sfunderbots/Electrical/BasePlate/README.MD

# Baseplate Board Documentation

This board is a power distribution and CANBUS distribution board, including the breakbeam connection to easily connect all motor drivers while disconnecting the top half and bottom half of the robot with just a few connections. This includes Power, CAN, and breakbeam cables.

## License
This project is licensed under the MIT License - see the [LICENSE](LICENSE) file for details.
