sfunderbots/Electrical/FacePlate/README.md

# Faceplate Board V2 Documentation

## Overview
---

The Faceplate[^1], one of five of our robot's on board custom PCBs (not including the Raspberry Pi), is a connector and peripheral board between the Raspberry Pi and the rest of the robot system. As this documentation pertains to the Robocup Small Size League Autonomous Soccer, this documentation will be very specific in its use case. The new version of the faceplate incorporates connectors for mouse sensors (localization improvement) and an offboard IMU (placed closer to the center of the robot with less vibration). All five boards contained on our robot (six including the Raspberry Pi), for context, are listed as follows:
1. Raspberry Pi 4 - Main Robot Computer and link between the active running computer running our team's software
2. Faceplate[^1] - Connector between Raspberry Pi and Midplate for CANBUS communication, peripherals, and LCD screen eyes
3. Midplate - Battery input and power distribution (doubles as a mechanical chassis)
4. Chicker[^2] - High Voltage Flyback Capacitor Charger and Solenoid Driver
5. Simovr[^3] - A BLDC Motor Driver designed based on the Tinymovr platform in a smaller footprint
6. Baseplate - Power distribution and CANBUS distribution for the Simovr's, and breakbeam circuits to detect the ball

[^1]: Aptly named due to our robot's circular LCD displays
[^2]: Named after a combination of the flexibility of both kicking or chipping circuits
[^3]: Aptly named after its creator, Simon, and its reference design, the Tinymovr

The Faceplate can be seen on the front of our robot, with the eyes visible and the board covered by a 3D printed piece below:
<p align="center">
  
</p>

This guide will serve as a way of a tutorial to design this or a similar board in your own projects, for which we recommend to use JLCPCB as a PCB manufacturer - wew users can register through the link below and receive up to $123 in coupons: [New User](https://jlcpcb.com/?from=Newv).1

## Schematics
---
  
For any of the following schematics, it is useful to group components into a schematic library file inside the EDA tool you are using - in this case, KiCad. Saving custom schematics ensures that when you update a board design you carry over any modifications like manufacturer part numbers, JLC part numbers (LCSC), price, etc. The following serves as an example for what information is useful to keep in the schematic part.

<p align="center">

</p>

> [!TIP]
> If you select "edit symbol library", you will see that it opens up the library tab in KiCad, which has all of our parts listed. The same information for the LDO as above is here as well.
> <p align="center">
> 
> </p>

> [!IMPORTANT]
> You will need to add your library path to the .KICAD_SYM schematic library file, which stores all of your components. While separating the components into groups hasnt been done yet on our end due to time constraints, we recommend grouping these components by type in separate .KICAD_SYM files to increase productivity.
> <p align="center">
> 
> </p>

Additionally, for each symbol in your library, an associated footprint needs to be added to each symbol used in the schematics, which will be covered in the layout section.

### Power
From the midplate, the Faceplate receives a regulated 5V supply for the Raspberry Pi at 3A, including the CANBUS which is wired all throughout our robot for between-board communication. Specifically, this uses a JST XH connector, which is easily sourced among hobbyists. Then, the board also steps this down to 3.3V for the onboard logic circuits needed such as peripherals and LCD screens. Bypass and decoupling capacitors are needed on the Low Voltage Regulator (LDO) to help maintain power stability, and is chosen over a DC/DC converter due to low current requirements.

<div style="display: flex; gap: 10px;">
  5V_CAN
  ldo
</div>

> [!NOTE]
> The part chosen as shown (SOT-223 package) can handle up to 1A of current, which was significantly over specification for our needs.

> [!TIP]
> Always remember to double check the current requirements and heat generation of your system, especially for power conversion!

### Connection to Raspberry Pi
Since the Raspberry Pi 4 has a 40x2 standard dupont style 2.54mm pitch connector, it is easiest to attach a board to board connector of the same type for this PCB. To line it up with the Raspberry Pi, it was easily accomplished by measuring the placement of the 40 pin header in a CAD program (in our case, Onshape) and comparing it to the PCB.

<p align="center">
40pin
</p>

> [!IMPORTANT]
> Special consideration must be taken for ensuring no physical interferences between parts on the bottom layer and the Raspberry Pi, and the top layer to the LCD screens.

### LCD Displays (eyes)
Our LCD displays are a circular GC9A LCD display for which the board is then covered by custom-made 3D printed material for protection surrounding the eyes. Each display (and corresponding breakout board) attaches to a standard 7x1 Dupont style 2.54mm pitch connector, and includes decoupling power capacitors for the 3.3V logic rail to maintain chip operation during normal operating transients. The parts are organized into hierarchical sheets for better organization and viewing of schematics.

<p align="center">


displays
</p>

### CANBUS
In order to communicate on the CANBUS, one needs to convert the standard SPI interface on the Raspberry Pi to a CAN interface, using a CAN controller (MCP2515T), and a CAN transceiver (SN65HVD233). The CAN controller operates on an 8MHz clock and communicates with a CAN transceiver to send and receive commands over the CANBUS interface. As with the displays, the CAN interface is grouped into a hierarchical sheet to simplify organization.

<p align="center">
can-top
  
can
</p>

### Mouse Sensors
Two 8-pin JST GH series connectors link the Raspberry Pi with two identical custom PCBs using a Pixart Imaging PMW3360DM-T2QU navigation sensor, which will be placed at the base of the robot on either side. This will provide significant improvement to our localization and control of the robot, incorporating precice movement of sensors near the surface of the playing field. 
<p align="center">
  
</p>

The board files of the mouse sensor can be found on our github page under [PWM3360_PCB_JST](https://github.com/sfunderbots/Electrical/tree/main/pmw3360-pcb-main/pmw3360_pcb_jst), which was modified from the github user siderakb to add a JST connector.

### IMU
For this revision of the faceplate, we have removed the direct connection of the IMU on the faceplate in place of an external connector to be wired to an IMU, in our case chosen as a breakout board from Adafruit: [4438](https://www.adafruit.com/product/4438). This will provide accurate 6-DoF for the robot to improve robot control speed. This is connected using a 4 pin JST PH connector (Adafruit calls it the STEMMA QT QWIIC) which provides both power and data lines.
<p align="center">
  imu
</p>

## Layout
---

The layout of this board and boards in general can be described by the following seven steps:
1. Footprint Libraries (for schematic)
2. Board Setup (Layers and Shape)
3. Part Placment
4. DRC Rules (including differential pairs)
5. Power routing (including zones / polygons)
6. Signal routing (best practices)
7. Custom Rule Areas (e.g. clearance / keepouts) 

The following image shows the overall layout of the board, where red refers to the top layer, blue refers to the bottom layer, green refers to the inner 1 / power layer, and orange refers to the inner 2 / ground layer. These planes on the board make up the 4 layers for the most common PCB to be fabricated, with power layers included for better power distribution, and signals routed generally on the top and bottom layers, if possible.

<p align="center">

</p>

Below reference most of the important shortcuts on the top bar used in KiCad: On the far left shows the board setup, then on the right past the lock and unlock icons are the footprint library editor, footprint library browser, 3D viewer, import changes from schematic, and DRC rules. 

<p align="center">
  
</p>

### Footprint Libraries
Setting up the footprints for each component can be accomplished manually or by downloading a footprint from an EDA library online. One should always consult the datasheet to confirm the validity of the suggested layout. As an example, the 3.3V LDO mentioned in the symbol library section is shown below. One should always verify the validity of a footprint by downloading the 3D model of the part so that the pins will have sufficient solder area and are easy enough to rework with a soldering iron. 

<p align="center">
  
</p>

> [!NOTE]
> One can access pre-built footprint files for your EDA tool of choice from libraries such as [snapeda.com](https://www.snapeda.com/home/) or [ultralibrarian.com](https://www.ultralibrarian.com/) for example. Many more exist, but these are the most frequently used. Always remember to verify these footprints as they may not match the datasheet.

> [!IMPORTANT]
> It is especially important to pay attention to drill sizes on through hole parts, as even half a millimeter of difference from the part size may be enough to cause interference during fabrication. For this reason we always recommend to check the "confirm production files" and "confirm part placement", so that the JLCPCB engineers can review your board and catch any issues before they are manufactured.

Lastly, with the same process as the symbol libraries, you need to ensure the path to the footprint library exists in the global or project path directories, so that KiCad knows where to look for this board when you place parts.

### Board Setup
Clicking the gear icon in the top left of the screen on the PCB editor in KiCad, you can access the Board Setup menu. In this menu you can select the number of layers on your board you intend to use, using the "Physical Stackup" submenu, and can define the type of layer used to help KiCad understand how you intend to use this board by using the "Board Editor Layers" submenu. 

> [!NOTE]
> This menu can be confusing, but most of this information can be ignored as when you upload your design to JLCPCB the selection menu for PCB type and layer stackup types is all done on their website. Here, the most important thing to remember is simply to select the number of layers used - usually 2, 4 or 6 depending on complexity of the signal routing.
> <p align="center">
> 
></p>

The shape of the PCB can be defined by creating a bounding box (or whatever closed shape you prefer) with the Edge Cuts Layer. First clicking on the edge cuts layer on the side bar shown below you can define a PCB shape using lines or arcs to create the shape of the board. As long as it is a closed shape, this will work and you can check the 3D view to verify it cut properly. The following shows an example when your board shape is malformed versus closed. When the board shape is closed, the shape will be filled in with a subtle grey tone, and the 3D model will be formed.

<div style="display: flex; gap: 10px;">
  
  
</div>

> [!TIP]
> As one can see, it is not always obvious when a board shape is malformed as seen by the above example, where two lines were clearly removed but the overall shape looks the same. As a general rule, the board shape will always fit to the largest area KiCad sees as possible on the Edge Cuts layer, hence how below the shape does not follow any of the drawn lines below.
> 

### Part Placement
When placing parts on the PCB one should think ahead where the power routing will go. In this case, the I would anticipate that the 5V net for the Raspberry Pi would go near the edge of the board and wrap around to the rightmost pins on the 40 pin header, with the 3.3V being the main power plane on the board. Secondly, one should leave enough space around parts to make it easier to solder if rework must be completed, or if you are soldering the boards yourselves. For the faceplate below, you can see that it was ideal to put our power and CAN connector (JST XH 4 pin) on the same side as our power switch and power connector on the midplate. The rest of the components will be arranged in similar fashion leaving enough space for connecting vias for power connection.

<p align="center">

</p>

To help your process in laying out the PCB parts, you can see the "ratnest" of white lines across the board, which show you where the pads will be connected according to the schematic. 

> [!IMPORTANT]
> It is also super important at this time to pay attention to any missing ratnest wires or pads that do not have any connection, which may be a mistake on the schematic. For this reason I always label my net names on the schematic so that when laying out the PCB it will be obvious if something is missing.

> [!TIP]
> It is always useful to include mounting holes on the PCB so that you can attach the board to an enclosure, which may not be necessary for prototyping but it will be necessary in the end - therefore getting it out of the way early will avoid headaches in the future!
>
> Lastly, one should avoid placing components too close to the edge of the board, especially if the board is panelized, as any stresses to the PCB may cause early failure in certain components, such as PCB mount capacitors (not radial caps). A guide about part placement for proper power and signal delivery can be seen on the JLCPCB website here: [JLCPCB design guidelines for placement and routing](https://jlcpcb.com/blog/pcb-design-guidelines-placement-and-routing).

### DRC Rules

On any board project, DRC rules should be set up so that you are generally following manufacturer specifications. You can view the capabilities of JLCPCB on their website [here](https://jlcpcb.com/capabilities/pcb-capabilities), and if I can find it there should be a downloadable file for DRC rules. In the case that this doesn't exist any more, these settings can be set up as follows:

The default constraints should be filled out first, which shows important rules which will dictate how the PCB is fabricated later. Important values to consider here are the minimum widths for trace widths and clearance/spacing (for which I tend to at least double the minimum specified by JLCPCB, as this only specifies an absolute minimum, but not a practical number to avoid noise and EMI), copper to hole, and copper to edge clearances.

<p align="center">
  
</p>

Additionally, you can include DRC rules by setting up Net Classes in the schematic with colors, and in the PCB you can select these net classes to choose specific clearance and widths based on the expected current on those traces. The following shows the example of the "Power" Net Class which I have colored orange for example.

<p align="center">


</p>

For these specific nets, I have selected a slightly larger default via size (0.7/0.35mm) with larger overall trace width minimum. Generally speaking with larger trace widths the larger the clearance should be as well. 

> [!TIP]
> It is advisable to consult a PCB calculator for non-logic level trace and via sizing, such as [Saturn PCB Toolkit](https://saturnpcb.com/saturn-pcb-toolkit/).
>
> Secondly, always check your DRC rules BEFORE you start routing component tracks. This way, you will ensure there are no part placement conflicts or issues with footprints you will have to solve later and re-route components. To ensure components are not conflicting in 3D space, the pink courtyards must not overlap.

> [!WARNING]
> It is important not to look over any DRC warnings and especially errors, I would only recommend setting a DRC rule to "ignore" if it is absolutely necessary (set in "Violation Severity" under board setup design rules), as this can cause issues to be forgotten about especially when a lot of errors that seem meaningless show up can mask a significant board error if those are ignored.
 
### Power Routing

Moving on to power routing, we can set up zones (or polygons depending on what EDA tool you use) of copper that will fill in our board layers and make up our copper planes. For a 4 layer board such as this one, I generally recommend filling in ground on 3 of the four layers and power on one of the two internal power planes. This enables easy routing for power delivery to most components, assuming one (or more depending on current draw) correctly sized vias are used. 

<p align="center">

</p>

On this image above, you can see the zone created, where on the power layer we have a thick trace going from the 5V connector to the Raspberry Pi 40 pin header. 

> [!IMPORTANT]
> It should be noted that at 3A and below the return current here does not matter as much, but on a design that pulls more than 10A I would recommend matching the return ground plane such that the return current goes directly underneath the power trace.

Additionally, each component includes power vias to connect to the 3.3V and GND planes of the board, which are sized slightly bigger for extra margin.

### Signal Routing

With the power traces routed on the board, signals are the next thing I would consider. 

> [!TIP]
> Remember to keep the inner layers as power distribution as much as possible avoiding signals on those layers, as it could increase noise on the signals.

For recommended trace widths, I tend to use anywhere from 8-10mil traces for signals, depending on space. It is advisable to not decrease the size too much, as it may become hard for your PCB manufacturer (such as JLCPCB in our case) to manufacture. On the other end, having a trace width too large may impact impedance of the line, if you are designing a higher speed communication board. 

> [!TIP]
> For most signal traces, the trace width isn't super important at this range, as long as its big enough for the load expected. JLCPCB has a handy guide in determining the trace width of a PCB trace.

With most signal traces, it is recommended to try and maintain a standardized pattern of top and bottom layers for either horizontal or vertical traces, to permit densely populated routing without causing too much hassle. This can be seen with the PCB design in the full layout shown earlier.

### Custom Rule Areas

In some cases, you may have ICs on your board that have very fine pitch (such as the TSSOP-20 Can Controller), and your standard DRC rule clearances may not work here if your overall clearance is larger. In this case, you can temporarily shrink the clearance required around this chip by adding a custom rule area with all the toggles turned off (so that it does not exclude copper, pads, footprints, etc) for which we will add a custom rule later. The fine pitch chip is shown below, with a zone created around it and all options deselected.

<p align="center">

</p>

With this we can now go into the DRC rule editor (much easier than custom rules in the board setup tab in older KiCad versions) and add a custom fine pitch spacing rule. This can be found from Tools -> DRC rule editor.

<p align="center">

</p>

Here, object A refers to the currently-being-routed track, via, or other item, where the new clearance rule now only gets applied inside this area. There are multiple ways to accomplish the same feature with custom rulests, and there are a lot of other use cases that you can explore - this is only an example. 

> [!TIP]
> KiCad has a previous version guide (pre-V10) about custom rules and their use cases, so please feel free to use [this guide](https://forum.kicad.info/t/custom-design-rules-examples/43987/2) to your liking. There are also a lot of github links that people have made including JLCPCB specific rulesets you can use if you search these up.

## Implementation
---

To fabricate the boards, we used JLCPCB, which has been extremely reliable for countless hobby projects over the last five years. Here’s JLC's new user [6-layer PCB coupon](https://jlcpcb.com/6-layer-pcb?from=social) which saves you 30$ on your project so you can start a project with relatively low cost. 

Apart from being a reliable PCB manufacturer, JLCPCB has also been very cost effective - on their part library website, you can find alternate components from their partner LCSC to make board projects feasible at lower cost with similar or the same specifications. 

However, before you fabricate the boards, you need to run a DRC check, under Inspect -> Design Rules Checker. This ensures that any clearance violations (short-circuits), unconnected nets (any traces you forgot to route), or trace widths that are out of the Net Class spec.

> [!IMPORTANT]
> For this very reason, it is highly advisable, while not strictly necessary, to set up different Net Classes and assign them in the schematic by right clicking the wire. With a larger trace width for a high current trace set, this will ensure that when you go to manufacture your boards that trace will not burn up from too little copper area to conduct the required current, with the DRC check ensuring you fix the mistake before this stage.

For this board specifically, Net Class rules didn't need to be set up as it is a relatively simple board and my knowledge is sufficient to accomplish it without any major hiccups, knowing the rough sizing for traces we need. At a very minimum, it is recommended to use the toolkit recommended earlier ([Saturn PCB Toolkit](https://saturnpcb.com/saturn-pcb-toolkit/)) to verify that your trace width will sufficiently carry the current without heating up too much.

Clicking the 3D model view in KiCad (the icon that looks like a capacitor) you can view the 3D model of the board - the Faceplate looks as follows:

<p align="center">
  
  
</p>

And with that, the board is done, and you will need to export your design files to gerbers and drill files for the manufacturer. You can do this manually by using the export options, or, you can use the JLCPCB Fabrication tookit as an installed library in KiCad. With the toolkit, all it requires is a simple click where the files will be saved in a "production" folder in your repository.

<p align="center">
<img width="607" height="493" alt="Screenshot 2026-06-04 081611" src="https://github.com/user-attachments/assets/2535ca5f-1fe5-418a-b123-495e8af0abb8" width: 30%;"/>
</p>

This process is now complete and you should have your board in a couple weeks depending on shipping and manufacturing timelines!

## License
This project is licensed under the open-sourced MIT License - see the [LICENSE](LICENSE) file for details.
