sfunderbots/Electrical/thebots_libraries/README.MD

# KiCad Project Libraries

For most of our boards, a project library is used to store components in symbol and footprint editors. This improves the process at which a board is updated in the future, where all changes are saved on the library rather than locally. 

This repository contains [3D-models](3dmodels) of the components (some use the kicad repository links), [symbol libraries](symlib), and [footprint libraries](bots.pretty)

## License
This project is licensed under the MIT License - see the [LICENSE](LICENSE) file for details.
