sfunderbots/Electrical/Chicker/power board design rules.txt

(version 6.0)
#(rule bat_clearance_width
#	(condition "A.NetClass == 'BAT'")
#	(constraint clearance (min 25mil))
(rule HV_clearance_width
	(condition "A.NetClass == 'HV'")
	(constraint clearance (min 60mil))
	(constraint track_width (min 50mil)))
(rule power_clearance_width
	(condition "A.NetClass == 'Power'")
	(constraint clearance (min 16mil))
	(constraint track_width (min 10mil)))
(rule signal_clearance_width
	(condition "A.NetClass == 'SIGNALS'")
	(constraint track_width (min 6mil))
	(constraint clearance (min 9mil)))
(rule HV_CONN
	(condition "A.enclosedByArea('HV_CONN') && A.NetClass == 'HV'")
	(constraint clearance (min 50mil)))
(rule HV_RQ2D
	(condition "A.enclosedByArea('HV_RQ2D')")
	(constraint clearance (min 20mil)))
(rule HV_SNUB1
	(condition "A.enclosedByArea('HV_SNUB1')")
	(constraint clearance (min 31mil))
	(constraint track_width (min 20mil)))
(rule HV_SNUB2
	(condition "A.enclosedByArea('HV_SNUB2')")
	(constraint clearance (min 31mil))
	(constraint track_width (min 20mil)))
(rule SPI0_clearance_width
	(condition "A.enclosedByArea('SPI')")
	(constraint clearance (min "9.7mil"))
	(constraint track_width (min "6mil")))
(rule RPI2040_clearance_width
	(condition "A.enclosedByArea('RPI')")
	(constraint clearance (min 8mil))
	(constraint track_width (min 6mil)))
(rule HV_PMS
	(condition "A.enclosedByArea('HV_PMS')")
	(constraint clearance (min 7.8mil)))
(rule LT3750_clearance_width
	(condition "A.enclosedByArea('LT3750') && A.Type != 'Via'")
	(constraint clearance (min 7.7mil))
	(constraint track_width (min 7mil)))
(rule LM2598_clearance_width
	(condition "A.enclosedByArea('LM2598')")
	(constraint clearance (min 16mil))
	(constraint track_width (min 6mil)))
#(rule samenet
#	(condition "A.Type == 'Zone' && A.NetName == B.NetName && B.Type != 'Via'")
#	(constraint physical_clearance (min 10mil)))
(rule HV_res
	(condition "A.enclosedByArea('HV_RES')")
	(constraint clearance (min 6mil))
	(constraint track_width (min 6mil)))
(rule HV_res_AD
	(condition "A.enclosedByArea('HV_AD')")
	(constraint clearance (min 30mil))
	(constraint track_width (min 10mil)))
# Specify an optimal gap for a particular diff-pair
(rule "dp gap"
    (condition "A.NetClass == 'DIFF_USB'")
	(constraint diff_pair_uncoupled (max 360mil))
	(constraint diff_pair_gap (max 200mil) (opt 8mil) (min 7mil)))
(rule USB_clearance_width
	(condition "A.enclosedByArea('USB')")
	(constraint clearance (min "7.6mil"))
	(constraint track_width (min "6mil")))
(rule board_edge_clearance
    (constraint edge_clearance (min 30mil)))
(rule board_edge_clearance_caps_HV
    (constraint edge_clearance (min 0.2mm))
	(condition "A.Type == 'Zone' && A.Name =='CAPS_HV'"))
(rule board_edge_clearance_caps_GND
    (constraint edge_clearance (min 0.2mm))
	(condition "A.Type == 'Zone' && A.Name =='CAPS_GND'"))
(rule board_edge_clearance_GND
    (constraint edge_clearance (min 14mil))
	(condition "A.intersectsArea('GND_POUR')"))
(rule vcc_clearance_3750
	(constraint clearance (min 7.6mil))
	(condition "A.Type == 'Zone' && A.Name =='LT375012V_POUR'"))
(rule dp_gap_CAN
    (condition "A.NetClass == 'CAN_DIFF'")
	(constraint diff_pair_uncoupled (max 810mil))
	(constraint diff_pair_gap (max 800mil) (opt 11mil) (min 10mil))
	(constraint track_width (min 7mil) (opt 7mil)))
#make sure of NPTH clearance, all layers
(rule NPTH_Clearance
(constraint hole_clearance (min 0.3mm))
(condition "A.Pad_Type=='NPTH, mechanical'"))
