sfunderbots/Electrical/Chicker/firmware/docs/MODE-STATE-MACHINE-REVIEW.md

# Mode control state machine review: Henry's chart, element by element

Source chart: `flowcharts/chicker-mode-control-state-machine.drawio`. Same rules as the charge review: column 1 is
the chart as drawn, the change (if any) goes in "Agreed behaviour", and anything not on the chart needs Henry's OK.
Henry is updating his local copy of the chart as the review goes; the code is checked against both before it is written.
The chart sometimes writes a value as shorthand (e.g. "500ms" for `KICK_MIN_INTERVAL_MS`); the review and the code
always use the config constant names.
Signals shared with the charge machine: see `COUPLED-STATE-MACHINE-REVIEW.md`.

## Mode control state machine

| # | Chart element | Agreed behaviour | Notes |
|---|---|---|---|
| 1 | ANY STATE — `chg_ok == 0` → Wait for Bat | **As drawn.** Applies from every state except its own (Wait for Bat) and Locked (end state). Whatever is in progress is aborted immediately, **including a kick or damp pulse**; `chg_stop_mode_ctrl = 1`. | Aborting may not be possible: without the battery the board may already be unpowered. Then the RP2040 pins fall to their pull-downs, which is already the safe state (CHARGE off, `~DISCHARGE` low = dump, KICK low). No extra dump request from Wait for Bat: with no battery nothing can charge anyway (question withdrawn). |
| 2 | Wait for Bat — `chg_ok == 1` → Start BKBM interrupt | **As drawn.** The break-beam interrupt is attached the first time and left attached (not detached when going back to Wait for Bat). | Without a battery the break-beam is unpowered and won't trip. Even if its pin floats (e.g. USB-only on the bench), the interrupt only fires a kick when one is **armed**, and Wait for Bat has aborted everything. |
| 3 | Start BKBM interrupt — `heartbeat == OK` → Set Idle Mode (chg inhibited, discharging) | **As drawn.** Waits in Start BKBM interrupt until the heartbeat is OK, then Set Idle Mode. While waiting: `chg_stop_mode_ctrl = 1`. **`heartbeat == OK`** = a valid frame from the Pi within the last **5 s** (`HEARTBEAT_TIMEOUT_MS = 5000`, config, can change later). At startup, the first valid heartbeat frame is enough. Any valid frame from the Pi (heartbeat, MODE, KICK, DAMP) refreshes it. | Needs robot-side heartbeat (R-1). Details: note HB-1. |
| 4 | ANY STATE — `heartbeat == stops` → Disable Charging → Start BKBM interrupt | **Changed: heartbeat loss also de-arms the kick and stops the PWM** (the chart's "de-arm kick / stop PWM" block; on the chart only an incoming message did this). Otherwise as drawn. Applies from every state except Locked, Wait for Bat, and its own targets. The battery rule (element 1) has priority. Disable Charging sets `chg_stop_mode_ctrl = 1` (Inhibited: stop charging and dump). | **Battery priority:** with no battery and no heartbeat the board stays in Wait for Bat (charging is already off there) instead of bouncing between Wait for Bat and Start BKBM interrupt. See note HB-2. |
| 5 | ANY STATE — `chg_disable_chip_level == 1` → Locked. Message pi4 to substitute | **As drawn.** Applies from every state except Locked; Locked is the end state (left only by reboot) and wins over the battery and heartbeat rules. **Locked tells the Pi and stops everything on the kicker side**: one FAULT event with the reason (UVLO / thermal shutdown, Too slow to charge, Overvoltage), plus the fault flag in every STATUS frame; kick de-armed, any pulse or damping PWM stopped at once (Henry, after the state × event matrix found a damp still running in Locked). It sets no charge flags (no `chg_stop_mode_ctrl`). | Purely reactive: `chg_disable_chip_level` is the charge machine's output (authorship), and the charge machine has already stopped charging and dumped the caps in Disabled. |
| 6 | Set Idle Mode (chg inhibited, discharging) — `chg_disable_chip_level == 1` → Locked / `chg_disable_chip_level == 0` → Wait for Message | **Changed: the `chg_disable_chip_level == 1` → Locked arrow is removed** (redundant: the ANY STATE rule, element 5, already covers it). The `== 0` check on the Wait for Message arrow goes with it (always true once element 5 has priority). **Set Idle Mode = idle mode: set `chg_stop_mode_ctrl = 1` and stop the PWM**, then straight to Wait for Message. (Stop PWM added: the "incoming message" box no longer stops it, note DMP-3.) | `chg_stop_mode_ctrl = 1` sends the charge machine to Inhibited (stop charging and dump), which is the "chg inhibited, discharging". It stays 1 in Wait for Message until a command reaches an Enable Charging step. Reached from Start BKBM interrupt (heartbeat OK) and from Command Received `mode == MODE_IDLE`. |
| 7 | Wait for Message — incoming message → Parse Message; Parse Message — unknown message → Unknown command → Wait for Message / good message → Command Received; ANY STATE — incoming message → de-arm kick / stop PWM → Parse Message | **Changed** (diagram below the table): <br>• Parse Message + Unknown command: a side box for every CAN frame, not states <br>• Heartbeat frame: refresh timer + STATUS reply only <br>• Other boards' frames: ignored <br>• Bad command → Unknown command: count / log, **stay in the current state** <br>• Good command = known ID, right length, values in range <br>• ANY STATE (not Wait for Bat, Start BKBM, Locked) — good command → Command Received → de-arm kick, **except the two renews**: DAMP while the PWM runs (element 17) and AUTOKICK while a kick is armed (element 23) <br>• No stop PWM here: Set Idle Mode, MODE_CHG and the damp's own exits stop it <br>• Good commands: all processed, in order <br>• A repeat is a new command, except the two renews; kicks can be spammed <br>• Armed kick with no ball expires after 2 s (element 21; not during a damp) <br>• Kick pulses ≥ `KICK_MIN_INTERVAL_MS` apart; arming waits for the spacing <br>• Kick during a damp → armed inside the damp loop; PWM keeps going until the break-beam trips (elements 18–20; caution, note DMP-5) <br>• DAMP during a damp = renew (element 17) <br>• Pulse already firing: not cut | • Heartbeats at 5 Hz would otherwise de-arm every 200 ms. <br>• Spacing: two pulses close together combine into one excessively large kick. `KICK_MIN_INTERVAL_MS = 500` is a starting guess (likely larger), tuned on the field. Too short only makes the ball too fast (foul), not board damage. <br>• Kick during a damp is the expected use (hold the ball, then kick before the timeout). The PWM is stopped **at the break-beam trip**, not when the kick is requested. Key change from the chart. <br>• Good = known command CAN ID, correct data length, known mode, kick PW 100–5000 µs, damp parameters within limits. <br>• A new kick stops the armed kick (de-arm) and tries again: Henry's original "de-arm kick" step. <br>• DAMP renew: timeout restarts from the latest DAMP, no new initial kick, parameters kept; capped by `DAMP_MAX_TOTAL_MS` (6 s backstop). AUTOKICK renew: the 2 s arm timer restarts, newest PW, nothing de-armed. Neither renew touches charging. IDLE and CHG stop the damp (element 6, 8); DAMP renews; a kick keeps it (MSG-3). <br>• A kick pulse is ≤ 5 ms on the PIO. <br>• Locked still answers heartbeats with STATUS (fault flag). <br>• As drawn, Unknown command → Wait for Message would pull the board out of wait for kick or the damp loop on a corrupt frame; now it stays put. <br>Details: MSG-1, MSG-2. Team: T-1 to T-3. |
| 8 | Command Received — `mode == MODE_IDLE` → Set Idle Mode; `mode == MODE_CHG` → de-arm kick / stop PWM → Enable Charging → Wait for Message | **As drawn.** Command Received stores the commanded mode in `mode` (read by the break-beam interrupt), then branches. MODE_IDLE → Set Idle Mode (element 6). MODE_CHG → de-arm kick / stop PWM → Enable Charging (`chg_stop_mode_ctrl = 0`) → Wait for Message: the charge machine charges and tops off; nothing is armed. | The de-arm part overlaps with element 7 (every good message de-arms). The stop PWM part is **not** redundant: element 7 no longer stops the PWM on every message, so this is where CHG stops a running damp. AUTOKICK and DAMP are their own elements. |
| 9 | Command Received — `mode == MODE_AUTOKICK` → Enable Charging → Arm Kick | **Changed: the arrow Enable Charging → Arm Kick gets `time since last kick >= KICK_MIN_INTERVAL_MS`** (moved here from the kick GUARD, note KCK-2). Enable Charging sets `chg_stop_mode_ctrl = 0` and `chg_hold_mode_ctrl = 0` (every Enable Charging box clears both). | From Idle: the dump stops and the charge machine starts a cycle (New Charge holds CHARGE low 50 ms first, so the dump is off before CHARGE rises). Already charging / full: no change. |
| 10 | Arm Kick — `HV >= 180V && kick assigned` → Disable Charging | **Changed: `HV >= 100V && kick assigned`** (`KICK_MIN_HV = 100`, config). Arm Kick sets `armed = 1` and stores the kick PW; `kick assigned` comes from the break-beam mini machine. | See note KCK-1. |
| 11 | Disable Charging — `done == 0` → Kick with PW Assigned | **Changed name only: "Disable Charging" → "Hold Charge"** (`chg_hold_mode_ctrl = 1`: stop charging, keep the caps charged). The kick is **queued until `done == 0`** (the LT3750 has stopped), as drawn. No timeout on the wait. | A 20 ms cap on the wait was suggested and not adopted (Henry: DONE will go low once CHARGE is low). A DONE line stuck high would already have tripped "Too slow to charge" at the 4500 ms check during the charge cycle before the kick (→ Disabled → Locked, Pi told). |
| 12 | Kick with PW Assigned → GUARD (PW >= 100 us, PW <= 5000 us) → de-arm kick / stop PWM → Enable Charging → Wait for Message | **Changed (Henry's updated chart): the GUARD moves before the kick.** Hold Charge → GUARD → Kick with PW Assigned. GUARD rows: `done == 0`, PW >= 100 us, PW <= 5000 us. The board waits in Hold Charge until all pass. The kick spacing is **not** in this GUARD (the kick must fire while the ball is in the beam): see note KCK-2. After the kick, as drawn: de-arm kick / stop PWM → Enable Charging (clears both flags, recharges) → Wait for Message. | Before, the PW was checked after the kick had fired. "Last kick" includes the damp's Initial Kick. The PW rows repeat element 7's range check as a last check before the PIO fires. **One kick per AUTOKICK command** (Henry): after the kick the board leaves the mode and waits for the next command; it does not stay armed. |
| 13 | Breakbeam Mini State Machine: Interrupt Received — `Breakbeam == 1` → LED on — `armed == 1 && mode == MODE_AUTOKICK` → Assign Kick → Interrupt Idle; LED on — `armed == 0` → LED on; Interrupt Received — `Breakbeam == 0` → LED off | **As drawn, with:** <br>• Written as `Breakbeam == ON` (ball present) / `OFF` in the chart and code; the pin level for ON is a config constant, confirmed on the bench <br>• Beam must be steady for `BEAM_DEBOUNCE_MS` (5 ms, tune on the bench) before it counts <br>• LED on is a real state the main loop keeps checking (the `armed == 0` loop): a ball already in the beam when the kick is armed still gets kicked <br>• Condition widened for a kick during a damp: `armed == 1 && (mode == MODE_AUTOKICK \|\| mode == MODE_DAMP)` (element 18). The `MODE_DAMP` row is needed: a renew sets `mode` back to `MODE_DAMP` with the kick still armed | • Polarity: a break-beam receiver often reads **low** when blocked, so ON ≠ 1 necessarily. Bench check. <br>• Implementation (Henry: probably OK): the interrupt fires on both edges and only records the level and time; the main loop does the state changes (MicroPython interrupt handlers must stay tiny). debounce against flicker (`BEAM_DEBOUNCE_MS`, 5 ms). Break-beam level reported in STATUS. <br>• Ball leaving before the kick fires: note KCK-2. |
| 14 | Command Received — `mode == MODE_DAMP` → Enable Charging — `HV >= 180` → Disable Charging | **Changed:** <br>• "Disable Charging" → **"Hold Charge"** (`chg_hold_mode_ctrl = 1`) <br>• Arrow gets `time since last kick >= KICK_MIN_INTERVAL_MS` next to `HV >= 180` (`DAMP_START_V = 180`, kept) | • The Initial Kick is a kick: without the spacing, a damp right after a kick would combine the two pulses. Same fix as AUTOKICK (gate the start, not the fire, KCK-2). Easy to remove later. <br>• Stuck-low HV → never damps: accepted risk, stuck-readings open topic (charge review). |
| 15 | Disable Charging — `done == 0` → Initial Kick — wait for (y) time → Start Damping PWM | **As drawn** ("Disable Charging" is now "Hold Charge", element 14). Initial Kick waits for `done == 0` like element 11. **(y) = 4 ms** (Henry's updated chart; `DAMP_SETTLE_US = 4000`). Initial Kick PW = 800 µs (`DAMP_INITIAL_KICK_US`). Both are the RoboCup 2026 values. | • Values and their history: note DMP-2. Tuned by hand; no physical model yet. <br>• Initial Kick counts as the last kick for `KICK_MIN_INTERVAL_MS`. <br>• Initial Kick → PWM switch runs on the same PIO, the pin never changes function (the old PWM ↔ PIO glitch). |
| 16 | Start Damping PWM → Wait — time since last HV adjustment >= (x) → HV Adjustment → Set Duty → Wait; Wait — time since pwm start >= timeout → de-arm kick / stop PWM → Enable Charging → Wait for Message | **Changed:** <br>• Exit: `time since last DAMP >= timeout \|\| time since Initial Kick >= DAMP_MAX_TOTAL_MS` (renew + max hold) <br>• (x) = 25 ms (`DAMP_ADJUST_PERIOD_MS`) <br>• No HV floor exit <br>• Hold stays on through the loop <br>**Added:** elements 17, 18, 19, 20 | • HV Adjustment = RoboCup formula, rounding kept; validate on the bench (DMP-3). <br>• Details for 16–20: DMP-4. |
| 17 | **Added (Henry's updated chart):** Command Received — `mode == MODE_DAMP && PWM running` → Renew Damp start variable → Wait; `mode == MODE_DAMP && PWM not running` → Enable Charging (element 14) | **Agreed.** Renew: restart the timeout, no new Initial Kick, parameters kept, `mode = MODE_DAMP`. A queued kick stays armed (the one exception to "a good command de-arms", element 7). | New behaviour, not just a label. "PWM running" is a flag (on at Start Damping PWM, off at every Stop PWM). DMP-4. |
| 18 | **Added:** Command Received — `mode == MODE_AUTOKICK && PWM running` → Arm Kick → set mode back to MODE_DAMP → Wait; `mode == MODE_AUTOKICK && PWM not running` → Enable Charging (element 9) | **Agreed.** Kick during a damp: `armed = 1`, no Enable Charging, hold stays on, back to the damp loop. The kick waits for the break-beam (but see note DMP-5). | Same pattern as renew, no new state. Break-beam fires on `mode == MODE_DAMP` too (element 13). DMP-4, MSG-3. |
| 19 | **Added:** Wait — `HV >= 100V && kick assigned` → GUARD → Kick with PW Assigned → de-arm kick / stop PWM → Enable Charging | **Agreed.** The PWM stops in the same PIO step as the pulse, so it holds until the kick. | Ball already in the beam → kicked as soon as armed. No settle delay: the ball pushes the plunger back (Henry). DMP-4. |
| 20 | **Added:** Wait — `HV < 100V && kick assigned` → Stop PWM → wait 50ms → Enable Charging → `HV >= 100V && kick assigned` → Charge Hold → `done == 0` → GUARD → Kick | **Agreed.** Bank too low to kick: the damp ends, the bank recharges, then the kick fires. | PWM off before charging: no charging while damping, nothing left running. 50 ms lets the solenoid current die down. `kick assigned` stays latched (KCK-2). DMP-4. |
| 21 | **Added (not yet on the chart):** Arm Kick — `time since AUTOKICK >= 2s && no ball` → de-arm kick → Wait for Message | **Agreed (Henry): "definitely include the 2s timeout, it's dangerous otherwise."** An armed kick that sees no ball within `KICK_ARM_TIMEOUT_MS` (2 s) of its AUTOKICK command is de-armed; the Pi gets an ARM_EXPIRED event; charging stays on (mode CHG). Once the ball has been seen the kick goes ahead (no expiry while waiting for a recharge). A new AUTOKICK restarts the 2 s. | Same as RoboCup 2026 (`AUTOKICK_EXPIRE_THRESH_MS = 2000`). Without it, a kick the AI no longer wants would still fire on a ball arriving much later. The KICK frame's `arm_ms` field stays ignored (fixed 2 s). |
| 22 | ~~Arm timeout during a damp~~ | **Rejected (Henry):** no 2 s timeout for a kick armed during a damp. The kick is expected there, the damp only lasts its timeout (3 s, or longer if renewed), and the kick is de-armed when the damp exits. | |
| 23 | **Added (Henry's updated chart):** Command Received — `mode == MODE_AUTOKICK && PWM not running && kick armed` → (Renew kick timer + new PW) → wait for kick; `... && kick not armed` → Enable Charging → ... (the full path) | **Agreed.** An AUTOKICK while a kick is already armed on the AUTOKICK path (wait for kick, or Charge Hold) renews it: the 2 s arm timeout restarts and the newest PW is used. No de-arm, no Enable Charging, charging untouched. | A Pi that repeats AUTOKICK keeps the kick armed as long as it keeps asking (T-5). "kick armed" excludes the low-bank recharge of a damp (Stop PWM), which still has to re-enable charging. Chart: the renew arrow needs a "Renew kick timer (+ new PW)" box; the 2 s timeout arrow should leave "wait for kick", not Arm Kick. Code state renamed `ArmKick` → `WaitForKick`. |

## Message handling (element 7): full description, for the chart later

Henry's chart has one box for this, "message handling according to #7". This section is what that box means,
written so it can be drawn later. The behaviour is agreed (element 7, MSG-1, MSG-2, elements 17, 18, 21, 23).

### Where it applies

Every CAN frame goes through the message handler, **whatever state the mode machine is in**. What the handler
may do depends on the state:

* **Wait for Bat, Start BKBM interrupt, Locked:** heartbeat frames are handled (timer refreshed, STATUS sent).
  Commands are **not acted on** and not saved for later (Locked: STATUS carries the fault flag).
* **Every other state** (Wait for Message, wait for kick, Charge Hold, the damp loop, ...): commands are acted on, as
  below. A good command interrupts whatever the machine was doing, except the two renews (lines 12 and 14).

### Step by step (each line is one box or arrow to draw)

```
 1. CAN frame received
 2. ├─ heartbeat frame      → refresh the heartbeat timer, send STATUS → back to the current state
 3. ├─ not for the chicker  → ignore → back to the current state
 4. ├─ bad command          → Unknown command (count it, log it; reject message if the team wants, T-2)
 5. │                         → back to the current state (nothing changes, nothing de-armed)
 6. └─ good command         → (Wait for Bat / Start BKBM / Locked: ignore → back to the current state)
 7.                         → Command Received (checked top to bottom, first match wins)
 8.  Command Received
 9.  ├─ MODE_IDLE                                 → de-arm kick / stop PWM → Set Idle Mode (chg_stop = 1) → Wait for Message
10.  ├─ MODE_CHG                                  → de-arm kick / stop PWM → Enable Charging → Wait for Message
11.  ├─ MODE_AUTOKICK && PWM running              → Arm Kick (new PW) → set mode back to MODE_DAMP → damp loop Wait   (el. 18)
12.  ├─ MODE_AUTOKICK && PWM not running && armed → RENEW: restart the 2 s arm timer, new PW → wait for kick          (el. 23)
13.  ├─ MODE_AUTOKICK && PWM not running && not armed
     │                                            → de-arm kick → Enable Charging → [last kick >= KICK_MIN_INTERVAL_MS]
     │                                              → Arm Kick (2 s arm timer starts) → wait for kick → ...              (el. 9-12, 21)
14.  ├─ MODE_DAMP && PWM running                  → RENEW: restart the damp timeout (kick stays armed) → damp loop Wait (el. 17)
15.  └─ MODE_DAMP && PWM not running              → de-arm kick → Enable Charging → [last kick >= KICK_MIN_INTERVAL_MS
                                                    && HV >= 180] → Charge Hold → ...                                (el. 14-16)
```

The de-arm is part of each branch, not done before Command Received, so the two RENEW branches (12, 14) can skip it.

### Definitions used above

| Term | Meaning |
|---|---|
| Heartbeat frame | The Pi's 5 Hz heartbeat. Never de-arms, never goes to Command Received. Any valid frame from the Pi refreshes the heartbeat timer. |
| Good command | Known command CAN ID, correct data length, every value in range (known mode, kick PW 100–5000 µs, damp parameters within limits). |
| Bad command | Anything for the chicker that isn't a good command. |
| PWM running | Flag: on at Start Damping PWM, off at every Stop PWM. Not the same as `mode == MODE_DAMP`. |
| armed (line 12) | A kick armed on the AUTOKICK path: in wait for kick, or in Charge Hold about to fire. Not the low-bank recharge of a damp (Stop PWM), which still has to re-enable charging, so an AUTOKICK there takes line 13. |
| 2 s arm timer | `KICK_ARM_TIMEOUT_MS`: no ball within 2 s of the last AUTOKICK → de-arm kick → Wait for Message (element 21). Not during a damp. |
| Order | Good commands are handled one at a time, in the order they arrived; none are dropped. |

### Who stops the PWM

Every way out of a damp stops the PWM: the damp loop's own exits (timeout / max hold, elements 16, 19, 20),
MODE_IDLE, MODE_CHG, heartbeat loss, battery loss and Locked. MODE_DAMP renews, MODE_AUTOKICK keeps it running until
the kick. Below the state machine, the kicker driver never runs the PWM longer than `DAMP_MAX_TOTAL_MS` (backstop for
code bugs, not a state).

## Notes

| # | Note |
|---|---|
| HB-1 | **Heartbeat details.** The Pi sends at 5 Hz, so the 5 s timeout means ~25 frames in a row must be missed before communication counts as lost. Dropped packets never trip it; only a real outage does. Loss detection is a single timestamp ("last valid frame from the Pi"), not a miss counter. **Early warning (diagnostics only, behaviour unchanged):** after ~1 s without a frame, set a "heartbeat late" flag in STATUS and the board log. **Sequence counter:** the board logs gaps and duplicates to measure packet loss but never acts on them. **During the 5 s before loss is declared** the board carries on as normal: an armed kick expires after 2 s without a ball (element 21) and a damp ends at its timeout. **After loss** (element 4) the board goes back through Start BKBM interrupt, which waits for a fresh heartbeat before Idle. |
| HB-2 | **Heartbeat loss (element 4).** *Dump:* dumping on heartbeat loss is the intended behaviour (Henry). *Armed kick:* de-armed (`armed = 0`), so the break-beam interrupt (still attached) can't fire a kick. The bank is dumping anyway (a full dump takes ~7 s, Henry's measurement), so a kick after loss would get weaker quickly. *Damp:* the PWM is stopped on loss, so it can't be left running after the board leaves the damp loop (where its timeout is checked). *Recovery:* Start BKBM interrupt waits for a heartbeat, then Set Idle Mode. |
| MSG-1 | **Message handling (element 7): what counts and why.** <br>• *Heartbeats don't count:* at 5 Hz they would de-arm the kick every 200 ms, so AUTOKICK could never stay armed. <br>• *De-arm on a good message:* Henry added it so an armed kick or a running PWM can't stay active while the board does something else, and so a spammed kick stops the active kick and tries again. Heartbeat loss (element 4) and battery loss (element 1) also de-arm. A corrupt frame just can't cancel an armed kick any more. <br>• *No software checksum:* the CAN hardware already checks a CRC on every frame. <br>• **Team check:** the chicker's CAN IDs (commands, heartbeat, STATUS) must not conflict with other boards (T-1). <br>• **Team decision:** reject messages with a reason code on the bus, or only a reject counter in STATUS / the log (T-2). |
| MSG-2 | **Message handling (element 7): order, repeats, damp, spam.** <br>• *In order, nothing dropped:* the AI isn't expected to send two commands at once, so processing every good command in arrival order is simplest and can't lose a different command. The MCP2515 holds 2 received frames; an overflow is counted in STATUS. <br>• *Repeats are not ignored* (Henry: damping reuses the same commands; ignoring repeats is only worth it if controlled, e.g. with a timer). <br>• *Spammed kicks:* kick commands are allowed as fast as the Pi asks, even on a barely recharged bank (after a miss the robot must kick again quickly). No message rate limit. **But kick pulses must be ≥ `KICK_MIN_INTERVAL_MS` apart** (Henry): two pulses close together, even well over 5 ms apart, combine into one excessively large kick. 500 ms is a starting guess and is probably larger in practice; tune it on the field. Getting it wrong only sends the ball too fast (a foul), it doesn't damage the board. A kick asked for too soon is not dropped: **arming** waits until the interval has passed, then a ball in the beam is kicked straight away (KCK-2). <br>• *Kick during a damp:* see MSG-3. <br>• *A command during a damp:* IDLE / CHG stop the PWM and act on the new command; DAMP renews; AUTOKICK arms inside the damp loop (element 18). <br>• *Why renew:* a robot holding the ball (e.g. lining up a pass) keeps the damp going with no new initial kick and no extra charge → dump cycle. <br>• *Why restart, not add:* like the heartbeat, the hold lasts only while the Pi keeps asking and ends at most one timeout after the last request. Adding time would let spammed commands stack up. <br>• *Why a hard maximum:* whatever the AI does, the PWM can't stay on the solenoid longer than `DAMP_MAX_TOTAL_MS` (from the initial kick, never extended). Not a heating limit (Henry: the hold draws little current; it drains the caps and stops), so 6 s is fine as a backstop. After the damp ends (timeout or maximum), the next DAMP starts a fresh damp. There is no HV floor exit (element 16). <br>• *Pulse in flight:* "stop the active kick" means de-arm the **armed** kick. A pulse already firing (≤ 5 ms) is never cut: cutting it would give a weak partial kick, and the retry has to wait 500 ms anyway. <br>• *Before Idle:* the board runs from the battery, so with no battery it is off unless USB is connected; commands in Wait for Bat realistically only happen on the bench. A command in Start BKBM interrupt still counts for the heartbeat (element 3), but isn't acted on. "Not ready" / "locked" rejects only if the team wants rejects (T-2). <br>• *Spam and the dump resistors:* no longer a risk. Kicks and damps use the hold (no dump), so a spammed AUTOKICK never dumps; only Idle / heartbeat loss dump (coupled C-1). |
| MSG-3 | **Caution, note DMP-5:** the held-out plunger may block the break-beam during a damp. **Kick requested during a damp (element 7). Key change from the chart (Henry).** Example: a damp starts, 1 s passes, a kick is requested. <br>• *The kick request does **not** stop the PWM.* Stopping it then would leave a gap before the ball reaches the break-beam where nothing holds it, and the damp wouldn't work. The kick is queued (armed). <br>• *Case 1, break-beam not tripped yet:* PWM keeps going. When the break-beam trips: **stop the PWM at that moment**, kick, leave the damp. <br>• *Case 1, break-beam never trips:* the damp timeout / `DAMP_MAX_TOTAL_MS` ends the damp; the kick is de-armed with it (Henry). <br>• *Case 2, break-beam already tripped when the kick is requested:* kicked as soon as it is armed. <br>• *Spacing:* `KICK_MIN_INTERVAL_MS` counts from the damp's initial kick, so it is normally already met by the time the ball arrives. <br>• *Plunger position (Henry):* no settle delay needed. The ball pushes the plunger back, so the kick has its stroke when it fires. <br>• *Renew after the kick request (Henry):* keeps the kick armed (element 17), so a kick sent too early still fires. <br>• *How (agreed):* like renew, the AUTOKICK command just sets `armed = 1` and returns to the damp loop's Wait; Wait gets a `kick assigned` exit into the existing GUARD → Kick (elements 18, 19). No new state, and the kick doesn't go through the AUTOKICK states. Going through AUTOKICK would leave the machine in Arm Kick while the PWM runs in the background, with no HV adjustment or timeout: the state wouldn't match the hardware. Break-beam condition widened to include `MODE_DAMP` (element 13). |
| KCK-1 | **Kick HV threshold (element 10).** <br>• *Why the check exists:* Henry added it for the damp → kick case, so a kick isn't fired with no charge. <br>• *Why 100 V, not 180 V:* 180 V blocked a quick re-kick after a miss (the bank is below 180 V) and made HV the main gate on every kick. At 100 V: damp → kick → miss means recharging first (logical); a kick without a miss can still fire straight away. <br>• *Risk accepted:* HV stuck low (≈ 0 V) means the board never kicks. See the charge review open topic (stuck readings). Idea not adopted (Henry: leave as is, change it if it causes problems; the circuit isn't expected to fail): on the normal AUTOKICK path arm on `HV >= 100V \|\| chg_cycle_done`, a new charge-machine flag set on entering Assuming Charged and cleared at New Charge. Plain `done == 0` doesn't work: it is also 0 during a damp, after a dump and after a fault. <br>• *Kick during a damp:* first planned through these AUTOKICK states; settled as arming inside the damp loop (element 18, MSG-3), because the AUTOKICK path would leave the PWM running outside the damp loop. |
| KCK-2 | **Kick spacing vs. ball in the beam: a dilemma (elements 12, 13).** <br>• *Problem:* two kicks closer than `KICK_MIN_INTERVAL_MS` combine into one oversized kick (foul). But if the spacing gates the **fire** step, a ball that is assigned during the interval waits, and may roll away before the kick fires (kick at nothing). Henry removed the spacing row from the kick GUARD; neither behaviour is wanted. <br>• *Fix (agreed):* gate the **arm**, not the fire. Put `time since last kick >= KICK_MIN_INTERVAL_MS` on the arrow Enable Charging → Arm Kick. Until then `armed == 0`, so the break-beam can't assign. Once armed, a ball already in the beam is assigned straight away (element 13's loop) and the kick fires within ms (only `done == 0` left to wait for). `kick assigned` stays latched once set, as drawn, even if the beam goes OFF before the kick fires (Henry: the ball may have just passed the beam and still be kickable). Clearing it on beam OFF was suggested and not adopted. Possible later refinement: clear it only if the beam has been OFF longer than a short window (e.g. 100–200 ms, tune on the field). <br>• *Other idea (not adopted):* throttle the kick strength (shorter PW) for a kick inside the interval instead of waiting. Not when a break-beam kick is expected. |
| DMP-2 | **Initial Kick PW and (y): history (element 15).** All tuned by hand. <br>• *Jul 2025* (`2b5ffe2`): initial pulse 500 µs; PWM starts after 15 × PW = 7.5 ms. <br>• *Mar 2026* (`ad96e1b`, `be2dc6e`): 500 µs, wait 15 × PW ("wait for plunger to physically extend"); briefly 500 ms for visualising. <br>• *Jul 2–3 2026* (`c533eb6`–`8837846`): 500 µs, 15 × PW. <br>• *Jul 4 2026, RoboCup* (`844995d`, current): **800 µs, wait 5 × PW = 4 ms**. <br>**Pattern:** (y) has always been written as a multiple of the initial PW (15×, then 5×), and the total kick + wait went from 8 ms to 4.8 ms. That's a tuning convention, not physics: (y) is really "time for the plunger to reach its extended position", which depends on the kick energy (PW **and** HV), not on PW alone. <br>**Later (bench):** measure the plunger's extend time directly (reed switch from `to-test/`, or high-speed video) at a few HV / PW points, and set (y) from that. Until then: `DAMP_INITIAL_KICK_US = 800`, (y) = 4 ms (the RoboCup 2026 values, now on Henry's chart). <br>**Related, for the damp loop:** the Jul 2025 frequency sweep (`6f827e0`) found the hold needs an on-time of roughly **26–35 µs per PWM pulse** at any frequency from 1 to 30 kHz (duty × period ≈ constant); 1–10 kHz was noted as ideal, ~37 kHz the practical maximum. |
| DMP-3 | **Damp loop (element 16).** <br>• *Leaving the loop on a new command (Henry's concern):* the timeout is checked **in** the loop, and the ANY STATE "incoming message" box no longer stops the PWM. So a command that leaves the loop without stopping the PWM leaves nothing to end it. Per command: CHG stops it (its de-arm / stop PWM block); DAMP renews and stays in the loop; IDLE: Set Idle Mode stops it (agreed, element 6); AUTOKICK: arms and stays in the damp loop (element 18), and Kick with PW Assigned stops it. Heartbeat and battery loss stop it. Locked stops it too (changed after the state × event matrix test found a damp still running in Locked). <br>• *Fix (agreed):* every way out of the damp states stops the PWM explicitly (list above). An ANY STATE "PWM deadline → stop PWM" rule was agreed, then dropped (Henry): it would switch the PWM off without changing state, so the chart could say "damping" while the PWM is off. <br>• *Backstop (agreed, not on the chart):* the kicker driver never runs the PWM longer than `DAMP_MAX_TOTAL_MS`, like the X-5 power-stage interlock: below the state machine, only there for a code bug. <br>• *HV adjustment rounding (decided: keep as RoboCup, Henry):* RoboCup rounds the duty down to a whole percent (`int(...)`). With a 12 % base the ^0.1 factor only lifts it to 13 % below ~94 V, so above that the adjustment does nothing. **To validate later (bench):** measure the actual duty and hold power the adjustment produces across HV, and decide then whether the rounding or the formula should change. |
| DMP-4 | **Damp part of the chart (elements 16–20), in full.** <br>• *Renew is new behaviour, not just a label:* a DAMP while the PWM is running stays in the loop (no new Initial Kick, parameters kept) and restarts the timeout; the exit counts from the last DAMP. <br>• *PWM running:* a flag that is 1 only while the damp PWM is on (set at Start Damping PWM, cleared at every Stop PWM). Not `mode == MODE_DAMP`: after a timeout or the low-HV Stop PWM, `mode` can still be `MODE_DAMP` with no PWM, and a DAMP must then start a fresh damp. Henry's chart says "PWM running" / "PWM not running". <br>• *Kick during a damp (same pattern as renew, no new state):* AUTOKICK while the PWM is running → Arm Kick (`armed = 1`, no Enable Charging, hold stays on) → set `mode` back to `MODE_DAMP` → Wait. The break-beam fires on `mode == MODE_DAMP` too (element 13). <br>• *Renew keeps a queued kick armed* (Henry): if the kick command came too early, the AI can keep renewing and the kick still fires when the ball trips the beam. The only exception to "a good command de-arms" (element 7). <br>• *Kick exits from Wait:* `HV >= 100V && kick assigned` → GUARD → Kick with PW Assigned; the PWM stops in the same PIO step as the pulse, so it holds until the moment of the kick. A ball already in the beam is kicked as soon as it is armed. No settle delay: the ball pushes the plunger back (Henry). <br>• *Low bank:* `HV < 100V && kick assigned` → Stop PWM (the damp ends) → wait 50 ms (solenoid current dies down) → Enable Charging → `HV >= 100V && kick assigned` → Charge Hold → `done == 0` → GUARD → Kick. The PWM is off before charging, so no charging while damping and nothing left running. `kick assigned` stays latched (KCK-2). <br>• *End of the damp:* `time since last DAMP >= timeout` or `time since Initial Kick >= DAMP_MAX_TOTAL_MS` → de-arm, stop PWM → Enable Charging → Wait for Message. An unused kick ends with the damp. <br>• *Values:* (x) = 25 ms (`DAMP_ADJUST_PERIOD_MS`); frequency, duty, timeout from the DAMP command (RoboCup defaults 30 kHz, 12 %, 3000 ms). HV Adjustment = `duty = base × (210 / max(HV, 60))^0.1`, clamped base…95 %, rounding kept (DMP-3). <br>• *No HV floor* (Henry): at low HV the PWM just doesn't hold; harmless, the timeout ends it. RoboCup had none (60 V is only the formula's clamp). <br>• *Charging:* `chg_hold_mode_ctrl` stays 1 from Charge Hold through the whole loop. |
| DMP-5 | **The break-beam during a damp: probably unreliable. NOTE, logic unchanged (Henry).** <br>• *Problem:* while the plunger is held out it blocks the break-beam, so during a damp the beam may read "ball present" all the time and can't tell whether a ball has arrived. The state machine still works as drawn (kick during a damp waits for the beam, elements 18-20); this is how Henry wants it to work, but it may not work on the board. Be careful, test it. <br>• *Why it should still work (Henry):* the AI sends the kick only after the robot has caught the ball, and the break-beam is only listened to once the kick is armed (`armed == 1`), i.e. after that command. Before it, the beam is ignored. After it, the plunger blocking the beam and the ball in the beam both read "ball present", so the kick fires either way. <br>• *Flicker:* once armed, the first "ball present" latches the kick, so the beam must be steady before it counts: `BEAM_DEBOUNCE_MS` raised from 1 to 5 ms, to tune on the bench. <br>• *Faster, later (DMP-6):* kicking the moment the ball hits the plunger, with no AI command, would need the robot already aimed before the ball arrives; keep the AI-triggered kick for now. <br>• *Idea to test (Henry):* the AI sending a kick during a damp means "the ball just hit the plunger". Stop the PWM at that point; with the plunger released, the beam can **probably** be read again. Risk: if the ball is bouncing, the beam reading may still be wrong. Test on the bench. <br>• *Other ways to see the ball during a damp:* an extra sensor; the reed switch (plunger position, `to-test/reed-switch`); the HV / current signature when the ball slams the plunger back (`to-test/hv-current-sensing`, theory in note DMP-6). <br>• *Also check:* right after a damp ends the plunger is still retracting and may block the beam for a moment, so an AUTOKICK sent just after a damp could see a "ball" that isn't there. If so, ignore the beam for a short time after the PWM stops. |
| DMP-6 | **Theory: spotting a ball hitting the held plunger from the HV reading (to test once a board works).** <br>• *What happens:* during a hold the charger is off and the dump is off, so the bank only feeds the solenoid (plus the ~1 MΩ divider). Bank current = −C·dV/dt (C = 2 mF): reading HV fast enough gives the solenoid's current for free. When the ball hits, it pushes the plunger back against the magnetic pull: the air gap and the coil's inductance L(x) change quickly, which induces a voltage in the coil (motional EMF ≈ i·dL/dt). For a few ms the coil draws a different current from the bank than in the steady hold, then settles at the new position. The ball's energy goes into the coil circuit: that is the damping. <br>• *Size of the signal (rough):* a 46 g ball at 2 m/s carries ~0.09 J. Absorbed over ~2-5 ms that is ~20-45 W, i.e. a change of ~0.15-0.3 A at 150 V, or a change in dV/dt of ~0.1 V/ms. One ADC count is ~62 mV of bank voltage, so a single 1 kHz reading per loop is not enough; the ADC has to run fast (up to 500 k samples/s, e.g. on the second core or by DMA) and average. Averaging ~100 samples per 0.2 ms brings the noise to a few mV, enough in principle. The exact shape (dip or bump, how long) has to be measured: it depends on the coil, the plunger and the driver. <br>• *Detector:* a running estimate of the bank current (slope of HV over a short window), a slow baseline of that current during the hold, and a trigger when the difference stays beyond a threshold for a few samples. Feeds the mode machine as "ball hit" (in place of the break-beam during a damp: a chart change, to agree later). <br>• *Things that look like a ball and must be told apart:* the duty update every 25 ms (a known current step at a known time: blank the detector around it or subtract it); the Initial Kick and the PWM start; ADC noise; a bouncing ball (several hits). <br>• *Test plan:* (1) log HV at a high rate during holds with no ball: noise and the 25 ms steps; (2) roll / drop the ball at a few known speeds; (3) bouncing balls; (4) compare signal to noise, then pick the threshold and window; (5) check false triggers on long holds with no ball. Needs the RC filter on the HV sense to be fast enough (the simulator assumes 128 µs; check the real value on the schematic). <br>• *If HV is not enough:* a current-sense resistor on the coil sees the inductance directly: in each PWM on-time the current rises at V / L(x), so the plunger position can be read every period (30 kHz); or the reed switch for a simple "plunger pushed back" signal. <br>• *Research and test code:* `to-test/hv-current-sensing/README.md` (sense chain from the schematic, why to look for a voltage step rather than a current spike, a detector checked on synthetic data, a DMA capture + bench script, analysis on the PC, bench test plan). |
| DMP-1 | **Charging while damping (Henry's note, experiment idea).** As drawn, a kick command during a damp goes through MODE_AUTOKICK → Enable Charging, so the bank would charge while the solenoid PWM drains it. The PWM drains slower than the ~7 s autodischarge, so it may behave, and topping the caps up during a damp could be useful. Possible nasty effects to check first: <br>• *Charge machine faults:* a load on the bank can keep DONE high past the 4500 ms check → "Too slow to charge" → Disabled, one-way (charge element 10). A working board would lock itself out. <br>• *HV-based duty:* the HV adjustment loop reads HV while the flyback is switching, so readings may be noisy or rising, and the duty would chase them. <br>• *Dump:* `chg_stop_mode_ctrl = 1` dumps (Inhibited), so switching charging off and on during a damp also switches the dump (coupled C-1). <br>If tried: behind a config flag (off by default, like `SAFE_CHARGE`), bench only, with HV / DONE / solenoid current logged. |

## Changes needed outside the board

| # | Change | Why |
|---|---|---|
| R-1 | **Robot side (Pi): send heartbeat frames** to the chicker at **5 Hz** (every 200 ms), with a rolling sequence counter. | Mode element 3: the board waits for `heartbeat == OK` before going to Idle, so it won't take commands without it. |
| T-1 | **Team check:** the chicker's CAN IDs (commands, heartbeat, STATUS) don't conflict with any other board on the bus. | Mode element 7 / MSG-1. |
| T-2 | **Team decision:** reject messages with a reason code on the bus (unknown ID / bad length / out of range, "not ready" before Idle, "locked" in Locked), or only a reject counter in STATUS / the log. | Mode element 7 / MSG-1, MSG-2. |
| T-4 | **Tell the team (Pi side), from the code rebuild:** the KICK frame is AUTOKICK only, as at RoboCup (kick when the ball breaks the beam; trigger byte must be 0: an immediate-kick option from an early protocol draft, before the chart review, is not supported); an armed kick with no ball expires after a fixed 2 s, as at RoboCup (ARM_EXPIRED event), and the KICK `arm_ms` field is ignored; commands sent before the board is ready (no battery / no heartbeat yet) and in Locked are rejected, not queued; the board needs a heartbeat (any valid frame) before it acts on any command, and treats 5 s of silence as lost comms; every good command de-arms except the two renews (DAMP while damping, AUTOKICK while armed: repeating AUTOKICK keeps a kick armed); one kick per AUTOKICK command. | Mode elements 3, 4, 7, 12, 17. |
| T-5 | **Ask the team (AI side): does the 2 s arm timeout fit how the AI kicks?** The timeout counts from the **last** AUTOKICK frame, so an AI that resends AUTOKICK while it still wants to kick (e.g. every 200 ms) keeps the kick armed for as long as it keeps asking, and it expires ~2 s after the AI stops. An AI that sends AUTOKICK **once** and then waits more than 2 s for the ball would miss kicks. How did the RoboCup AI send it? Options if 2 s is too short: the AI resends (preferred: the kick dies if the AI crashes or changes its mind), a longer `KICK_ARM_TIMEOUT_MS`, or let the AI choose per command through the KICK frame's `arm_ms` field. | Mode element 21. |
| T-3 | **Team decision:** every command frame carries a sequence number; STATUS echoes the last good command's number so the Pi knows it landed, and the Pi resends if it doesn't. | Mode element 7. Needs Pi-side changes (add to R-1 if agreed). |

## Not on the chart (needs Henry's OK)

| Item | Status |
|---|---|
| DAMP renew (restart the timeout) + hard maximum hold `DAMP_MAX_TOTAL_MS` | **Agreed** (element 7, MSG-2). 6 s backstop; heating is not a concern (Henry). |
| New flag `chg_hold_mode_ctrl`: stop charging, keep the caps charged (charge state Not Charging) | **Agreed** (charge element 5a, coupled review). Mode boxes: the "Disable Charging" before the AUTOKICK kick and before the damp's Initial Kick become **"Hold Charge"** (`chg_hold_mode_ctrl = 1`); every Enable Charging clears both flags; Idle / heartbeat loss / Start BKBM keep `chg_stop_mode_ctrl = 1` (dump). |
| Kicker driver PWM limit `DAMP_MAX_TOTAL_MS` (backstop, below the state machine) | **Agreed** (DMP-3). Replaces the dropped ANY STATE "PWM deadline" rule. |
| Kick during a damp: arm inside the damp loop, `kick assigned` exit from Wait | **Agreed** (elements 18–20, MSG-3). |
| 2 s arm timeout in Arm Kick (element 21; not during a damp, element 22) | **Agreed** (Henry). To add to the chart. Whether 2 s is right for the AI: team item T-5. |
| Message rate limit | **Rejected**: kick commands may be spammed (MSG-2). |
| Kick pulse spacing `KICK_MIN_INTERVAL_MS` (start 500 ms, tune on the field); gates the arm, not the fire (KCK-2) | **Agreed** (Henry): pulses closer together combine into an excessively large kick (MSG-2). |
| Ignore an identical repeated command | **Rejected** (element 7, MSG-2). Could come back later only if controlled (e.g. with a timer). |
| Command acknowledgement (sequence number echoed in STATUS) | Henry OK, **pending team** (T-3). |
| Reject messages on the bus | Henry OK for "not ready" / "locked", **pending team** (T-2). |
