sfunderbots/Electrical/Chicker/firmware/flowcharts/chicker-charge-state-machine-v2.png

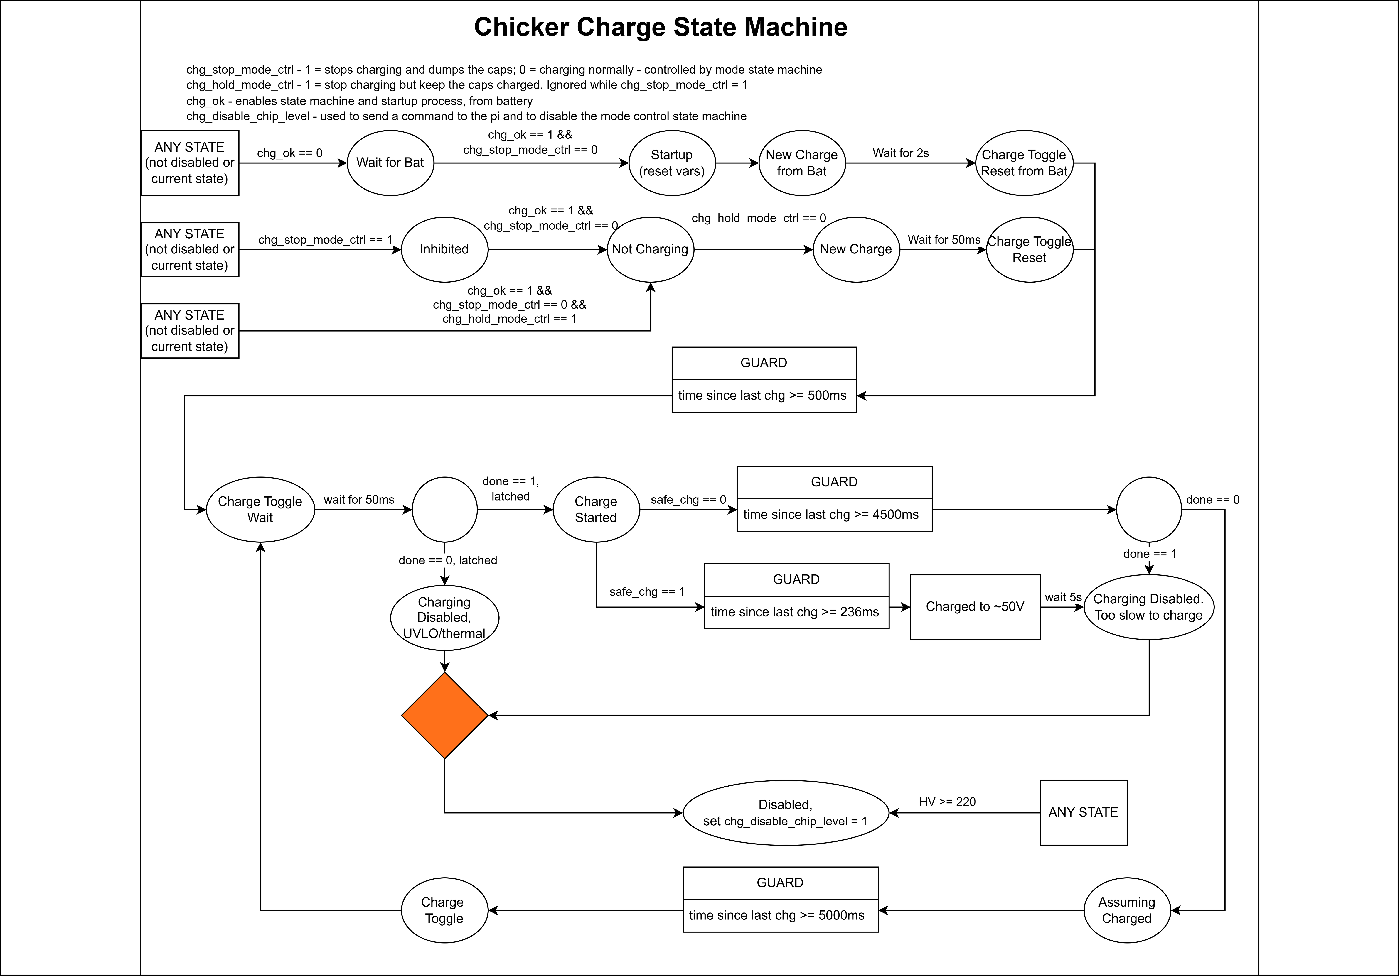
Chicker/firmware/flowcharts/chicker-charge-state-machine-v2.png
