sfunderbots/Electrical/Chicker/firmware/flowcharts/chicker-mode-control-state-machine-v2.png

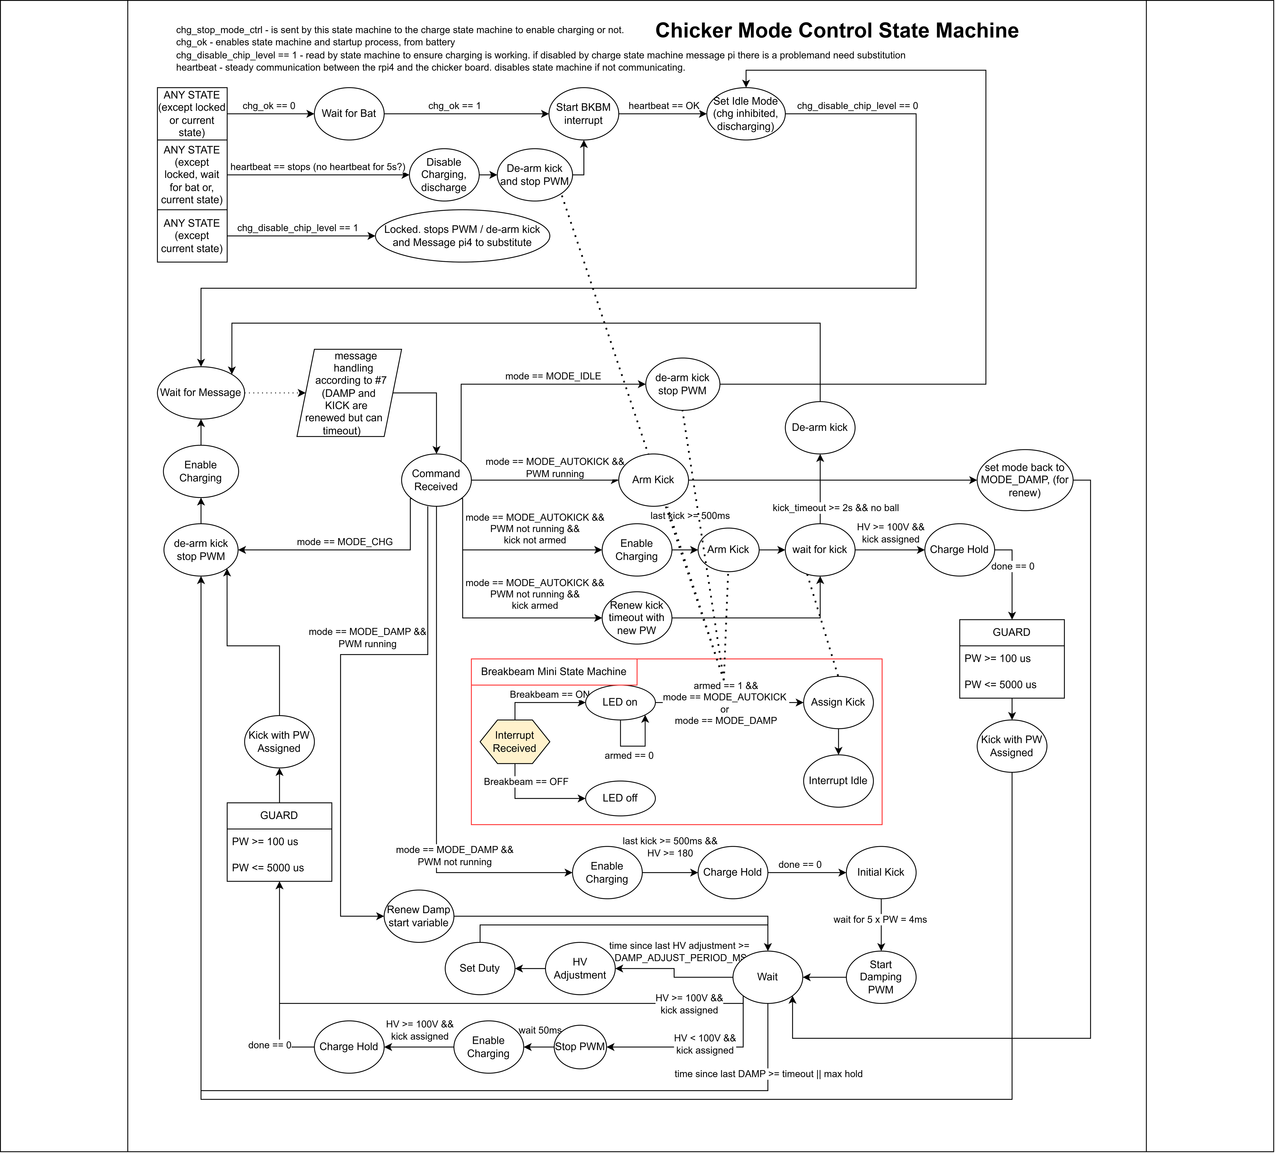
Chicker/firmware/flowcharts/chicker-mode-control-state-machine-v2.png
