sfunderbots/Electrical/Chicker/Images/POWER_BOARD_bot.png

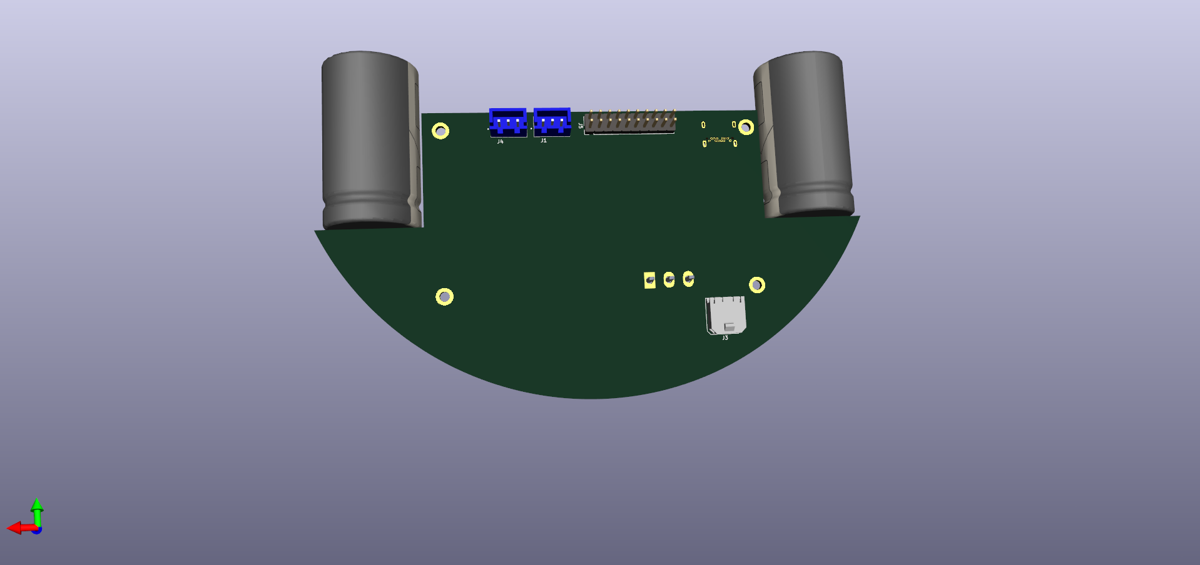
Chicker/Images/POWER_BOARD_bot.png
