sfunderbots/Electrical/Chicker/Images/POWER_BOARD_top.png

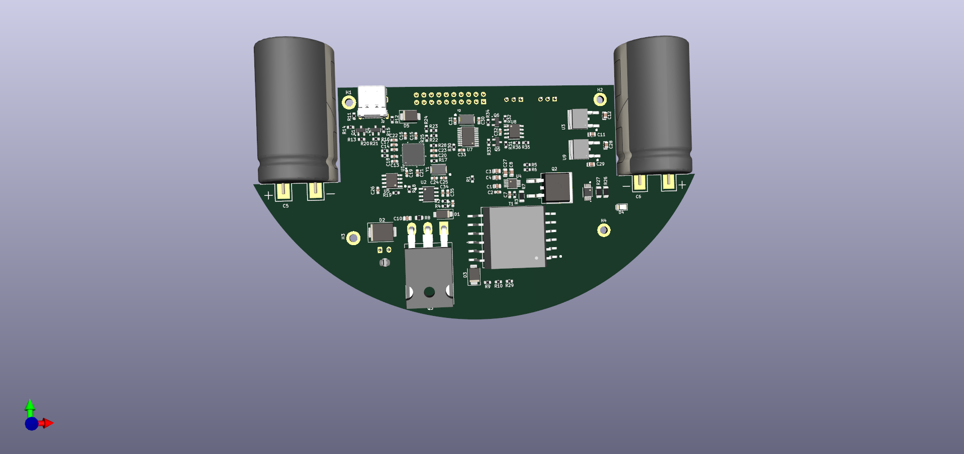
Chicker/Images/POWER_BOARD_top.png
