sfunderbots/Electrical/FacePlate/production/FacePlate_bot.png

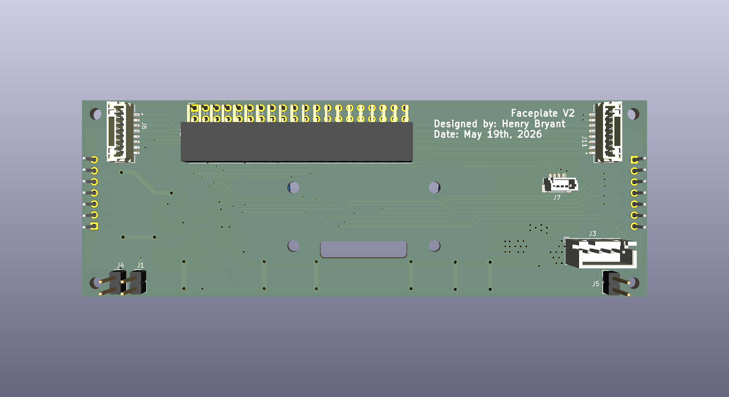
FacePlate/production/FacePlate_bot.png
