sfunderbots/Electrical/FacePlate/production/FacePlate_top.png

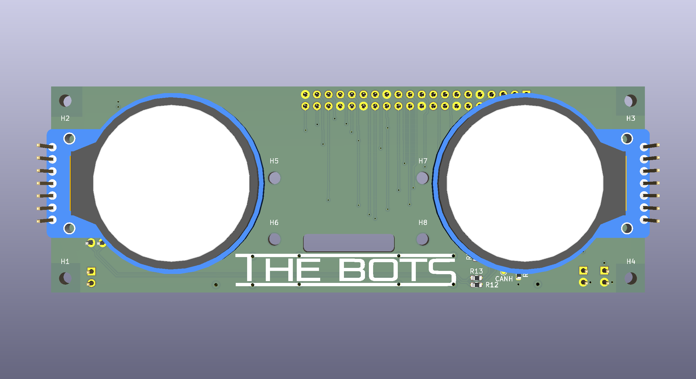
FacePlate/production/FacePlate_top.png
