sfunderbots/Electrical/MidPlate/Midplate BOM Jan 15.xlsx

Ref | Val | Package | JLC Part #$ | Digikey Cost | JLC Cost | JLC extended? | QTY per board | DNP QTY | QTY after DNP | QTY have | QTY *10 + spare | Digikey Cost (total) | JLC Cost with Extended part fee (total) | override | Lowest Cost (Digikey vs JLC)
C1 | C_0.1u | C_0603_1608Metric | C14663 | 0.074 | 0.0028 | no | 1 |  | 1 |  | 10 | 0.74 | 0.028 |  | 0.028 | JLC
C2 | 25SVPF100M | CAP_25SVPF100M | C136279 | 1.471 | 1.06305 | yes | 1 |  | 1 |  | 10 | 14.71 | 14.6705 | DIGIKEY | 14.71 | DIGIKEY |  |  |  |  |  | no components compare
C3 | 10u | C_0805_2012Metric | C440198 | 0.317 | 0.0908 | no | 1 |  | 1 |  | 10 | 3.17 | 0.908 |  | 0.908 | JLC |  | PCB | $33.59 |  |  | $33.59
C4 | C_30p | C_0603_1608Metric | C1658 | 0.050 | 0.00364 | no | 1 |  | 1 |  | 10 | 0.5 | 0.0364 |  | 0.0364 | JLC |  | setup | $10.78 |  |  | -
C5 | 2.2u | C_0603_1608Metric | C23630 | 0.085 | 0.00728 | no | 1 |  | 1 |  | 10 | 0.85 | 0.0728 |  | 0.0728 | JLC |  | stencil | $2.02 |  |  | -
C6 | 16SVPF180M | CAP_16SVPF180M | C136277 | 1.266 | 0.90539 | yes | 1 |  | 1 |  | 10 | 12.66 | 13.0939 |  | 12.66 | DIGIKEY |  | components | $62.46 | 93.41 | weird? | -
D1 | SMAZ12-13F | D_SMA | C110523 | 0.476 | 0.10024 | yes | 1 |  | 1 |  | 12 | 5.712 | 5.24288 |  | 5.24288 | JLC |  | extended fee | $30.95 |  |  | -
F1 | 3568 | Fuseholder_Blade_Mini_Keystone_3568 |  | 1.68 |  |  | 1 |  | 1 |  | 8 | 13.44 | EMPTY |  | 13.44 | DIGIKEY |  | smt | $1.85 |  |  | -
H1, H2, H3, H4, H5, H6, H7, H8, H9, H10, H11 | SMTSO2515CTJ | SMTSO2515CTJ | C2915629 | 0.4952 | 0.0675 | yes | 12 |  | 12 |  | 122 | 60.4144 | 12.275 |  | 12.275 | JLC |  | confirm | $0.58 |  |  | -
J9 | JST_BM04B-GHS-TBT | JST_BM04B-GHS-TBT | C161692 | 0.606 | 0.24966 | yes | 2 | 2 | 0 |  | 22 | 13.332 | 9.53252 |  | 9.53252 | JLC
J12 | JST_B4B-XH-A | JST_B4B-XH-A | C144395 | 0.269 | 0.0395 | yes | 1 |  | 1 |  | 8 | 2.152 | 4.356 |  | 2.152 | DIGIKEY |  | shipping | $74.34 |  |  | $45.00
JP1 | Jumper_2_Bridged | PinHeader_1x02_P2.54mm_Vertical | C2905434 | 0.042 | 0.0165 | yes | 1 |  | 1 |  | 8 | 0.336 | 4.172 |  | 0.336 | DIGIKEY |  | Total | $216.57 |  |  | $78.59
L1 | CDRH127/LDNP-220MC | IND_CDRH127_LDNP-470MC_SUM | C879420 | 1.757 | 0.63256 | yes | 1 |  | 1 |  | 10 | 17.57 | 10.3656 |  | 10.3656 | JLC |  | import tax | $25.99 |  |  | $13.36
Q1, Q2 | MCU60P04-TP | DPAK-3_ONS | C130101 | 1.0969 | 0.5578 | yes | 2 |  | 2 |  | 20 | 21.938 | 15.196 |  | 15.196 | JLC |  | flat fee | $17.50
R1, R2 | R_100k | R_0603_1608Metric | C25803 | 0.023 | 0.001215 | no | 2 |  | 2 |  | 20 | 0.46 | 0.0243 |  | 0.0243 | JLC |  | TOTAL | $260.06 |  |  | $91.95
R6 | 88.7k | R_0603_1608Metric | C5151619 | 0.023 | 0.0015 | yes | 1 |  | 1 |  | 10 | 0.23 | 4.055 |  | 0.23 | DIGIKEY
R7 | 22.1k | R_0603_1608Metric | C25961 | 0.023 | 0.0009 | yes | 1 |  | 1 |  | 10 | 0.23 | 4.049 |  | 0.23 | DIGIKEY |  |  | $338.30 |  |  | $362.15
SW1 | RA1H1C112R | SW_RA1H1C112R |  | 1.332 |  |  | 1 |  | 1 |  | 8 | 10.656 | EMPTY |  | 10.656 | DIGIKEY |  | per board | $33.83 |  |  | $36.21
U1 | LMR23630AFDDAR | TI_SO-PowerPAD-8_ThermalVias | C601653 | 4.67 | 1.24895 | yes | 1 |  | 1 |  | 10 | 46.7 | 16.5295 |  | 16.5295 | JLC
 |  |  |  |  |  |  |  |  |  |  |  |  |  |  |  | 11
 |  |  |  |  |  |  |  |  |  |  |  | 225.8004 | TOTAL |  | 124.625 | 70.211 | 78.24208 |  | THESE RESULTS NOT INCLUDING WIRES and BOTTOM SIDE COMPONENTS
 |  |  |  |  |  |  |  |  |  |  |  |  |  |  |  | JLC cost | Digikey cost
 |  |  | usd to cad | 1.3497425
 |  |  |  |  |  |  |  |  |  |  |  |  |  |  |  |  |  | 3.86875
Bottom side components and extra stuff
 |  |  |  |  |  |  |  |  |  |  |  |  | price if request approved
 | 0297015.WXT |  |  | 0.409 |  |  | 1 |  |  |  | 15 |  | 6.135
 |  |  |  |  |  |  |  |  |  |  |  |  | 0
 | FIT0582 |  |  | 8.85 |  |  | 1 |  |  |  | 1 |  | 8.85
 |  |  |  |  |  |  |  |  |  |  |  |  | 0
 | housing 6 pin |  |  |  |  |  |  |  |  |  |  |  | 0
 | housing 2 pin |  |  |  |  |  |  |  |  |  |  |  | 0
 | 794606-1 | crimps |  |  |  |  |  |  |  | 100 |  |  | 0 |  |  | request approved
J4, J5 | 2-1445053-2 |  |  | 1.88 |  |  | 1 |  |  | 8 | 8 | 0 | 0 |  |  | request approved
J7 | 3-794636-6 |  |  | 3.7 |  |  | 1 |  |  | 8 | 8 | 0 | 0 |  |  | request approved
J13 | BM04B-GHS-TBT |  |  |  |  |  |  |  |  |  |  | 0 | 0
R3 | RMCF0603FT110R |  |  | 0.023 |  |  | 1 |  |  |  | 10 | 10 | 0.23
R4, R5 | RMCF0603ZT0R00 |  |  | 0.023 |  |  | 1 |  |  |  | 10 | 10 | 0.23
 | WM21789-1-ND |  | 4 cond cable 22AWG |  |  |  |  |  |  |  | extra digikey |  | 15.445
 | T1331-1-ND
