sfunderbots/Electrical/Chicker/POWER_BOARD_BOM_BASIC_TESTBOARD_JLC.xlsx

Comment | Designator | Footprint | JLC Part #
25SVPF100M | C1, C2 |  | C136279
22u_1206 | C3, C4, C8 |  | C12891
1000u | C5, C6
100p | C7 |  | C14858
0.1u | C9, C13-C21, C26, C32-C34, C38 |  | C14663
1500p | C10, C39 |  | C342996
10u | C11, C12, C37, C40 |  | C440198
1u | C22, C23, C35 |  | C15849
27p | C24, C25 |  | C107045
0.22u_0805 | C27 |  | C5378
0.1u_600V | C28 |  | C2902776
22p | C30, C31 |  | C1653
2A 600V | D3 |  | C59627
LED_red | D4 |  | C84256
B220 | D5 |  | C110480
LED | D6, D8, D15 |  | C2297
LED_blue | D7 |  | C2290
LED | D9, D13 |  | C72038
3SMBJ5929B-TP | D12 |  | N/A
US1M | D14 |  | C412437
0501015.WR1 | F1 |  | C410346
USB4145-03-0170-C_REVA2 | J2
BSS138 | Q1, Q4 |  | C7420339
IRFR3410TRPBF | Q2 |  | C605020
FGH50T65SQD-F155 | Q3, Q7 |  | C132704
TN2130K1-G | Q5 |  | C626652
IPD60R3K4CEAUMA1 | Q6
100k | R1, R9, R10, R27, R29 |  | C25803
100k | R32 |  | C25803
10k | R2, R13-R16, R19, R28, R30, R41 |  | C25804
2.49k | R3 |  | C108190
120R | R4, R42 |  | C22787
48.1k | R5 |  | C23061
34.3k | R6 |  | C23008
8m | R7 |  | C326567
5.1k | R11, R12, R35, R36 |  | C23186
1k | R17, R18 |  | C21190
33R | R20, R21 |  | C23140
R_200k | R22 |  | C25811
R_470k | R23, R24 |  | C23178
R_0OHM_JUMPER | R25, R26 |  | C21189
270k | R31 |  | C22965
5.1M | R33, R34 |  | C13320
1.2k | R37 |  | C22765
330 | R38, R47 |  | C23138
150R | R39, R40, R45 |  | C22808
RPI2040 | U1 |  | C2040
AP2114HA-3.3TRG1 | U3 |  | C460314
W25Q16JVSNIQ | U5 |  | C97521
PTS647SM38SMTR2LFS | U9, U10 |  | C2689502
ABM3-12.000MHZ-D2Y-T | Y1 |  | C148313
CUS08F30,H3F | D16,D17,D18 |  | C150183
