sfunderbots/Electrical/Chicker/power board costs 1 and 10.xlsx

Index | Manufacturer Part Number | Attrition % | Requested Quantity 1 | Pack Quantity 1 | Pack Type 1 | Digi-Key Part Number 1 | Unit Price 1 | Extended Price 1 | Minimum Order Quantity 1 | Requested Quantity 2 | Pack Quantity 2 | Pack Type 2 | Digi-Key Part Number 2 | Unit Price 2 | Extended Price 2 | Minimum Order Quantity 2
1 | 25SVPF100M |  | 1 | 1 | Cut Tape (CT) | P123675CT-ND | 1.97000 | $1.97 | 1 | 10 | 10 | Cut Tape (CT) | P123675CT-ND | 1.47100 | $14.71 | 1
2 | CL31A226KAHNNNE |  | 1 | 1 | Cut Tape (CT) | 1276-3047-1-ND | 0.51000 | $0.51 | 1 | 10 | 10 | Cut Tape (CT) | 1276-3047-1-ND | 0.33800 | $3.38 | 1
3 | ESMQ251VSN102MQ45S |  | 1 | 1 | Bulk | 565-2754-ND | 8.76000 | $8.76 | 1 | 10 | 10 | Bulk | 565-2754-ND | 7.53300 | $75.33 | 1
4 | CL10C101JB8NNNC |  | 1 | 1 | Cut Tape (CT) | 1276-1008-1-ND | 0.14000 | $0.14 | 1 | 10 | 10 | Cut Tape (CT) | 1276-1008-1-ND | 0.03700 | $0.37 | 1
5 | CC0603KRX7R9BB104 |  | 1 | 1 | Cut Tape (CT) | 311-1344-1-ND | 0.14000 | $0.14 | 1 | 10 | 10 | Cut Tape (CT) | 311-1344-1-ND | 0.07400 | $0.74 | 1
6 | C2012C0G2A152J060AA |  | 1 | 1 | Cut Tape (CT) | 445-2321-1-ND | 0.23000 | $0.23 | 1 | 10 | 10 | Cut Tape (CT) | 445-2321-1-ND | 0.15600 | $1.56 | 1
7 | GRM21BR61H106KE43L |  | 1 | 1 | Cut Tape (CT) | 490-18663-1-ND | 0.48000 | $0.48 | 1 | 10 | 10 | Cut Tape (CT) | 490-18663-1-ND | 0.31700 | $3.17 | 1
8 | CL10A105KB8NNNC |  | 1 | 1 | Cut Tape (CT) | 1276-1860-1-ND | 0.20000 | $0.20 | 1 | 10 | 10 | Cut Tape (CT) | 1276-1860-1-ND | 0.13200 | $1.32 | 1
9 | CC0603JRNPO9BN270 |  | 1 | 1 | Cut Tape (CT) | 311-1063-1-ND | 0.14000 | $0.14 | 1 | 10 | 10 | Cut Tape (CT) | 311-1063-1-ND | 0.04700 | $0.47 | 1
10 | CL21B224KBFNNNE |  | 1 | 1 | Cut Tape (CT) | 1276-1093-1-ND | 0.14000 | $0.14 | 1 | 10 | 10 | Cut Tape (CT) | 1276-1093-1-ND | 0.06400 | $0.64 | 1
11 | C3225X7T2J104K160AC |  | 1 | 1 | Cut Tape (CT) | 445-7766-1-ND | 1.02000 | $1.02 | 1 | 10 | 10 | Cut Tape (CT) | 445-7766-1-ND | 0.68100 | $6.81 | 1
12 | CL10C220JB8NNNC |  | 1 | 1 | Cut Tape (CT) | 1276-1023-1-ND | 0.14000 | $0.14 | 1 | 10 | 10 | Cut Tape (CT) | 1276-1023-1-ND | 0.05800 | $0.58 | 1
13 |  |  | 1 |  |  |  |  |  |  | 10
14 | MUR860J |  | 1 | 1 | Cut Tape (CT) | 1740-MUR860JCT-ND | 0.74000 | $0.74 | 1 | 10 | 10 | Cut Tape (CT) | 1740-MUR860JCT-ND | 0.62300 | $6.23 | 1
15 | MURS160-E3/52T |  | 1 | 1 | Cut Tape (CT) | MURS160-E3/52TGICT-ND | 0.68000 | $0.68 | 1 | 10 | 10 | Cut Tape (CT) | MURS160-E3/52TGICT-ND | 0.53000 | $5.30 | 1
16 |  |  | 1 |  |  |  |  |  |  | 10
17 | B220-13-F |  | 1 | 1 | Cut Tape (CT) | B220-FDICT-ND | 0.68000 | $0.68 | 1 | 10 | 10 | Cut Tape (CT) | B220-FDICT-ND | 0.47400 | $4.74 | 1
18 |  |  | 1 |  |  |  |  |  |  | 10
19 |  |  | 1 |  |  |  |  |  |  | 10
20 |  |  | 1 |  |  |  |  |  |  | 10
21 | 3SMBJ5929B-TP |  | 1 | 1 | Cut Tape (CT) | 3SMBJ5929BTPMSCT-ND | 0.61000 | $0.61 | 1 | 10 | 10 | Cut Tape (CT) | 3SMBJ5929BTPMSCT-ND | 0.43600 | $4.36 | 1
22 |  |  | 1 |  |  |  |  |  |  | 10
23 |  |  | 1 |  |  |  |  |  |  | 10
24 | B3B-XH-A |  | 1 | 1 | Bulk | 455-2248-ND | 0.30000 | $0.30 | 1 | 10 | 10 | Bulk | 455-2248-ND | 0.23200 | $2.32 | 1
25 | USB4145-03-0170-C |  | 1 | 1 | Cut Tape (CT) | 2073-USB4145-03-0170-CCT-ND | 1.56000 | $1.56 | 1 | 10 | 10 | Cut Tape (CT) | 2073-USB4145-03-0170-CCT-ND | 1.31400 | $13.14 | 1
26 | BM04B-GHS-TBT |  | 1 | 1 | Cut Tape (CT) | 455-BM04B-GHS-TBTCT-ND | 0.71000 | $0.71 | 1 | 10 | 10 | Cut Tape (CT) | 455-BM04B-GHS-TBTCT-ND | 0.60600 | $6.06 | 1
27 | PH2-20-UA |  | 1 | 1 | Bag | 2057-PH2-20-UA-ND | 0.37000 | $0.37 | 1 | 10 | 10 | Bag | 2057-PH2-20-UA-ND | 0.30600 | $3.06 | 1
28 |  |  | 1 |  |  |  |  |  |  | 10
29 | IRFR3410TRPBF |  | 1 | 1 | Cut Tape (CT) | IRFR3410TRPBFCT-ND | 1.44000 | $1.44 | 1 | 10 | 10 | Cut Tape (CT) | IRFR3410TRPBFCT-ND | 1.17700 | $11.77 | 1
30 | FGH50T65SQD-F155 |  | 1 | 1 | Tube | FGH50T65SQD-F155OS-ND | 6.22000 | $6.22 | 1 | 10 | 10 | Tube | FGH50T65SQD-F155OS-ND | 6.22000 | $62.20 | 1
31 | TN2130K1-G |  | 1 | 1 | Cut Tape (CT) | TN2130K1-GCT-ND | 0.65000 | $0.65 | 1 | 10 | 10 | Cut Tape (CT) | TN2130K1-GCT-ND | 0.65000 | $6.50 | 1
32 | IPD60R3K4CEAUMA1 |  | 1 | 1 | Cut Tape (CT) | 448-IPD60R3K4CEAUMA1CT-ND | 0.76000 | $0.76 | 1 | 10 | 10 | Cut Tape (CT) | 448-IPD60R3K4CEAUMA1CT-ND | 0.65300 | $6.53 | 1
33 |  |  | 1 |  |  |  |  |  |  | 10
34 |  |  | 1 |  |  |  |  |  |  | 10
35 |  |  | 1 |  |  |  |  |  |  | 10
36 | RC0603FR-072K49L |  | 1 | 1 | Cut Tape (CT) | 311-2.49KHRCT-ND | 0.15000 | $0.15 | 1 | 10 | 10 | Cut Tape (CT) | 311-2.49KHRCT-ND | 0.02900 | $0.29 | 1
37 |  |  | 1 |  |  |  |  |  |  | 10
38 |  |  | 1 |  |  |  |  |  |  | 10
39 |  |  | 1 |  |  |  |  |  |  | 10
40 | PE1206FRF470R008L |  | 1 | 1 | Cut Tape (CT) | 13-PE1206FRF470R008LCT-ND | 1.21000 | $1.21 | 1 | 10 | 10 | Cut Tape (CT) | 13-PE1206FRF470R008LCT-ND | 0.99000 | $9.90 | 1
41 |  |  | 1 |  |  |  |  |  |  | 10
42 |  |  | 1 |  |  |  |  |  |  | 10
43 |  |  | 1 |  |  |  |  |  |  | 10
44 |  |  | 1 |  |  |  |  |  |  | 10
45 |  |  | 1 |  |  |  |  |  |  | 10
46 |  |  | 1 |  |  |  |  |  |  | 10
47 |  |  | 1 |  |  |  |  |  |  | 10
48 |  |  | 1 |  |  |  |  |  |  | 10
49 |  |  | 1 |  |  |  |  |  |  | 10
50 |  |  | 1 |  |  |  |  |  |  | 10
51 |  |  | 1 |  |  |  |  |  |  | 10
52 |  |  | 1 |  |  |  |  |  |  | 10
53 | PWR220T-35-2001J |  | 1 | 1 | Tube | PWR220T-35-2001J-ND | 4.80000 | $4.80 | 1 | 10 | 10 | Tube | PWR220T-35-2001J-ND | 4.06700 | $40.67 | 1
54 | 3522820RJT |  | 1 | 1 | Cut Tape (CT) | A121308CT-ND | 1.40000 | $1.40 | 1 | 10 | 10 | Cut Tape (CT) | A121308CT-ND | 0.83200 | $8.32 | 1
55 |  |  | 1 |  |  |  |  |  |  | 10
56 |  |  | 1 |  |  |  |  |  |  | 10
57 | MCP14A0454-E/SN |  | 1 | 1 | Tube | MCP14A0454-E/SN-ND | 2.34000 | $2.34 | 1 | 10 | 10 | Tube | MCP14A0454-E/SN-ND | 2.34000 | $23.40 | 1
58 | AP2114HA-3.3TRG1 |  | 1 | 1 | Cut Tape (CT) | AP2114HA-3.3TRG1DICT-ND | 0.56000 | $0.56 | 1 | 10 | 10 | Cut Tape (CT) | AP2114HA-3.3TRG1DICT-ND | 0.45600 | $4.56 | 1
59 | LT3750AEMS#TRPBF |  | 1 | 1 | Cut Tape (CT) | 505-LT3750AEMS#TRPBFCT-ND | 14.94000 | $14.94 | 1 | 10 | 10 | Cut Tape (CT) | 505-LT3750AEMS#TRPBFCT-ND | 13.50500 | $135.05 | 1
60 | W25Q128JVSIQ |  | 1 | 1 | Tube | W25Q128JVSIQ-ND | 2.54000 | $2.54 | 1 | 10 | 10 | Tube | W25Q128JVSIQ-ND | 2.31200 | $23.12 | 1
61 |  |  | 1 |  |  |  |  |  |  | 10
62 | MCP2515T-I/ST |  | 1 | 1 | Cut Tape (CT) | MCP2515T-I/STCT-ND | 4.03000 | $4.03 | 1 | 10 | 10 | Cut Tape (CT) | MCP2515T-I/STCT-ND | 4.03000 | $40.30 | 1
63 | PTS 647 SM38 SMTR2 LFS |  | 1 | 1 | Cut Tape (CT) | PTS647SM38SMTR2LFSCT-ND | 0.30000 | $0.30 | 1 | 10 | 10 | Cut Tape (CT) | PTS647SM38SMTR2LFSCT-ND | 0.28700 | $2.87 | 1
64 | ABM3-12.000MHZ-D2Y-T |  | 1 | 1 | Cut Tape (CT) | 535-10634-1-ND | 0.85000 | $0.85 | 1 | 10 | 10 | Cut Tape (CT) | 535-10634-1-ND | 0.70500 | $7.05 | 1
65 | ABM3-8.000MHZ-D2Y-T |  | 1 | 1 | Cut Tape (CT) | 535-10630-1-ND | 0.86000 | $0.86 | 1 | 10 | 10 | Cut Tape (CT) | 535-10630-1-ND | 0.71500 | $7.15 | 1
