sfunderbots/Electrical/Chicker/POWER_BOARD_BOM_JAN22.xlsx

Sheet: POWER_BOARD
Reference | Value | Footprint | JLC Extended | MPN | JLC Part # | Digikey cost 1 unit | Digikey Cost 10 units | JLC Cost | Layer | DNP QTY | Digikey Cost (total) | JLC Cost with Extended part fee (total) | Override | Lowest Cost (Digikey vs JLC) |  | QTY digikey order | Ordered?
C1, C2 | 25SVPF100M | bots:CAP_25SVPF100M | yes | 25SVPF100M | C136279 | 1.97000 | 1.471 | 1.06305 |  |  | 29.42 | 25.301 | JLC | 25.301 | JLC | 0
C3, C4, C8 | 22u_1206 | bots:C_1206_3216Metric | no | CL31A226KAHNNNE | C12891 | 0.51000 | 0.338 | 0.0645 |  |  | 10.14 | 1.935 | JLC | 1.935 | JLC | 0
C5, C6 | 1000u | bots:CP_Radial_Horizontal_D25.4mm_H45mm |  | ESMQ251VSN102MQ45S |  | 8.76000 | 7.53 |  |  |  | 70.08 | EMPTY | DIGIKEY | 70.08 | DIGIKEY | 0 |  | request submitted
C7 | 100p | bots:C_0603_1608Metric | no | CL10C101JB8NNNC | C14858 | 0.14000 | 0.037 | 0.0026 |  |  | 0.37 | 0.026 | JLC | 0.026 | JLC | 1
C9, C13-C21, C26, C32-C34, C38 | 0.1u | bots:C_0603_1608Metric | no | CC0603KRX7R9BB104 | C14663 | 0.14000 | 0.0326 | 0.0021 |  |  | 4.89 | 0.315 | JLC | 0.315 | JLC | 0
C10, C39 | 1500p | bots:C_0805_2012Metric | yes | C2012C0G2A152JT000N | C342996 | 0.23000 | 0.156 | 0.0396 |  | 1 | 1.56 | 4.436 | DIGIKEY | 1.56 | DIGIKEY | 0 | 10
C11, C12, C37, C40 | 10u | bots:C_0805_2012Metric | no | GRM21BR61H106KE43L | C440198 | 0.48000 | 0.317 | 0.0645 |  |  | 12.68 | 2.58 | JLC | 2.58 | JLC | 0
C22, C23, C35 | 1u | bots:C_0603_1608Metric | no | CL10A105KB8NNNC | C15849 | 0.20000 | 0.132 | 0.0046 |  |  | 3.96 | 0.138 | JLC | 0.138 | JLC | 0
C24, C25 | 27p | bots:C_0603_1608Metric | no | CC0603JRNPO9BN270 | C107045 | 0.14000 | 0.047 | 0.0027 |  |  | 0.94 | 0.054 | JLC | 0.054 | JLC | 0
C27 | 0.22u_0805 | bots:C_0805_2012Metric | no | CL21B224KBFNNNE | C5378 | 0.14000 | 0.064 | 0.0103 | Bottom |  | 0.64 | 0.103 | DIGIKEY | 0.64 | DIGIKEY | 1 | 10
C28 | 0.1u_600V | bots:C_1210_3225Metric | yes | C1210C104KBRAC7800 | C2902776 | 0.61 | 0.408 | 0.3623 |  |  | 1.83 | 7.663 | DIGIKEY | 1.83 | DIGIKEY | 0 | 10
C30, C31 | 22p | bots:C_0603_1608Metric | no | CL10C220JB8NNNC | C1653 | 0.14000 | 0.058 | 0.0052 |  |  | 1.16 | 0.104 | JLC | 0.104 | JLC | 0
D1, D10 | SMCJ15A | bots:D_SMC | yes | SMCJ15A | C438099 | 0.62 | 0.534 | 0.0753 | Bottom | 1 | 4.96 | 4.793 | DIGIKEY | 4.96 | DIGIKEY | 0 | 10
D2, D11 | MUR860J | bots:D_SMC | yes | MUR860J | C169513 | 0.74000 | 0.623 | 0.0656 |  | 1 | 5.92 | 4.696 | DIGIKEY | 5.92 | DIGIKEY | 0 | 10
D3 | 2A 600V | bots:D_SMB | yes | MURS160-E3/52T | C59627 | 0.68000 | 0.53 | 0.1038 |  |  | 5.3 | 5.078 | JLC | 5.078 | JLC | 1 | 2
D4 | LED_red | bots:LED_0805_2012Metric | no | NCD0805R1 | C84256 | 0.39 | 0.216 | 0.0122 |  |  | 2.16 | 0.122 | JLC | 0.122 | JLC | 0
D5 | SMBJ5338B-TP | bots:D_SMB | yes |  |  |  | 0.474 | 0.0833 |  |  | 0 | 4.873 | JLC | 4.873 | JLC | 0
D6, D8, D15 | LED | bots:LED_0805_2012Metric | no | KT-0805G | C2297 | 0.39 | 0.216 | 0.0127 |  |  | 6.48 | 0.381 | JLC | 0.381 | JLC | 0
D7 | LED_blue | bots:LED_0603_1608Metric | no | KT-0603W | C2290 | 0.39 | 0.201 | 0.0096 |  |  | 2.01 | 0.096 | JLC | 0.096 | JLC | 0
D9, D13 | LED | bots:LED_0603_1608Metric | no | 19-213/Y2C-CQ2R2L/3T(CY) | C72038 | 0.39 | 0.201 | 0.0195 |  |  | 4.02 | 0.39 | JLC | 0.39 | JLC | 0
D12 | 3SMBJ5929B-TP | bots:D_SMB |  | 3SMBJ5929B-TP | N/A | 0.61000 | 0.436 | 0.63 | Bottom |  | 4.36 | EMPTY | DIGIKEY | 4.36 | DIGIKEY | 1 | 10
D14 | US1M | bots:D_SMA | no | US1M | C412437 | 0.17 | 0.122 | 0.1038 | Bottom |  | 1.22 | 1.038 | DIGIKEY | 1.22 | DIGIKEY | 1 | 10
F1 | 0501015.WR1 | bots:Fuse_1206_3216Metric | yes | 0501015.WR1 | C410346 | 1.54 | 1.4 | 0.0992 |  |  | 12.32 | 5.032 | JLC | 5.032 | JLC | 1 | 2
J1 | JST_B3B-XH-A | bots:JST_B3B-XH-A |  | B3B-XH-A(LF)(SN) |  | 0.30000 | 0.232 | 0.31 |  | 1 | 0 | EMPTY | DIGIKEY | 0 | DIGIKEY | 0
J2 | USB4145-03-0170-C_REVA2 | bots:GCT_USB4145-03-0170-C_REVA2 |  | USB4145-03-0170-C |  | 1.56000 | 1.314 | 1.61 |  |  | 12.48 | EMPTY | DIGIKEY | 12.48 | DIGIKEY | 1 | 10
J3 | JST_BM04B-GHS-TBT | bots:JST_BM04B-GHS-TBT |  | BM04B-GHS-TBT |  | 0.71000 | 0.606 | 0.31 |  |  | 5.68 | EMPTY | DIGIKEY | 5.68 | DIGIKEY | 0 | 10
J5 | Conn_02x10_Counter_Clockwise | bots:PinHeader_2x10_P2.54mm_Vertical |  | PH2-20-UA |  | 0.37000 | 0.306 |  |  | 1 | 0 | EMPTY | DIGIKEY | 0 | DIGIKEY | 0
Q1, Q4 | BSS138 | bots:SOT95P240X111-3N | no | BSS138 | C7420339 | 0.5 | 0.225 | 0.0128 |  |  | 4.5 | 0.256 | JLC | 0.256 | JLC | 0
Q2 | IRFR3410TRPBF | bots:DPAK-3_ONS | yes | IRFR3410TRPBF | C605020 | 1.44000 | 1.17 | 0.465 |  |  | 0 | 8.69 | DIGIKEY | 0 | DIGIKEY | 0
Q3, Q7 | FGH50T65SQD-F155 | bots:TO-247-3_Horizontal_TabDown | yes | FGH50T65SQD-F155 | C132704 | 6.22000 | 6.22 | 4.0394 |  |  | 0 | 84.828 | DIGIKEY | 0 | DIGIKEY | 0 |  | request submitted | alternate request approved
Q5 | TN2130K1-G | bots:SOT95P240X111-3N |  | TN2130K1-G | C626652 | 0.65000 | 0.65 |  | Bottom |  | 5.2 | EMPTY | DIGIKEY | 5.2 | DIGIKEY | 1 | 10
Q6 | IPD60R3K4CEAUMA1 | bots:DPAK-3_ONS |  | IPD60R3K4CEAUMA1 |  | 0.76000 | 0.653 |  | Bottom |  | 0 | EMPTY | DIGIKEY | 0 | DIGIKEY | 0
R1, R9, R10, R27, R29 | 100k | bots:R_0603_1608Metric | no | 0603WAF1003T5E | C25803 | 0.15 | 0.023 | 0.0009 |  |  | 1.15 | 0.045 | JLC | 0.045 | JLC | 0
R32 | 100k | bots:R_0603_1608Metric | no | 0603WAF1003T5E | C25803 | 0.15 | 0.023 | 0.0009 | Bottom |  | 0.23 | 0.009 | DIGIKEY | 0.23 | DIGIKEY | 1 | 10
R2, R13-R16, R19, R28, R30, R41 | 10k | bots:R_0603_1608Metric | no | 0603WAF1002T5E | C25804 | 0.15 | 0.023 | 0.0008 |  |  | 2.07 | 0.072 | JLC | 0.072 | JLC | 0
R3 | 2.49k | bots:R_0603_1608Metric |  | RMCF0603FT2K49 | C108190 | 0.15 | 0.023 | 0.001 |  |  | 0.23 | EMPTY | DIGIKEY | 0.23 | DIGIKEY | 1 | 10
R4, R42 | 120R | bots:R_0603_1608Metric | no | 0603WAF1200T5E | C22787 | 0.15 | 0.023 | 0.001 |  |  | 0.46 | 0.02 | JLC | 0.02 | JLC | 0
R5 | 48.1k | bots:R_0603_1608Metric |  | 0603WAF4752T5E | C23061 | 0.15 | 0.023 | 0.0009 |  |  | 0.23 | EMPTY | DIGIKEY | 0.23 | DIGIKEY | 1 | 10
R6 | 34.3k | bots:R_0603_1608Metric |  | 0603WAF3402T5E | C23008 | 0.15 | 0.023 | 0.001 |  |  | 0.23 | EMPTY | DIGIKEY | 0.23 | DIGIKEY | 1 | 10
R7 | 8m | bots:R_1206_3216Metric |  | LMJ12MF1P0R008 | C2937389 | 1.21000 | 0.705 | 0.0695 |  |  | 7.05 | EMPTY | DIGIKEY | 7.05 | DIGIKEY | 1 | 10
R8, R43 | 2 | bots:R_0805_2012Metric |  | 0805W8F200KT5E | C17606 | 0.15 | 0.023 | 0.0025 |  | 1 | 0.23 | EMPTY | DIGIKEY | 0.23 | DIGIKEY | 2 | 10
R11, R12, R35, R36 | 5.1k | bots:R_0603_1608Metric | no | 0603WAF5101T5E | C23186 | 0.15 | 0.023 | 0.0009 |  |  | 0.92 | 0.036 | JLC | 0.036 | JLC | 0 |  |  |  | PCB |  | 61.95 |  | PCB economic | 49.64
R17, R18 | 1k | bots:R_0603_1608Metric | no | 0603WAF1001T5E | C21190 | 0.15 | 0.023 | 0.0007 |  |  | 0.46 | 0.014 | JLC | 0.014 | JLC | 0 |  |  |  | Eng Fee | 32.3 |  |  | 32.35
R20, R21 | 33R | bots:R_0603_1608Metric | no | 0603WAF330JT5E | C23140 | 0.15 | 0.023 | 0.0009 |  |  | 0.46 | 0.018 | JLC | 0.018 | JLC | 0 |  |  |  | Colour | 10.23 |  |  | 0
R22 | R_200k | bots:R_0603_1608Metric | no | 0603WAF2003T5E | C25811 | 0.15 | 0.023 | 0.0009 |  |  | 0.23 | 0.009 | JLC | 0.009 | JLC | 0 |  |  |  | Board | 18.84 |  |  | 16.71
R23, R24 | R_470k | bots:R_0603_1608Metric | no | 0603WAF4703T5E | C23178 | 0.15 | 0.023 | 0.0009 |  |  | 0.46 | 0.018 | JLC | 0.018 | JLC | 0 |  |  |  | Confirm | 0.58 |  |  | 0.58
R25, R26 | R_0OHM_JUMPER | bots:R_0603_1608Metric | no | 0603WAF0000T5E | C21189 | 0.15 | 0.023 | 0.001 | Bottom |  | 0.46 | 0.02 | DIGIKEY | 0.46 | DIGIKEY | 2 | 20
R31 | 270k | bots:R_0603_1608Metric | no | 0603WAF2703T5E | C22965 | 0.15 | 0.023 | 0.0009 | Bottom |  | 0.23 | 0.009 | DIGIKEY | 0.23 | DIGIKEY | 1 | 10 |  |  | PCBA
R33, R34 | 5.1M | bots:R_0603_1608Metric | no | 0603WAF5104T5E | C13320 | 0.15 | 0.033 | 0.0013 | Bottom |  | 0.66 | 0.026 | DIGIKEY | 0.66 | DIGIKEY | 2 | 20 |  |  | setup | $33.65 |  |  | $10.78
R37 | 1.2k | bots:R_0603_1608Metric | no | 0603WAF1201T5E | C22765 | 0.15 | 0.023 | 0.001 |  |  | 0.23 | 0.01 | JLC | 0.01 | JLC | 0 |  |  |  | stencil | $10.58 |  |  | $2.02
R38, R47 | 330 | bots:R_0603_1608Metric | no | 0603WAF3300T5E | C23138 | 0.15 | 0.023 | 0.0009 |  |  | 0.46 | 0.018 | JLC | 0.018 | JLC | 0 |  |  |  | components | $66.88 |  |  | $69.26
R39, R40, R45 | 150R | bots:R_0603_1608Metric | no | 0603WAF1500T5E | C22808 | 0.15 | 0.023 | 0.0009 |  |  | 0.69 | 0.027 | JLC | 0.027 | JLC | 0 |  |  |  | feeders | $50.76 |  | <- feeders loading fee 2.02 per component for standard (if we choose black it has to be standard not economic) | $30.96
R44 | 2k 35W | bots:TO-220-2_Horizontal_TabDown |  | PWR220T-35-2001J |  | 4.80000 | 4.067 |  | Bottom |  | 38.4 | EMPTY | DIGIKEY | 38.4 | DIGIKEY | 2 | 10 | request approved
R46 | 820R_3W | bots:R_2512_6332Metric |  | 3522820RJT |  | 1.40000 | 0.83 |  | Bottom |  | 8.3 | EMPTY | DIGIKEY | 8.3 | DIGIKEY | 1 | 10 |  |  | smt | $5.68 |  |  | $5.30
T1 | DA2034 | bots:DA2034-ALD_COC |  | DA2034-ALD |  | 13.35 | 13.35 |  |  |  | 0 | EMPTY | DIGIKEY | 0 | DIGIKEY | 0 |  | request approved |  | confirm | $0.58 |  |  | $0.58
U1 | RPI2040 | bots:QFN56_7X7_RPI | yes | RP2040 | C2040 | 1.06 | 1.06 | 0.897 |  |  | 8.48 | 13.01 | JLC | 13.01 | JLC | 0 |  |  |  | packaging | $0.65 |  |  | $0.00
U2 | MCP14A0454-E/SN | bots:SOIC-8_3.9x4.9mm_P1.27mm |  | MCP14A0454-E/SN |  | 2.34000 | 2.34 |  |  |  | 16.38 | EMPTY | DIGIKEY | 16.38 | DIGIKEY | 0 | 7 |  |  |  |  |  |  |  | 220
U3 | AP2114HA-3.3TRG1 | Package_TO_SOT_SMD:SOT-223-3_TabPin2 | yes | AP2114HA-3.3TRG1 | C460314 | 0.56000 | 0.456 | 0.1439 |  |  | 4.48 | 5.479 | DIGIKEY | 4.48 | DIGIKEY | 1 | 10 |  |  | shipping | $60.88 |  |  | $60.88 | 281.14
U4 | LT3750 | bots:MSOP-10_3x3mm_P0.5mm | yes | LT3750AEMS#TRPBF | C84289 | 14.94000 | 13.505 | 15.73 |  |  | 0 | 161.34 | DIGIKEY | 0 | DIGIKEY | 0 |  | request approved |  | Total | $291.61 |  |  | $229.42 | $281.14
U5 | W25Q16JVSNIQ | bots:SOIC-8_3.9x4.9mm_P1.27mm | yes | W25Q16JVSNIQ | C2456211 | 2.54000 | 2.31 | 0.299 |  |  | 20.32 | 7.03 | JLC | 7.03 | JLC | 1 |  |  |  | import tax | $34.99 |  |  | $27.53 | $33.74
U6 | SN65HVD233 | bots:SOIC-8_3.9x4.9mm_P1.27mm |  | SN65HVD233 | C61643 | 4.82 | 4.325 | 1.0455 |  |  | 0 | EMPTY | DIGIKEY | 0 | DIGIKEY | 0 |  | already have on hand |  | flat fee | $17.50 |  |  | $17.50 | $17.50
U7 | MCP2515-xST | bots:TSSOP-20_4.4x6.5mm_P0.65mm | yes | MCP2515T-I/ST | C185941 | 4.03000 | 4.03 | 1.2541 |  |  | 32.24 | 16.581 | JLC | 16.581 | JLC | 0 |  |  |  | TOTAL | $344.10 |  |  | $274.45 | $332.38 | <- real total
U9, U10 | PTS647SM38SMTR2LFS | bots:SW_PTS647SM38SMTR2LFS_CNK | yes | PTS647SM38SMTR2LFS | C2689502 | 0.30000 | 0.287 | 0.1118 |  |  | 4.592 | 6.276 | DIGIKEY | 4.592 | DIGIKEY | 2 | 20
Y1 | ABM3-12.000MHZ-D2Y-T | bots:ABM3 | yes | ABM3-12.000MHZ-D2Y-T | C148313 | 0.85000 | 0.705 | 0.7616 |  |  | 6.8 | 11.656 | DIGIKEY | 6.8 | DIGIKEY | 1 | 10 |  |  |  | $564.22 |  |  | $494.56 | $552.49
Y2 | ABM3-8.000MHZ-D2Y-T | bots:ABM3 | yes | ABM3-8.000MHZ-D2Y-T | C144380 | 0.86000 | 0.715 | 0.2279 |  |  | 6.88 | 6.319 | DIGIKEY | 6.88 | DIGIKEY | 0 | 10 | 30 |  | per board | $56.42 |  |  | $49.46 | $55.25
D16,D17,D18 | CUS08F30,H3F | bots:D_SOD-323_HandSoldering | yes | CUS08F30,H3F | C150183 | 0.0612 | 0.45 | 0.312 |  |  | 10.8 | 13.4 | DIGIKEY | 10.8 | DIGIKEY | 3 | 30
 |  |  |  |  |  |  |  |  |  |  |  |  |  |  | 30 |  |  | 304
 |  |  |  |  |  |  |  |  |  |  |  | TOTAL |  | 303.701 | 106.99392 |  |  | 220.112 | 168.03584
 |  |  |  |  |  |  |  |  |  |  |  | Board Cost |  |  | JLC |  |  | Digikey + mouser
 |  |  |  |  |  |  |  |  |  |  |  |  |  |  | some of these components are in USD I think
 |  |  |  |  |  |  |  |  |  |  |  |  |  | 70.08 |  |  |  | components to solder by hand per board
 |  |  |  |  |  |  |  |  |  |  |  |  |  |  |  |  |  | 38
 |  |  |  |  |  |  |  |  |  |  |  |  |  |  |  | 60

Sheet: POWER_BOARD (TDP COST)
Reference | Value | Footprint | JLC Extended | MPN | JLC Part # | Digikey cost 1 unit | Digikey Cost 10 units | JLC Cost | Layer | DNP QTY | Qty per board | QTY after DNP | QTY Have | QTY need if Digikey | QTY digikey order | QTY to solder digikey | QTY *10 + spare for JLC | Digikey Cost (total) | JLC Cost with Extended part fee (total) | Override | Lowest Cost (Digikey vs JLC) |  | QTY digikey order | Ordered?
C1, C2 | 25SVPF100M | bots:CAP_25SVPF100M | yes | 25SVPF100M | C136279 | 1.97000 | 1.471 | 1.06305 |  |  | 2 | 2 |  | 20 | 0 | 0 | 20 | 29.42 | 25.301 | JLC | 25.301 | JLC | 0
C3, C4, C8 | 22u_1206 | bots:C_1206_3216Metric | no | CL31A226KAHNNNE | C12891 | 0.51000 | 0.338 | 0.0645 |  |  | 3 | 3 |  | 30 | 0 | 24 | 30 | 10.14 | 1.935 | JLC | 1.935 | JLC | 0
C5, C6 | 1000u | bots:CP_Radial_Horizontal_D25.4mm_H45mm |  | ESMQ251VSN102MQ45S |  | 8.76000 | 7.53 |  |  |  | 2 | 2 |  | 16 | 16 | 16 | 20 | 120.48 | EMPTY | DIGIKEY | 120.48 | DIGIKEY | 0 |  | request submitted
C7 | 100p | bots:C_0603_1608Metric | no | CL10C101JB8NNNC | C14858 | 0.14000 | 0.037 | 0.0026 |  |  | 1 | 1 |  | 10 | 0 | 8 | 10 | 0.37 | 0.026 | JLC | 0.026 | JLC | 1
C9, C13-C21, C26, C32-C34, C38 | 0.1u | bots:C_0603_1608Metric | no | CC0603KRX7R9BB104 | C14663 | 0.14000 | 0.0326 | 0.0021 |  |  | 15 | 15 |  | 150 | 0 | 120 | 150 | 4.89 | 0.315 | JLC | 0.315 | JLC | 0
C10, C39 | 1500p | bots:C_0805_2012Metric | yes | C2012C0G2A152JT000N | C342996 | 0.23000 | 0.156 | 0.0396 |  | 1 | 2 | 1 |  | 10 | 10 | 8 | 10 | 1.56 | 4.436 | DIGIKEY | 1.56 | DIGIKEY | 0 | 10
C11, C12, C37, C40 | 10u | bots:C_0805_2012Metric | no | GRM21BR61H106KE43L | C440198 | 0.48000 | 0.317 | 0.0645 |  |  | 4 | 4 |  | 40 | 0 | 32 | 40 | 12.68 | 2.58 | JLC | 2.58 | JLC | 0
C22, C23, C35 | 1u | bots:C_0603_1608Metric | no | CL10A105KB8NNNC | C15849 | 0.20000 | 0.132 | 0.0046 |  |  | 3 | 3 |  | 30 | 0 | 24 | 30 | 3.96 | 0.138 | JLC | 0.138 | JLC | 0
C24, C25 | 27p | bots:C_0603_1608Metric | no | CC0603JRNPO9BN270 | C107045 | 0.14000 | 0.047 | 0.0027 |  |  | 2 | 2 |  | 20 | 0 | 16 | 20 | 0.94 | 0.054 | JLC | 0.054 | JLC | 0
C27 | 0.22u_0805 | bots:C_0805_2012Metric | no | CL21B224KBFNNNE | C5378 | 0.14000 | 0.064 | 0.0103 | Bottom |  | 1 | 1 |  | 10 | 10 | 8 | 10 | 0.64 | 0.103 | DIGIKEY | 0.64 | DIGIKEY | 1 | 10
C28 | 0.1u_600V | bots:C_1210_3225Metric | yes | C1210C104KBRAC7800 | C2902776 | 0.61 | 0.408 | 0.3623 |  |  | 1 | 1 |  | 10 | 10 | 8 | 10 | 4.08 | 7.663 | DIGIKEY | 4.08 | DIGIKEY | 0 | 10
C30, C31 | 22p | bots:C_0603_1608Metric | no | CL10C220JB8NNNC | C1653 | 0.14000 | 0.058 | 0.0052 |  |  | 2 | 2 |  | 20 | 0 | 16 | 20 | 1.16 | 0.104 | JLC | 0.104 | JLC | 0
D1, D10 | SMCJ15A | bots:D_SMC | yes | SMCJ15A | C438099 | 0.62 | 0.534 | 0.0753 | Bottom | 1 | 2 | 1 |  | 8 | 8 | 8 | 10 | 4.96 | 4.793 | DIGIKEY | 4.96 | DIGIKEY | 0 | 10
D2, D11 | MUR860J | bots:D_SMC | yes | MUR860J | C169513 | 0.74000 | 0.623 | 0.0656 |  | 1 | 2 | 1 |  | 8 | 8 | 8 | 10 | 5.92 | 4.696 | DIGIKEY | 5.92 | DIGIKEY | 0 | 10
D3 | 2A 600V | bots:D_SMB | yes | MURS160-E3/52T | C59627 | 0.68000 | 0.53 | 0.1038 |  |  | 1 | 1 |  | 10 | 0 | 8 | 10 | 5.3 | 5.078 | JLC | 5.078 | JLC | 1 | 2
D4 | LED_red | bots:LED_0805_2012Metric | no | NCD0805R1 | C84256 | 0.39 | 0.216 | 0.0122 |  |  | 1 | 1 |  | 10 | 0 | 8 | 10 | 2.16 | 0.122 | JLC | 0.122 | JLC | 0
D5 | B220 | bots:D_SMB | yes | B220-13-F | C110480 | 0.68000 | 0.474 | 0.0833 |  |  | 1 | 1 |  | 10 | 0 | 8 | 10 | 4.74 | 4.873 | JLC | 4.873 | JLC | 0
D6, D8, D15 | LED | bots:LED_0805_2012Metric | no | KT-0805G | C2297 | 0.39 | 0.216 | 0.0127 |  |  | 3 | 3 |  | 30 | 0 | 24 | 30 | 6.48 | 0.381 | JLC | 0.381 | JLC | 0
D7 | LED_blue | bots:LED_0603_1608Metric | no | KT-0603W | C2290 | 0.39 | 0.201 | 0.0096 |  |  | 1 | 1 |  | 10 | 0 | 8 | 10 | 2.01 | 0.096 | JLC | 0.096 | JLC | 0
D9, D13 | LED | bots:LED_0603_1608Metric | no | 19-213/Y2C-CQ2R2L/3T(CY) | C72038 | 0.39 | 0.201 | 0.0195 |  |  | 2 | 2 |  | 20 | 0 | 16 | 20 | 4.02 | 0.39 | JLC | 0.39 | JLC | 0
D12 | 3SMBJ5929B-TP | bots:D_SMB |  | 3SMBJ5929B-TP | N/A | 0.61000 | 0.436 | 0.63 | Bottom |  | 1 | 1 |  | 10 | 10 | 8 | 10 | 4.36 | EMPTY | DIGIKEY | 4.36 | DIGIKEY | 1 | 10
D14 | US1M | bots:D_SMA | no | US1M | C412437 | 0.17 | 0.122 | 0.1038 | Bottom |  | 1 | 1 |  | 10 | 10 | 8 | 10 | 1.22 | 1.038 | DIGIKEY | 1.22 | DIGIKEY | 1 | 10
F1 | 0501015.WR1 | bots:Fuse_1206_3216Metric | yes | 0501015.WR1 | C410346 | 1.54 | 1.4 | 0.0992 |  |  | 1 | 1 |  | 8 | 0 | 8 | 10 | 12.32 | 5.032 | JLC | 5.032 | JLC | 1 | 2
J1 | JST_B3B-XH-A | bots:JST_B3B-XH-A |  | B3B-XH-A(LF)(SN) |  | 0.30000 | 0.232 | 0.31 |  | 1 | 1 | 0 |  | 0 | 0 | 0 | 0 | 0 | EMPTY | DIGIKEY | 0 | DIGIKEY | 0
J2 | USB4145-03-0170-C_REVA2 | bots:GCT_USB4145-03-0170-C_REVA2 |  | USB4145-03-0170-C |  | 1.56000 | 1.314 | 1.61 |  |  | 1 | 1 |  | 8 | 8 | 8 | 10 | 12.48 | EMPTY | DIGIKEY | 12.48 | DIGIKEY | 1 | 10
J3 | JST_BM04B-GHS-TBT | bots:JST_BM04B-GHS-TBT |  | BM04B-GHS-TBT |  | 0.71000 | 0.606 | 0.31 |  |  | 1 | 1 |  | 8 | 8 | 8 | 10 | 5.68 | EMPTY | DIGIKEY | 5.68 | DIGIKEY | 0 | 10
J5 | Conn_02x10_Counter_Clockwise | bots:PinHeader_2x10_P2.54mm_Vertical |  | PH2-20-UA |  | 0.37000 | 0.306 |  |  | 1 | 1 | 0 |  | 0 | 0 | 0 | 0 | 0 | EMPTY | DIGIKEY | 0 | DIGIKEY | 0
Q1, Q4 | BSS138 | bots:SOT95P240X111-3N | no | BSS138 | C7420339 | 0.5 | 0.225 | 0.0128 |  |  | 2 | 2 |  | 20 | 0 | 16 | 20 | 4.5 | 0.256 | JLC | 0.256 | JLC | 0
Q2 | IRFR3410TRPBF | bots:DPAK-3_ONS | yes | IRFR3410TRPBF | C605020 | 1.44000 | 1.17 | 0.465 |  |  | 1 | 1 |  | 8 | 8 | 8 | 10 | 11.52 | 8.69 | DIGIKEY | 11.52 | DIGIKEY | 0
Q3, Q7 | FGH50T65SQD-F155 | bots:TO-247-3_Horizontal_TabDown | yes | FGH50T65SQD-F155 | C132704 | 6.22000 | 6.22 | 4.0394 |  |  | 2 | 2 |  | 16 | 16 | 16 | 20 | 99.52 | 84.828 | DIGIKEY | 99.52 | DIGIKEY | 0 |  | request submitted | alternate request approved
Q5 | TN2130K1-G | bots:SOT95P240X111-3N |  | TN2130K1-G | C626652 | 0.65000 | 0.65 |  | Bottom |  | 1 | 1 |  | 8 | 8 | 8 | 10 | 5.2 | EMPTY | DIGIKEY | 5.2 | DIGIKEY | 1 | 10
Q6 | IPD60R3K4CEAUMA1 | bots:DPAK-3_ONS |  | IPD60R3K4CEAUMA1 |  | 0.76000 | 0.653 |  | Bottom |  | 1 | 1 |  | 8 | 8 | 8 | 10 | 6.08 | EMPTY | DIGIKEY | 6.08 | DIGIKEY | 0
R1, R9, R10, R27, R29 | 100k | bots:R_0603_1608Metric | no | 0603WAF1003T5E | C25803 | 0.15 | 0.023 | 0.0009 |  |  | 5 | 5 |  | 50 | 0 | 40 | 50 | 1.15 | 0.045 | JLC | 0.045 | JLC | 0
R32 | 100k | bots:R_0603_1608Metric | no | 0603WAF1003T5E | C25803 | 0.15 | 0.023 | 0.0009 | Bottom |  | 1 | 1 |  | 10 | 10 | 8 | 10 | 0.23 | 0.009 | DIGIKEY | 0.23 | DIGIKEY | 1 | 10
R2, R13-R16, R19, R28, R30, R41 | 10k | bots:R_0603_1608Metric | no | 0603WAF1002T5E | C25804 | 0.15 | 0.023 | 0.0008 |  |  | 9 | 9 |  | 90 | 0 | 72 | 90 | 2.07 | 0.072 | JLC | 0.072 | JLC | 0
R3 | 2.49k | bots:R_0603_1608Metric |  | RMCF0603FT2K49 | C108190 | 0.15 | 0.023 | 0.001 |  |  | 1 | 1 |  | 10 | 10 | 8 | 10 | 0.23 | EMPTY | DIGIKEY | 0.23 | DIGIKEY | 1 | 10
R4, R42 | 120R | bots:R_0603_1608Metric | no | 0603WAF1200T5E | C22787 | 0.15 | 0.023 | 0.001 |  |  | 2 | 2 |  | 20 | 0 | 16 | 20 | 0.46 | 0.02 | JLC | 0.02 | JLC | 0
R5 | 48.1k | bots:R_0603_1608Metric |  | 0603WAF4752T5E | C23061 | 0.15 | 0.023 | 0.0009 |  |  | 1 | 1 |  | 10 | 10 | 8 | 10 | 0.23 | EMPTY | DIGIKEY | 0.23 | DIGIKEY | 1 | 10
R6 | 34.3k | bots:R_0603_1608Metric |  | 0603WAF3402T5E | C23008 | 0.15 | 0.023 | 0.001 |  |  | 1 | 1 |  | 10 | 10 | 8 | 10 | 0.23 | EMPTY | DIGIKEY | 0.23 | DIGIKEY | 1 | 10
R7 | 8m | bots:R_1206_3216Metric |  | PA1206FRF470R008Z | C326567 | 1.21000 | 0.705 | 0.0695 |  |  | 1 | 1 |  | 10 | 10 | 8 | 10 | 7.05 | EMPTY | DIGIKEY | 7.05 | DIGIKEY | 1 | 10
R8, R43 | 2 | bots:R_0805_2012Metric |  | 0805W8F200KT5E | C17606 | 0.15 | 0.023 | 0.0025 |  | 1 | 2 | 1 |  | 10 | 10 | 8 | 10 | 0.23 | EMPTY | DIGIKEY | 0.23 | DIGIKEY | 2 | 10
R11, R12, R35, R36 | 5.1k | bots:R_0603_1608Metric | no | 0603WAF5101T5E | C23186 | 0.15 | 0.023 | 0.0009 |  |  | 4 | 4 |  | 40 | 0 | 32 | 40 | 0.92 | 0.036 | JLC | 0.036 | JLC | 0 |  |  |  | PCB |  | 61.95
R17, R18 | 1k | bots:R_0603_1608Metric | no | 0603WAF1001T5E | C21190 | 0.15 | 0.023 | 0.0007 |  |  | 2 | 2 |  | 20 | 0 | 16 | 20 | 0.46 | 0.014 | JLC | 0.014 | JLC | 0 |  |  |  | Eng Fee | 32.3
R20, R21 | 33R | bots:R_0603_1608Metric | no | 0603WAF330JT5E | C23140 | 0.15 | 0.023 | 0.0009 |  |  | 2 | 2 |  | 20 | 0 | 16 | 20 | 0.46 | 0.018 | JLC | 0.018 | JLC | 0 |  |  |  | Colour | 10.23
R22 | R_200k | bots:R_0603_1608Metric | no | 0603WAF2003T5E | C25811 | 0.15 | 0.023 | 0.0009 |  |  | 1 | 1 |  | 10 | 0 | 8 | 10 | 0.23 | 0.009 | JLC | 0.009 | JLC | 0 |  |  |  | Board | 18.84
R23, R24 | R_470k | bots:R_0603_1608Metric | no | 0603WAF4703T5E | C23178 | 0.15 | 0.023 | 0.0009 |  |  | 2 | 2 |  | 20 | 0 | 16 | 20 | 0.46 | 0.018 | JLC | 0.018 | JLC | 0 |  |  |  | Confirm | 0.58
R25, R26 | R_0OHM_JUMPER | bots:R_0603_1608Metric | no | 0603WAF0000T5E | C21189 | 0.15 | 0.023 | 0.001 | Bottom |  | 2 | 2 |  | 20 | 20 | 16 | 20 | 0.46 | 0.02 | DIGIKEY | 0.46 | DIGIKEY | 2 | 20
R31 | 270k | bots:R_0603_1608Metric | no | 0603WAF2703T5E | C22965 | 0.15 | 0.023 | 0.0009 | Bottom |  | 1 | 1 |  | 10 | 10 | 8 | 10 | 0.23 | 0.009 | DIGIKEY | 0.23 | DIGIKEY | 1 | 10 |  |  | PCBA
R33, R34 | 5.1M | bots:R_0603_1608Metric | no | 0603WAF5104T5E | C13320 | 0.15 | 0.033 | 0.0013 | Bottom |  | 2 | 2 |  | 20 | 20 | 16 | 20 | 0.66 | 0.026 | DIGIKEY | 0.66 | DIGIKEY | 2 | 20 |  |  | setup | $33.65
R37 | 1.2k | bots:R_0603_1608Metric | no | 0603WAF1201T5E | C22765 | 0.15 | 0.023 | 0.001 |  |  | 1 | 1 |  | 10 | 0 | 8 | 10 | 0.23 | 0.01 | JLC | 0.01 | JLC | 0 |  |  |  | stencil | $10.58
R38, R47 | 330 | bots:R_0603_1608Metric | no | 0603WAF3300T5E | C23138 | 0.15 | 0.023 | 0.0009 |  |  | 2 | 2 |  | 20 | 0 | 16 | 20 | 0.46 | 0.018 | JLC | 0.018 | JLC | 0 |  |  |  | components | $66.88
R39, R40, R45 | 150R | bots:R_0603_1608Metric | no | 0603WAF1500T5E | C22808 | 0.15 | 0.023 | 0.0009 |  |  | 3 | 3 |  | 30 | 0 | 24 | 30 | 0.69 | 0.027 | JLC | 0.027 | JLC | 0 |  |  |  | feeders | $50.76 |  | <- feeders loading fee 2.02 per component for standard (if we choose black it has to be standard not economic)
R44 | 2k 35W | bots:TO-220-2_Horizontal_TabDown |  | PWR220T-35-2001J |  | 4.80000 | 4.067 |  | Bottom |  | 1 | 1 |  | 8 | 8 | 8 | 10 | 38.4 | EMPTY | DIGIKEY | 38.4 | DIGIKEY | 2 | 10 | request approved
R46 | 820R_3W | bots:R_2512_6332Metric |  | 3522820RJT |  | 1.40000 | 0.83 |  | Bottom |  | 1 | 1 |  | 10 | 10 | 8 | 10 | 8.3 | EMPTY | DIGIKEY | 8.3 | DIGIKEY | 1 | 10 |  |  | smt | $5.68
T1 | DA2034 | bots:DA2034-ALD_COC |  | DA2034-ALD |  | 13.35 | 13.35 |  |  |  | 1 | 1 |  | 8 | 8 | 8 | 10 | 106.8 | EMPTY | DIGIKEY | 106.8 | DIGIKEY | 0 |  | request approved |  | confirm | $0.58
U1 | RPI2040 | bots:QFN56_7X7_RPI | yes | RP2040 | C2040 | 1.06 | 1.06 | 0.897 |  |  | 1 | 1 |  | 8 | 0 | 8 | 10 | 8.48 | 13.01 | JLC | 13.01 | JLC | 0 |  |  |  | packaging | $0.65
U2 | MCP14A0454-E/SN | bots:SOIC-8_3.9x4.9mm_P1.27mm |  | MCP14A0454-E/SN |  | 2.34000 | 2.34 |  |  |  | 1 | 1 |  | 8 | 8 | 8 | 10 | 18.72 | EMPTY | DIGIKEY | 18.72 | DIGIKEY | 0 | 7 |  |  | shipping | $60.88
U3 | AP2114HA-3.3TRG1 | Package_TO_SOT_SMD:SOT-223-3_TabPin2 | yes | AP2114HA-3.3TRG1 | C460314 | 0.56000 | 0.456 | 0.1439 |  |  | 1 | 1 |  | 8 | 8 | 8 | 10 | 4.48 | 5.479 | DIGIKEY | 4.48 | DIGIKEY | 1 | 10 |  |  | Total | $291.61
U4 | LT3750 | bots:MSOP-10_3x3mm_P0.5mm | yes | LT3750AEMS#TRPBF | C84289 | 14.94000 | 13.505 | 15.73 |  |  | 1 | 1 |  | 8 | 8 | 8 | 10 | 119.52 | 161.34 | DIGIKEY | 119.52 | DIGIKEY | 0 |  | request approved |  | import tax | $34.99
U5 | W25Q16JVSNIQ | bots:SOIC-8_3.9x4.9mm_P1.27mm | yes | W25Q16JVSNIQ | C2456211 | 2.54000 | 2.31 | 0.299 |  |  | 1 | 1 |  | 8 | 0 | 8 | 10 | 20.32 | 7.03 | JLC | 7.03 | JLC | 1 |  |  |  | flat fee | $17.50
U6 | SN65HVD233 | bots:SOIC-8_3.9x4.9mm_P1.27mm |  | SN65HVD233 | C61643 | 4.82 | 4.325 | 1.0455 |  |  | 1 | 1 |  | 8 | 8 | 8 | 10 | 38.56 | EMPTY | DIGIKEY | 38.56 | DIGIKEY | 0 |  | already have on hand |  | TOTAL | $344.10
U7 | MCP2515-xST | bots:TSSOP-20_4.4x6.5mm_P0.65mm | yes | MCP2515T-I/ST | C185941 | 4.03000 | 4.03 | 1.2541 |  |  | 1 | 1 |  | 8 | 0 | 8 | 10 | 32.24 | 16.581 | JLC | 16.581 | JLC | 0
U9, U10 | PTS647SM38SMTR2LFS | bots:SW_PTS647SM38SMTR2LFS_CNK | yes | PTS647SM38SMTR2LFS | C2689502 | 0.30000 | 0.287 | 0.1118 |  |  | 2 | 2 |  | 16 | 16 | 16 | 20 | 4.592 | 6.276 | DIGIKEY | 4.592 | DIGIKEY | 2 | 20 |  |  |  | $1080.06
Y1 | ABM3-12.000MHZ-D2Y-T | bots:ABM3 | yes | ABM3-12.000MHZ-D2Y-T | C148313 | 0.85000 | 0.705 | 0.7616 |  |  | 1 | 1 |  | 8 | 8 | 8 | 10 | 6.8 | 11.656 | DIGIKEY | 6.8 | DIGIKEY | 1 | 10 |  |  | per board | $108.01
Y2 | ABM3-8.000MHZ-D2Y-T | bots:ABM3 | yes | ABM3-8.000MHZ-D2Y-T | C144380 | 0.86000 | 0.715 | 0.2279 |  |  | 1 | 1 |  | 8 | 8 | 8 | 10 | 6.88 | 6.319 | DIGIKEY | 6.88 | DIGIKEY | 0 | 10 | 30
D16,D17,D18 | CUS08F30,H3F | bots:D_SOD-323_HandSoldering | yes | CUS08F30,H3F | C150183 | 0.0612 | 0.45 | 0.312 |  |  | 3 | 3 |  | 24 | 24 | 24 | 30 | 10.8 | 13.4 | DIGIKEY | 10.8 | DIGIKEY | 3 | 30
 |  |  |  |  |  |  |  |  |  |  |  |  |  |  |  |  |  |  |  |  |  | 30 |  |  | 304
 |  |  |  |  |  |  |  |  |  |  |  |  |  |  |  |  |  |  | TOTAL |  | 740.691 | 106.99392 |  |  | 735.95424
 |  |  |  |  |  |  |  |  |  |  |  |  |  |  |  |  |  |  | Board Cost |  |  | JLC |  |  | Digikey + mouser
 |  |  |  |  |  |  |  |  |  |  |  |  |  |  |  |  |  |  |  |  |  | some of these components are in USD I think
 |  |  |  |  |  |  |  |  |  |  |  |  |  |  |  |  |  |  |  |  | 446.32 |  |  |  | components to solder by hand per board
 |  |  |  |  |  |  |  |  |  |  |  |  |  |  |  |  |  |  |  |  |  |  |  |  | 38
