sfunderbots/Electrical/MidPlate/midplate BOM.xlsx

Comment | Designator | Footprint | JLC Part #$ | Digikey Cost | JLC Cost | JLC extended? | QTY per board | QTY *8 + spare | Digikey Cost (total) | JLC Cost with Extended part fee (total) | Lowest Cost (Digikey vs JLC)
25SVPF100M | C16 | PCAP_SVP_E7_PAN |  | 1.471 | 0.7875 | yes | 1 | 10 | 14.71 | 12.50625 | 12.50625 | JLC
UCD1C471MNL1GS | C17 | Digikey has UWT, JLC has the EEE1CA |  | 0.524 | 0.2835 | yes | 1 | 10 | 5.24 | 6.71025 | 5.24 | DIGIKEY
0.47u | C18 | C_1206_3216Metric | C5122253 | 0.143 | 0.0266 | yes | 1 | 10 | 1.43 | 3.7559 | 1.43 | DIGIKEY
SMAZ12-13F | D1 | D_SMA |  | 0.476 | 0.0744 | yes | 1 | 10 | 4.76 | 4.3056 | 4.3056 | JLC
B540C-13-F | D2 | SMC_DIO |  | 0.521 | 0.1023 | yes | 1 | 10 | 5.21 | 4.62645 | 4.62645 | JLC
3568 | F1 | Fuseholder_Blade_Mini_Keystone_3568 |  | 1.68 |  |  | 1 | 10 | 16.8 | EMPTY | 16.8 | DIGIKEY
SMTSO2515CTJ | H1, H2, H3, H4, H5, H6, H7, H8, H9, H10, H11 | SMTSO2515CTJ | dk 24929 | 0.4952 | 0.0501 | yes | 11 | 90 | 44.568 | 8.63535 | 8.63535 | JLC
RA1H1C112R | J3 | SW_RA1H1C112R |  | 1.332 |  |  | 1 | 10 | 13.32 | EMPTY | 13.32 | DIGIKEY
JST_BM04B-GHS-TBT | J9 | JST_BM04B-GHS-TBT |  | 0.606 | 0.1853 | yes | 1 | 10 | 6.06 | 5.58095 | 5.58095 | JLC
JST_B4B-XH-A | J12 | JST_B4B-XH-A |  | 0.269 | 0.0395 | yes | 1 | 10 | 2.69 | 3.90425 | 2.69 | DIGIKEY
PH1-02-UA | JP1 | PinHeader_1x02_P2.54mm_Vertical | C2905434 | 0.042 | 0.0165 | yes | 1 | 10 | 0.42 | 3.63975 | 0.42 | DIGIKEY
SRP1050WA-101M | L1 | SRP1050WA-101M |  | 1.79 |  |  | 1 | 10 | 17.9 | EMPTY | 17.9 | DIGIKEY
MCU60P04-TP | Q1, Q2 | DPAK-3_ONS |  |  |  |  | 2 | 18 | 0 | EMPTY | 0 | DIGIKEY
R_100k | R1, R2 | R_0603_1608Metric |  |  |  | no | 2 | 18 | 0 | EMPTY | 0 | DIGIKEY
LM2576 | U1 | TO-263-5_TabPin3_LM2576 |  |  |  |  | 1 | 10 | 0 | EMPTY | 0 | DIGIKEY
