sfunderbots/Electrical/BasePlate/.step

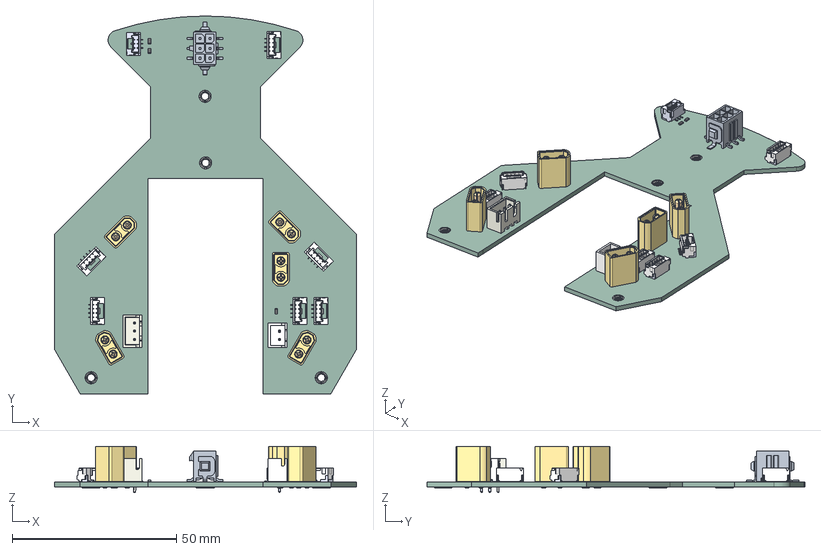
[picture p18: CAD file, 2026-05-28]
BasePlate/.step
91.9 x 115.0 x 14.1 mm
XT30UPB-M x 5
BMxxB-GHS-TBT_04 x 6
JST_B3B_XH_A
R_0603_1608Metric x 3
B2B-XH-A(LF)(SN)
C-3-794636-6
BMxxB-GHS-TBT_03
BasePlate_PCB
