sfunderbots/Electrical/MidPlate/DXF Files/new-cap-cradle-holes.dxf

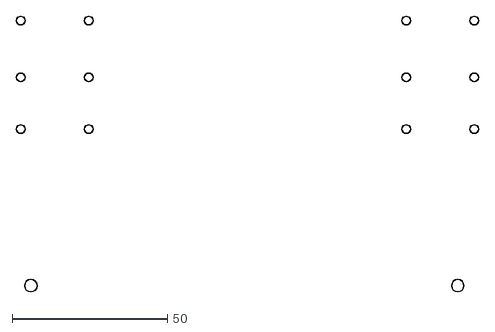
[picture p19: CAD file, 2023-12-29]
MidPlate/DXF Files/new-cap-cradle-holes.dxf
148.9 x 88.8
