sfunderbots/Electrical/PAC5527Driver/3D_Models/Components/Infineon-STP_PG-TDSON-8-33-P-v01_00-EN.stp

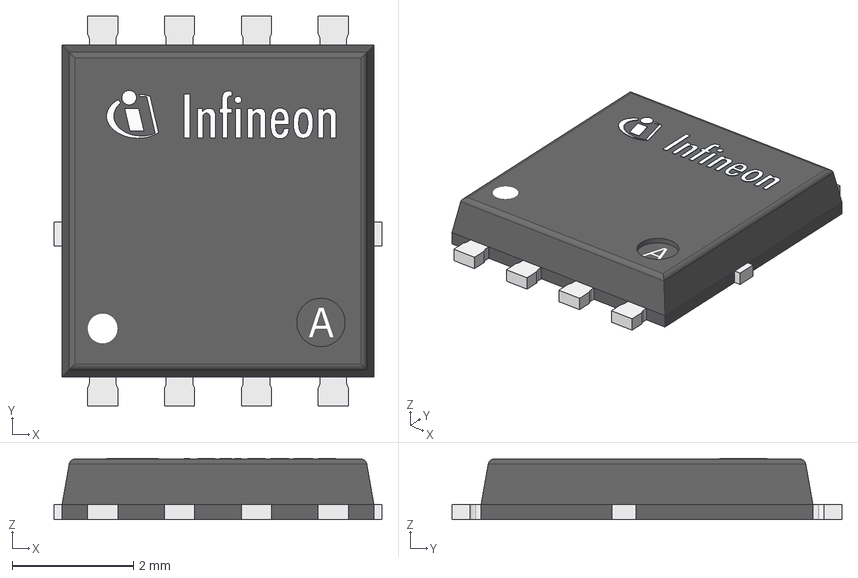
[picture p20: CAD file, 2024-03-15]
PAC5527Driver/3D_Models/Components/Infineon-STP_PG-TDSON-8-33-P-v01_00-EN.stp
5.41 x 6.44 x 1.01 mm
PG-TDSON-8-33_Lower Mold
PG-TDSON-8-33_Upper Mold
PG-TDSON-8-33_Exposed Lead 1
PG-TDSON-8-33_Exposed Lead 2
PG-TDSON-8-33_Exposed Lead 3
PG-TDSON-8-33_Infineon LOGO
