sfunderbots/Electrical/thebots_libraries/3dmodels/LGA-14L_2P5X3X0P86_STM.step

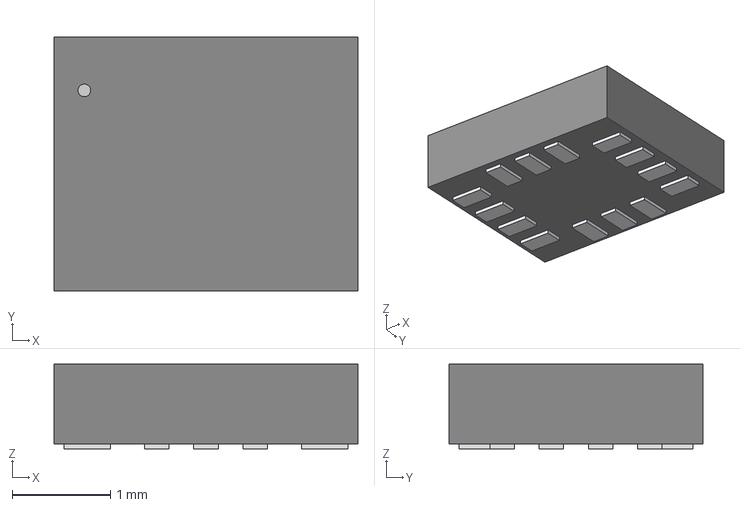
[picture p21: CAD file, 2026-05-16]
thebots_libraries/3dmodels/LGA-14L_2P5X3X0P86_STM.step
3.10 x 2.59 x 0.866 mm
