sfunderbots/Electrical/MidPlate/DXF Files/Diffuser_-_Sketch_8.dxf

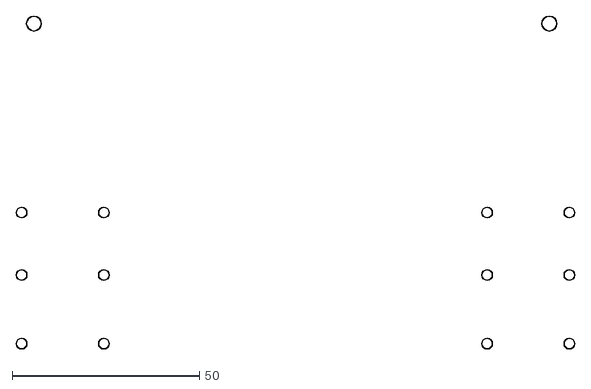
[picture p22: CAD file, 2023-12-29]
MidPlate/DXF Files/Diffuser_-_Sketch_8.dxf
148.9 x 88.8
