sfunderbots/Electrical/PAC5527Driver/3D_Models/Components/PowerPAK SO-8 (S).step

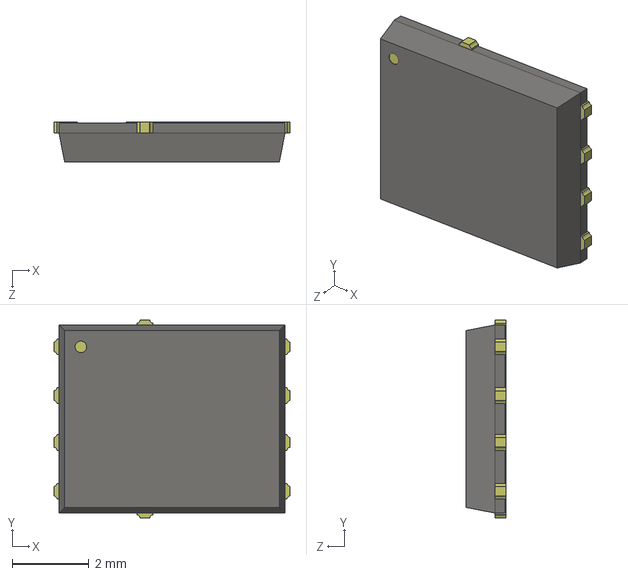
[picture p23: CAD file, 2024-03-15]
PAC5527Driver/3D_Models/Components/PowerPAK SO-8 (S).step
6.15 x 5.15 x 1.04 mm
