sfunderbots/Electrical/thebots_libraries/3dmodels/XT30UPB-M.step

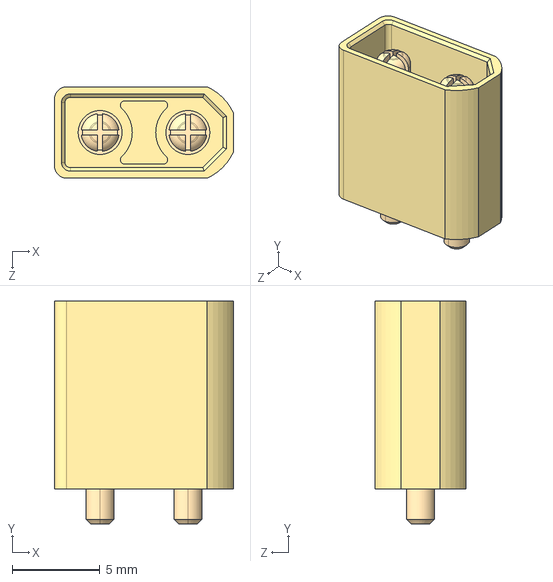
[picture p24: CAD file, 2026-05-11]
thebots_libraries/3dmodels/XT30UPB-M.step
10.2 x 12.7 x 5.20 mm
