sfunderbots/Electrical/MidPlate/DXF Files/Diffuser_-_Sketch_7_1.dxf

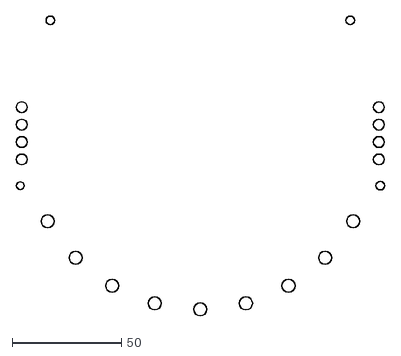
[picture p25: CAD file, 2023-12-29]
MidPlate/DXF Files/Diffuser_-_Sketch_7_1.dxf
168.9 x 137.6
