sfunderbots/Electrical/PAC5527Driver/3D_Models/Components/User Library-QFN-16_3x3.STEP

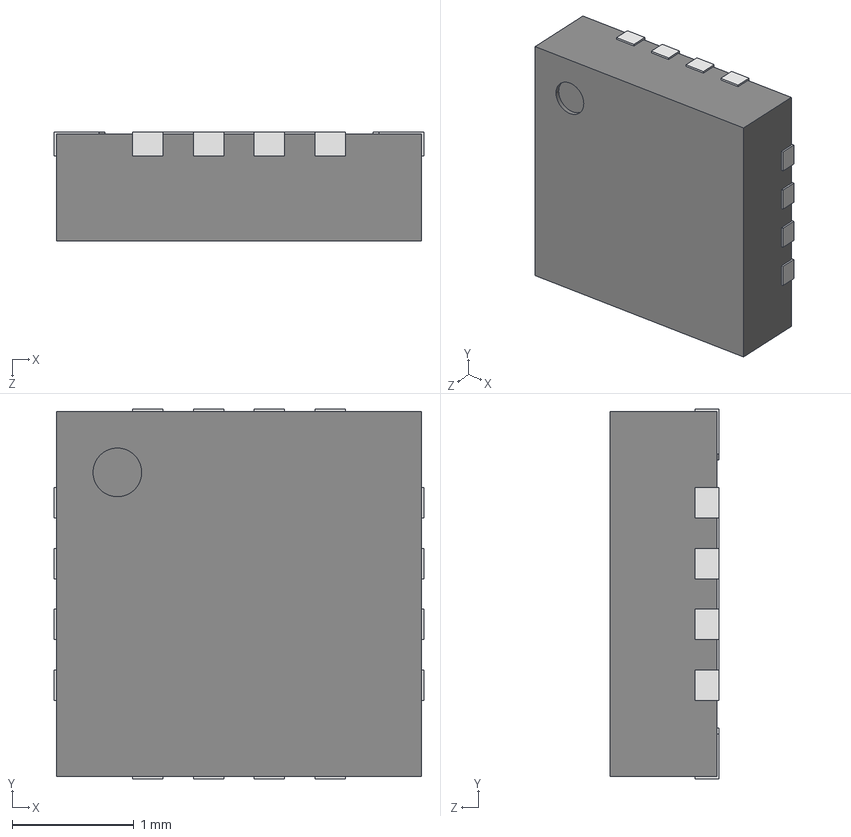
[picture p26: CAD file, 2024-03-15]
PAC5527Driver/3D_Models/Components/User Library-QFN-16_3x3.STEP
3.04 x 3.04 x 0.9 mm
