sfunderbots/Electrical/thebots_libraries/3dmodels/S4B-PH-SM4-TB.step

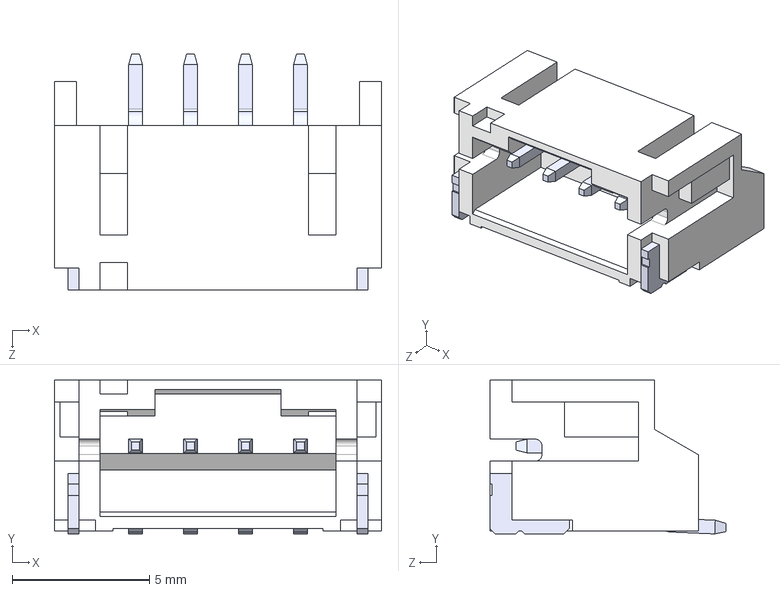
[picture p27: CAD file, 2026-05-11]
thebots_libraries/3dmodels/S4B-PH-SM4-TB.step
11.9 x 5.60 x 8.60 mm
