sfunderbots/Electrical/MidPlate/DXF Files/holeplacements.dxf

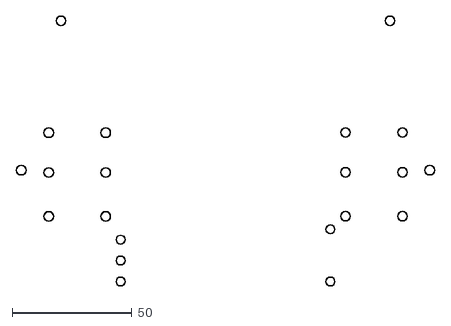
[picture p28: CAD file, 2023-12-14]
MidPlate/DXF Files/holeplacements.dxf
174.7 x 112.7
