sfunderbots/Electrical/PAC5527Driver/3D_Models/Components/20PS-JMDSS-G-1-TF.STEP

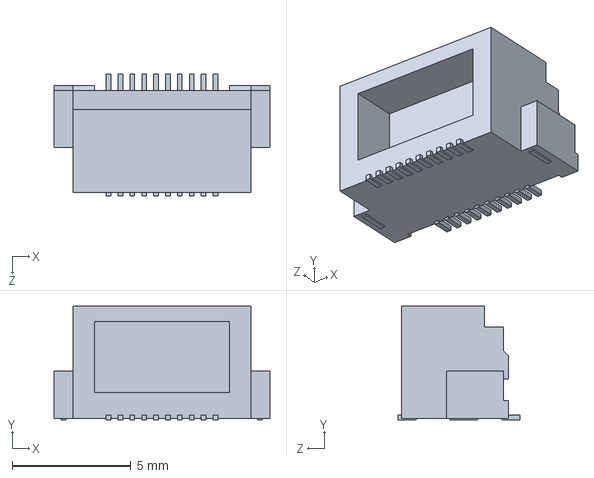
[picture p29: CAD file, 2023-03-27]
PAC5527Driver/3D_Models/Components/20PS-JMDSS-G-1-TF.STEP
9.10 x 4.80 x 5.15 mm
