sfunderbots/Electrical/thebots_libraries/3dmodels/JST_SH_BM04B-SRSS-TB_1x04-1MP_P1.00mm_Vertical.step

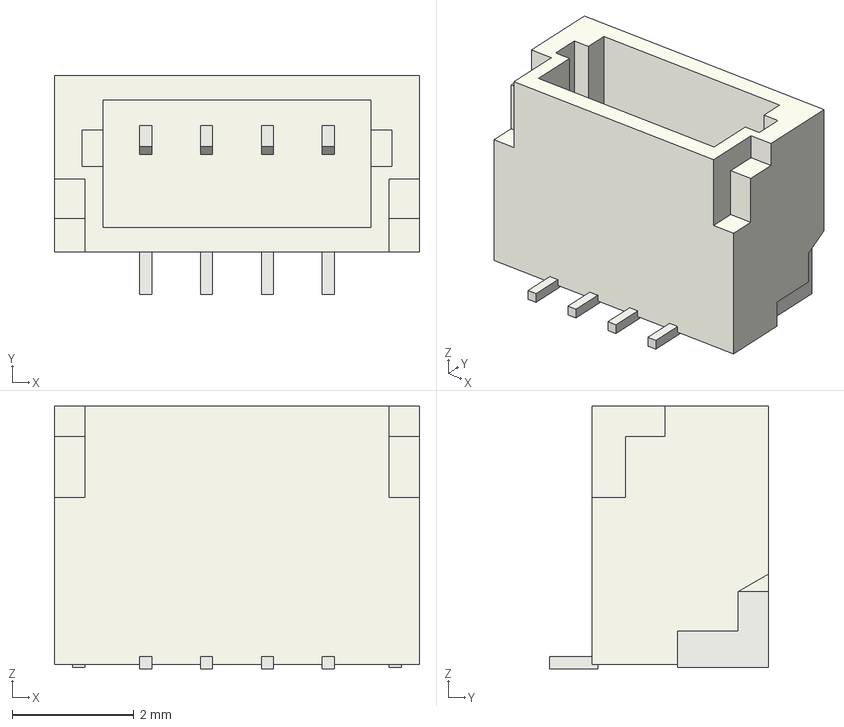
[picture p30: CAD file, 2026-04-26]
thebots_libraries/3dmodels/JST_SH_BM04B-SRSS-TB_1x04-1MP_P1.00mm_Vertical.step
6.00 x 3.60 x 4.32 mm
