sfunderbots/Electrical/MidPlate/DXF Files/rpi-holes.dxf

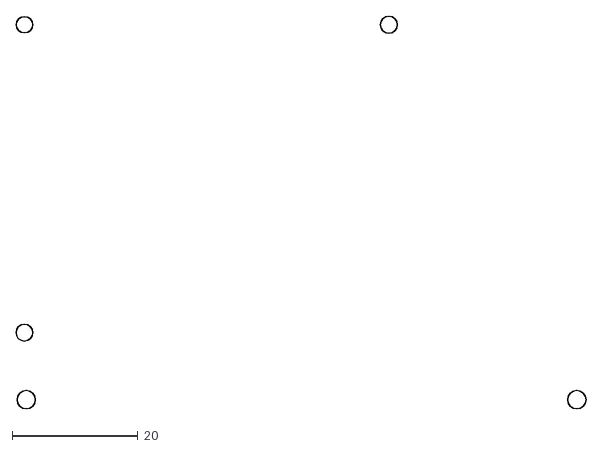
[picture p31: CAD file, 2023-12-11]
MidPlate/DXF Files/rpi-holes.dxf
90.7 x 62.5
