sfunderbots/Electrical/PAC5527Driver/3D_Models/Components/20P-JMDSS-G-1-TF.STEP

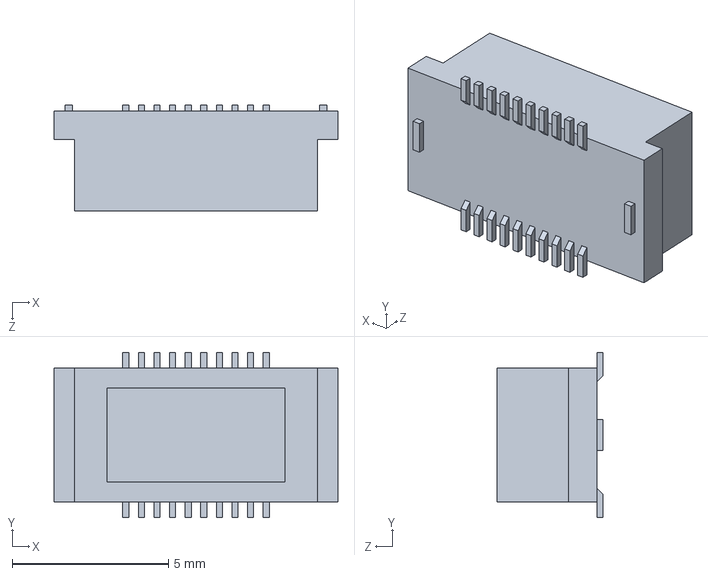
[picture p32: CAD file, 2023-03-27]
PAC5527Driver/3D_Models/Components/20P-JMDSS-G-1-TF.STEP
9.10 x 5.30 x 3.40 mm
