sfunderbots/Electrical/thebots_libraries/3dmodels/JST_GH_BM04B-GHS-TBT_1x04-1MP_P1.25mm_Vertical.step

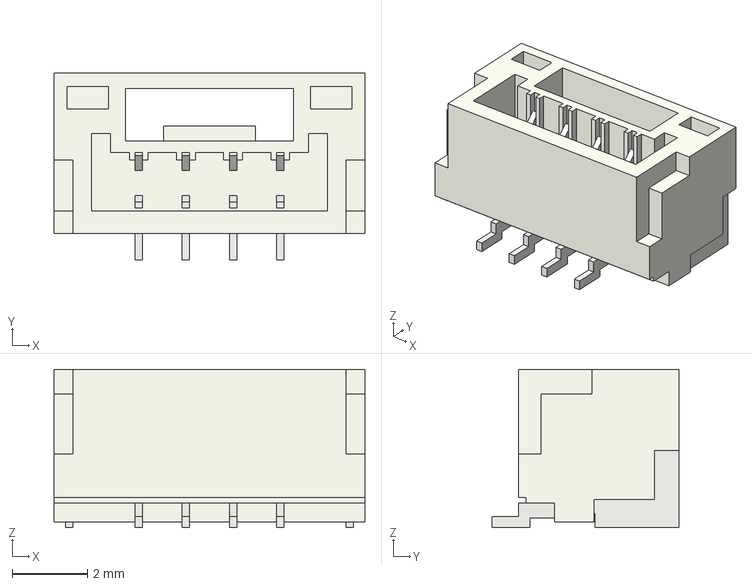
[picture p33: CAD file, 2026-04-26]
thebots_libraries/3dmodels/JST_GH_BM04B-GHS-TBT_1x04-1MP_P1.25mm_Vertical.step
8.25 x 4.95 x 4.20 mm
