sfunderbots/Electrical/MidPlate/DXF Files/midplate.dxf

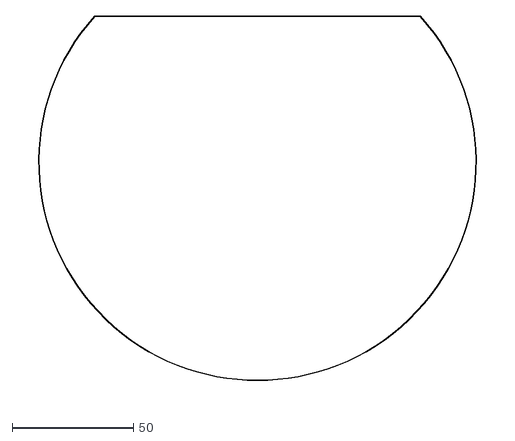
[picture p34: CAD file, 2023-12-04]
MidPlate/DXF Files/midplate.dxf
198.7 x 158.4
