sfunderbots/Electrical/PAC5527Driver/3D_Models/Components/AVX-20-9159-006-101-916.STEP

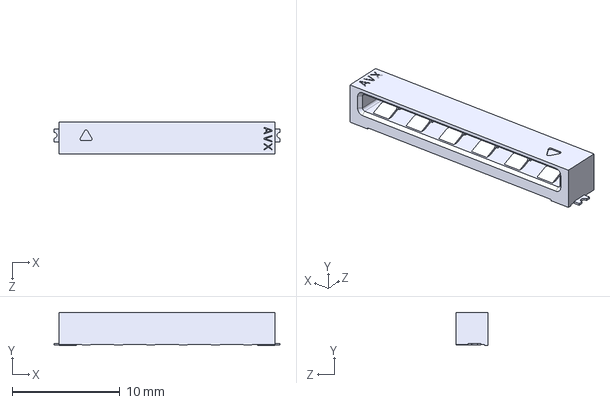
[picture p35: CAD file, 2023-03-27]
PAC5527Driver/3D_Models/Components/AVX-20-9159-006-101-916.STEP
20.9 x 3.10 x 3.00 mm
