sfunderbots/Electrical/thebots_libraries/3dmodels/BM08B-GHS-TBT_LF__SN__N_.step

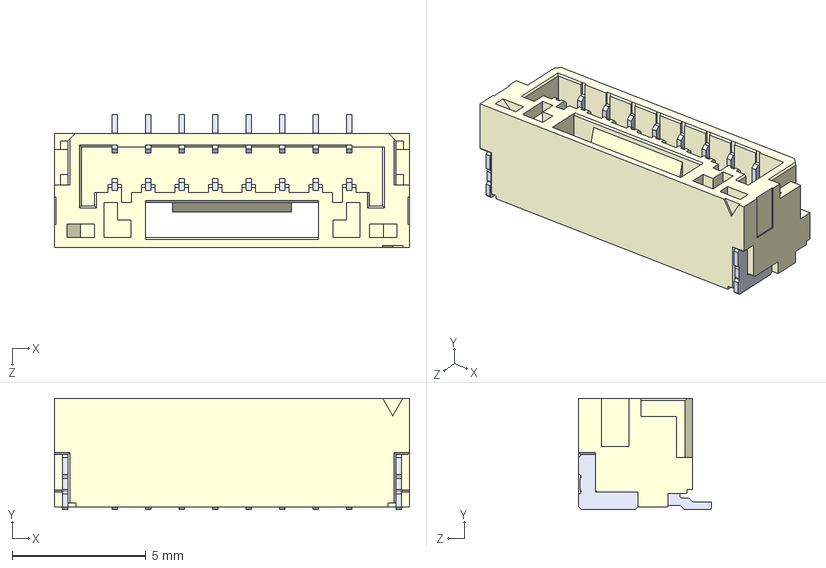
[picture p36: CAD file, 2026-02-27]
thebots_libraries/3dmodels/BM08B-GHS-TBT_LF__SN__N_.step
13.2 x 4.15 x 4.95 mm
