sfunderbots/Electrical/PAC5527Driver/3D_Models/Components/20R-JMDSS-G-1-TF(S).STEP

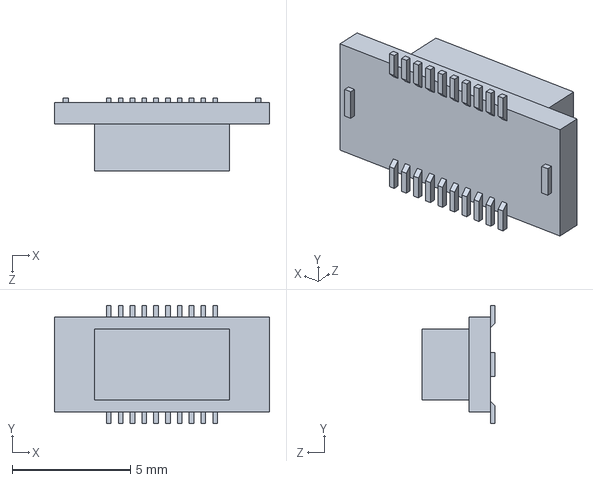
[picture p37: CAD file, 2023-03-27]
PAC5527Driver/3D_Models/Components/20R-JMDSS-G-1-TF(S).STEP
9.10 x 5.00 x 3.10 mm
