sfunderbots/Electrical/thebots_libraries/3dmodels/PMW3360 v12.step

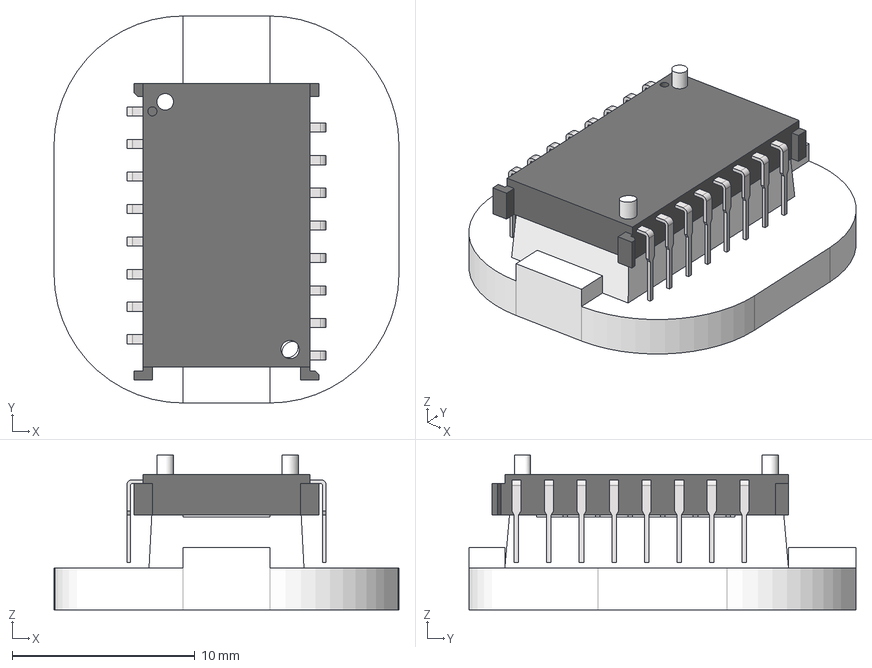
[picture p38: CAD file, 2026-02-27]
thebots_libraries/3dmodels/PMW3360 v12.step
18.9 x 21.1 x 8.46 mm
Lead x 8
Lead(Mirror) x 8
Lens
