sfunderbots/Electrical/PAC5527Driver/3D_Models/Components/AVX-13-9159-006-101-916.STEP

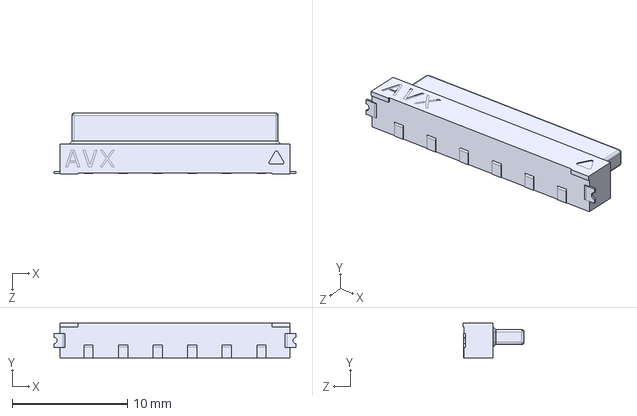
[picture p39: CAD file, 2023-03-27]
PAC5527Driver/3D_Models/Components/AVX-13-9159-006-101-916.STEP
21.0 x 3.00 x 5.30 mm
