sfunderbots/Electrical/thebots_libraries/3dmodels/C_0603_1608Metric.step

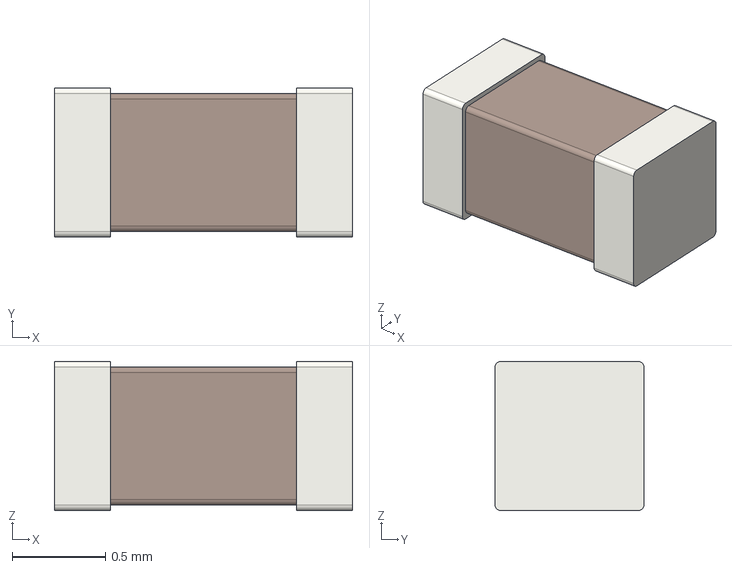
[picture p40: CAD file, 2026-02-26]
thebots_libraries/3dmodels/C_0603_1608Metric.step
1.60 x 0.8 x 0.8 mm
