sfunderbots/Electrical/thebots_libraries/3dmodels/JST_GH_SM08B-GHS-TB_1x08-1MP_P1.25mm_Horizontal.step

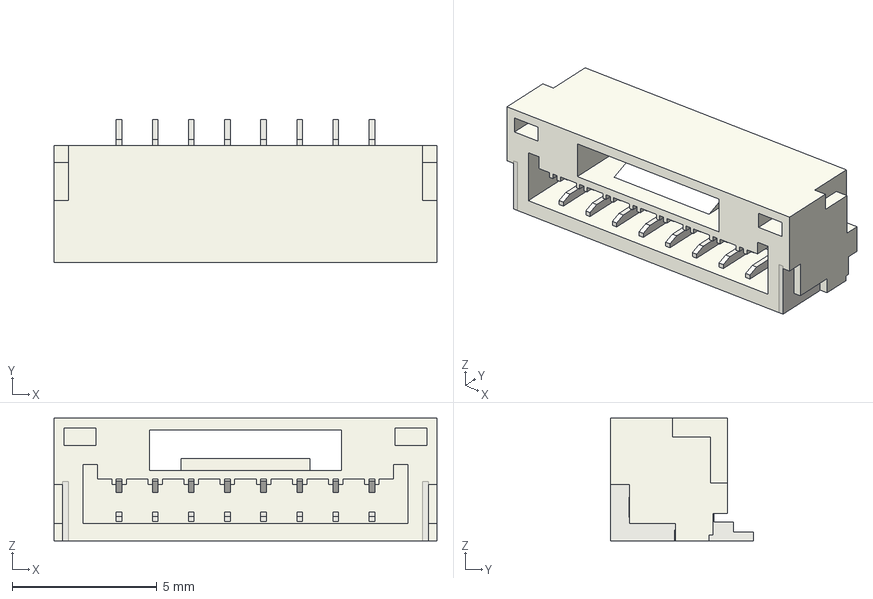
[picture p41: CAD file, 2026-02-26]
thebots_libraries/3dmodels/JST_GH_SM08B-GHS-TB_1x08-1MP_P1.25mm_Horizontal.step
13.2 x 4.95 x 4.25 mm
