sfunderbots/Electrical/thebots_libraries/3dmodels/1.28 TFT GC9A01 Display.STEP

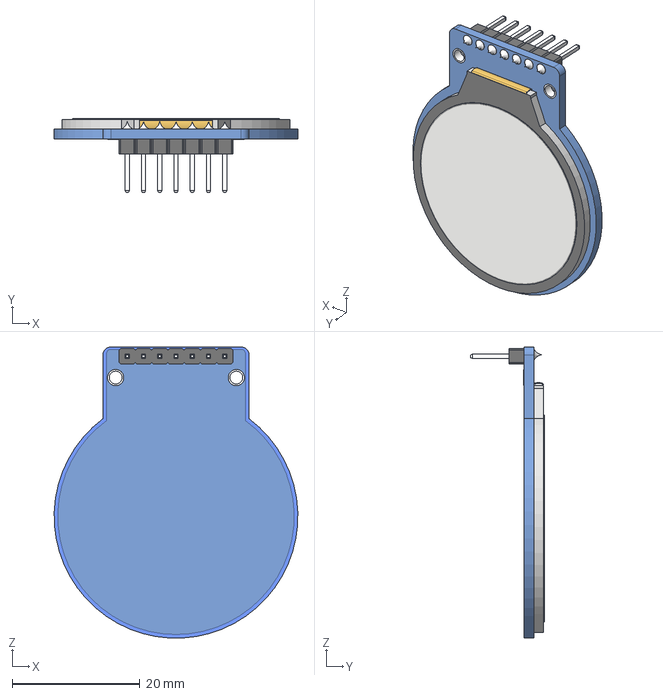
[picture p43: CAD file, 2026-02-14]
thebots_libraries/3dmodels/1.28 TFT GC9A01 Display.STEP
38.1 x 11.5 x 45.5 mm
