sfunderbots/Electrical/thebots_libraries/3dmodels/SO-8-PowerPAD.stp

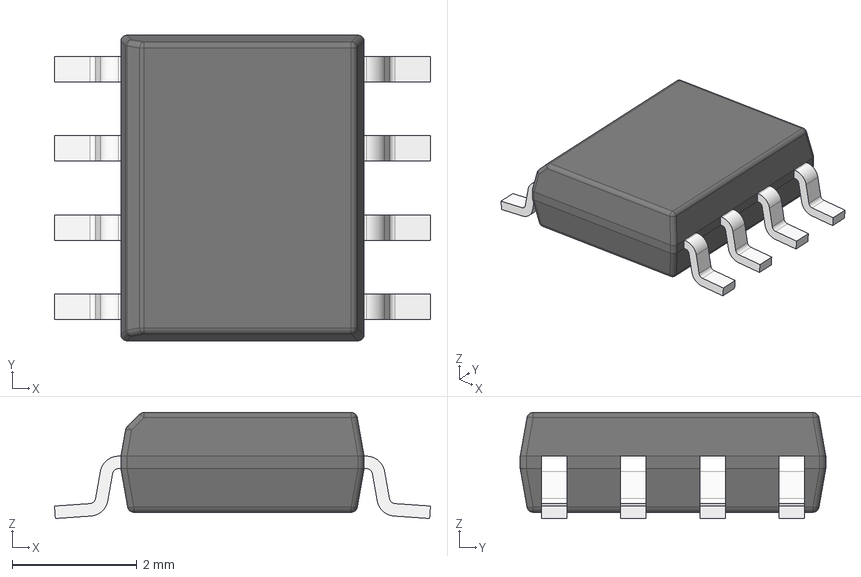
[picture p44: CAD file, 2026-02-12]
thebots_libraries/3dmodels/SO-8-PowerPAD.stp
6.03 x 4.90 x 1.70 mm
BODY-SO
LEAD-SO x 8
THERMALPAD-SO
