sfunderbots/Electrical/thebots_libraries/3dmodels/B4B-XH-A.STEP

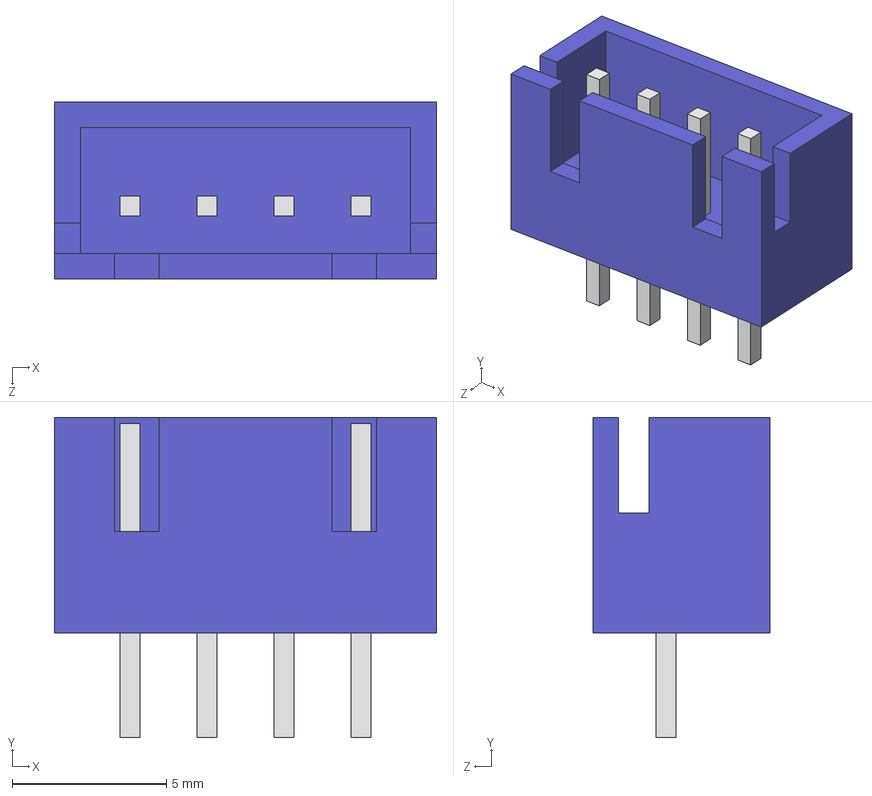
[picture p45: CAD file, 2026-02-12]
thebots_libraries/3dmodels/B4B-XH-A.STEP
12.4 x 10.4 x 5.75 mm
