sfunderbots/Electrical/thebots_libraries/3dmodels/TS-1187A-B-A-B--3DModel-STEP-56544.STEP

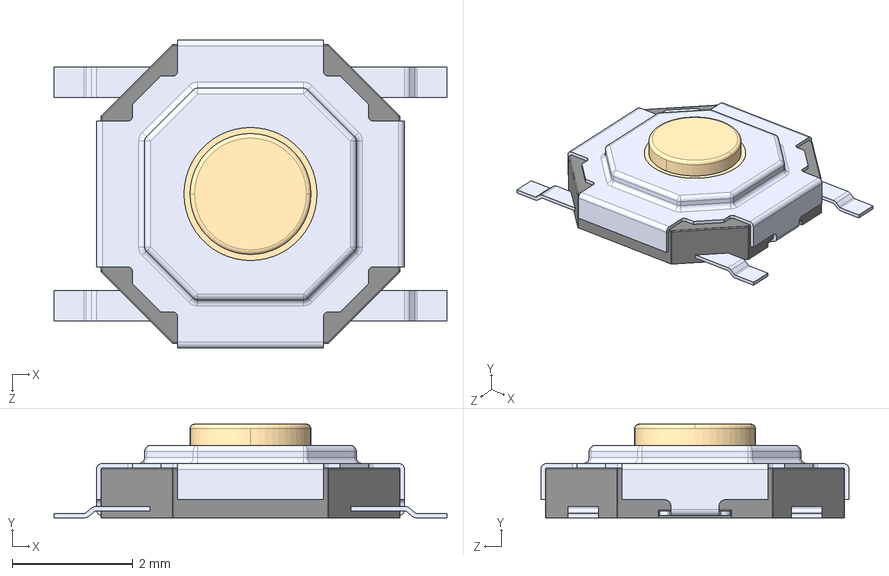
[picture p46: CAD file, 2025-05-26]
thebots_libraries/3dmodels/TS-1187A-B-A-B--3DModel-STEP-56544.STEP
6.50 x 1.55 x 5.10 mm
