sfunderbots/Electrical/thebots_libraries/3dmodels/W25Q128JVSIQ.STEP

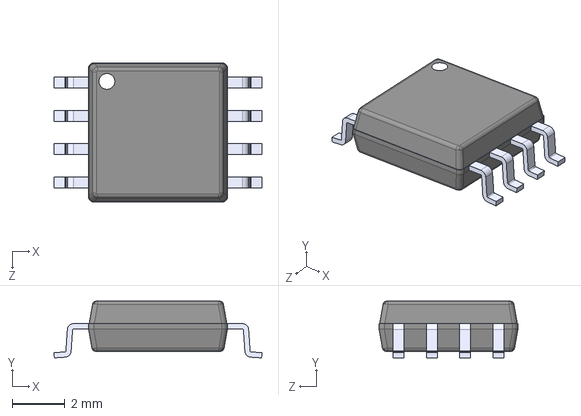
[picture p47: CAD file, 2025-05-26]
thebots_libraries/3dmodels/W25Q128JVSIQ.STEP
7.90 x 2.16 x 5.28 mm
