sfunderbots/Electrical/thebots_libraries/3dmodels/SOT23-3.stp

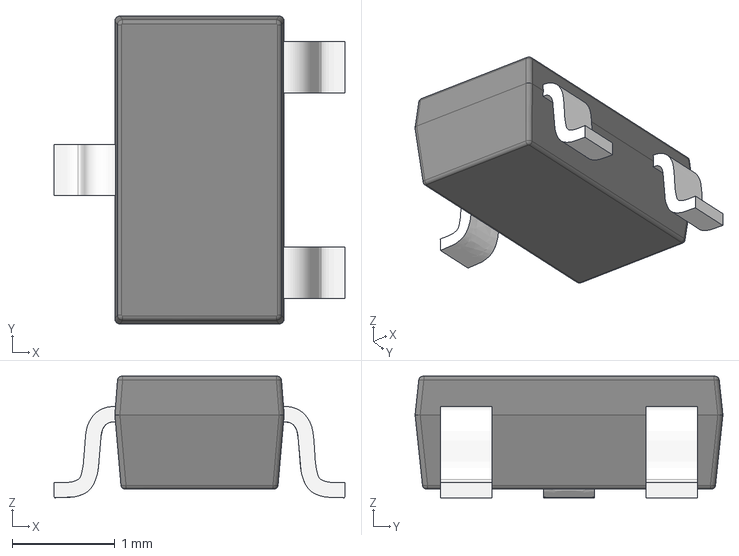
[picture p48: CAD file, 2024-04-04]
thebots_libraries/3dmodels/SOT23-3.stp
2.84 x 3.00 x 1.18 mm
