sfunderbots/Electrical/thebots_libraries/3dmodels/BM03B-GHS-TBT.STEP

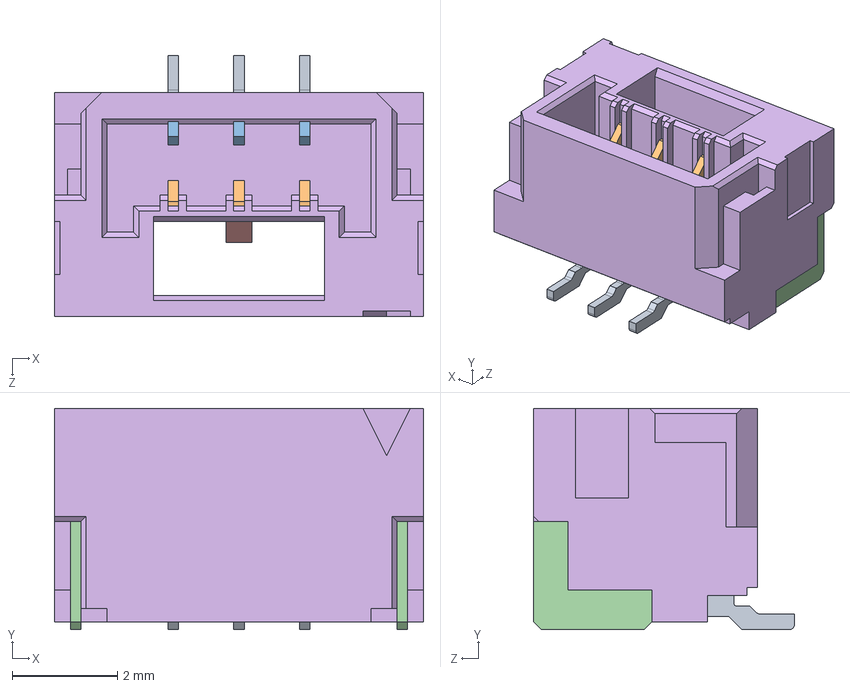
[picture p49: CAD file, 2024-03-11]
thebots_libraries/3dmodels/BM03B-GHS-TBT.STEP
7.00 x 4.20 x 4.95 mm
