sfunderbots/Electrical/thebots_libraries/3dmodels/SOD-923_0P6X0P85_ONS.step

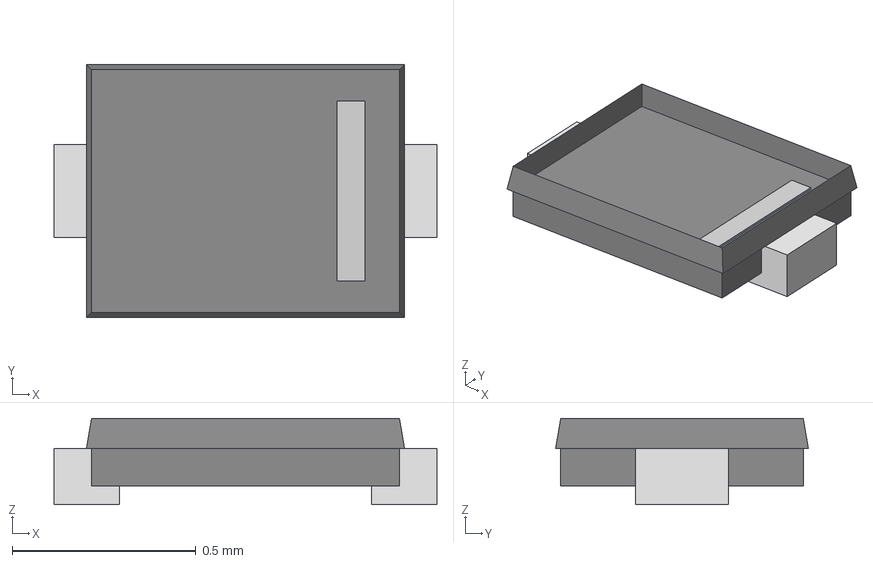
[picture p50: CAD file, 2024-02-26]
thebots_libraries/3dmodels/SOD-923_0P6X0P85_ONS.step
1.04 x 0.688 x 0.234 mm
