sfunderbots/Electrical/thebots_libraries/3dmodels/B2B-XH-A_LF__SN_.step

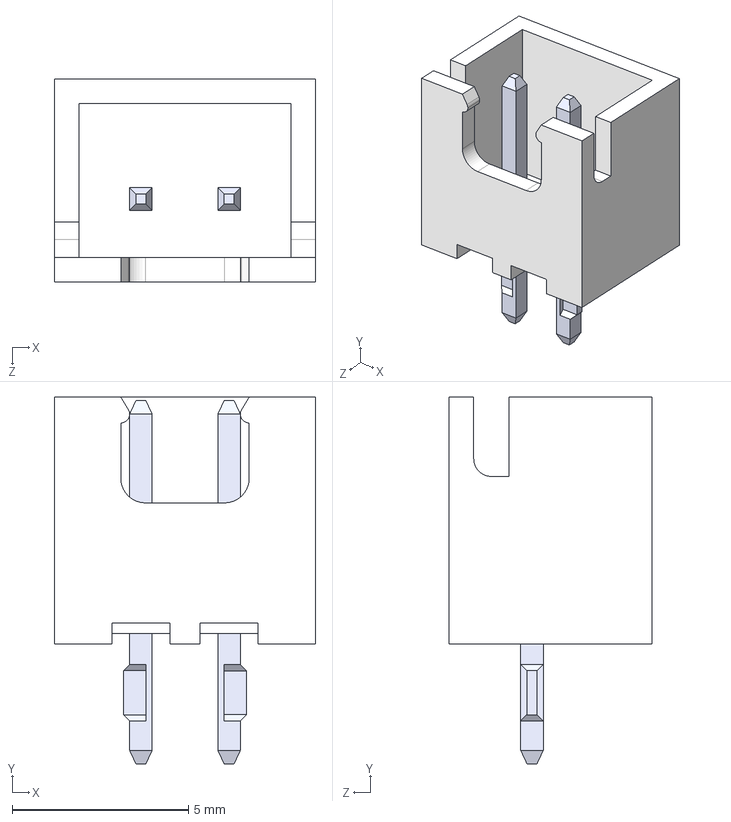
[picture p51: CAD file, 2024-02-11]
thebots_libraries/3dmodels/B2B-XH-A_LF__SN_.step
7.40 x 10.4 x 5.75 mm
