sfunderbots/Electrical/thebots_libraries/3dmodels/JST - XH -3.stp

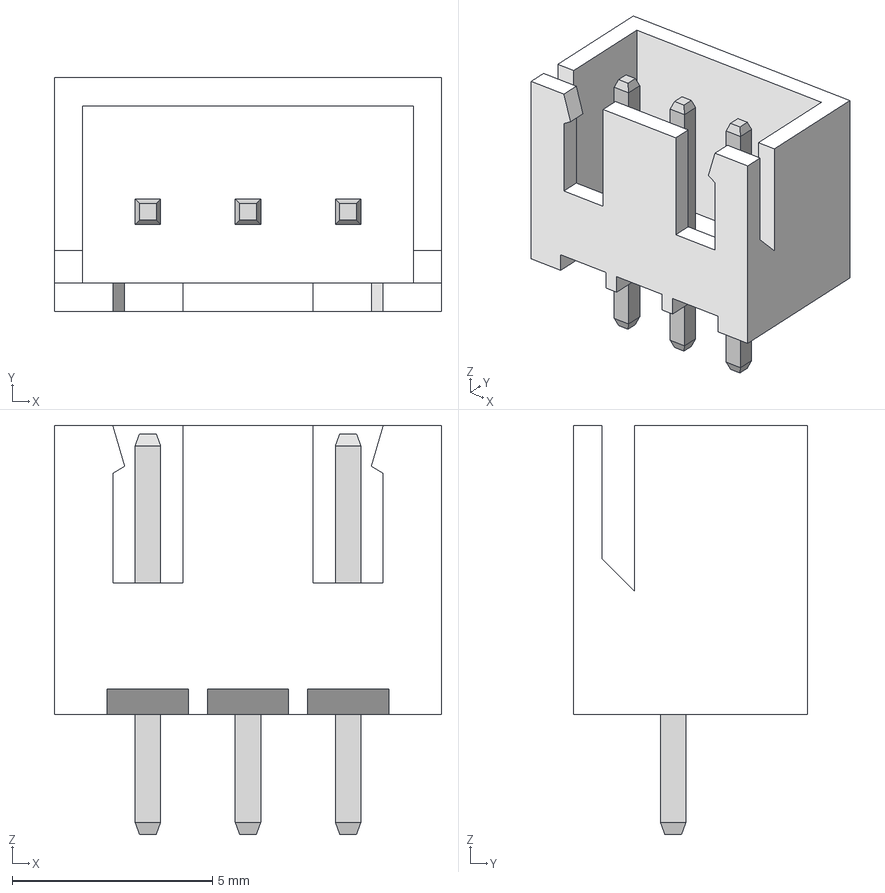
[picture p52: CAD file, 2024-02-06]
thebots_libraries/3dmodels/JST - XH -3.stp
9.67 x 5.84 x 10.2 mm
