sfunderbots/Electrical/thebots_libraries/3dmodels/ICM-20689.step

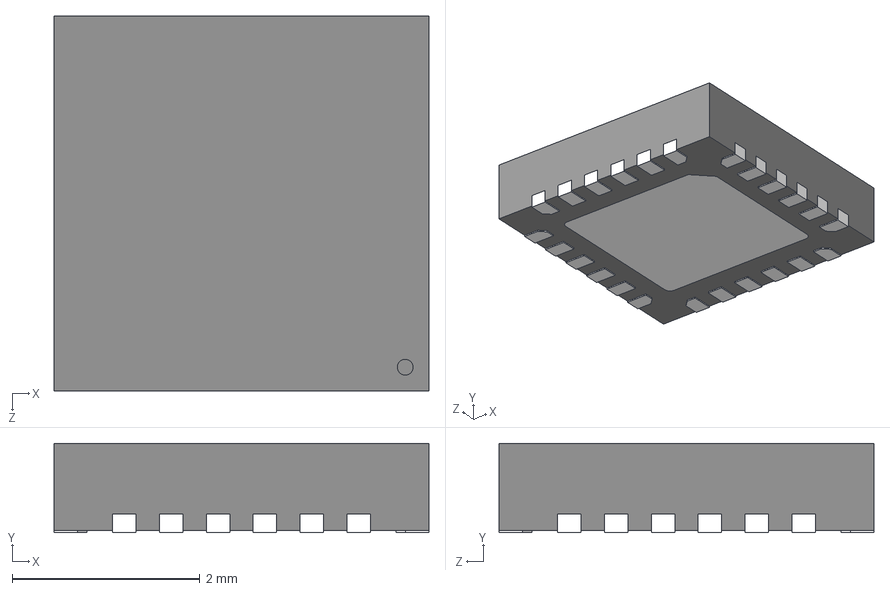
[picture p53: CAD file, 2024-02-05]
thebots_libraries/3dmodels/ICM-20689.step
4.00 x 0.95 x 4.00 mm
