sfunderbots/Electrical/thebots_libraries/3dmodels/E28-2G4M27S.STEP

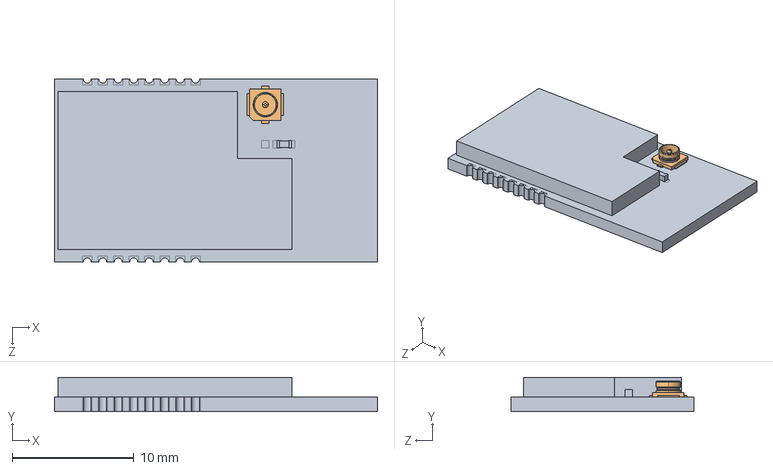
[picture p54: CAD file, 2024-01-27]
thebots_libraries/3dmodels/E28-2G4M27S.STEP
26.5 x 2.80 x 15.0 mm
E28___
