sfunderbots/Electrical/thebots_libraries/3dmodels/ABM3-8.000MHZ-D2Y-T.step

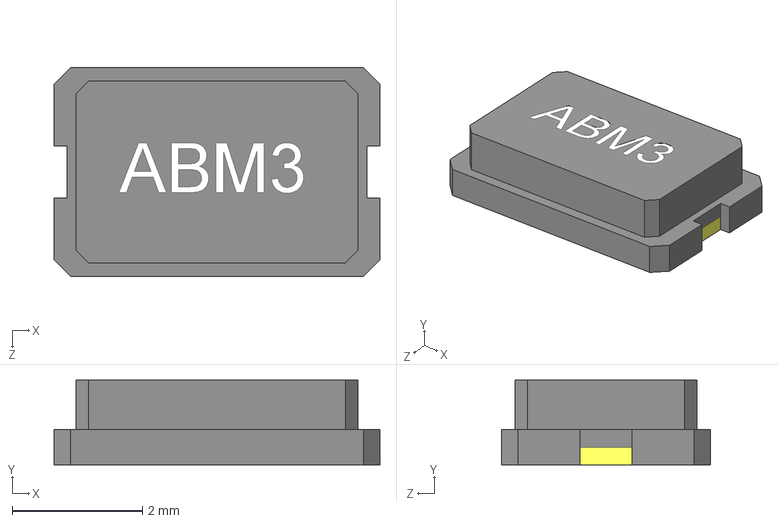
[picture p55: CAD file, 2024-01-27]
thebots_libraries/3dmodels/ABM3-8.000MHZ-D2Y-T.step
5.00 x 1.30 x 3.20 mm
