sfunderbots/Electrical/thebots_libraries/3dmodels/CAP_MXC_30X40_RUB.step

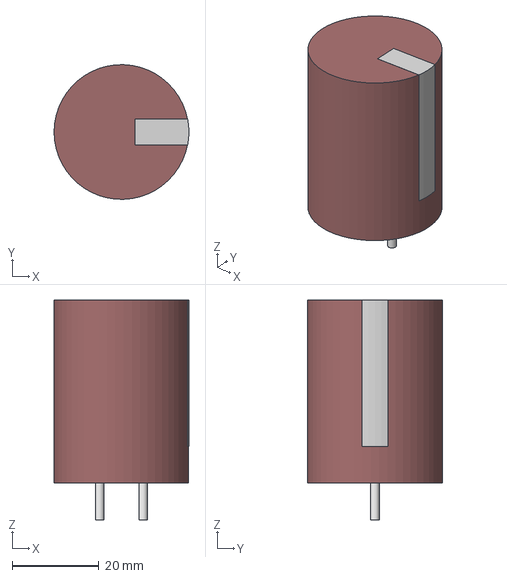
[picture p56: CAD file, 2024-01-24]
thebots_libraries/3dmodels/CAP_MXC_30X40_RUB.step
31.0 x 31.0 x 50.6 mm
