sfunderbots/Electrical/thebots_libraries/3dmodels/pwr220t-35.stp

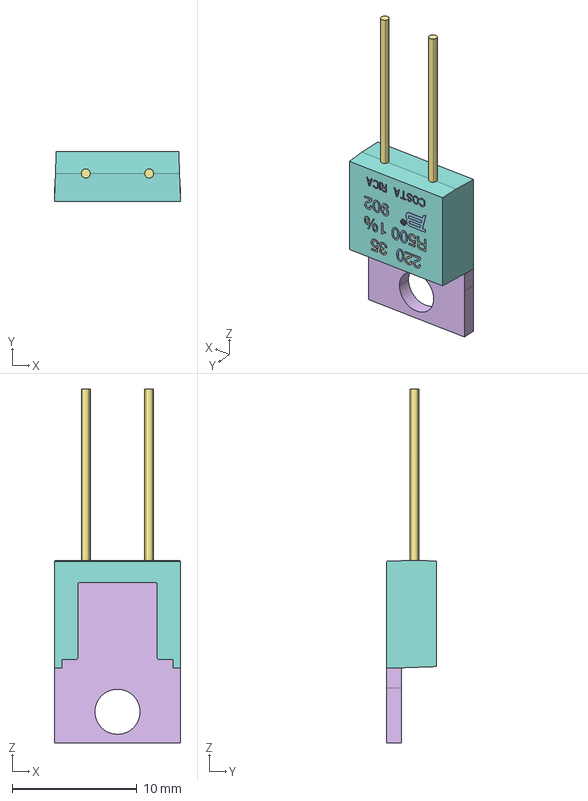
[picture p57: CAD file, 2024-01-24]
thebots_libraries/3dmodels/pwr220t-35.stp
10.1 x 4.03 x 28.3 mm
B-13078-00-SNAPSTRATE
B-13078-01-TERM
B-13078-08-BOT-SOLDER
B-13078-03-TOP-RESIST
B-13078-04-GLAZE
34544-08202-BACK-PLATE
PWR220-PIN x 2
B-13096-HSG
B-13097-MARKING
