sfunderbots/Electrical/thebots_libraries/3dmodels/CDRH127-1.STEP

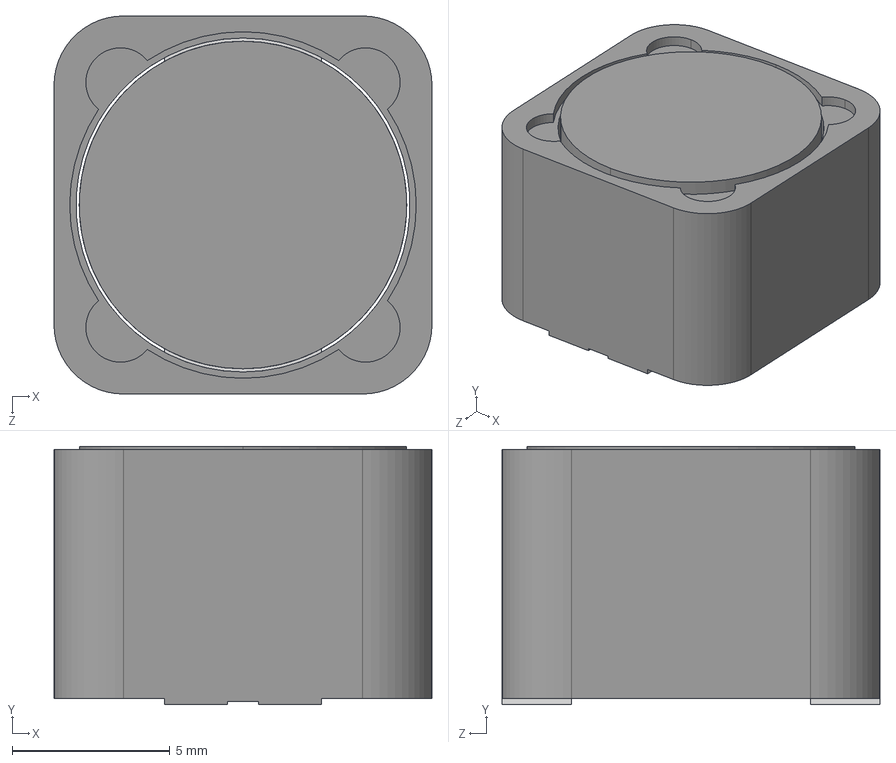
[picture p58: CAD file, 2024-01-17]
thebots_libraries/3dmodels/CDRH127-1.STEP
12.0 x 8.20 x 12.0 mm
