sfunderbots/Electrical/thebots_libraries/3dmodels/SMT_32050_WRE.step

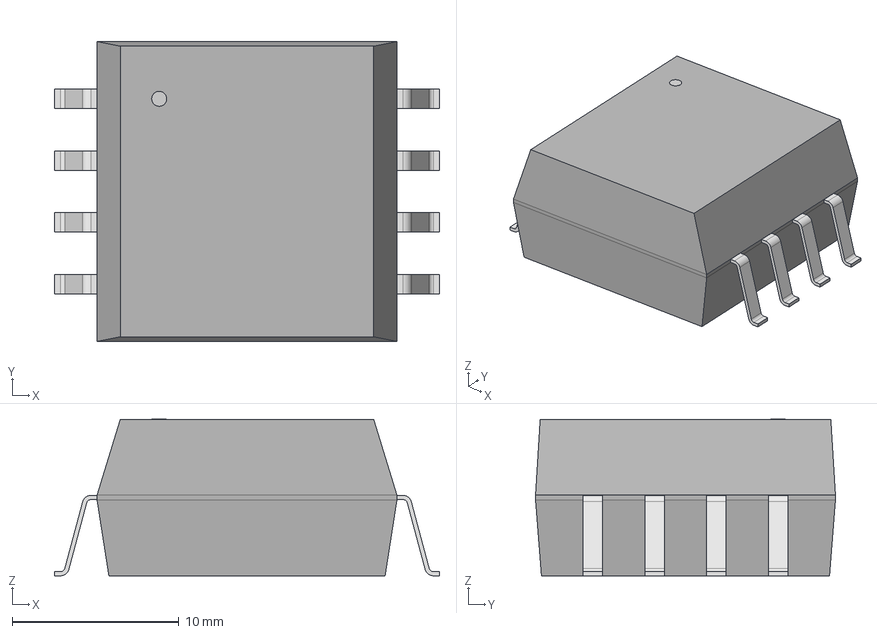
[picture p59: CAD file, 2024-01-17]
thebots_libraries/3dmodels/SMT_32050_WRE.step
23.1 x 18.0 x 9.40 mm
