sfunderbots/Electrical/thebots_libraries/3dmodels/SMTSO2515CTJ.step

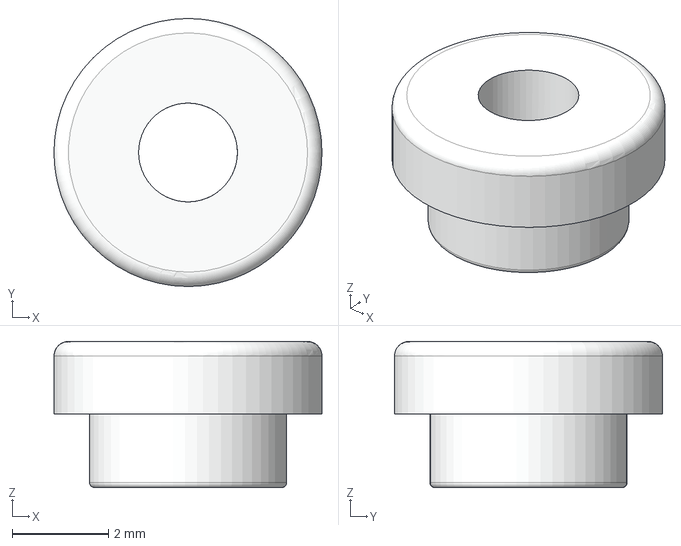
[picture p60: CAD file, 2024-01-08]
thebots_libraries/3dmodels/SMTSO2515CTJ.step
5.56 x 5.56 x 3.03 mm
