sfunderbots/Electrical/thebots_libraries/3dmodels/sru1048.stp

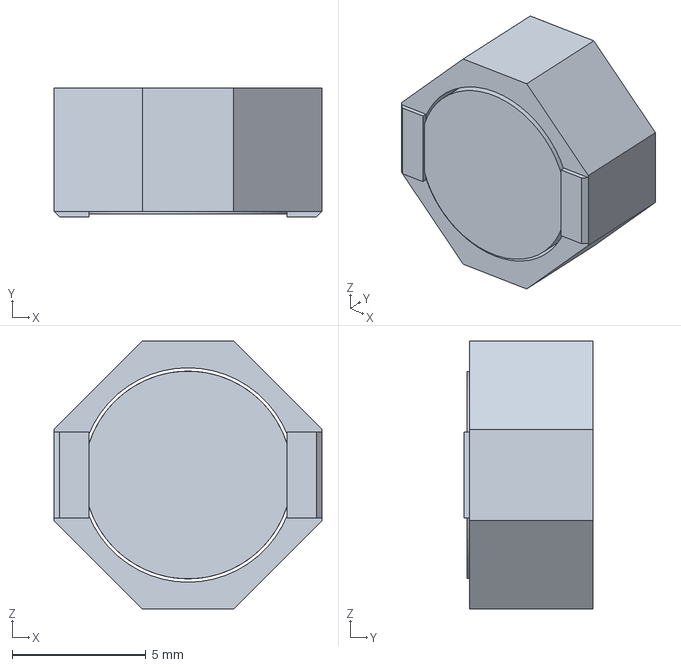
[picture p61: CAD file, 2024-01-08]
thebots_libraries/3dmodels/sru1048.stp
10.0 x 4.80 x 10.0 mm
