sfunderbots/Electrical/thebots_libraries/3dmodels/D2PAK_LM2576_MODEL.STEP

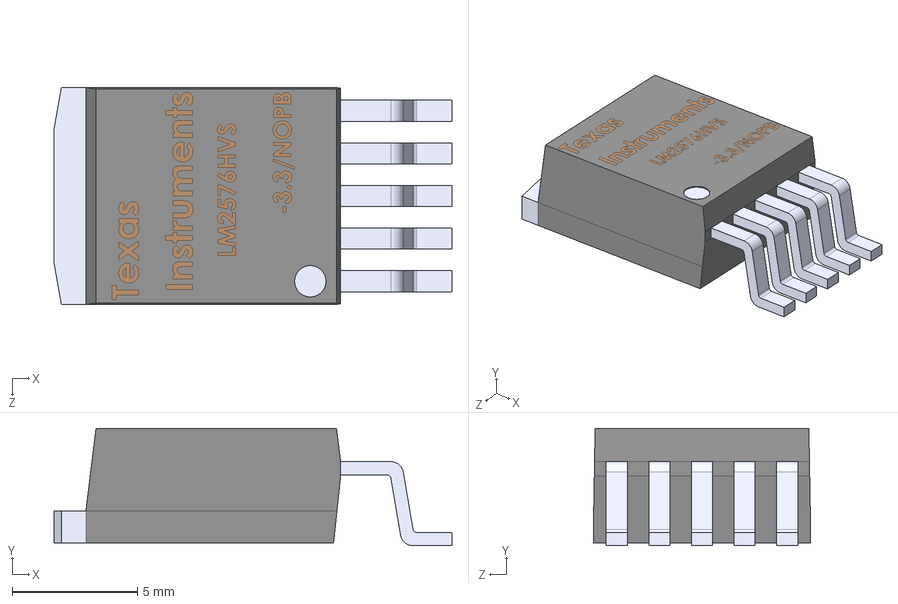
[picture p62: CAD file, 2023-12-29]
thebots_libraries/3dmodels/D2PAK_LM2576_MODEL.STEP
15.9 x 4.68 x 8.64 mm
D2PAK_LM2576_PIN x 5
D2PAK_LM2576_BODY
