sfunderbots/Electrical/thebots_libraries/3dmodels/c-3-794636-6-l-3d.stp

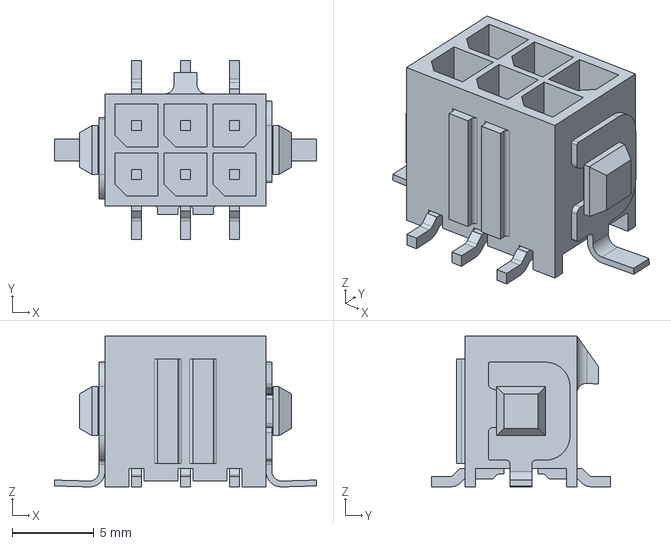
[picture p63: CAD file, 2023-12-29]
thebots_libraries/3dmodels/c-3-794636-6-l-3d.stp
16.0 x 10.9 x 9.24 mm
