sfunderbots/Electrical/thebots_libraries/3dmodels/c-2-1445053-2-d-3d.stp

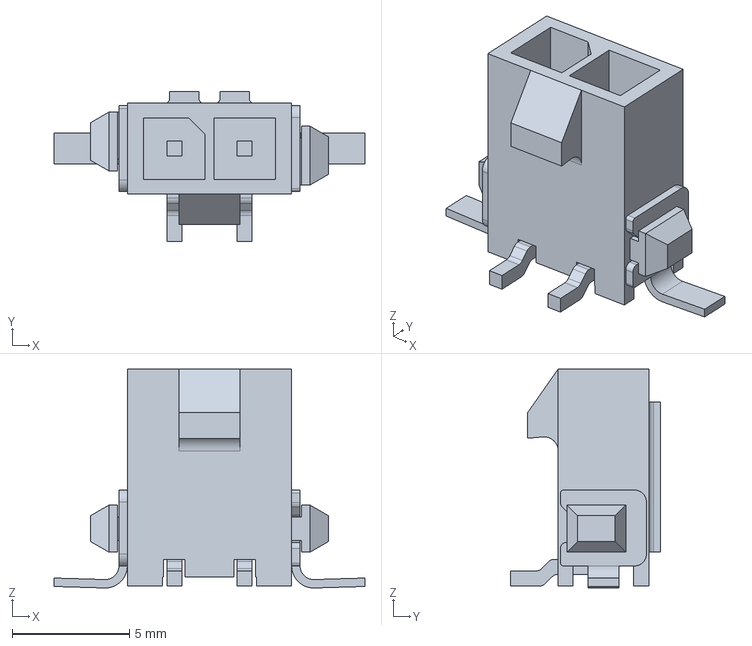
[picture p64: CAD file, 2023-12-29]
thebots_libraries/3dmodels/c-2-1445053-2-d-3d.stp
13.2 x 6.41 x 9.33 mm
