sfunderbots/Electrical/thebots_libraries/3dmodels/RA1H1C112R.stp

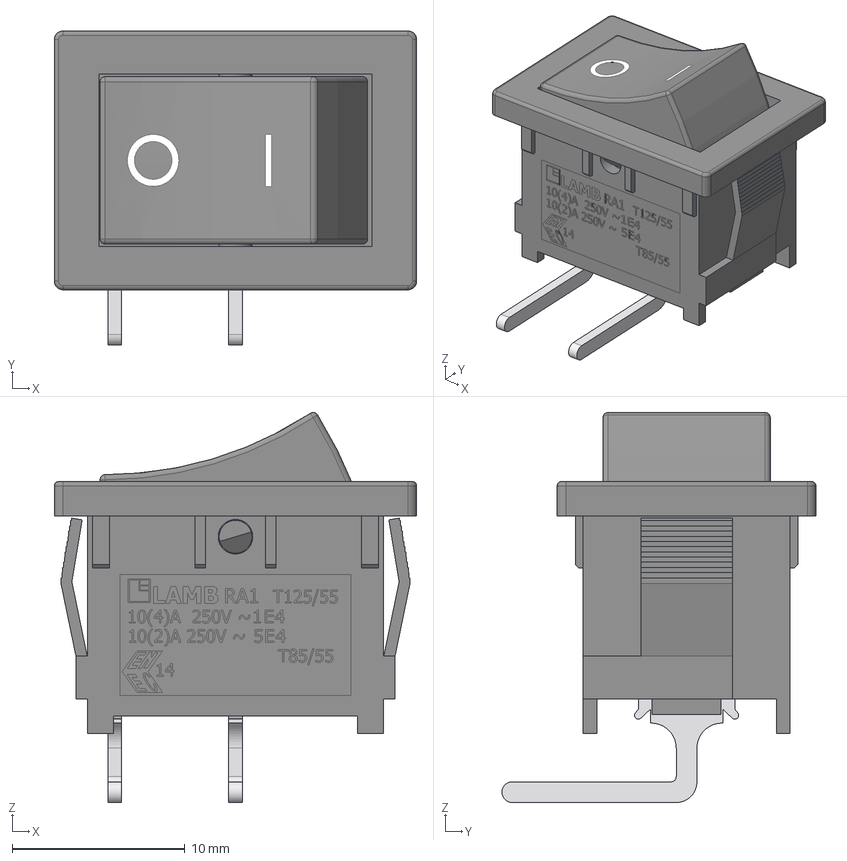
[picture p65: CAD file, 2023-12-29]
thebots_libraries/3dmodels/RA1H1C112R.stp
21.0 x 18.2 x 22.6 mm
