sfunderbots/Electrical/thebots_libraries/3dmodels/EEE-1CA471UP.stp

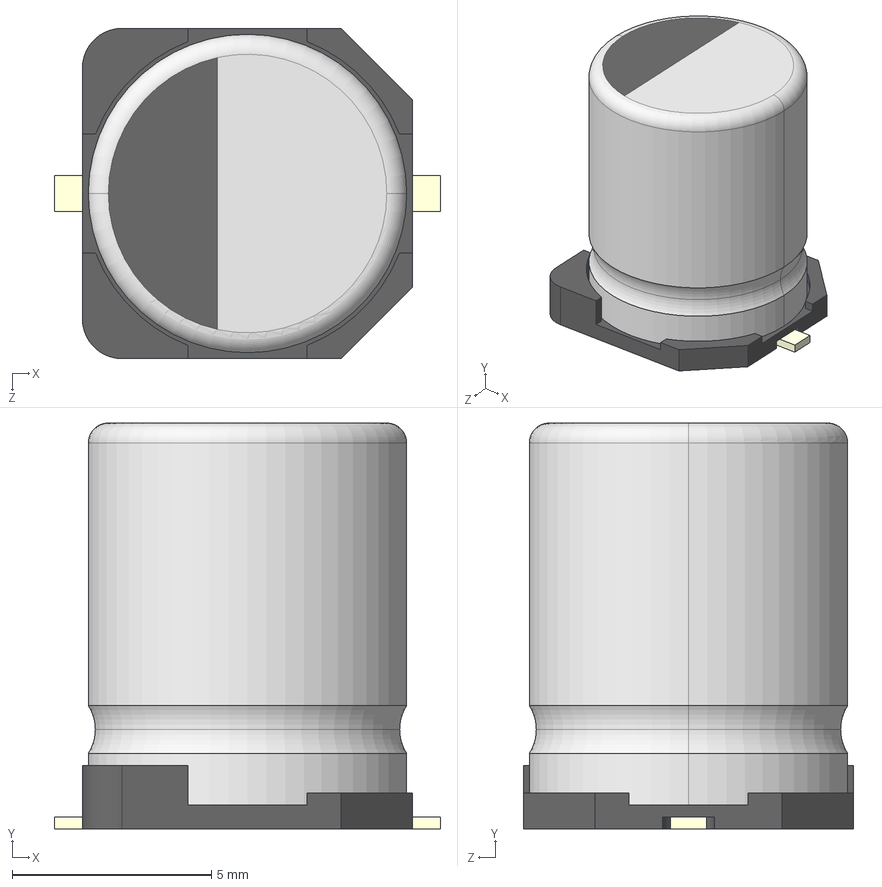
[picture p66: CAD file, 2023-12-29]
thebots_libraries/3dmodels/EEE-1CA471UP.stp
9.70 x 10.2 x 8.30 mm
標準SIZE CODE F-001
標準SIZE CODE F-002
標準SIZE CODE F-003 x 2
