sfunderbots/Electrical/thebots_libraries/3dmodels/EG1206.step

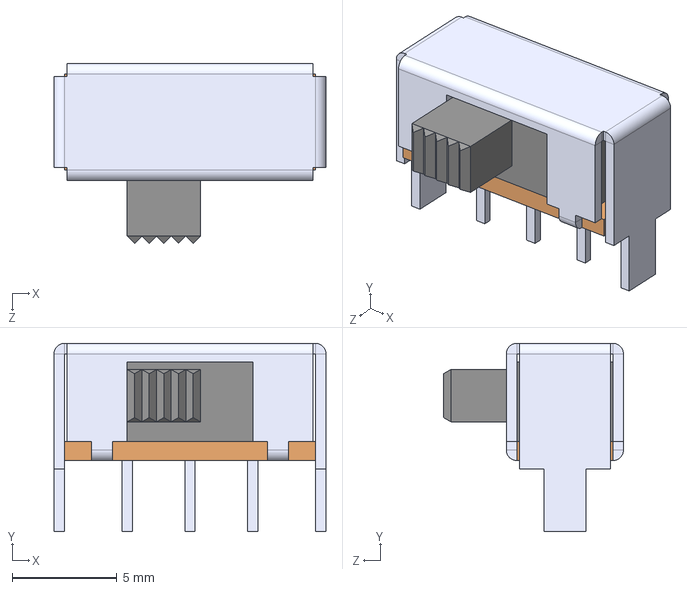
[picture p67: CAD file, 2023-12-11]
thebots_libraries/3dmodels/EG1206.step
13.0 x 9.00 x 8.60 mm
