sfunderbots/Electrical/thebots_libraries/3dmodels/BM04B-GHS-TBT_LF__SN__N_.step

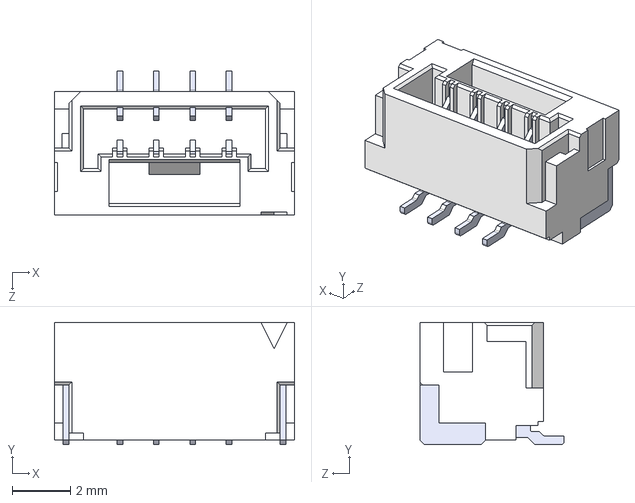
[picture p68: CAD file, 2023-12-11]
thebots_libraries/3dmodels/BM04B-GHS-TBT_LF__SN__N_.step
8.25 x 4.20 x 4.95 mm
