sfunderbots/Electrical/thebots_libraries/3dmodels/Keystone_24929.STEP

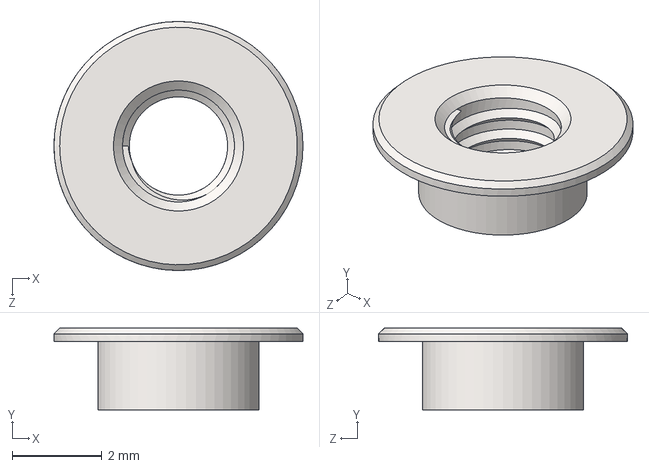
[picture p69: CAD file, 2023-12-04]
thebots_libraries/3dmodels/Keystone_24929.STEP
5.56 x 1.83 x 5.56 mm
