sfunderbots/Electrical/thebots_libraries/3dmodels/XT60PW-M.STEP

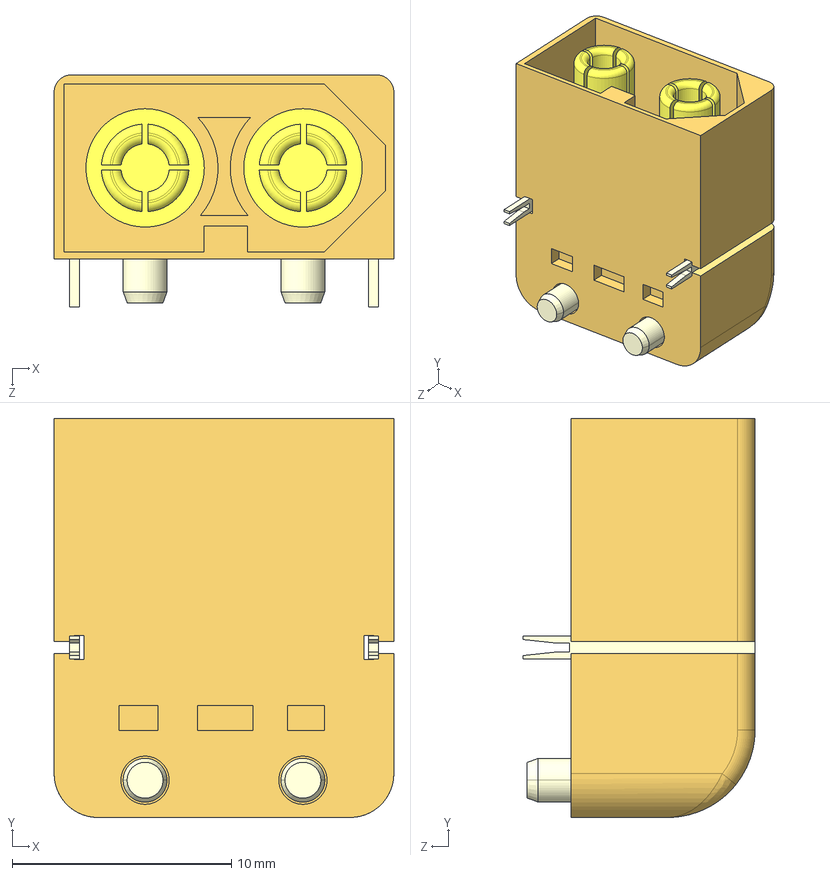
[picture p70: CAD file, 2023-12-04]
thebots_libraries/3dmodels/XT60PW-M.STEP
15.5 x 18.2 x 10.6 mm
