sfunderbots/Electrical/thebots_libraries/3dmodels/User Library-XT60 male.STEP

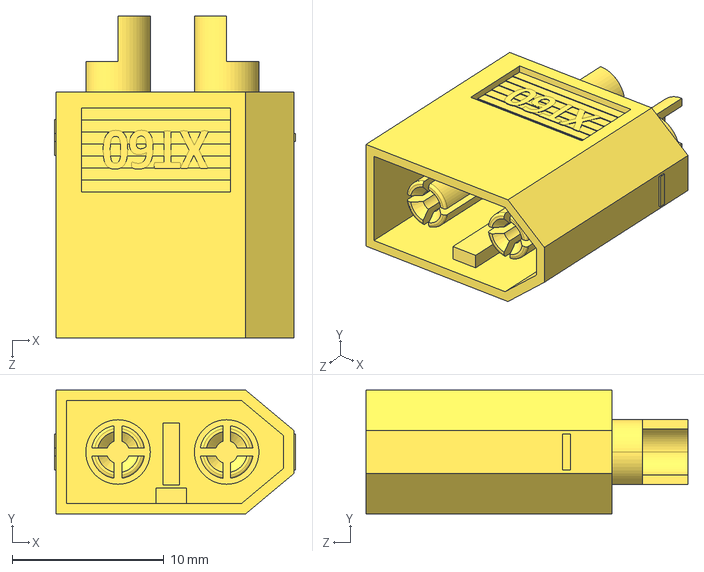
[picture p71: CAD file, 2023-12-04]
thebots_libraries/3dmodels/User Library-XT60 male.STEP
15.9 x 8.15 x 21.2 mm
