sfunderbots/Electrical/thebots_libraries/3dmodels/Fuse - mini 10A.step

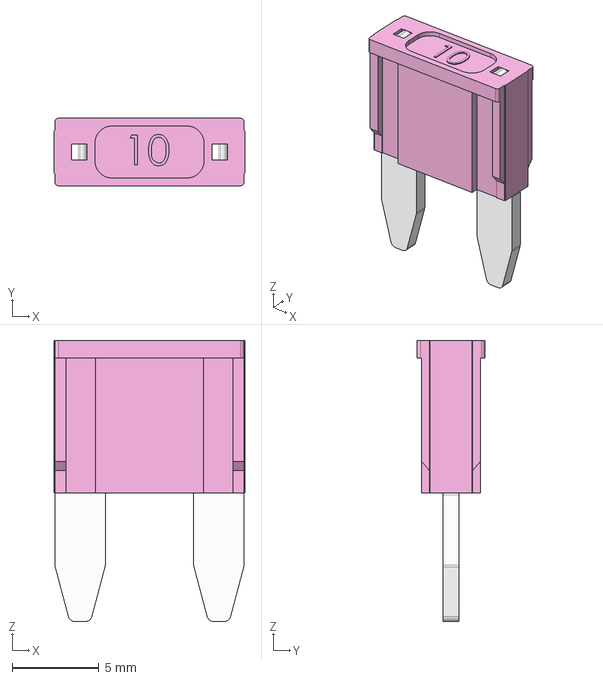
[picture p72: CAD file, 2023-11-30]
thebots_libraries/3dmodels/Fuse - mini 10A.step
11.0 x 3.90 x 16.2 mm
