sfunderbots/Electrical/thebots_libraries/3dmodels/R1966ABLKBLKGR.step

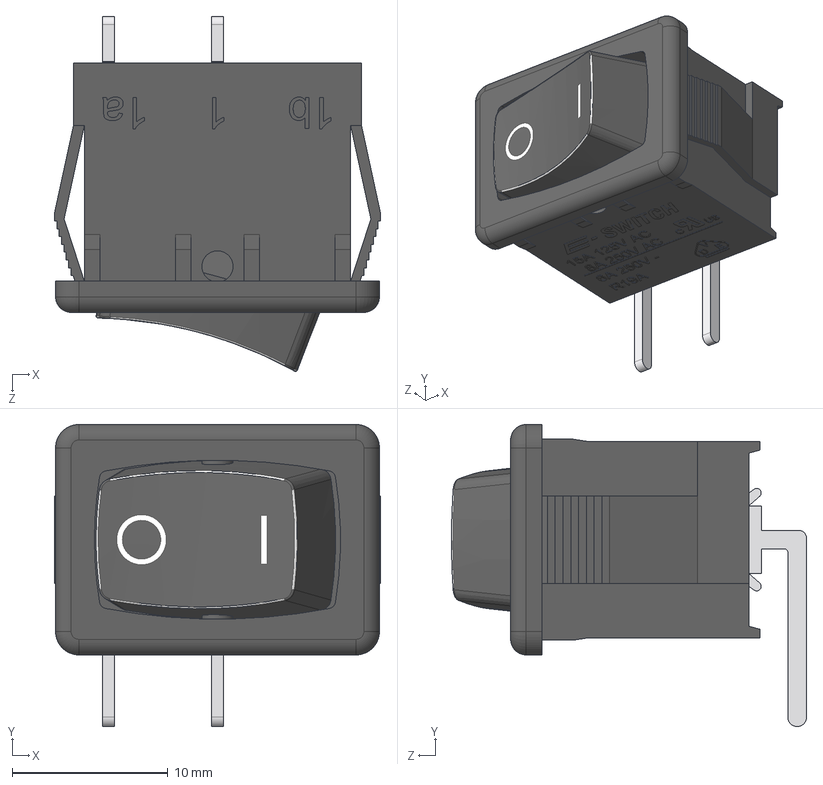
[picture p73: CAD file, 2023-11-30]
thebots_libraries/3dmodels/R1966ABLKBLKGR.step
20.9 x 19.4 x 22.8 mm
