sfunderbots/Electrical/thebots_libraries/3dmodels/3549-2.STEP

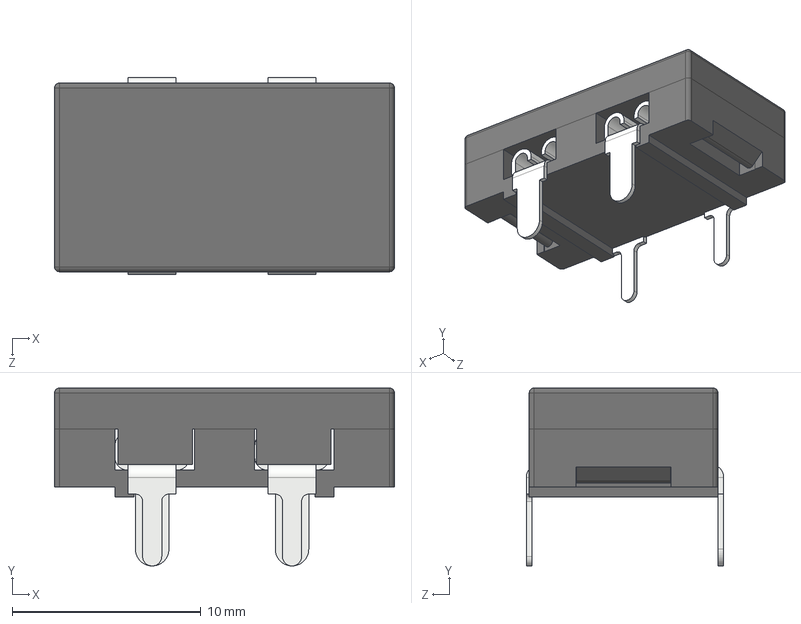
[picture p74: CAD file, 2023-11-30]
thebots_libraries/3dmodels/3549-2.STEP
18.0 x 9.44 x 10.5 mm
