sfunderbots/Electrical/thebots_libraries/3dmodels/PTS647SM50SMTR2LFS.stp

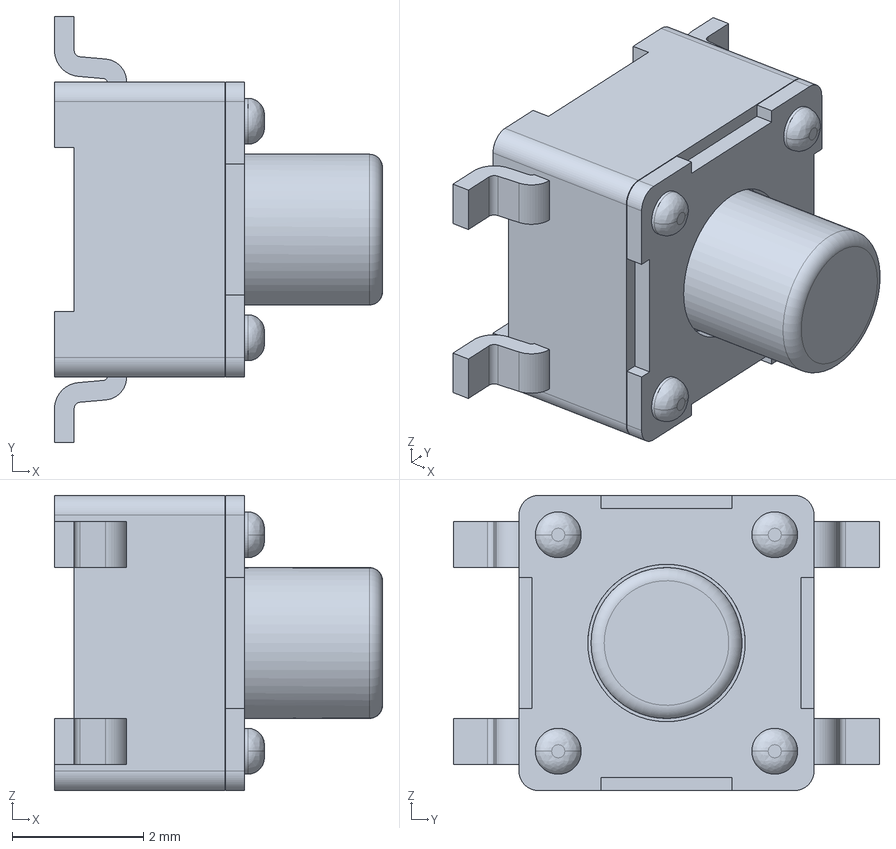
[picture p75: CAD file, 2023-10-30]
thebots_libraries/3dmodels/PTS647SM50SMTR2LFS.stp
5.00 x 6.50 x 4.50 mm
