sfunderbots/Electrical/thebots_libraries/3dmodels/ASPI-0630LR-150M-T15--3DModel-STEP-400430.STEP

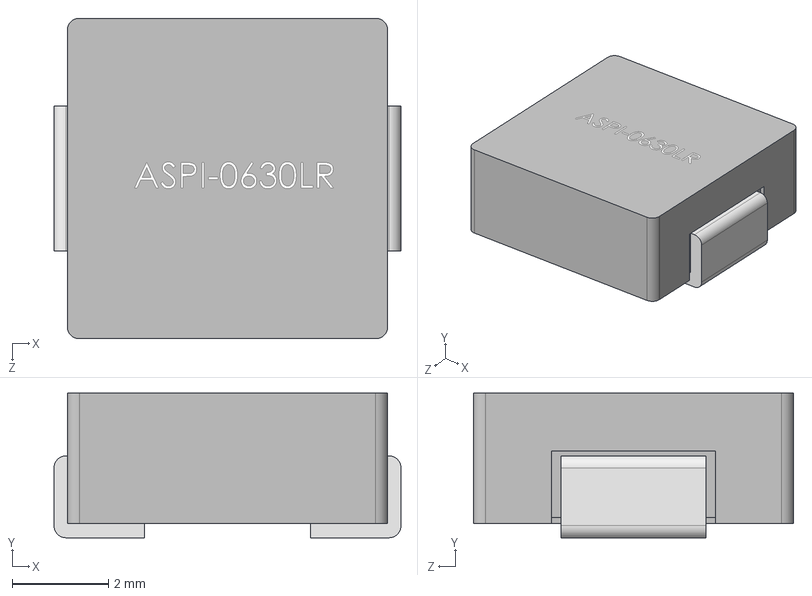
[picture p76: CAD file, 2023-10-30]
thebots_libraries/3dmodels/ASPI-0630LR-150M-T15--3DModel-STEP-400430.STEP
7.20 x 3.00 x 6.65 mm
