sfunderbots/Electrical/thebots_libraries/3dmodels/A768EB566M1VLAE042.step

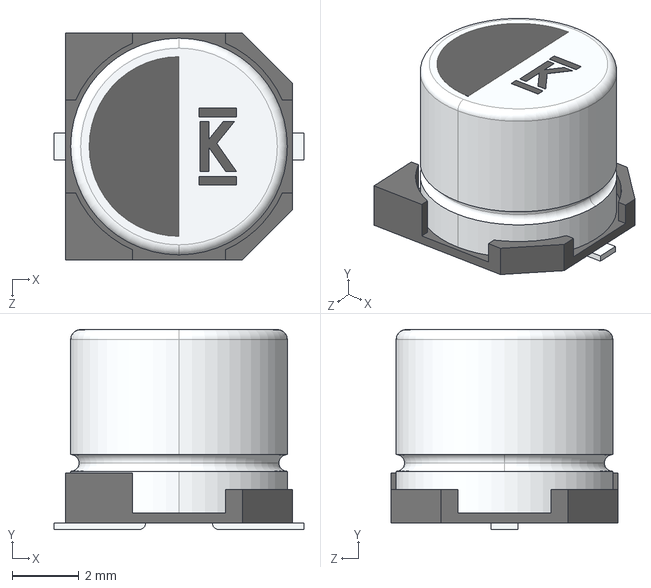
[picture p77: CAD file, 2023-10-23]
thebots_libraries/3dmodels/A768EB566M1VLAE042.step
7.50 x 6.00 x 6.80 mm
