sfunderbots/Electrical/thebots_libraries/3dmodels/USB4145-03-0170-C_REVA2.step

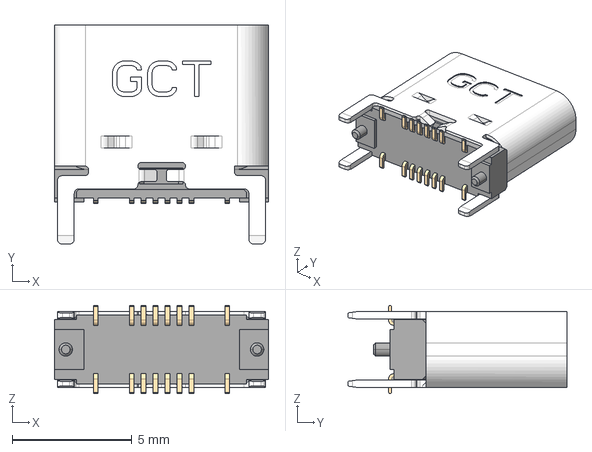
[picture p78: CAD file, 2023-10-20]
thebots_libraries/3dmodels/USB4145-03-0170-C_REVA2.step
8.95 x 9.16 x 3.69 mm
