sfunderbots/Electrical/thebots_libraries/3dmodels/QFN56_7X7_RPI.step

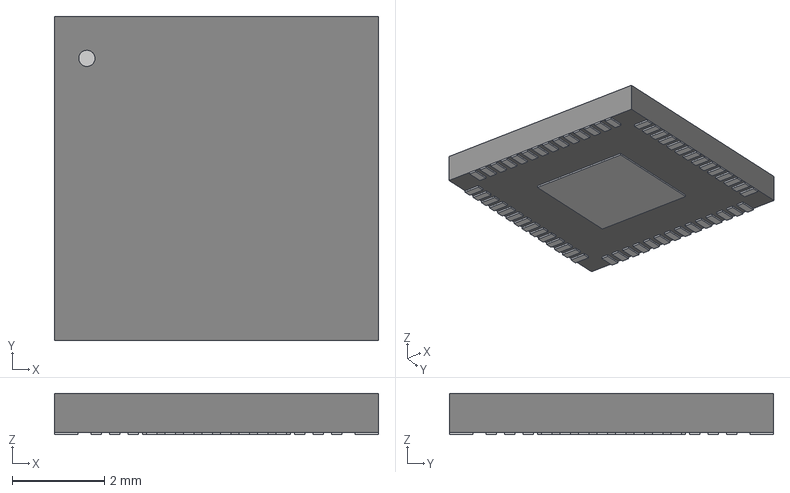
[picture p79: CAD file, 2023-10-18]
thebots_libraries/3dmodels/QFN56_7X7_RPI.step
7.01 x 7.01 x 0.892 mm
