sfunderbots/Electrical/thebots_libraries/3dmodels/XTAL_ABLS_ABR.step

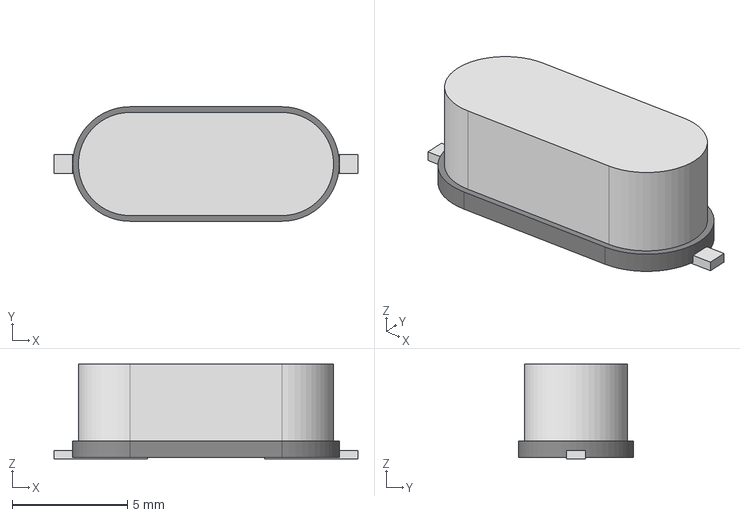
[picture p80: CAD file, 2023-10-18]
thebots_libraries/3dmodels/XTAL_ABLS_ABR.step
13.2 x 4.98 x 4.12 mm
