sfunderbots/Electrical/thebots_libraries/3dmodels/DPAK-3_ONS.step

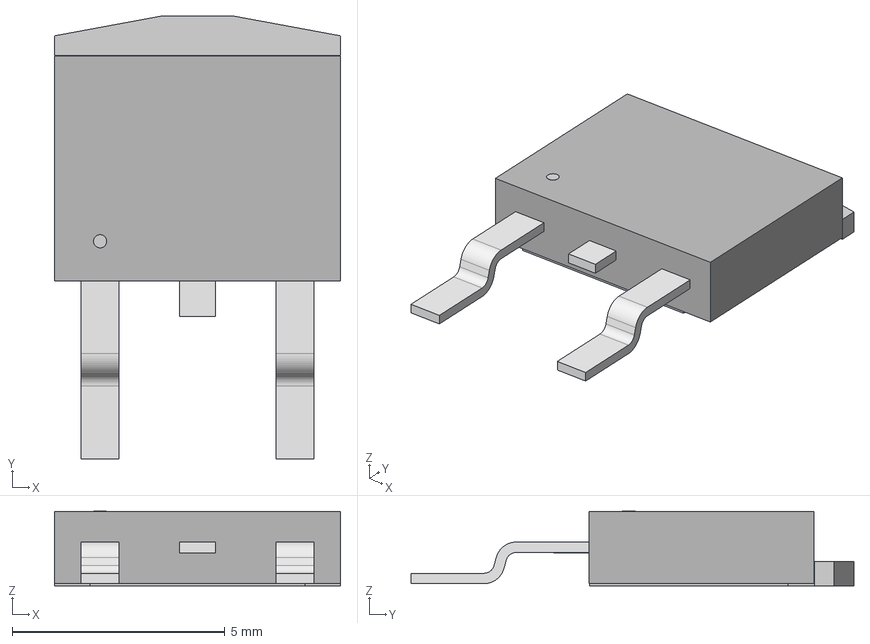
[picture p81: CAD file, 2023-10-18]
thebots_libraries/3dmodels/DPAK-3_ONS.step
6.73 x 10.4 x 1.75 mm
