sfunderbots/Electrical/thebots_libraries/3dmodels/445-CRYTAL-SMD.STEP

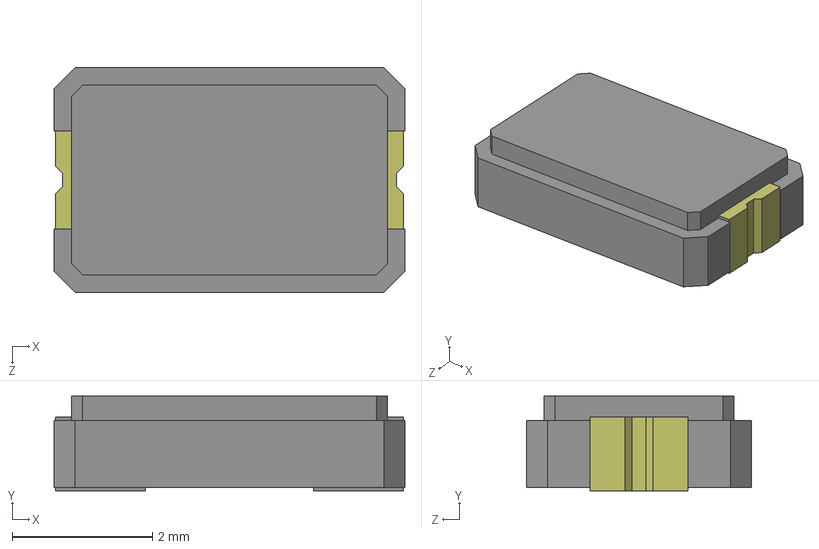
[picture p82: CAD file, 2023-10-18]
thebots_libraries/3dmodels/445-CRYTAL-SMD.STEP
5.00 x 1.35 x 3.20 mm
