sfunderbots/Electrical/thebots_libraries/3dmodels/TO-247_bent_leads.STEP

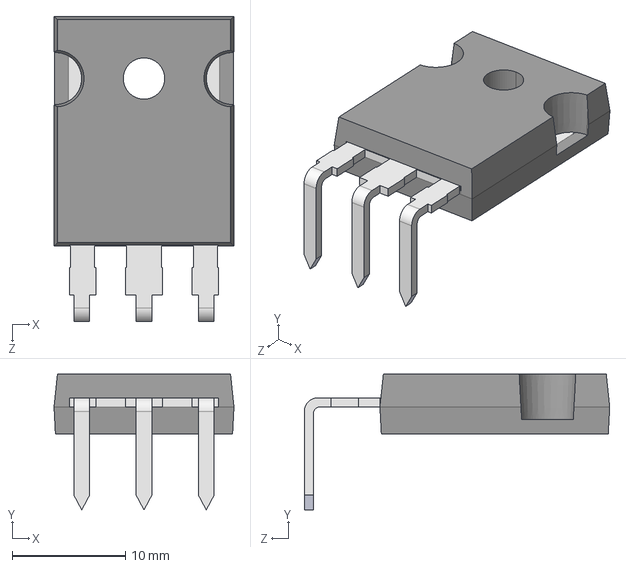
[picture p83: CAD file, 2023-10-18]
thebots_libraries/3dmodels/TO-247_bent_leads.STEP
15.9 x 12.0 x 27.0 mm
