sfunderbots/Electrical/thebots_libraries/3dmodels/SOIC12_DA2034-ALD_COC.step

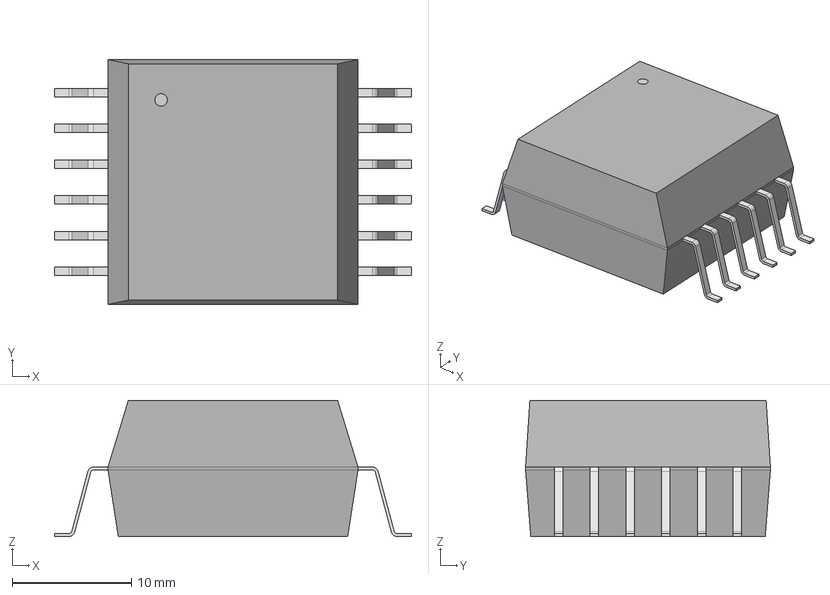
[picture p84: CAD file, 2023-10-18]
thebots_libraries/3dmodels/SOIC12_DA2034-ALD_COC.step
30.0 x 20.6 x 11.4 mm
