sfunderbots/Electrical/thebots_libraries/3dmodels/B3B-XH-A.STEP

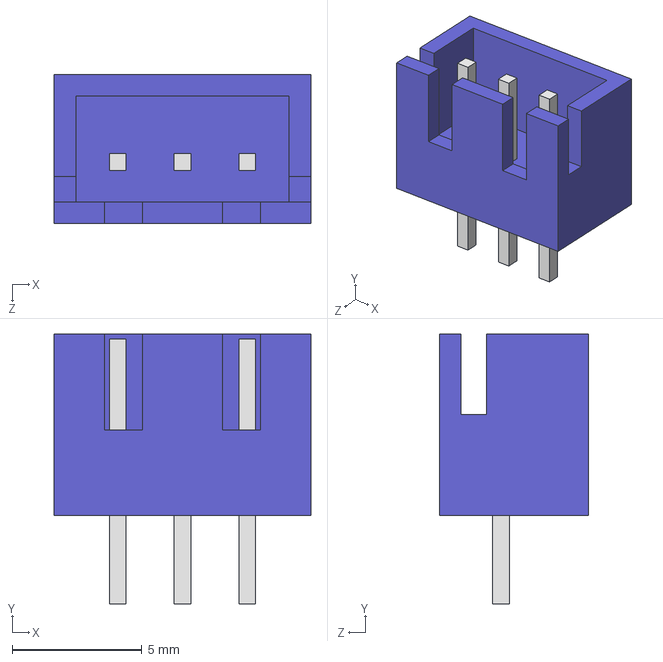
[picture p85: CAD file, 2023-10-18]
thebots_libraries/3dmodels/B3B-XH-A.STEP
9.90 x 10.4 x 5.75 mm
