sfunderbots/Electrical/thebots_libraries/3dmodels/tbots_1000uf_250v_25.4mm_x45mm.STEP

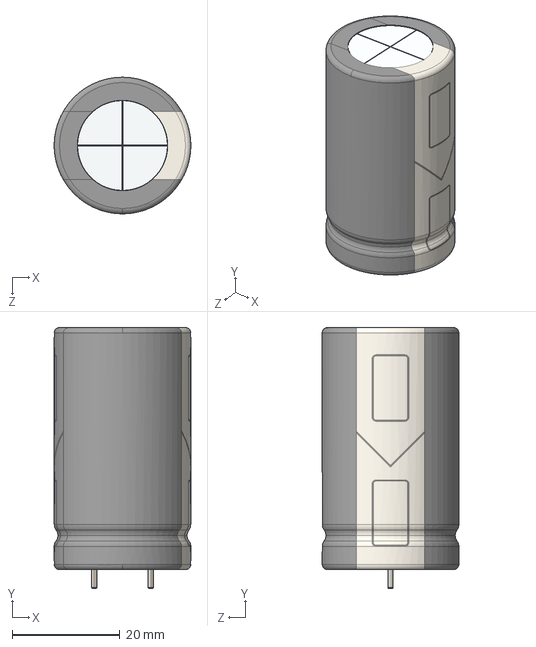
[picture p86: CAD file, 2023-10-18]
thebots_libraries/3dmodels/tbots_1000uf_250v_25.4mm_x45mm.STEP
25.4 x 48.5 x 25.4 mm
