sfunderbots/Electrical/(list of files, cad)

Other CAD files:
PAC5527Driver/3D_Models/Components/009155006741006.step
thebots_libraries/3dmodels/430450812.stp
thebots_libraries/3dmodels/430450818.stp
thebots_libraries/3dmodels/436500200.stp
thebots_libraries/3dmodels/436500215.stp
thebots_libraries/3dmodels/436500224.stp
thebots_libraries/3dmodels/734120110.stp
thebots_libraries/3dmodels/A29520SIZE20C6.STEP
thebots_libraries/3dmodels/A29520SIZE20E7.STEP
thebots_libraries/3dmodels/JS102011SAQN.step
thebots_libraries/3dmodels/JS202011JAQN.step
thebots_libraries/3dmodels/clf10040.step
