sfunderbots/Electrical/Chicker/firmware_testing/battery_offset.xlsx

Simulated Voltage |  | Actual Voltage
3.1 | 3.081082156 | 2.8
4.45 | 4.422843739 | 4.3
6.35 | 6.311248932 | 6.3
8.06 | 8.010813604 | 8.2
10.64 | 10.57506908 | 11
13 | 12.9206671 | 13.6
14.82 | 14.7295605 | 15.6
15.98 | 15.88248156 | 16.8
 |  |  | y = 1.0893x - 0.5781
