sfunderbots/Electrical/Chicker/firmware_testing/chicker_pulse_2_velocity.xlsx

x1 | x2 | t1 | t2 | pulse (us) | speed | x1 | x2 | t1 | t2 | pulse (us) | speed
0.12 | 1.44 | 3.14 | 4.07 | 1250 | 1.419354839
0.12 | 1.47 | 1.04 | 1.64 | 1500 | 2.25 | 0.12 | 1.47 | 1.04 | 1.64 | 1500 | 2.25
0.16 | 1.42 | 0.4 | 1.01 | 1750 | 2.06557377
0.14 | 1.42 | 0.94 | 1.37 | 2000 | 2.976744186 | 0.14 | 1.42 | 0.94 | 1.37 | 2000 | 2.976744186
0.05 | 1.4 | 0.71 | 1.12 | 2500 | 3.292682927 | 0.05 | 1.4 | 0.71 | 1.12 | 2500 | 3.292682927
0.11 | 1.42 | 0.77 | 1.11 | 3000 | 3.852941176 | 0.11 | 1.42 | 0.77 | 1.11 | 3000 | 3.852941176
0.12 | 1.43 | 0.47 | 0.77 | 3500 | 4.366666667 | 0.12 | 1.43 | 0.47 | 0.77 | 3500 | 4.366666667
0.1 | 1.42 | 0.95 | 1.23 | 4000 | 4.714285714 | 0.1 | 1.42 | 0.95 | 1.23 | 4000 | 4.714285714
0.11 | 1.42 | 0.99 | 1.24 | 4500 | 5.24 | 0.11 | 1.42 | 0.99 | 1.24 | 4500 | 5.24
0.12 | 1.42 | 0.94 | 1.14 | 5000 | 6.5 | 0.12 | 1.42 | 0.94 | 1.14 | 5000 | 6.5
 |  | Equation:
