sfunderbots/Electrical/Chicker/firmware/to-test/hv-current-sensing/voltage-current-checking-control - flowchart.png

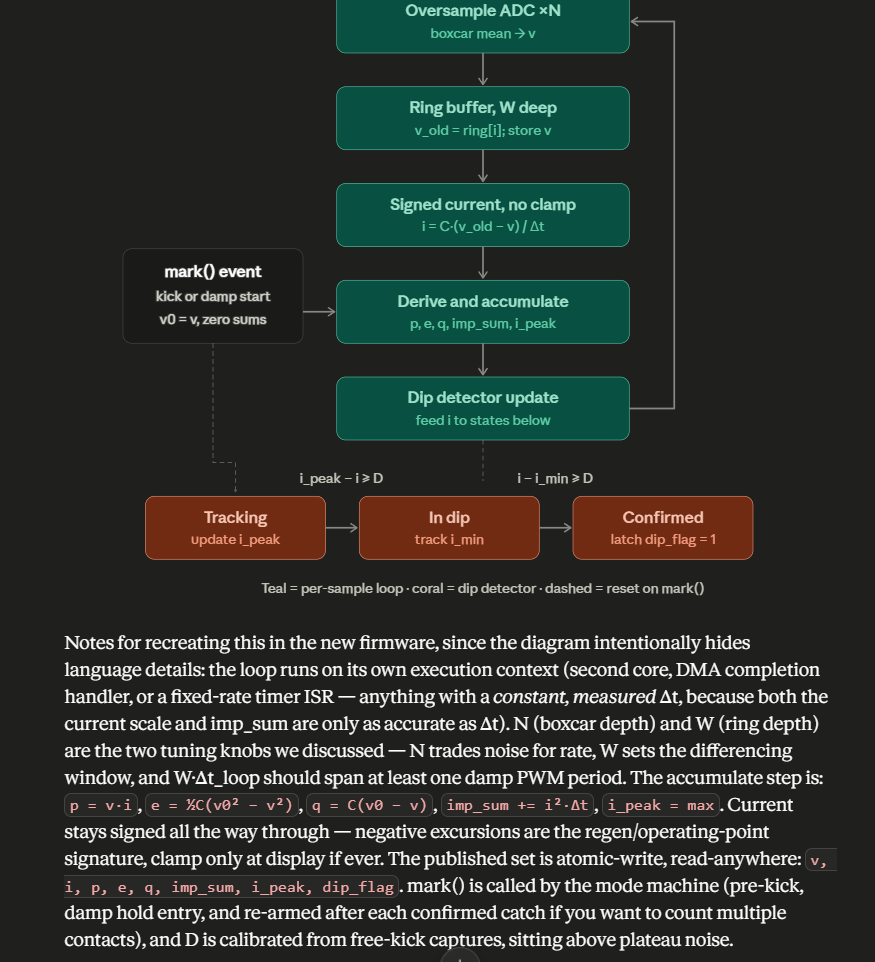
Chicker/firmware/to-test/hv-current-sensing/voltage-current-checking-control - flowchart.png
