sfunderbots/Electrical/Chicker/firmware/to-test/hv-current-sensing/voltage-current-checking-control.png

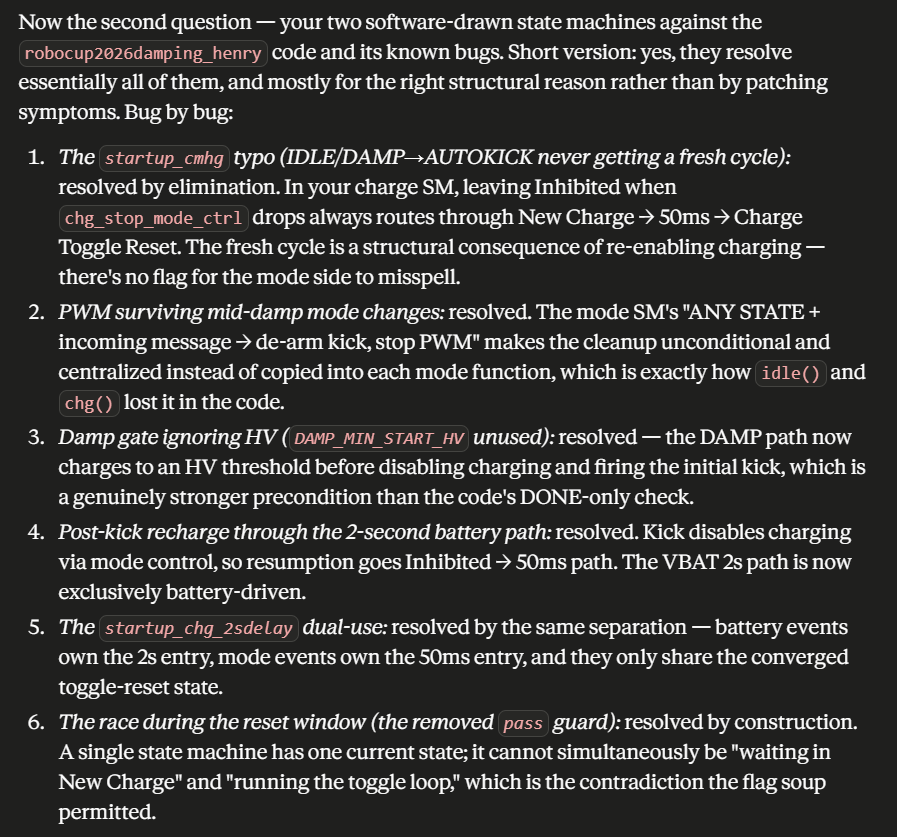
Chicker/firmware/to-test/hv-current-sensing/voltage-current-checking-control.png
