sfunderbots/Electrical/Chicker/firmware/TODO-NEXT.md

# Chicker firmware v2: what's NOT done yet

Branch `chicker-fw-v2-sim`. PLAN.md holds the design and decisions; this file is only the open work, in priority
order. Last updated 2026-10-24, end of session 1.

## State at hand-off
- Firmware v2 is written: `config.py` (constants only), `protocol.py`, `charge_sm.py`, `mode_sm.py`, `power_stage.py`,
  `kicker.py` (single PIO program), `kickmath.py`, `sensors.py`, `app.py`, `board.py`, `console.py`, `usb_io.py`,
  `main.py`. Old code is in `legacy/`.
- All of it compiles with `mpy-cross` (MicroPython 1.29). It has **never run on a real board**.
- Simulator: `sim/`. Run `python -m sim.run_tests --fast` from `firmware/`. Last full run: 87 passed, 0 failed.
  Transitions exercised: 41/41 mode and 29/29 charge (the last charge one was added after that run).
- v2 flowcharts: `flowcharts/*-v2.drawio`, generated by `python -m sim.drawio` and checked against the code by
  `test_l0_flowcharts`.
- Bench bring-up: `python -m bench.bring_up --sim` passes every stage on the simulator.

## 1. Fix first (broken at hand-off)
- [ ] `sim/tests/test_l10_bench.py`: all 3 tests FAIL, although `python -m bench.bring_up --sim` itself passes.
  Probably the test harness: stdout capture, a shared `ALL_COVERAGE` / world between tests, or the `SimLink` step
  size. Run `python -m sim.run_tests l10`, read the traceback, fix.
- [ ] Re-run the full suite plus the slow tests: `python -m sim.run_tests` (no `--fast`).

## 2. Before the board is touched
- [ ] **Henry: review** the v2 flowcharts in draw.io (re-arrange freely, but keep each arrow's `transitions`
  property) and the state tables in `charge_sm.py` / `mode_sm.py`.
- [ ] Write `CHANGES-v2.md` for Akhil and Steven: what changed and why, CAN protocol v2 table (IDs 0x2A0–0x2AF,
  STATUS/EVENT, heartbeat 20 Hz), legacy 0x2AA still accepted, safety rules, how to run the sim. Ask them to
  **confirm the 0x2A0–0x2AF ID block is free** on the robot bus.
- [ ] Update `README.MD`: which files go on the board (root `.py` files + `canbus/`, **not** `sim/`, `bench/`,
  `legacy/`, `to-test/`); how to run the tests and the bench script; `pip install pyserial` for the bench.
- [ ] Add `firmware/.gitignore`: `bench/logs/`, `__pycache__/`.
- [ ] Runtime API checks that only real hardware can confirm (stage 1 of the bring-up catches them):
  `sm.exec(int)` accepted on MicroPython 1.25, the program offset readback via `machine.mem32`, the side-set
  config bits, `Pin.irq(hard=True)`, the MCP2515 `setLoopbackMode()` round trip.

## 3. Simulation notebook (`simulation.ipynb`), not started
Walk through the same levels as the tests, with plots: model calibration (kick drops, charge curve), sensors,
protocol, PIO waveforms (pulse, PWM, abort), power-stage interlock, charge machine (normal / top-off / faults),
mode machine (kick, damp, kick-after-damp), the legacy replay showing the charge-into-dump bug, and a damping
study (COR vs duty / frequency / compensation mode, labelled "mechanics uncalibrated").
Build it with `nbformat` and execute every cell once to check.

## 4. On the bench (Henry, after review)
- [ ] `python -m bench.bring_up --port COMx --max-voltage 60` first, then 150, then full.
- [ ] Stage 6 gives `R_eff` for the new air gap → set `DAMP_R_EFF_OHM` and `DAMP_MAX_HOLD_POWER_W` in `config.py`.
- [ ] Calibrate `HV_GAIN_TRIM` / `BATT_GAIN_TRIM` against a multimeter. Check the 5 V divider (disputed).
- [ ] Re-fit the simulator solenoid model (`sim/physics.py` R_coil / L_coil) from the ladder kick data.
- [ ] Measure the real loop time (`lp=` in telemetry) and set `COST["loop_overhead"]` in `sim/world.py` to match.

## 5. to-test/ items, not started
- [ ] Reed switch: classifier for the 4-band analog circuit (closed / open / wire broken / wire shorted) + a sim test;
  README with the proposed resistor values.
- [ ] HV current sensing: fix the notes (ADC pin is GPIO29, not 26; no `_thread` ADC sharing; use ADC FIFO + DMA for
  a constant Δt) and a feasibility study in the simulator (sense filter ~1.2 kHz, ~1 A per LSB).

## 6. Later / ideas
See PLAN.md section 6 (N1–N24) and the damping power table (P1–P6): HV-compensated kick width, per-kick energy
log, capacitor health, plunger-extended sensor for auto-tuning the hold, robot-side heartbeat + STATUS
handling, finer duty resolution.
