sfunderbots/Electrical/FacePlate/production/schematics.pdf

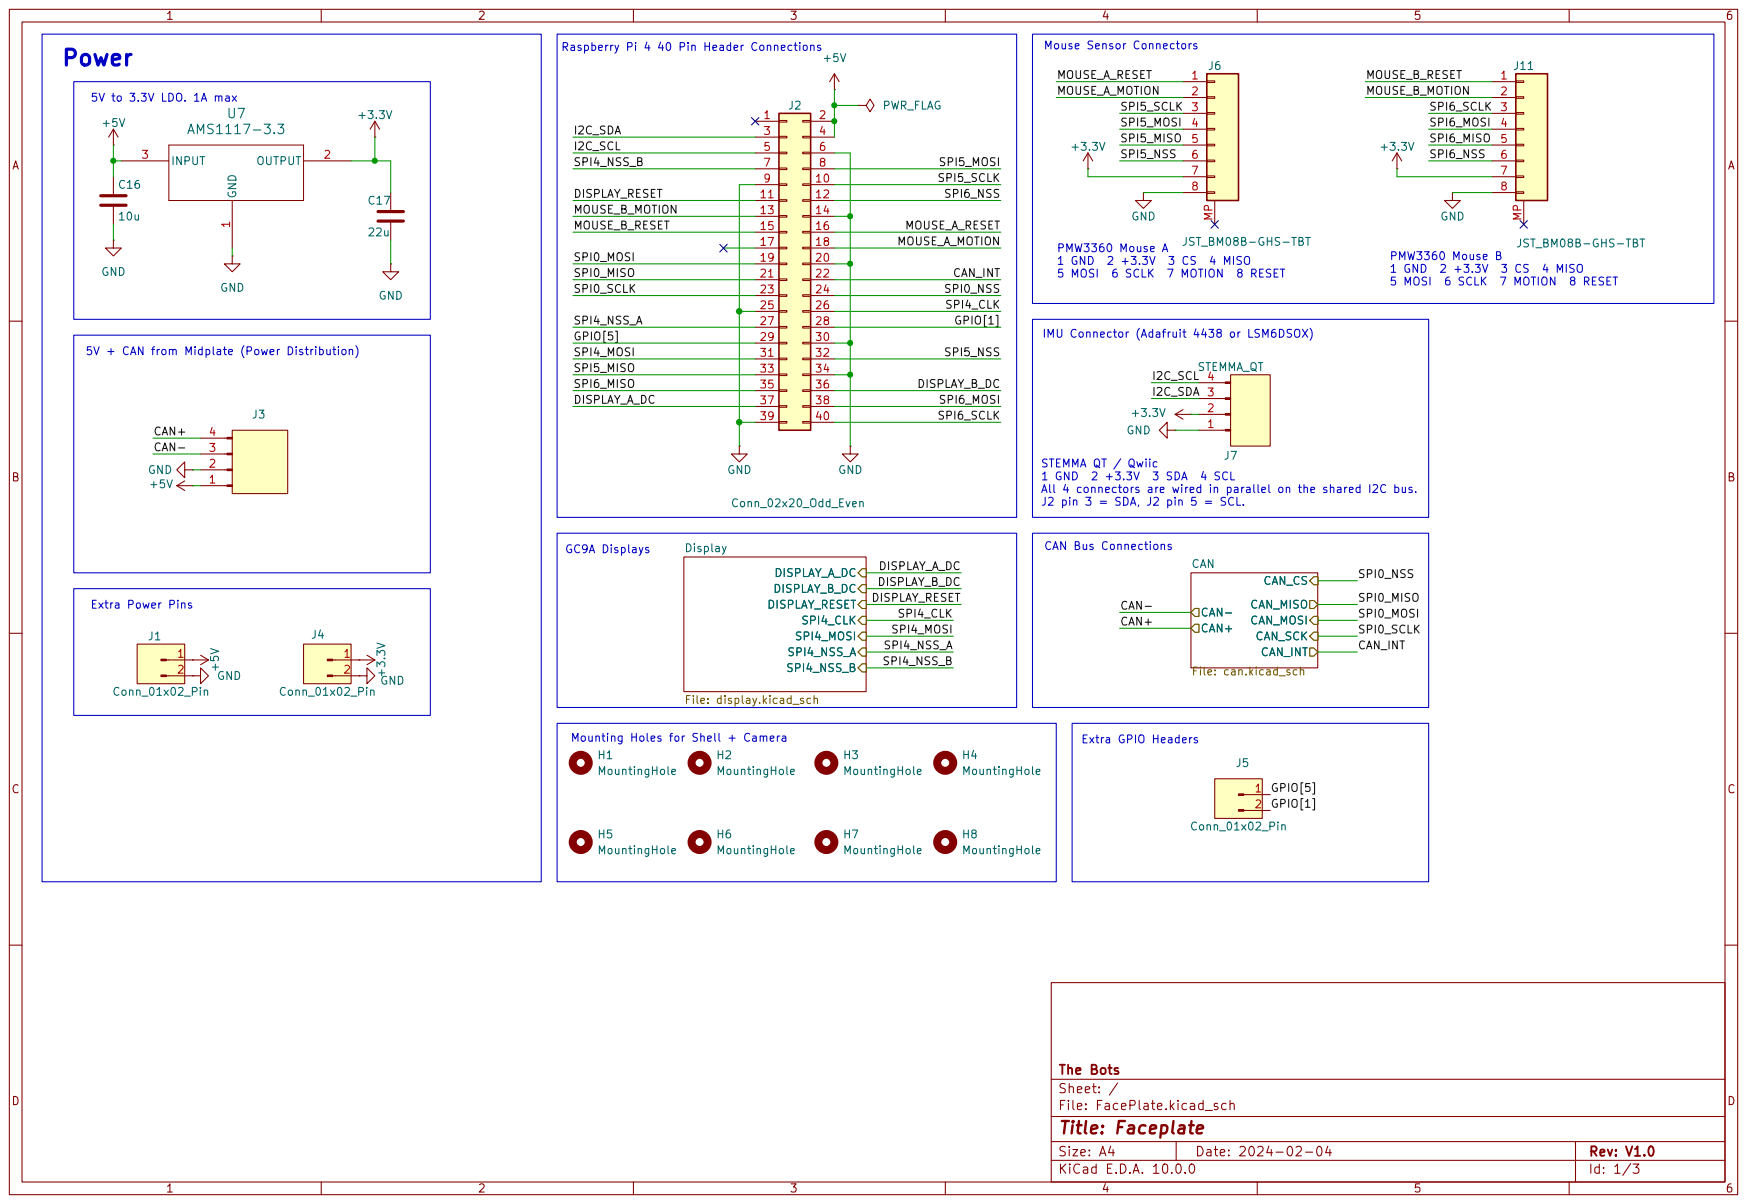
[picture p89: page 1]

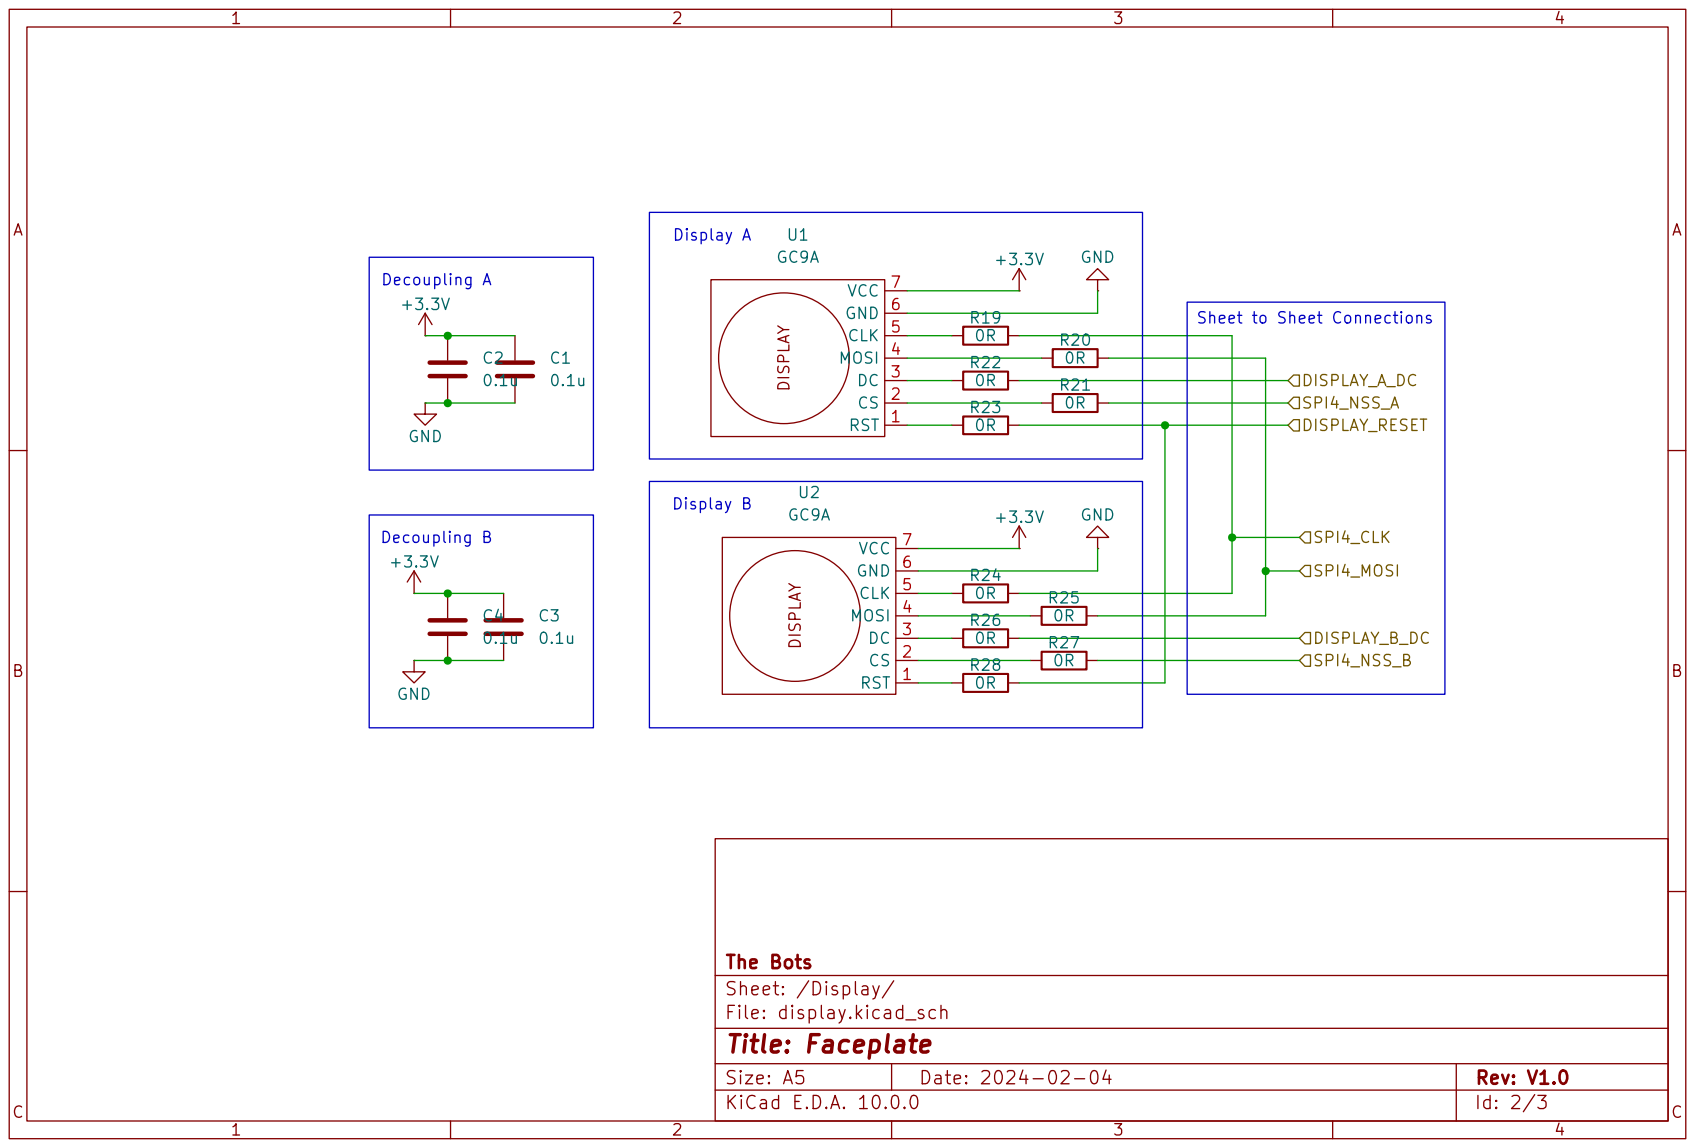
[picture p90: page 2]

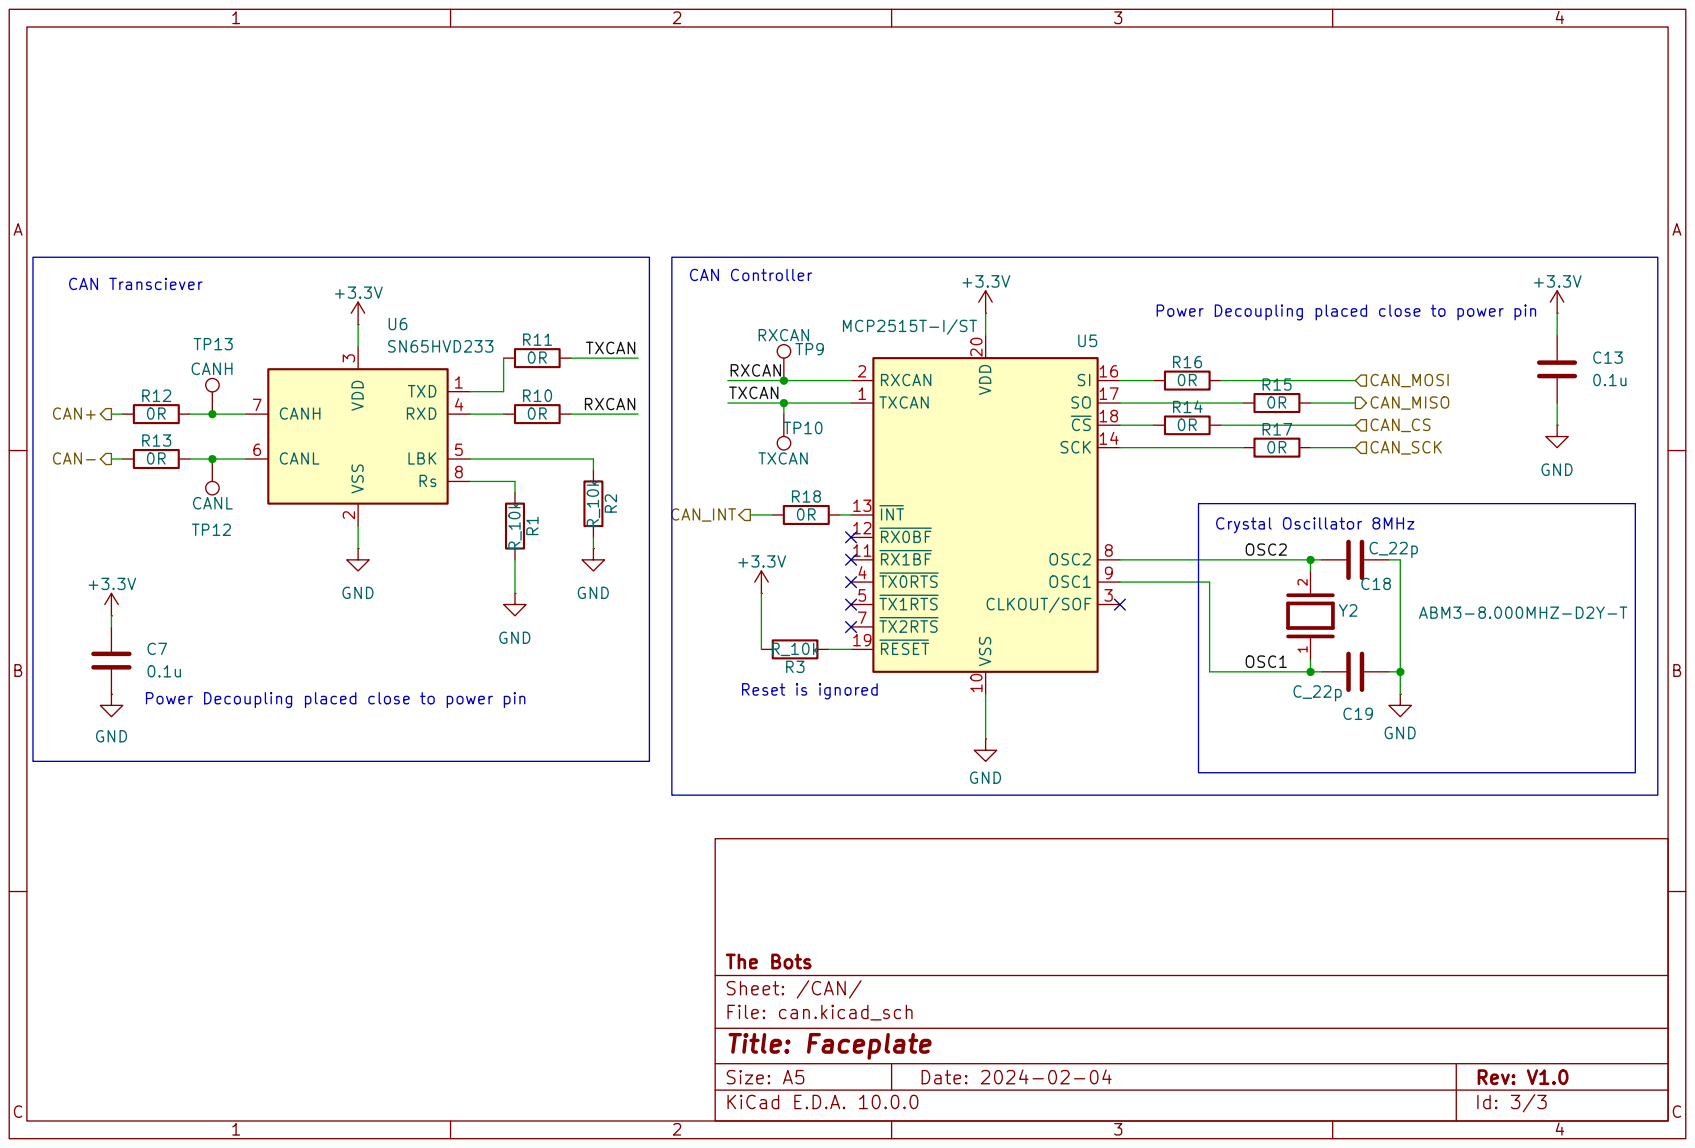
[picture p91: page 3]
