sfunderbots/Electrical/FacePlate/production/pcb.pdf

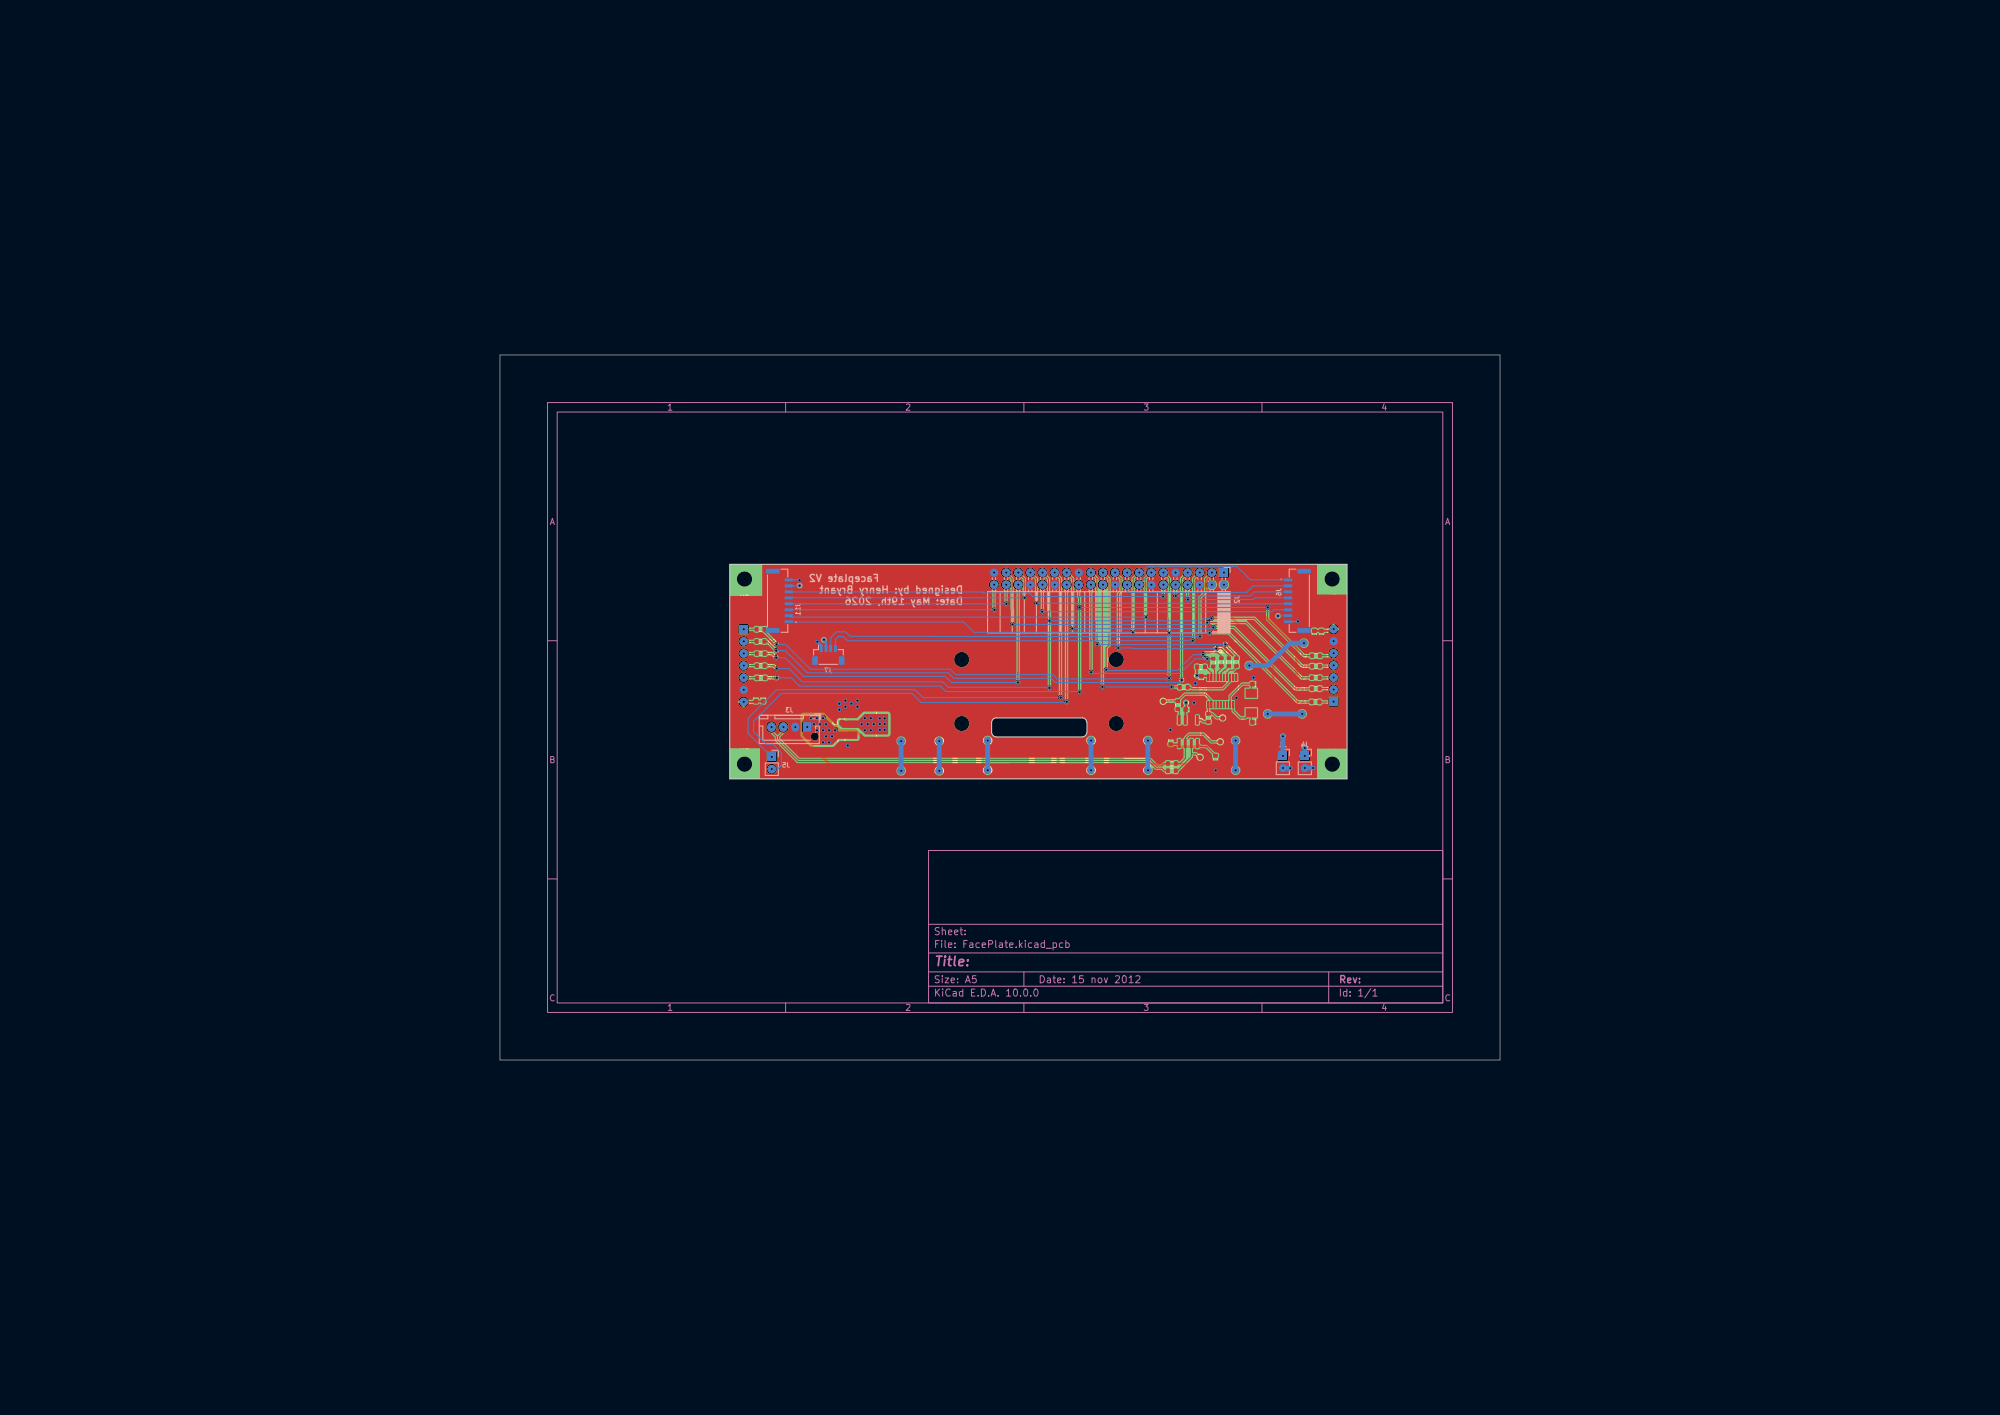
[picture p92: page 1]
