sfunderbots/Electrical/FacePlate/FacePlate.kicad_pcb

## KiCad design FacePlate/FacePlate.kicad_pcb (2026-06-10)

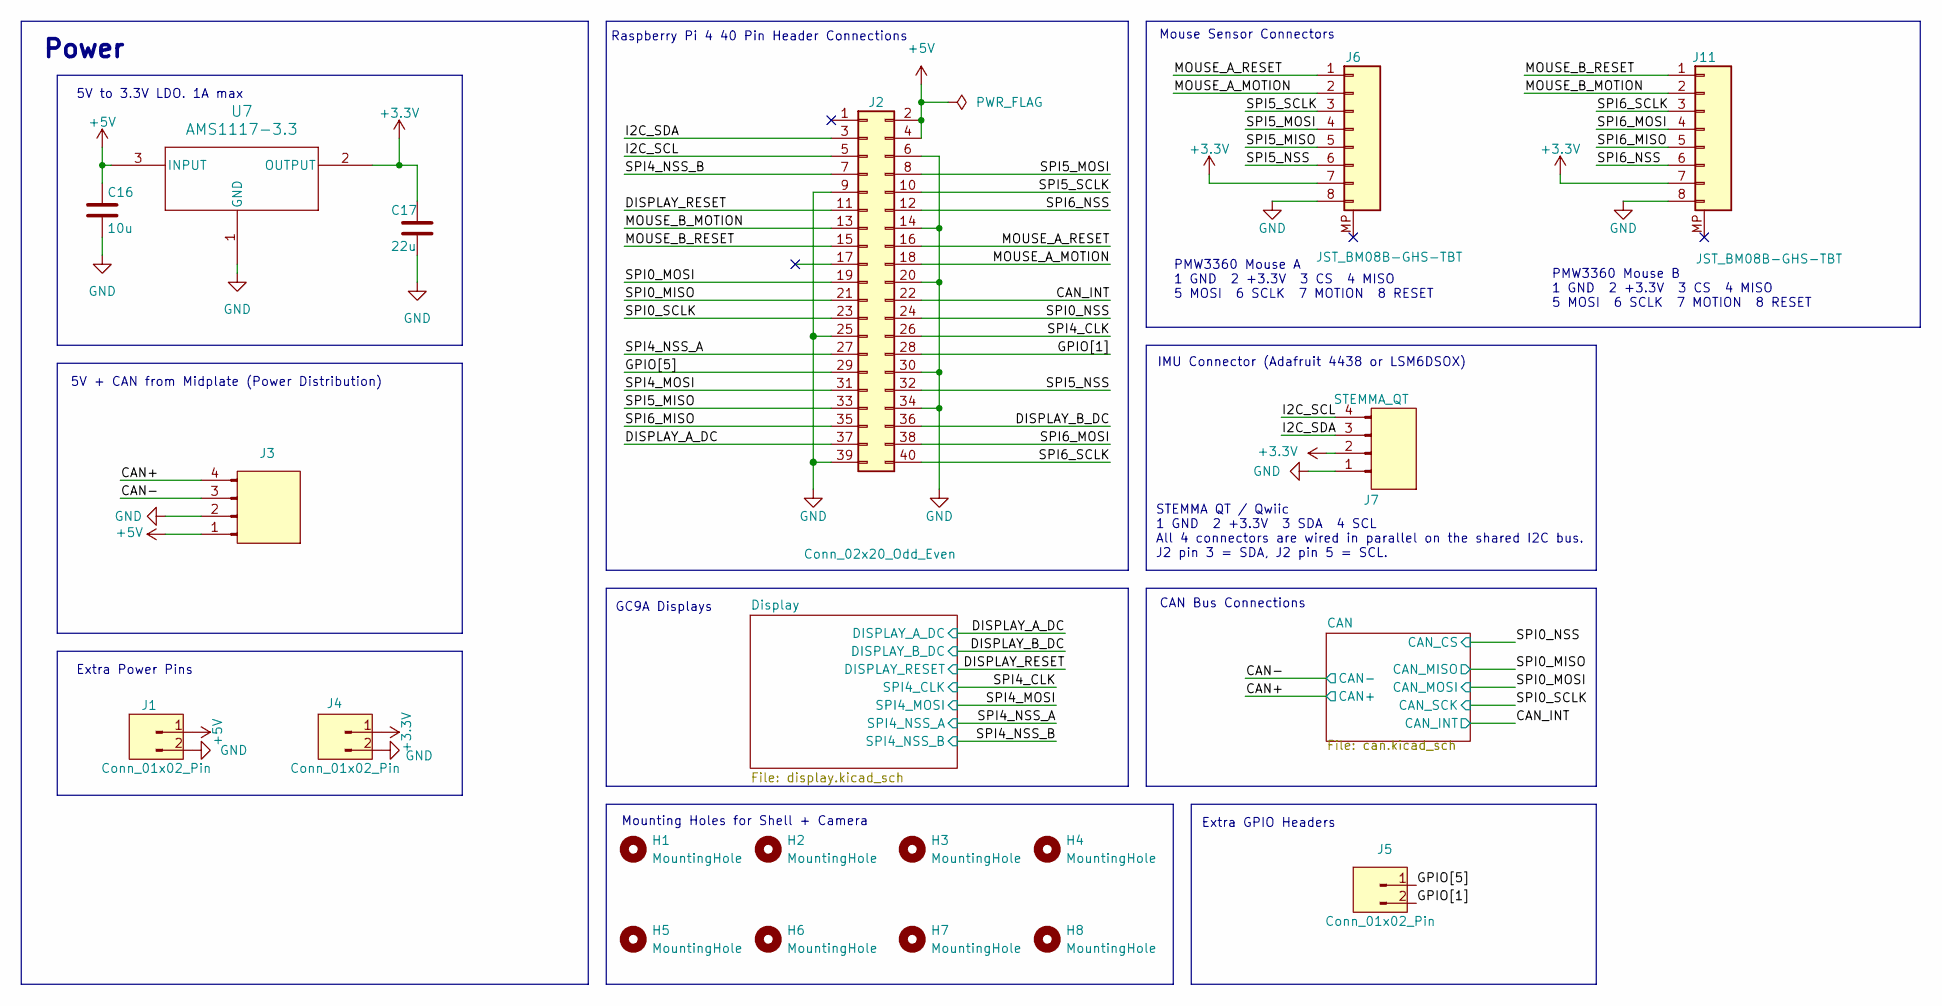
[picture p93: schematic FacePlate.kicad_sch]

Parts:
C16: 10u; C_0805_2012Metric; MPN GRM21BR61H106KE43L; LCSC C440198
C17: 22u; C_0603_1608Metric; LCSC C59461
H1, H2, H3, H4, H5, H6, H7, H8: MountingHole
J1, J4, J5: Conn_01x02_Pin; PinHeader_1x02_P2.54mm_Vertical
J2: Conn_02x20_Odd_Even; PinSocket_2x20_P2.54mm_Horizontal
J3: Conn_01x04_Pin; JST_XH_B4B-XH-AM_1x04_P2.50mm_Vertical
J6, J11: JST_BM08B-GHS-TBT; JST_BM08B-GHS-TBT_LF__SN__N_; MPN BM08B-GHS-TBT(LF)(SN); LCSC C133062
J7: STEMMA_QT; JST_SH_BM04B-SRSS-TB_1x04-1MP_P1.00mm_Vertical
U7: AMS1117-3.3; SOT-223-3_TabPin2; MPN AMS1117-3.3; LCSC C6186

Connections:
+3.3V: C17.1, J4.1, J6.7, J7.2, J11.7, U7.2 (OUTPUT); also elsewhere on the board
+5V: C16.1, J1.1, J2.2, J2.4, J3.1, U7.3 (INPUT)
/CAN+: J3.4; also elsewhere on the board
/CAN-: J3.3; also elsewhere on the board
/CAN_INT: J2.22; also elsewhere on the board
/DISPLAY_A_DC: J2.37; also elsewhere on the board
/DISPLAY_B_DC: J2.36; also elsewhere on the board
/DISPLAY_RESET: J2.11; also elsewhere on the board
/GPIO[1]: J2.28, J5.2
/GPIO[5]: J2.29, J5.1
/I2C_SCL: J2.5, J7.4
/I2C_SDA: J2.3, J7.3
/MOUSE_A_MOTION: J2.18, J6.2
/MOUSE_A_RESET: J2.16, J6.1
/MOUSE_B_MOTION: J2.13, J11.2
/MOUSE_B_RESET: J2.15, J11.1
/SPI0_MISO: J2.21; also elsewhere on the board
/SPI0_MOSI: J2.19; also elsewhere on the board
/SPI0_NSS: J2.24; also elsewhere on the board
/SPI0_SCLK: J2.23; also elsewhere on the board
/SPI4_CLK: J2.26; also elsewhere on the board
/SPI4_MOSI: J2.31; also elsewhere on the board
/SPI4_NSS_A: J2.27; also elsewhere on the board
/SPI4_NSS_B: J2.7; also elsewhere on the board
/SPI5_MISO: J2.33, J6.5
/SPI5_MOSI: J2.8, J6.4
/SPI5_NSS: J2.32, J6.6
/SPI5_SCLK: J2.10, J6.3
/SPI6_MISO: J2.35, J11.5
/SPI6_MOSI: J2.38, J11.4
/SPI6_NSS: J2.12, J11.6
/SPI6_SCLK: J2.40, J11.3
GND: C16.2, C17.2, J1.2, J2.6, J2.9, J2.14, J2.20, J2.25, J2.30, J2.34, J2.39, J3.2, J4.2, J6.8, J7.1, J11.8, U7.1 (GND); also elsewhere on the board

Notes on the sheet:
Mounting Holes for Shell + Camera
STEMMA QT / Qwiic 1 GND 2 +3.3V 3 SDA 4 SCL All 4 connectors are wired in parallel on the shared I2C bus. J2 pin 3 = SDA, J2 pin 5 = SCL.
Extra GPIO Headers
PMW3360 Mouse A 1 GND 2 +3.3V 3 CS 4 MISO 5 MOSI 6 SCLK 7 MOTION 8 RESET
Raspberry Pi 4 40 Pin Header Connections
GC9A Displays
IMU Connector (Adafruit 4438 or LSM6DSOX)
CAN Bus Connections
5V + CAN from Midplate (Power Distribution)
Mouse Sensor Connectors
Power
5V to 3.3V LDO. 1A max
PMW3360 Mouse B 1 GND 2 +3.3V 3 CS 4 MISO 5 MOSI 6 SCLK 7 MOTION 8 RESET
Extra Power Pins

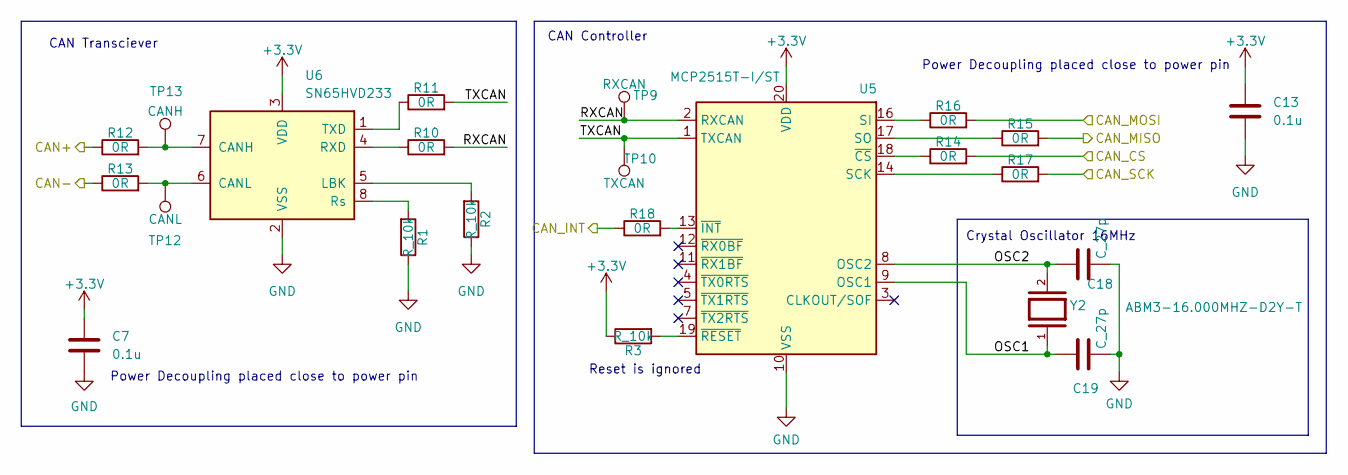
[picture p94: schematic can.kicad_sch, Faceplate]

Parts:
C7, C13: 0.1u; C_0603_1608Metric; MPN CC0603KRX7R9BB104; LCSC C14663
C18, C19: C_27p; C_0603_1608Metric; MPN CC0603JRNPO9BN270; JLC 0603
R1, R2, R3: R_10k; R_0603_1608Metric; MPN 0603WAF1002T5E; LCSC C25804
R10, R11, R12, R13, R14, R15, R16, R17, R18: 0R; R_0603_1608Metric; MPN 0603WAF0000T5E; LCSC C21189
TP9: RXCAN; TestPoint_Pad_D1.0mm
TP10: TXCAN; TestPoint_Pad_D1.0mm
TP12: CANL; TestPoint_Pad_D1.0mm
TP13: CANH; TestPoint_Pad_D1.0mm
U5: MCP2515T-I/ST; TSSOP-20_4.4x6.5mm_P0.65mm; MPN MCP2515T-I/ST; LCSC C185941
U6: SN65HVD233; SOIC-8_3.9x4.9mm_P1.27mm; MPN SN65HVD233; JLC 8-SOIC
Y2: ABM3-16.000MHZ-D2Y-T; ABM3; MPN ABM3-16.000MHZ-D2Y-T; JLC SMD5032-2P

Connections:
+3.3V: C7.1, C13.1, R3.1, U5.20 (VDD), U6.3 (VDD); also elsewhere on the board
/CAN+: R12.1; also elsewhere on the board
/CAN-: R13.1; also elsewhere on the board
/CAN/OSC1: C19.1, U5.9 (OSC1), Y2.1
/CAN/OSC2: C18.1, U5.8 (OSC2), Y2.2
/CAN/RXCAN: R10.2, TP9.1 (1_1), U5.2 (RXCAN)
/CAN/TXCAN: R11.2, TP10.1 (1_1), U5.1 (TXCAN)
/CAN_INT: R18.1; also elsewhere on the board
/SPI0_MISO: R15.2; also elsewhere on the board
/SPI0_MOSI: R16.2; also elsewhere on the board
/SPI0_NSS: R14.2; also elsewhere on the board
/SPI0_SCLK: R17.2; also elsewhere on the board
GND: C7.2, C13.2, C18.2, C19.2, R1.1, R2.1, U5.10 (VSS), U6.2 (VSS); also elsewhere on the board
unnamed: R17.1, U5.14 (SCK)
unnamed: R16.1, U5.16 (SI)
unnamed: R15.1, U5.17 (SO)
unnamed: R14.1, U5.18 (~CS)
unnamed: R18.2, U5.13 (~INT)
unnamed: R3.2, U5.19 (~RESET)
unnamed: R12.2, TP13.1 (1_1), U6.7 (CANH)
unnamed: R13.2, TP12.1 (1_1), U6.6 (CANL)
unnamed: R2.2, U6.5 (LBK)
unnamed: R10.1, U6.4 (RXD)
unnamed: R1.2, U6.8 (Rs)
unnamed: R11.1, U6.1 (TXD)

Notes on the sheet:
Power Decoupling placed close to power pin
CAN Controller
CAN Transciever
Reset is ignored
Crystal Oscillator 16MHz

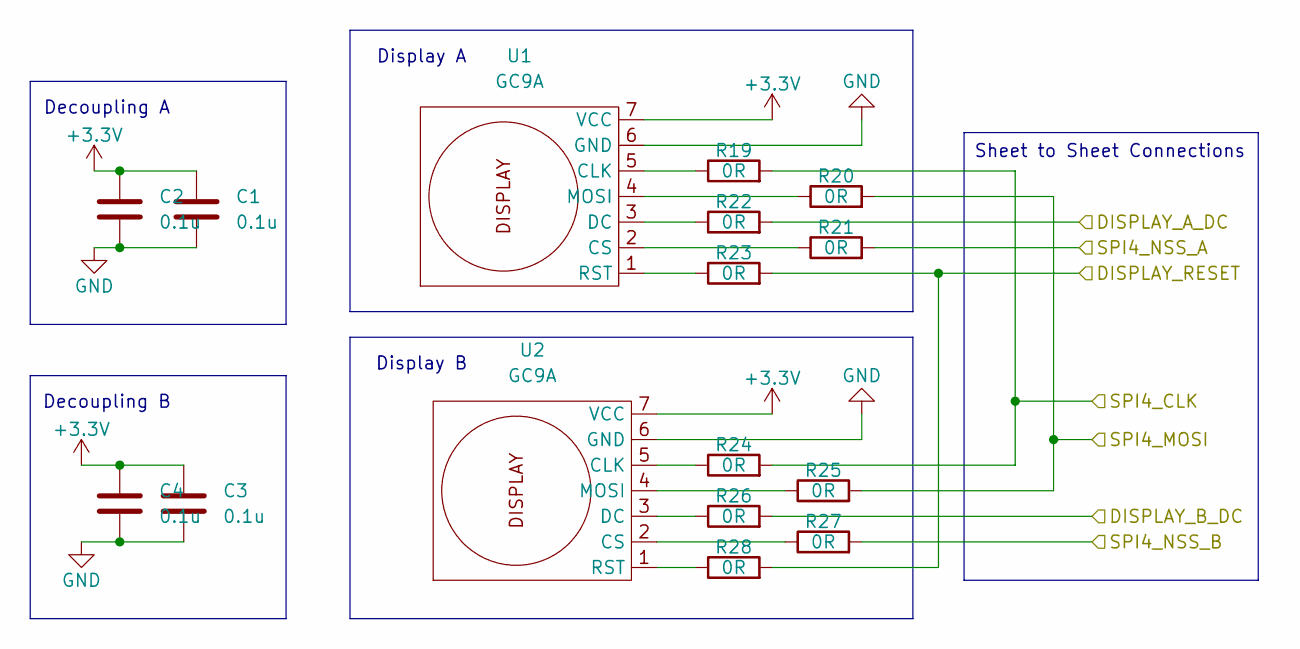
[picture p95: schematic display.kicad_sch, Faceplate]

Parts:
C1, C2, C3, C4: 0.1u; C_0603_1608Metric; MPN CC0603KRX7R9BB104; LCSC C14663
R19, R20, R21, R22, R23, R24, R25, R26, R27, R28: 0R; R_0603_1608Metric; MPN 0603WAF0000T5E; LCSC C21189
U1, U2: GC9A; GC9A_Display

Connections:
+3.3V: C1.1, C2.1, C3.1, C4.1, U1.7 (VCC), U2.7 (VCC); also elsewhere on the board
/DISPLAY_A_DC: R22.2; also elsewhere on the board
/DISPLAY_B_DC: R26.2; also elsewhere on the board
/DISPLAY_RESET: R23.2, R28.2; also elsewhere on the board
/SPI4_CLK: R19.2, R24.2; also elsewhere on the board
/SPI4_MOSI: R20.2, R25.2; also elsewhere on the board
/SPI4_NSS_A: R21.2; also elsewhere on the board
/SPI4_NSS_B: R27.2; also elsewhere on the board
GND: C1.2, C2.2, C3.2, C4.2, U1.6 (GND), U2.6 (GND); also elsewhere on the board
unnamed: R19.1, U1.5 (CLK)
unnamed: R21.1, U1.2 (CS)
unnamed: R22.1, U1.3 (DC)
unnamed: R20.1, U1.4 (MOSI)
unnamed: R23.1, U1.1 (RST)
unnamed: R24.1, U2.5 (CLK)
unnamed: R27.1, U2.2 (CS)
unnamed: R26.1, U2.3 (DC)
unnamed: R25.1, U2.4 (MOSI)
unnamed: R28.1, U2.1 (RST)

Notes on the sheet:
Display B
Display A
Decoupling B
Decoupling A
Sheet to Sheet Connections

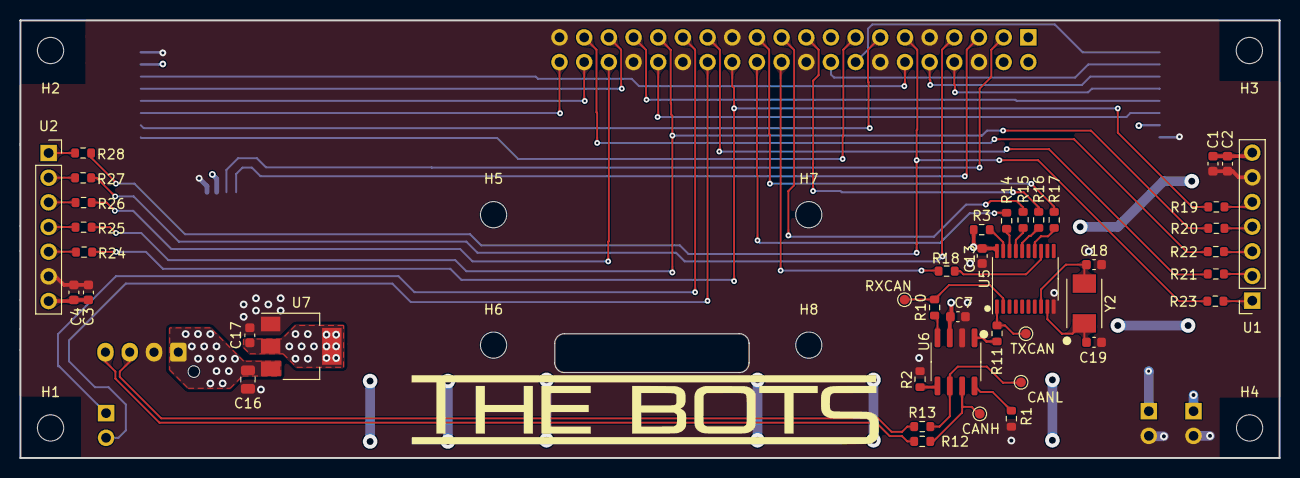
[picture p96: board FacePlate.kicad_pcb from above]

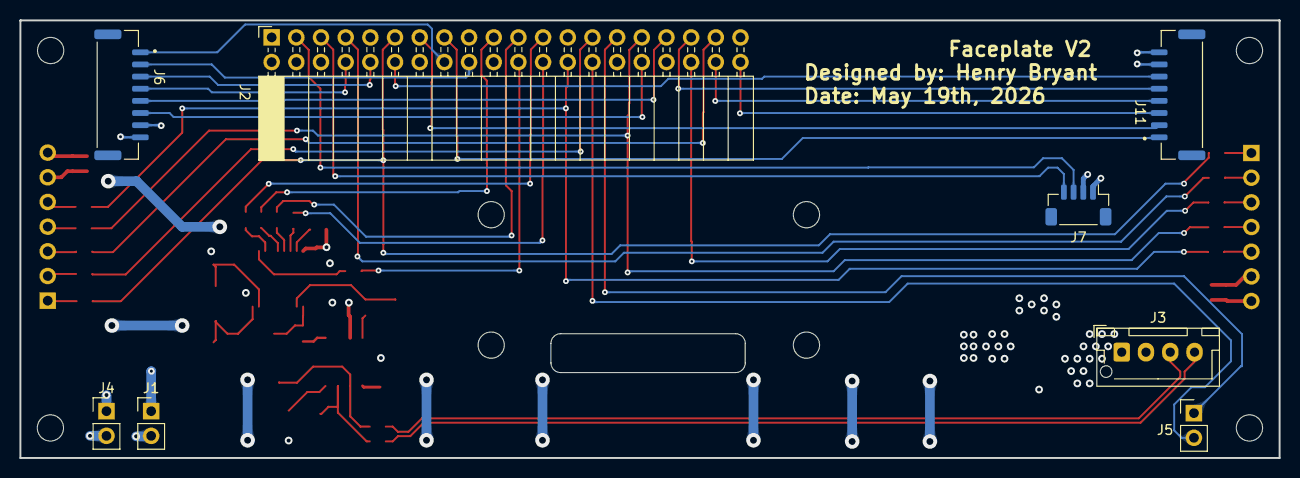
[picture p97: board FacePlate.kicad_pcb from below]

Board: 4 copper layers, 129.6 x 45.0 mm, 58 parts (8 on the bottom side), 59 nets.
