sfunderbots/Electrical/BasePlate/BasePlate.kicad_pcb

## KiCad design BasePlate/BasePlate.kicad_pcb (2026-05-29)

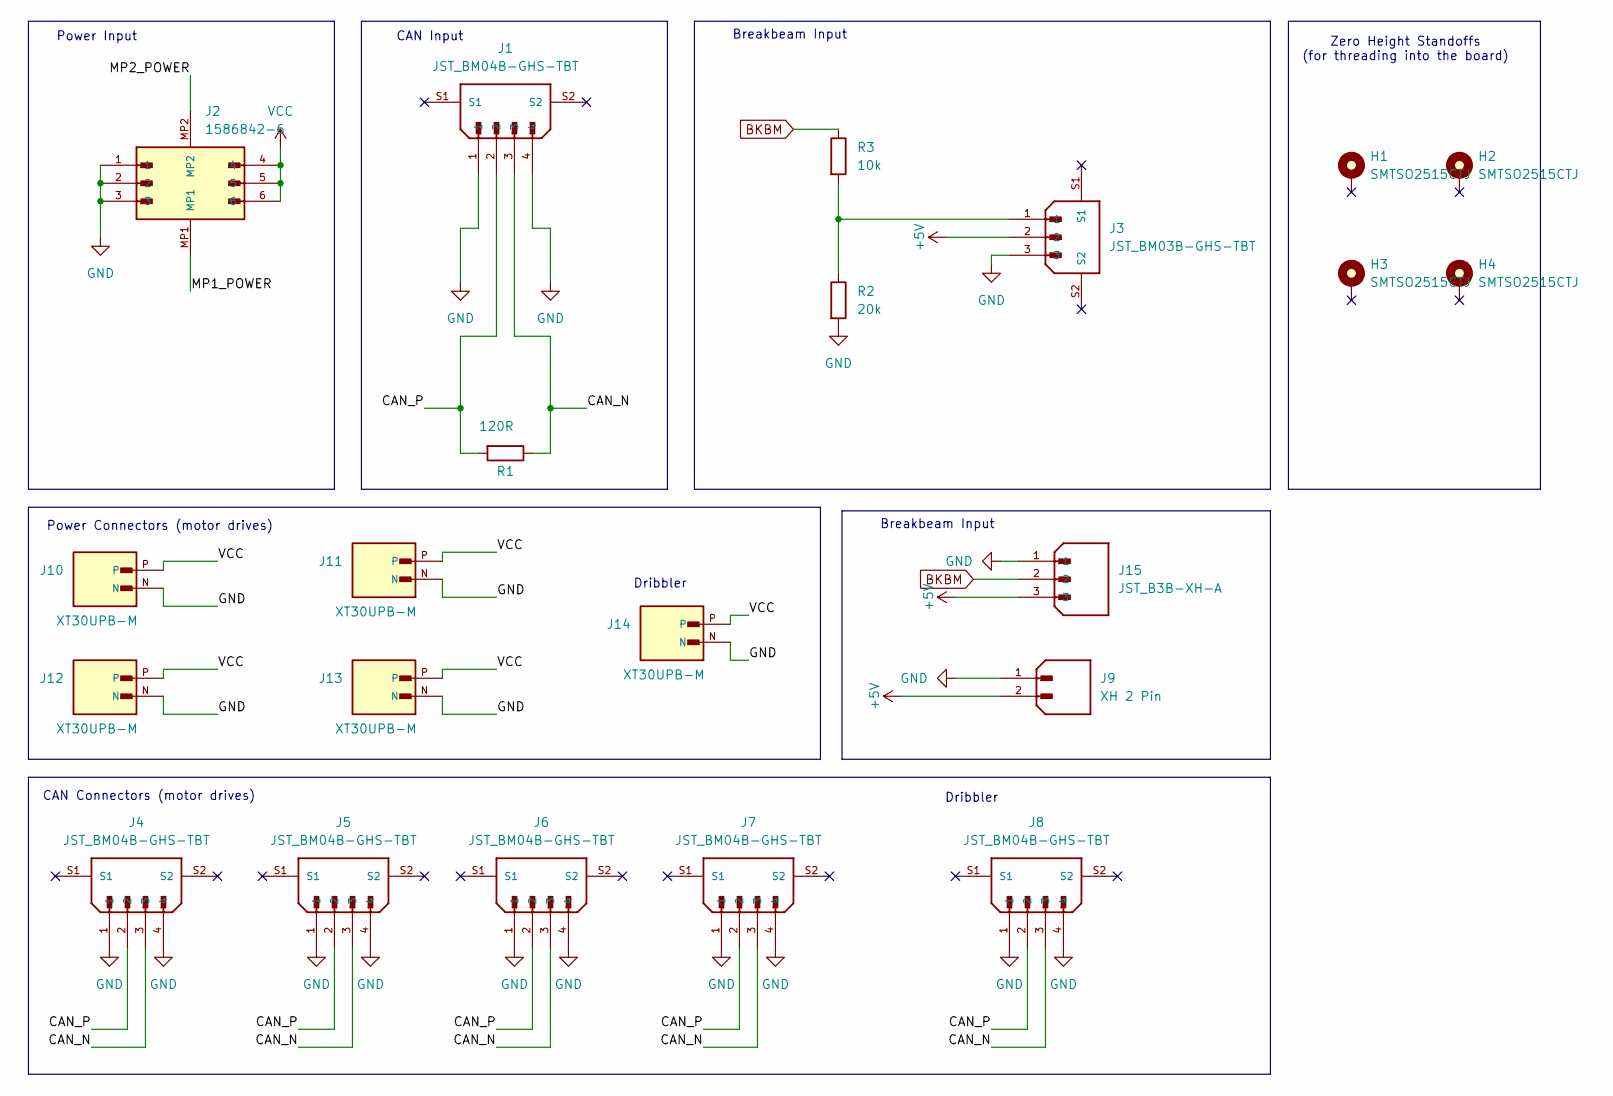
[picture p98: schematic BasePlate.kicad_sch]

Parts:
H1, H2, H3, H4: SMTSO2515CTJ; LCSC C2915629
J1, J4, J5, J6, J7, J8: JST_BM04B-GHS-TBT; MPN BM04B-GHS-TBT; JLC SMD,P=1.25mm
J2: 1586842-6; TE_1586842-6_6PIN
J3: JST_BM03B-GHS-TBT; MPN BM03B-GHS-TBT; JLC SMD,P=1.25mm
J9: XH 2 Pin; JST_B2B-XH-A_LF__SN_
J10, J11, J12, J13, J14: XT30UPB-M; AMASS_XT30UPB-M
J15: JST_B3B-XH-A; MPN B3B-XH-A(LF)(SN)
R1: 120R; R_0603_1608Metric; MPN 0603WAF1200T5E; JLC 0603
R2: 20k; R_0603_1608Metric
R3: 10k; R_0603_1608Metric

Connections:
+5V: J3.2, J9.2, J15.3
/CAN_N: J1.3, J4.3, J5.3, J6.3, J7.3, J8.3, R1.1
/CAN_P: J1.2, J4.2, J5.2, J6.2, J7.2, J8.2, R1.2
/MP1_POWER: J2.MP1
/MP2_POWER: J2.MP2
BKBM: J15.2, R3.1
GND: J1.1, J1.4, J2.1, J2.2, J2.3, J3.3, J4.1, J4.4, J5.1, J5.4, J6.1, J6.4, J7.1, J7.4, J8.1, J8.4, J9.1, J10.N, J11.N, J12.N, J13.N, J14.N, J15.1, R2.2
unnamed: J3.1, R2.1, R3.2
VCC: J2.4, J2.5, J2.6, J10.P, J11.P, J12.P, J13.P, J14.P

Notes on the sheet:
Dribbler
CAN Input
Breakbeam Input
Zero Height Standoffs (for threading into the board)
Power Input
CAN Connectors (motor drives)
Power Connectors (motor drives)

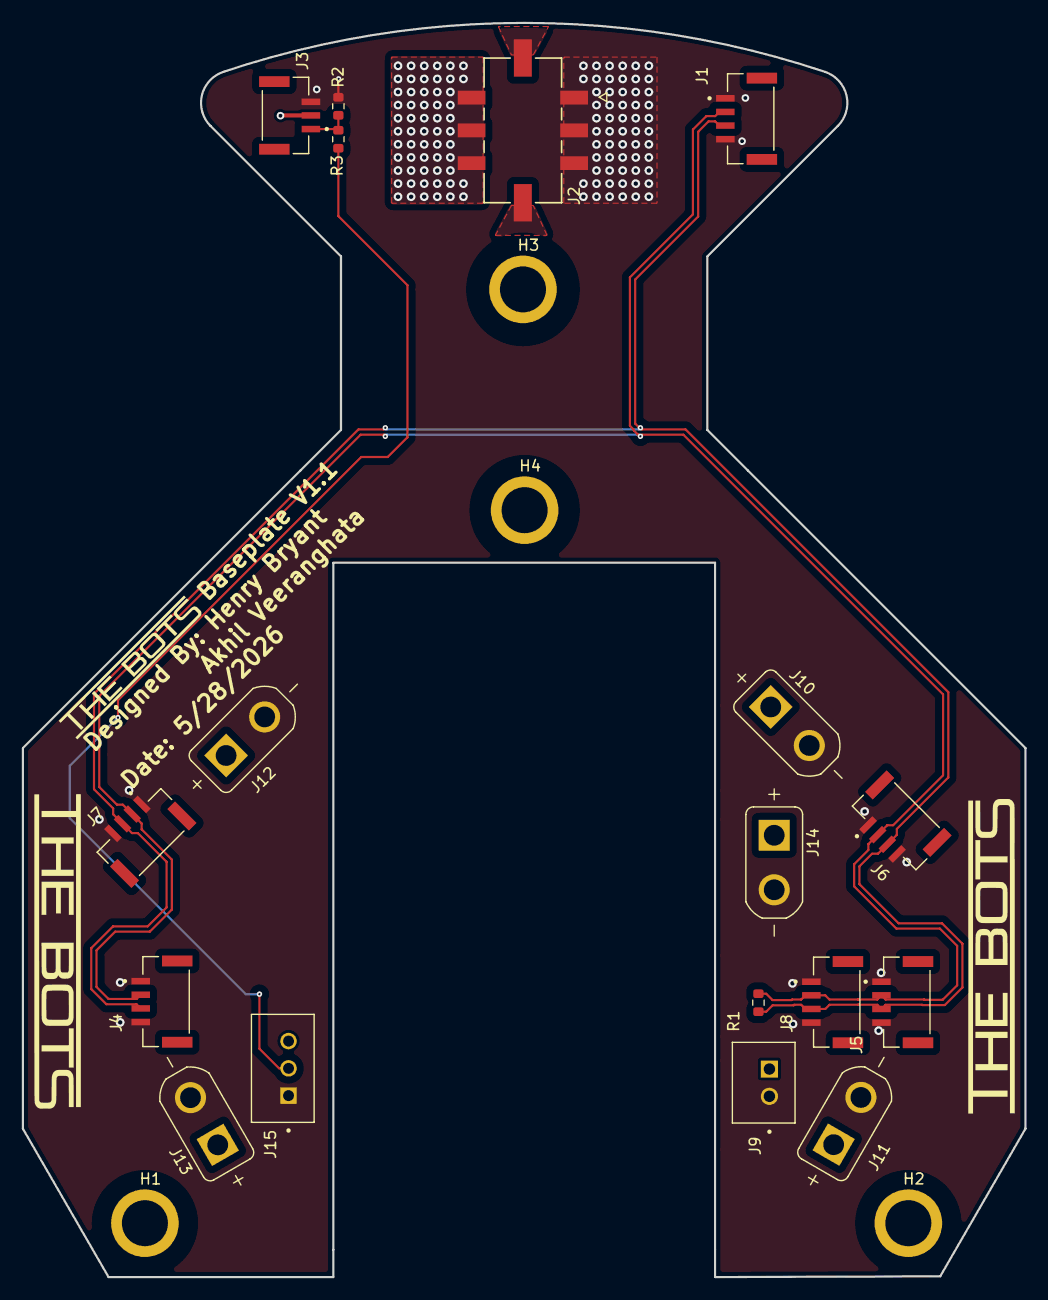
[picture p99: board BasePlate.kicad_pcb from above]

Board: 4 copper layers, 91.9 x 115.0 mm, 22 parts (0 on the bottom side), 7 nets.
