sfunderbots/Electrical/MidPlate/midplate.kicad_pcb

## KiCad design MidPlate/midplate.kicad_pcb (2026-05-18)

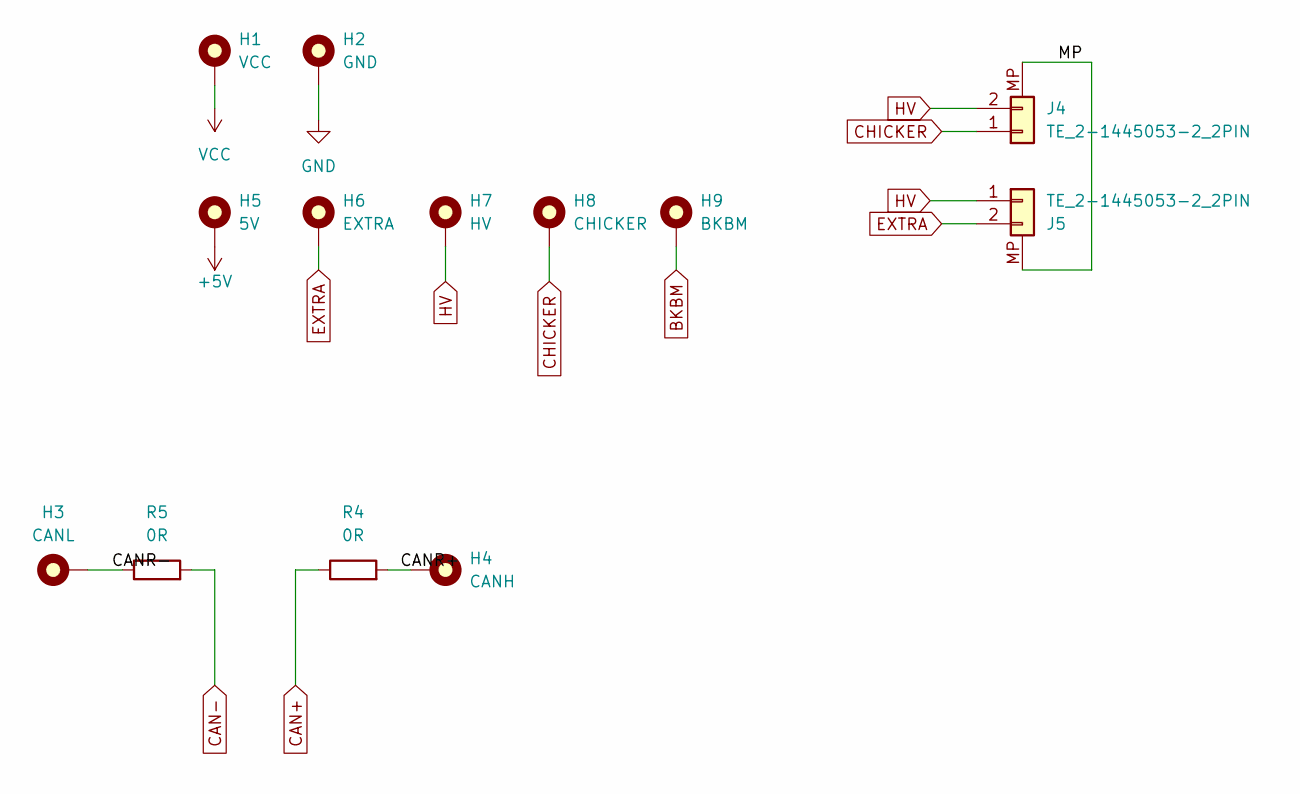
[picture p100: schematic powerboard-conn.kicad_sch]

Parts:
H1: VCC; SMTSO2515CTJ; LCSC C2915629
H2: GND; SMTSO2515CTJ; LCSC C2915629
H3: CANL; SMTSO2515CTJ; LCSC C2915629
H4: CANH; SMTSO2515CTJ; LCSC C2915629
H5: 5V; SMTSO2515CTJ; LCSC C2915629
H6: EXTRA; SMTSO2515CTJ; LCSC C2915629
H7: HV; SMTSO2515CTJ; LCSC C2915629
H8: CHICKER; SMTSO2515CTJ; LCSC C2915629
H9: BKBM; SMTSO2515CTJ; LCSC C2915629
J4, J5: TE_2-1445053-2_2PIN; MPN 2-1445053-2
R4, R5: 0R; R_0603_1608Metric; MPN 0603WAF0000T5E; JLC 0603

Connections:
+5V: H5.1 (1_1); also elsewhere on the board
/Power Board Connections/CANR+: H4.1 (1_1), R4.2
/Power Board Connections/CANR-: H3.1 (1_1), R5.1
/Power Board Connections/MP: J4.MP, J5.MP
BKBM: H9.1 (1_1); also elsewhere on the board
CAN+: R4.1; also elsewhere on the board
CAN-: R5.2; also elsewhere on the board
CHICKER: H8.1 (1_1), J4.1
EXTRA: H6.1 (1_1), J5.2
GND: H2.1 (1_1); also elsewhere on the board
HV: H7.1 (1_1), J4.2, J5.1
VCC: H1.1 (1_1); also elsewhere on the board

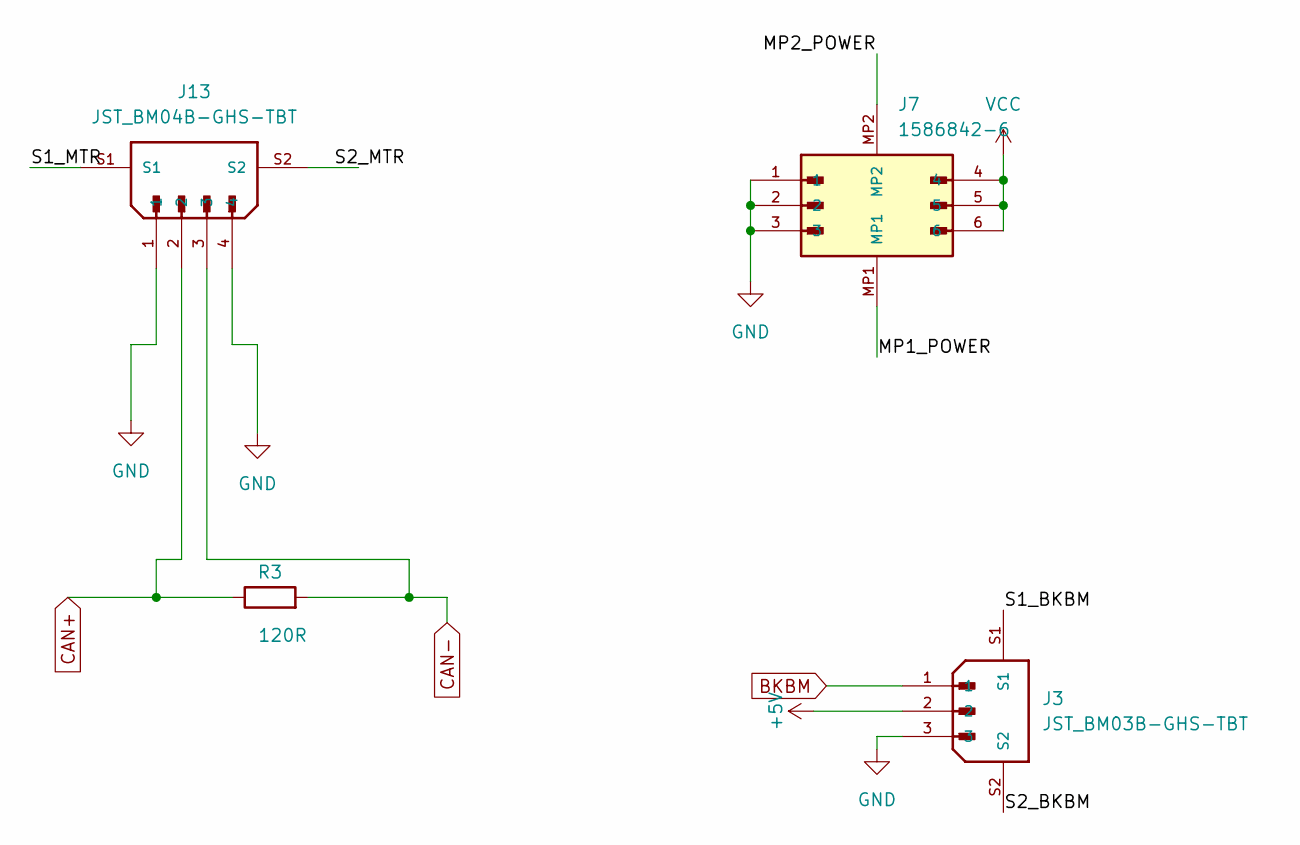
[picture p101: schematic baseplate-conn.kicad_sch]

Parts:
J3: JST_BM03B-GHS-TBT; MPN BM03B-GHS-TBT
J7: 1586842-6; TE_1586842-6_6PIN
J13: JST_BM04B-GHS-TBT; MPN BM04B-GHS-TBT
R3: 120R; R_0603_1608Metric; MPN 0603WAF1200T5E; JLC 0603

Connections:
+5V: J3.2; also elsewhere on the board
/Baseplate Connections/MP1_POWER: J7.MP1
/Baseplate Connections/MP2_POWER: J7.MP2
/Baseplate Connections/S1_BKBM: J3.S1
/Baseplate Connections/S1_MTR: J13.S1
/Baseplate Connections/S2_BKBM: J3.S2
/Baseplate Connections/S2_MTR: J13.S2
BKBM: J3.1; also elsewhere on the board
CAN+: J13.2, R3.1; also elsewhere on the board
CAN-: J13.3, R3.2; also elsewhere on the board
GND: J3.3, J7.1, J7.2, J7.3, J13.1, J13.4; also elsewhere on the board
VCC: J7.4, J7.5, J7.6; also elsewhere on the board

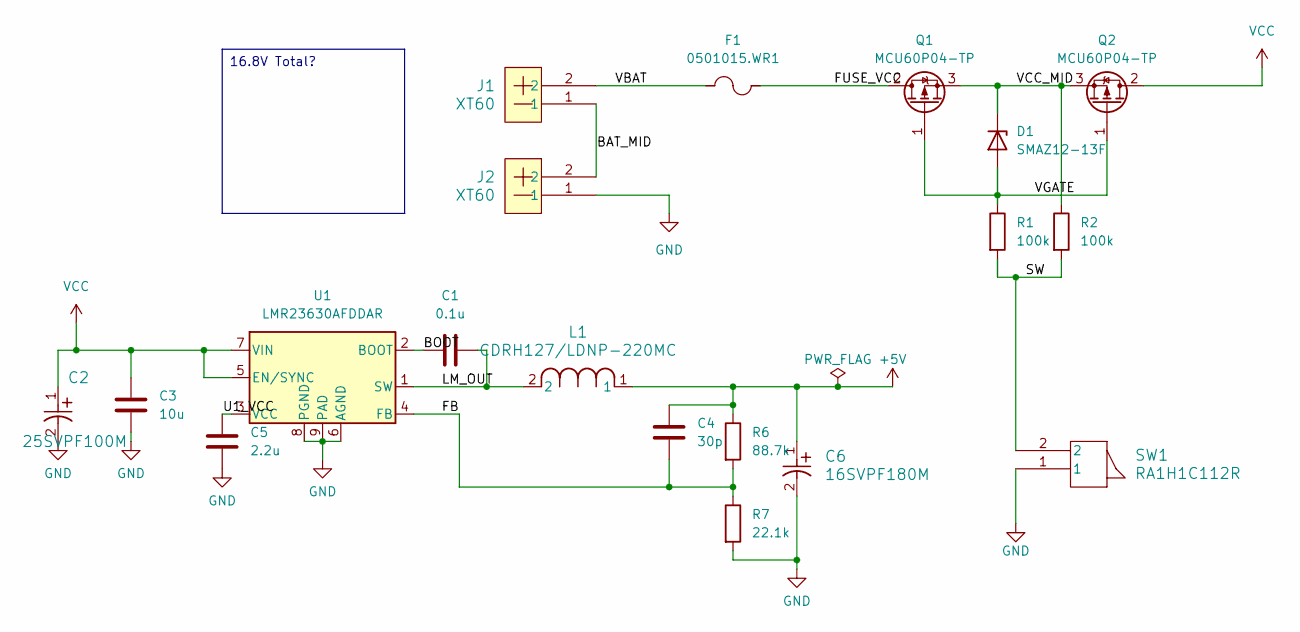
[picture p102: schematic power-input.kicad_sch]

Parts:
C1: 0.1u; C_0603_1608Metric; MPN CC0603KRX7R9BB104; JLC 0603
C2: 25SVPF100M; CAP_25SVPF100M; LCSC C136279
C3: 10u; C_0805_2012Metric; MPN GRM21BR61H106KE43L; JLC 0805
C4: 30p; C_0603_1608Metric; MPN CC0603JRNPO9BN270; JLC 0603
C5: 2.2u; C_1206_3216Metric; JLC 1206
C6: 16SVPF180M; CAP_16SVPF180M; LCSC C136277
D1: SMAZ12-13F; D_SMB; MPN SMAZ12-13F; LCSC C260227
F1: 0501015.WR1; Fuse_1206_3216Metric; MPN 0501015.WR1; JLC 1206
J1, J2: XT60; XT60_12-14AWG_POWER
L1: CDRH127/LDNP-220MC; IND_CDRH127_LDNP-470MC_SUM; LCSC C879420
Q1, Q2: MCU60P04-TP; DPAK-3_ONS; LCSC C130101
R1, R2: 100k; R_0603_1608Metric; MPN 0603WAF1003T5E; JLC 0603
R6: 88.7k; R_0603_1608Metric; MPN 0603WAF4752T5E; JLC 0603
R7: 22.1k; R_0603_1608Metric; MPN 0603WAF4752T5E; JLC 0603
SW1: RA1H1C112R; SW_RA1H1C112R
U1: LMR23630AFDDAR; TI_SO-PowerPAD-8_ThermalVias; MPN LMR23630AFDDAR; JLC SO-8

Connections:
+5V: C4.1, C6.1, L1.1, R6.1; also elsewhere on the board
/Power Input/BAT_MID: J1.1, J2.2
/Power Input/BOOT: C1.1, U1.2 (BOOT)
/Power Input/FB: C4.2, R6.2, R7.1, U1.4 (FB)
/Power Input/FUSE_VCC: F1.2, Q1.2 (D)
/Power Input/LM_OUT: C1.2, L1.2, U1.1 (SW)
/Power Input/SW: R1.2, R2.2, SW1.2
/Power Input/U1_VCC: C5.1, U1.3 (VCC)
/Power Input/VBAT: F1.1, J1.2
/Power Input/VCC_MID: D1.1 (K), Q1.3 (S), Q2.3 (S), R2.1
/Power Input/VGATE: D1.2 (A), Q1.1 (G), Q2.1 (G), R1.1
GND: C2.2, C3.2, C5.2, C6.2, J2.1, R7.2, SW1.1, U1.6 (AGND), U1.8 (PGND), U1.9 (PAD); also elsewhere on the board
VCC: C2.1, C3.1, Q2.2 (D), U1.5 (EN/SYNC), U1.7 (VIN); also elsewhere on the board

Notes on the sheet:
16.8V Total?

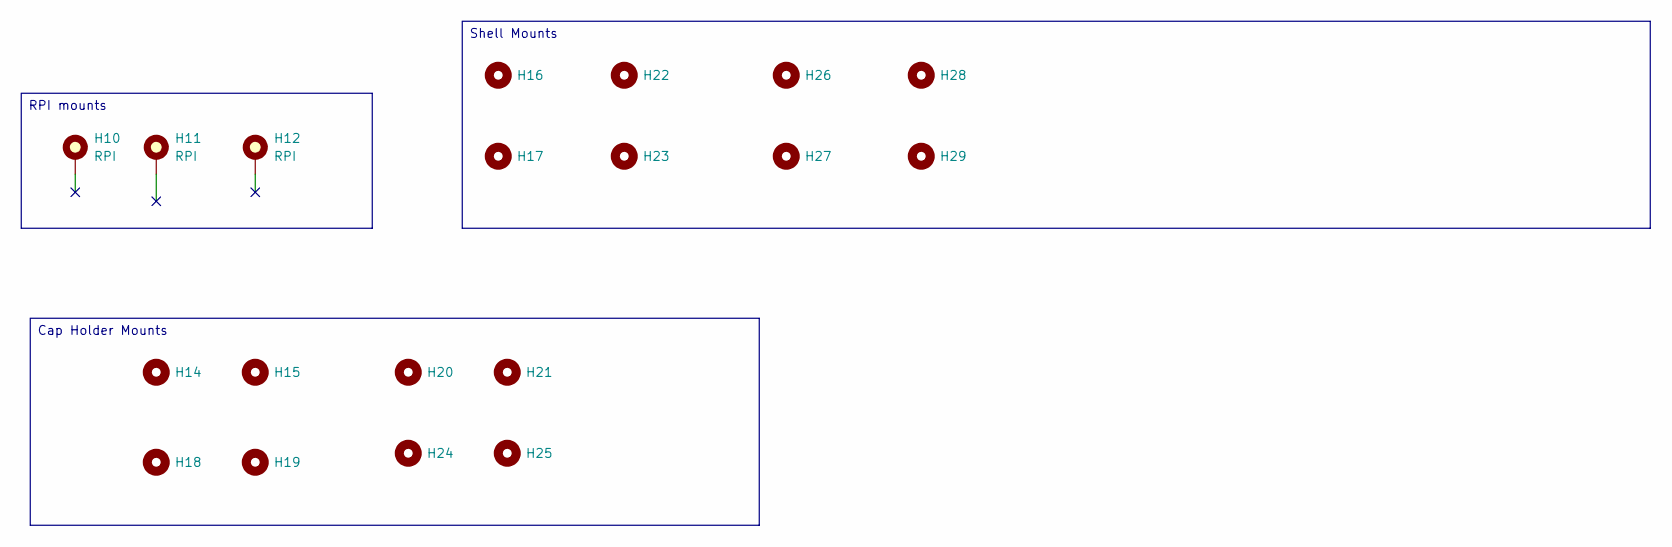
[picture p103: schematic mounting_holes.kicad_sch]

Parts:
H10, H11, H12: RPI; SMTSO2515CTJ
H14, H15, H16, H17, H18, H19, H20, H21, H22, H23, H24, H25, H26, H27, H28, H29: MountingHoleM2.5NoThread; MountingHole_2.7mm_M2.5_DIN965_Pad

Notes on the sheet:
Cap Holder Mounts
RPI mounts
Shell Mounts

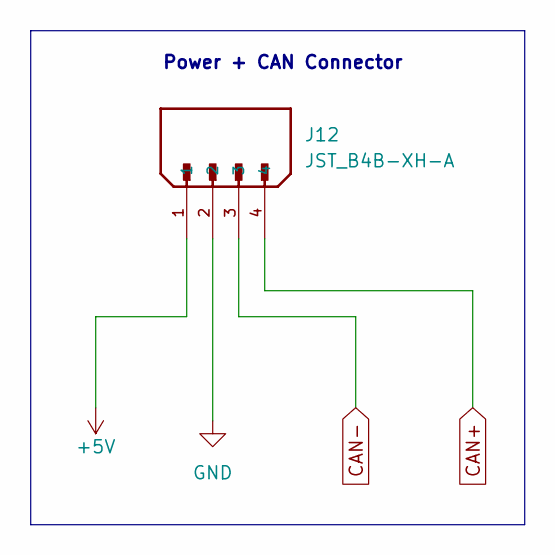
[picture p104: schematic faceplate.kicad_sch]

Parts:
J12: JST_B4B-XH-A; MPN B4B-XH-A(LF)(SN)

Connections:
+5V: J12.1; also elsewhere on the board
CAN+: J12.4; also elsewhere on the board
CAN-: J12.3; also elsewhere on the board
GND: J12.2; also elsewhere on the board

Notes on the sheet:
Power + CAN Connector

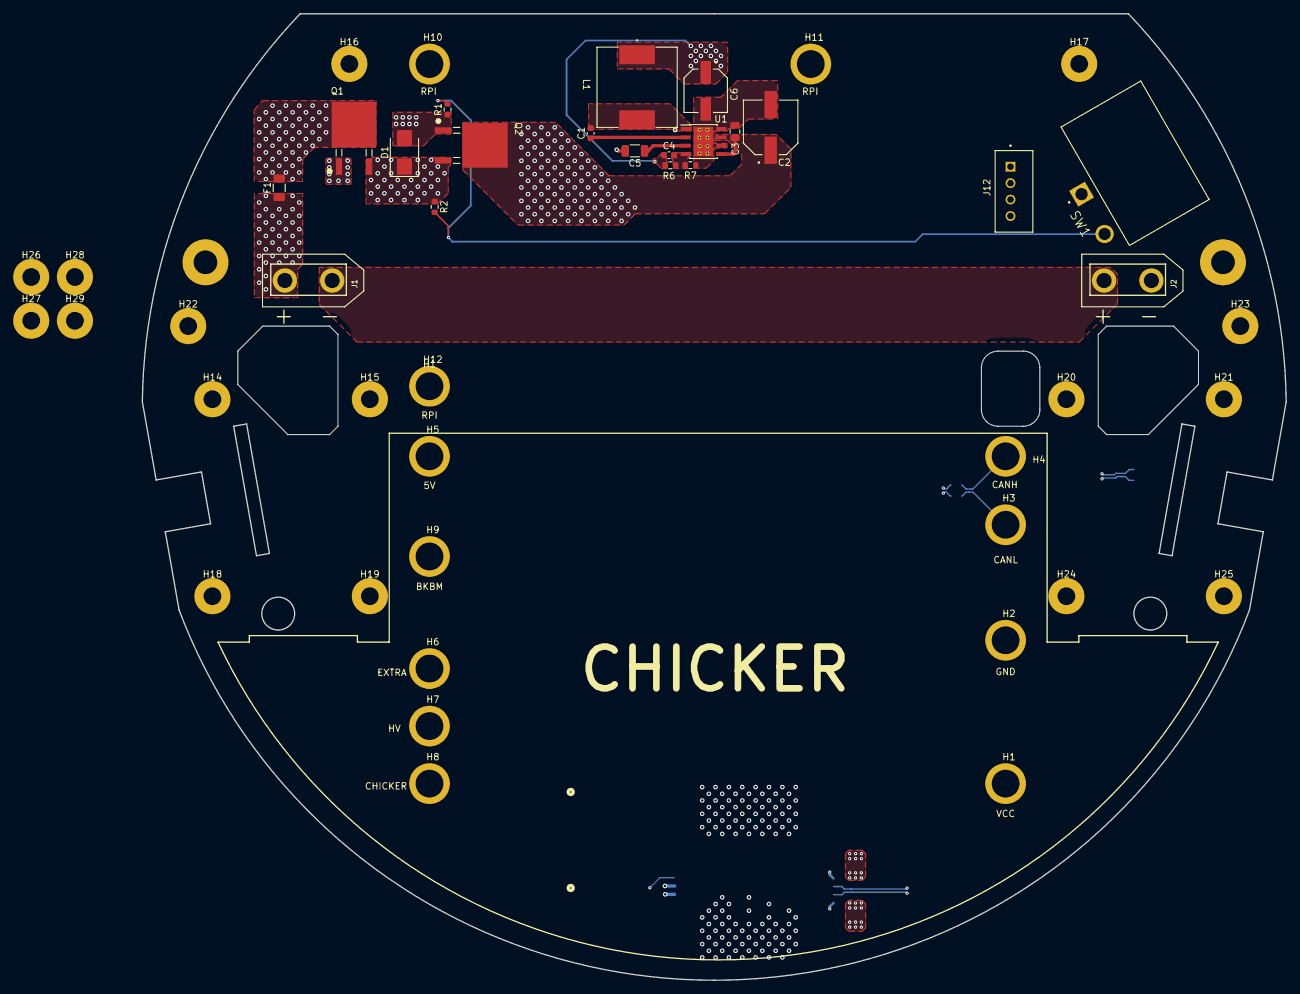
[picture p105: board midplate.kicad_pcb from above]

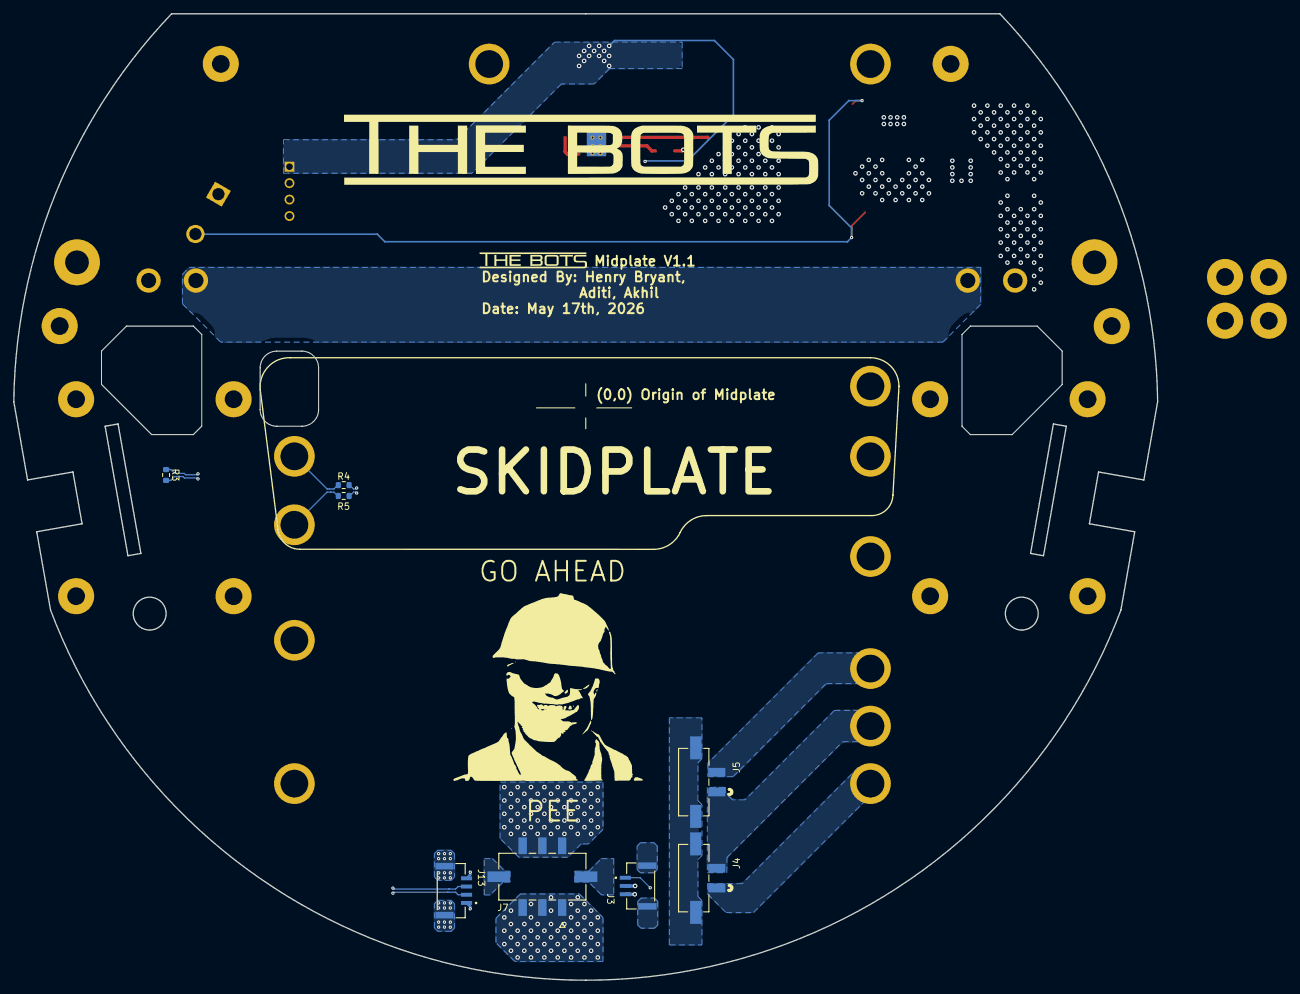
[picture p106: board midplate.kicad_pcb from below]

Board: 4 copper layers, 174.0 x 147.0 mm, 59 parts (8 on the bottom side), 22 nets.

Other parts of the board:
H1#2: RPI; MountingHole_2.7mm_M2.5_DIN965_Pad
H47, H48: MountingHoleM2.5NoThread; MountingHole_3.6mm_M3_clearance
