sfunderbots/Electrical/SkidPlate/SkidPlate.kicad_pcb

## KiCad design SkidPlate/SkidPlate.kicad_pcb (2026-05-18)

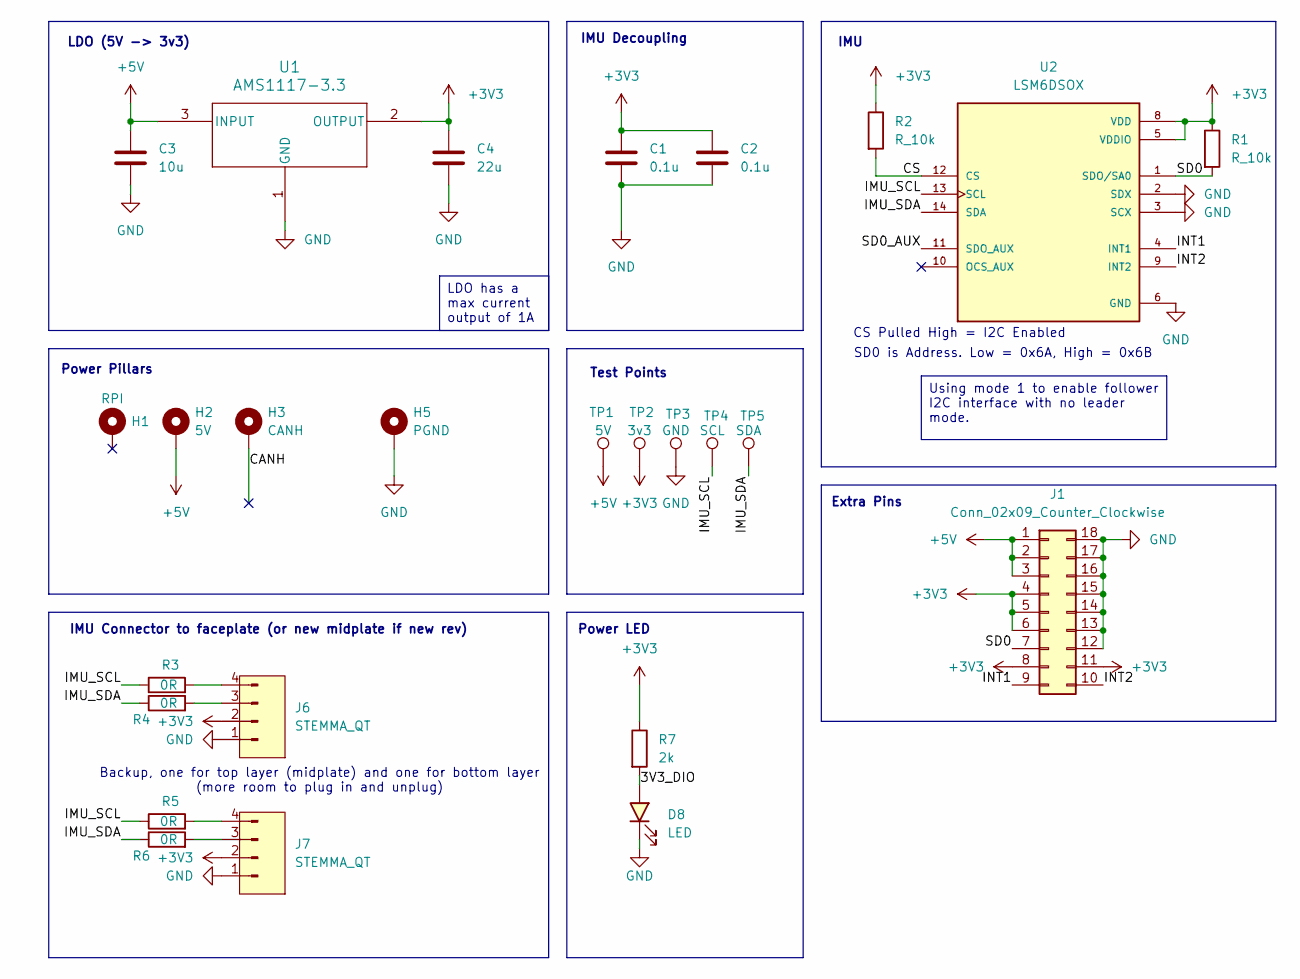
[picture p107: schematic SkidPlate.kicad_sch]

Parts:
C1, C2: 0.1u; C_0603_1608Metric; MPN CC0603KRX7R9BB104; JLC 0603
C3: 10u; C_0805_2012Metric; MPN GRM21BR61H106KE43L; JLC 0805
C4: 22u; C_0603_1608Metric; LCSC C59461
D8: LED; LED_0805_2012Metric; MPN KT-0805G; JLC 0805
H1: RPI; MountingHole_2.7mm_M2.5_DIN965_Pad
H2: 5V; MountingHole_2.7mm_M2.5_DIN965_Pad
H3: CANH; MountingHole_2.7mm_M2.5_DIN965_Pad
H5: PGND; MountingHole_2.7mm_M2.5_DIN965_Pad
J1: Conn_02x09_Counter_Clockwise; PinHeader_2x09_P2.54mm_Vertical
J6, J7: STEMMA_QT; JST_SH_BM04B-SRSS-TB_1x04-1MP_P1.00mm_Vertical
R1, R2: R_10k; R_0603_1608Metric; MPN 0603WAF1002T5E; JLC 0603
R3, R4, R5, R6: 0R; R_0603_1608Metric; MPN 0603WAF0000T5E; JLC 0603
R7: 2k; R_0603_1608Metric; MPN 0603WAF2001T5E; JLC 0603
TP1: 5V; TestPoint_Pad_D1.0mm
TP2: 3v3; TestPoint_Pad_D1.0mm
TP3: GND; TestPoint_Pad_D1.0mm
TP4: SCL; TestPoint_Pad_D1.0mm
TP5: SDA; TestPoint_Pad_D1.0mm
U1: AMS1117-3.3; SOT-223-3_TabPin2; MPN AMS1117-3.3; JLC SOT-223
U2: LSM6DSOX; PQFN50P250X300X86-14N; PARTREV 3.0; JLC LGA-14(2.5x3)

Connections:
+3V3: C1.1, C2.1, C4.1, J1.4, J1.5, J1.6, J1.8, J1.11, J6.2, J7.2, R1.1, R2.1, R7.1, TP2.1 (1_1), U1.2 (OUTPUT), U2.5 (VDDIO), U2.8 (VDD)
+5V: C3.1, H2.1 (1_1), J1.1, J1.2, J1.3, TP1.1 (1_1), U1.3 (INPUT)
/3V3_DIO: D8.2 (A), R7.2
/CANH: H3.1 (1_1)
/CS: R2.2, U2.12 (CS)
/IMU_SCL: R3.1, R5.1, TP4.1 (1_1), U2.13 (SCL)
/IMU_SDA: R4.1, R6.1, TP5.1 (1_1), U2.14 (SDA)
/INT1: J1.9, U2.4 (INT1)
/INT2: J1.10, U2.9 (INT2)
/SD0: J1.7, R1.2, U2.1 (SDO/SA0)
/SD0_AUX: U2.11 (SDO_AUX)
GND: C1.2, C2.2, C3.2, C4.2, D8.1 (K), H5.1 (1_1), J1.12, J1.13, J1.14, J1.15, J1.16, J1.17, J1.18, J6.1, J7.1, TP3.1 (1_1), U1.1 (GND), U2.2 (SDX), U2.3 (SCX), U2.6 (GND), U2.7 (GND)
unnamed: J6.3, R4.2
unnamed: J6.4, R3.2
unnamed: J7.3, R6.2
unnamed: J7.4, R5.2

Notes on the sheet:
IMU Connector to faceplate (or new midplate if new rev)
Backup, one for top layer (midplate) and one for bottom layer (more room to plug in and unplug)
Extra Pins
Test Points
IMU
CS Pulled High = I2C Enabled
Power Pillars
Power LED
LDO (5V -> 3v3)
IMU Decoupling
SD0 is Address. Low = 0x6A, High = 0x6B
LDO has a max current output of 1A
Using mode 1 to enable follower I2C interface with no leader mode.

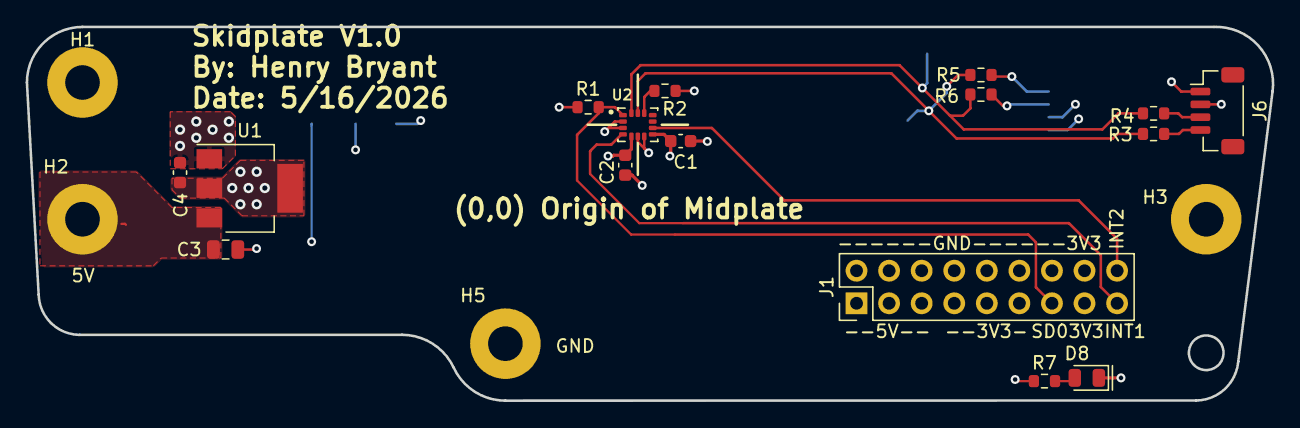
[picture p108: board SkidPlate.kicad_pcb from above]

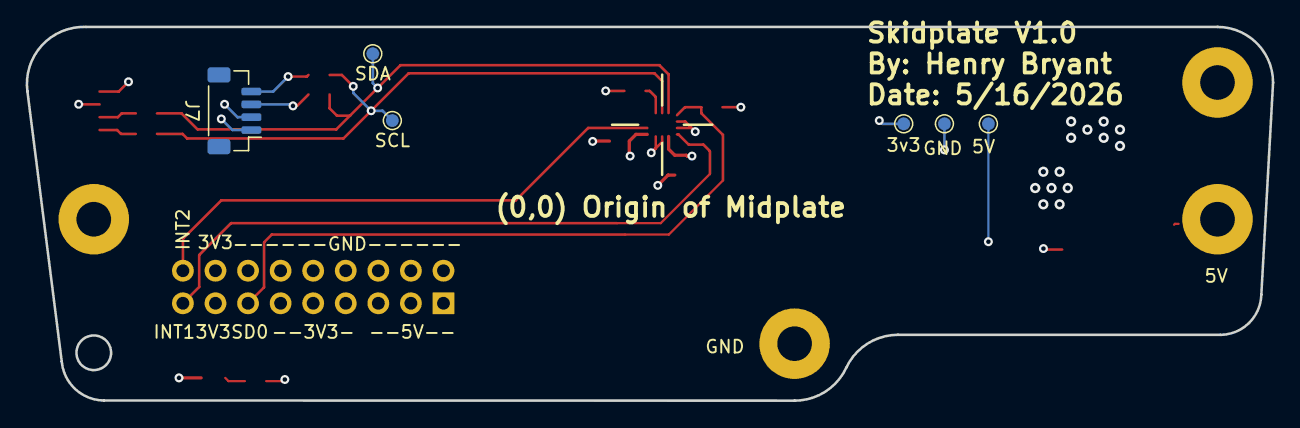
[picture p109: board SkidPlate.kicad_pcb from below]

Board: 4 copper layers, 97.2 x 29.1 mm, 26 parts (6 on the bottom side), 14 nets.
