sfunderbots/Electrical/pmw3360-pcb-main/pmw3360_pcb_pinheader/pmw3360_pcb_pinheader.kicad_pcb

## KiCad design pmw3360-pcb-main/pmw3360_pcb_pinheader/pmw3360_pcb_pinheader.kicad_pcb (2026-02-23)

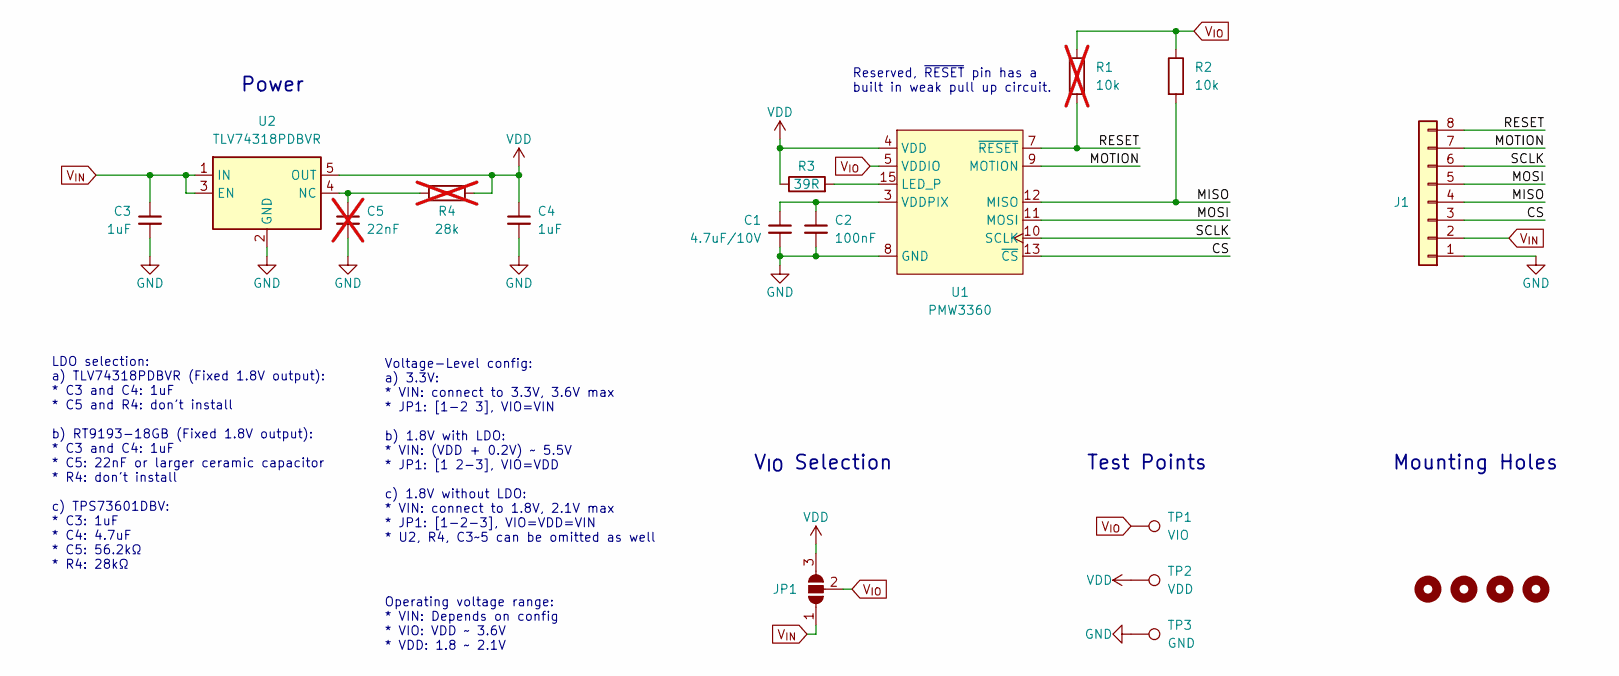
[picture p112: schematic pmw3360_pcb_pinheader.kicad_sch, PMW3360 PCB]

Parts:
C1: 4.7uF/10V; C_0603_1608Metric_Pad1.08x0.95mm_HandSolder; Mfr. # CL10A475KO8NNNC; LCSC C19666
C2: 100nF; C_0603_1608Metric_Pad1.08x0.95mm_HandSolder; Mfr. # CC0603KRX7R9BB104; LCSC C14663
C3, C4: 1uF; C_0603_1608Metric_Pad1.08x0.95mm_HandSolder; Mfr. # CL10A105KB8NNNC; LCSC C15849
C5: 22nF; C_0603_1608Metric_Pad1.08x0.95mm_HandSolder; Mfr. # CL10B223KB8NNNC; LCSC C21122; not fitted
H1, H2, H3, H4: MountingHole_Pad; MountingHole_3.2mm_M3_ISO14580
J1: Conn_01x08; PinHeader_1x08_P2.54mm_Vertical
JP1: SolderJumper_3_Open; SolderJumper-3_P1.3mm_Open_RoundedPad1.0x1.5mm_NumberLabels
R1: 10k; R_0603_1608Metric_Pad0.98x0.95mm_HandSolder; Mfr. # 0603WAF1002T5E; LCSC C25804; not fitted
R2: 10k; R_0603_1608Metric_Pad0.98x0.95mm_HandSolder; Mfr. # 0603WAF1002T5E; LCSC C25804
R3: 39R; R_0603_1608Metric_Pad0.98x0.95mm_HandSolder; Mfr. # 0603WAF390JT5E; LCSC C23154
R4: 28k; R_0603_1608Metric_Pad0.98x0.95mm_HandSolder; not fitted
TP1: VIO; TestPoint_Pad_D1.5mm
TP2: VDD; TestPoint_Pad_D1.5mm
TP3: GND; TestPoint_Pad_D1.5mm
U1: PMW3360; 16pin‐DIP(PMW3360DM-T2QU); Mfr. # PMW3360DM-T2QU + LM19-LSI
U2: TLV74318PDBVR; SOT-23-5; Mfr. # TLV74318PDBVR; LCSC C485152

Connections:
/CS: J1.3, U1.13 (~CS)
/MISO: J1.4, R2.2, U1.12 (MISO)
/MOSI: J1.5, U1.11 (MOSI)
/MOTION: J1.7, U1.9 (MOTION)
/RESET: J1.8, R1.2, U1.7 (~RESET)
/SCLK: J1.6, U1.10 (SCLK)
GND: C1.2, C2.2, C3.2, C4.2, C5.2, J1.1, TP3.1, U1.8 (GND), U2.2 (GND)
unnamed: R3.2, U1.15 (LED_P)
unnamed: C1.1, C2.1, U1.3 (VDDPIX)
unnamed: C5.1, R4.2, U2.4 (NC)
VDD: C4.1, JP1.3 (B), R3.1, R4.1, TP2.1, U1.4 (VDD), U2.5 (OUT)
V_{IN}: C3.1, J1.2, JP1.1 (A), U2.1 (IN), U2.3 (EN)
V_{IO}: JP1.2 (C), R1.1, R2.1, TP1.1, U1.5 (VDDIO)

Notes on the sheet:
Voltage-Level config: a) 3.3V: * VIN: connect to 3.3V, 3.6V max * JP1: [1-2 3], VIO=VIN b) 1.8V with LDO: * VIN: (VDD + 0.2V) ~ 5.5V * JP1: [1 2-3], VIO=VDD c) 1.8V without LDO: * VIN: connect to 1.8V, 2.1V max * JP1: [1-2-3], VIO=VDD=VIN * U2, R4, C3~5 can be omitted as well
Operating voltage range: * VIN: Depends on config * VIO: VDD ~ 3.6V * VDD: 1.8 ~ 2.1V
V_{IO} Selection
LDO selection: a) TLV74318PDBVR (Fixed 1.8V output): * C3 and C4: 1uF * C5 and R4: don't install b) RT9193-18GB (Fixed 1.8V output): * C3 and C4: 1uF * C5: 22nF or larger ceramic capacitor * R4: don't install c) TPS73601DBV: * C3: 1uF * C4: 4.7uF * C5: 56.2kΩ * R4: 28kΩ
Reserved, ~{RESET} pin has a built in weak pull up circuit.
Test Points
Mounting Holes
Power

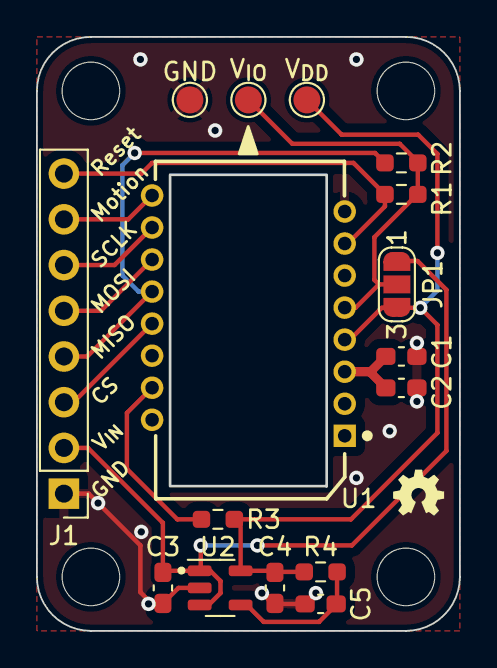
[picture p113: board pmw3360_pcb_pinheader.kicad_pcb from above]

Board: 2 copper layers, 23.5 x 33.0 mm, 20 parts (0 on the bottom side), 13 nets.
