sfunderbots/Electrical/PAC5527Driver/PAC5527Driver.kicad_pcb

## KiCad design PAC5527Driver/PAC5527Driver.kicad_pcb (2024-03-15)

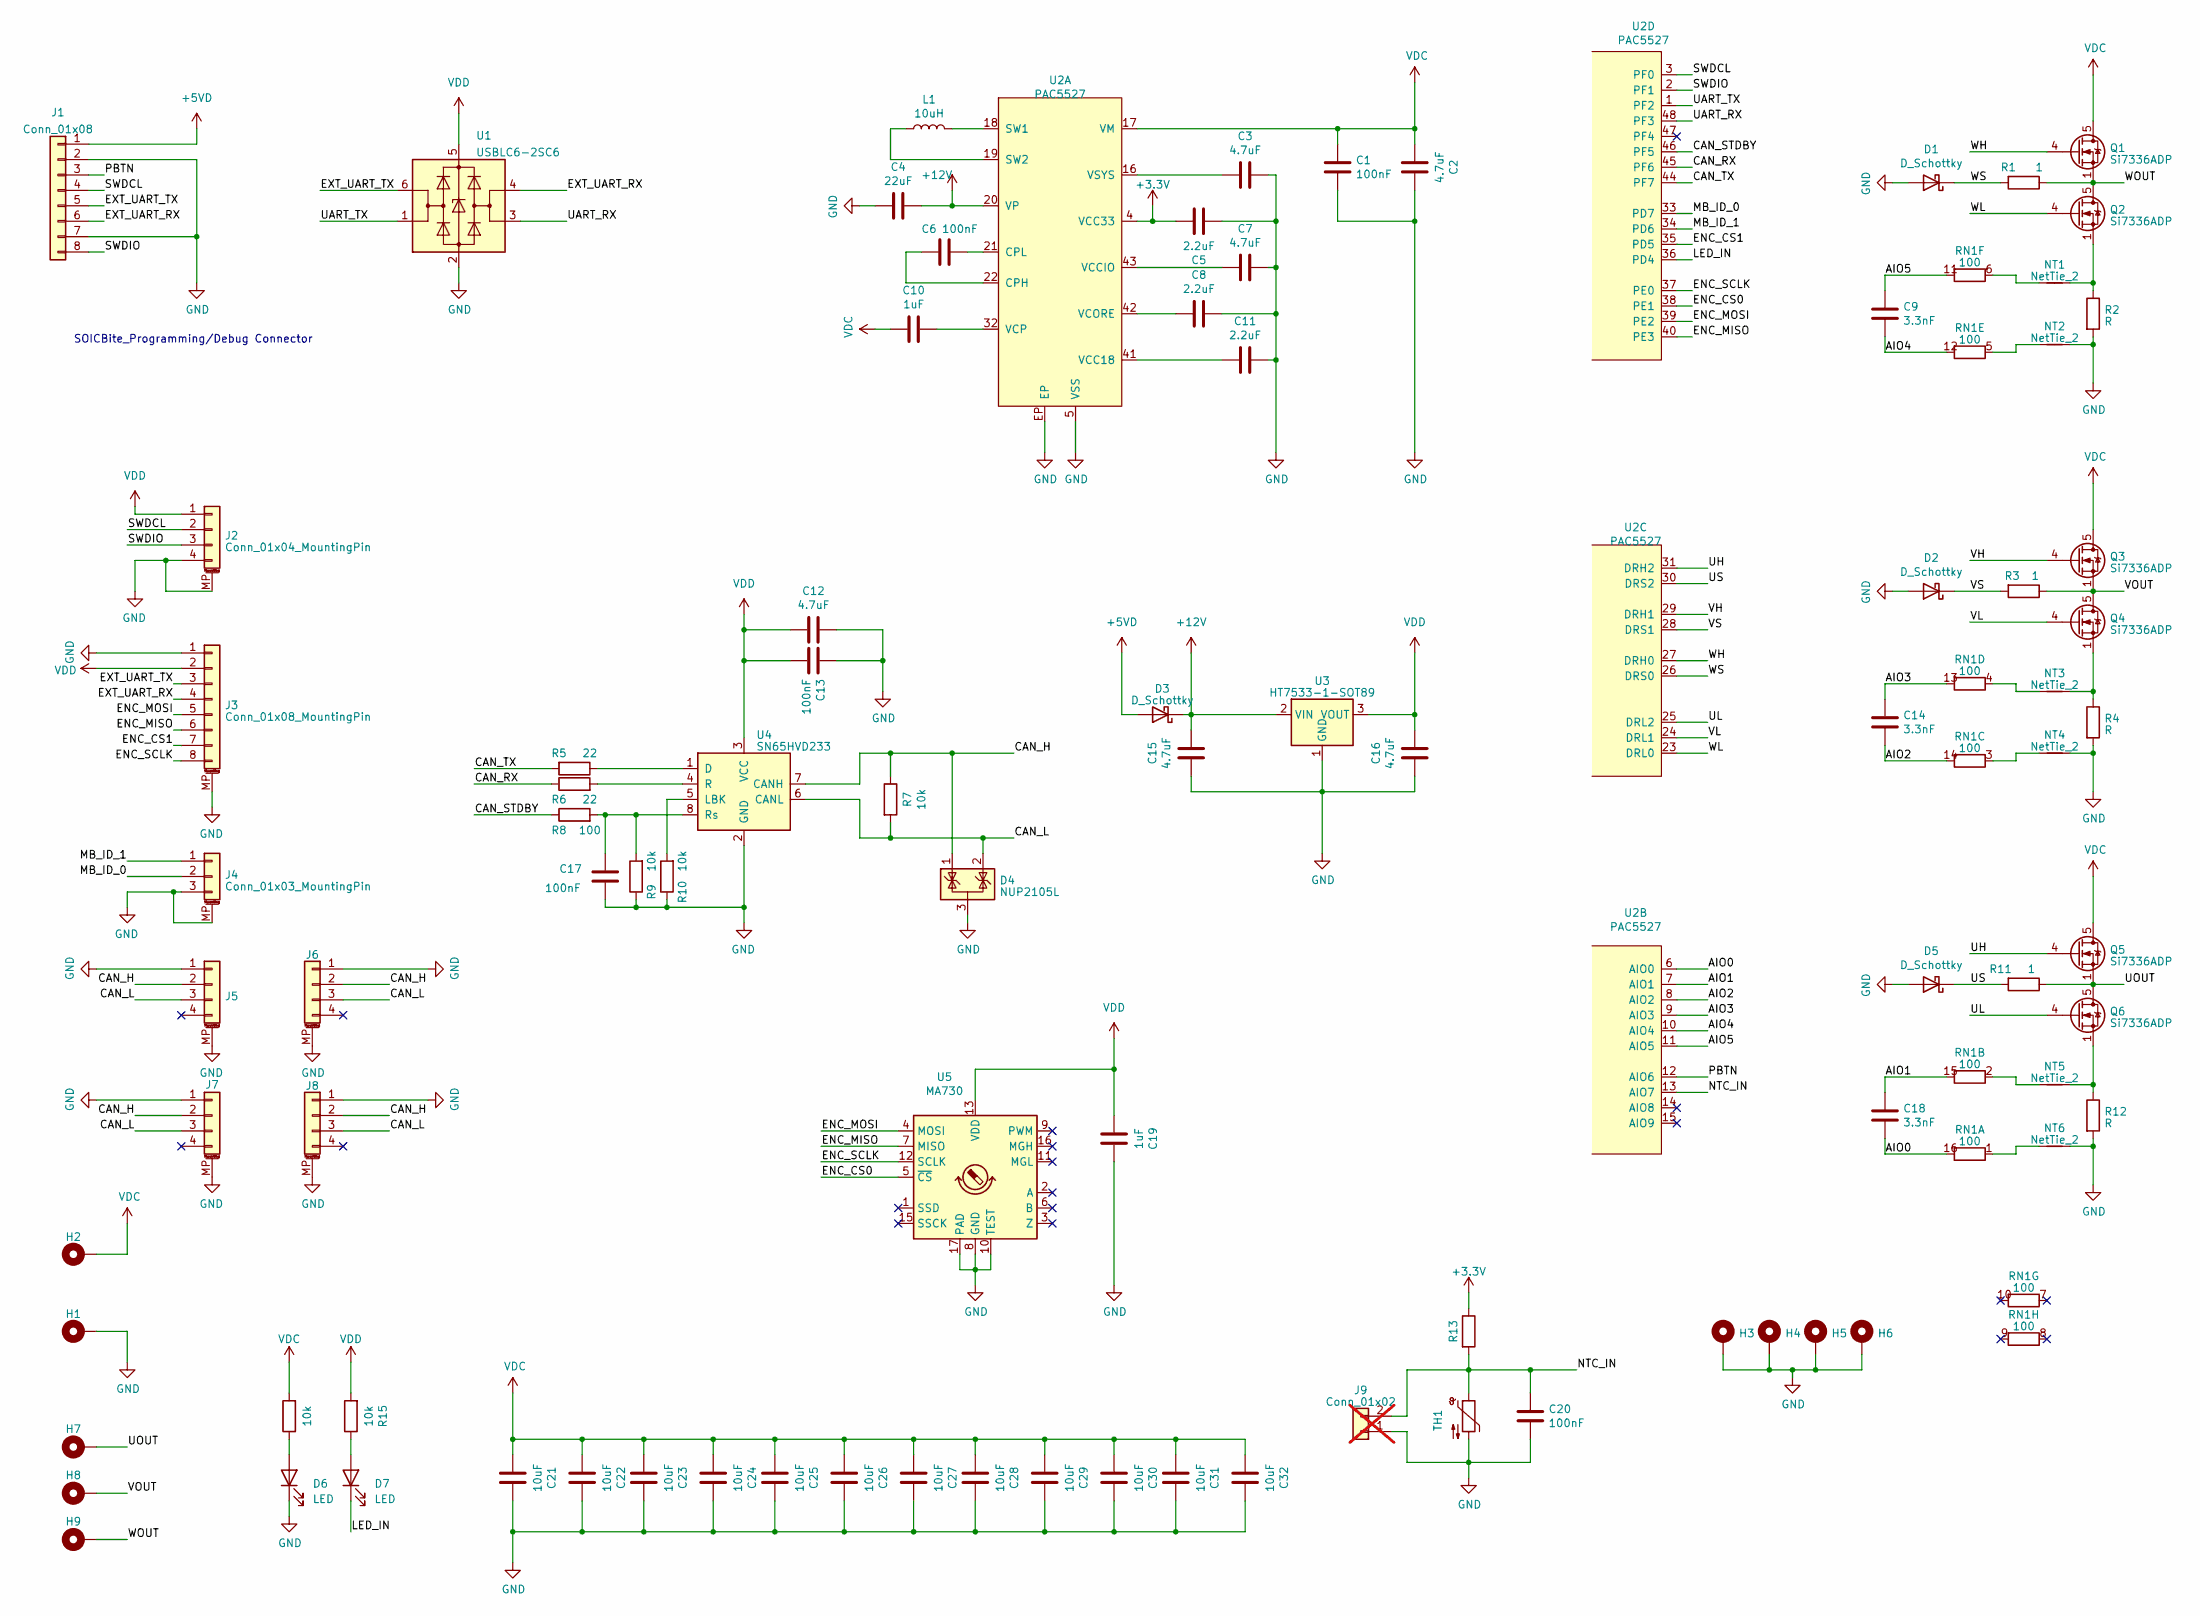
[picture p114: schematic PAC5527Driver.kicad_sch]

Parts:
C1: 100nF; C_0603_1608Metric
C2, C3, C7, C12, C15, C16: 4.7uF; C_0402_1005Metric
C4: 22uF; C_0805_2012Metric
C5, C8, C11: 2.2uF; C_0402_1005Metric
C6, C13, C17, C20: 100nF; C_0402_1005Metric
C9, C14, C18: 3.3nF; C_0402_1005Metric
C10, C19: 1uF; C_0402_1005Metric
C21, C22, C23, C24, C25, C26, C27, C28, C29, C30, C31, C32: 10uF; C_1210_3225Metric
D1, D2, D3, D5: D_Schottky; D_SOD-523
D4: NUP2105L; SOT-23
D6, D7: LED; D_0402_1005Metric
H1, H2: MountingHole_Pad; MountingHole_2.2mm_M2_DIN965_Pad_TopBottom
H3, H4, H5, H6: MountingHole_Pad; MountingHole_2.7mm_M2.5_Pad_TopBottom
H7, H8, H9: MountingHole_Pad; MountingHole_2.2mm_M2_DIN965_Pad_TopOnly
J1: Conn_01x08; SOIC_clipProgSmall
J2, J6, J8: Conn_01x04_MountingPin; JST_GH_BM04B-GHS-TBT_1x04-1MP_P1.25mm_Vertical
J3: Conn_01x08_MountingPin; JST_GH_BM08B-GHS-TBT_1x08-1MP_P1.25mm_Vertical
J4: Conn_01x03_MountingPin; JST_GH_BM03B-GHS-TBT_1x03-1MP_P1.25mm_Vertical
J5, J7: Conn_01x04_MountingPin; JST_GH_SM04B-GHS-TB_1x04-1MP_P1.25mm_Horizontal
J9: Conn_01x02; PinHeader_1x02_P1.27mm_Vertical; not fitted
L1: 10uH; L_Changjiang_FNR3010S
NT1, NT2, NT3, NT4, NT5, NT6: NetTie_2; NetTie-2_SMD_Pad0.5mm
Q1, Q2, Q3, Q4, Q5, Q6: Si7336ADP; PowerPAK_SO-8_Single
R1, R3, R11: 1; R_0402_1005Metric
R2, R4, R12: R; R_2512_6332Metric
R5, R6: 22; R_0402_1005Metric
R7, R9, R10, R13, R14, R15: 10k; R_0402_1005Metric
R8: 100; R_0402_1005Metric
RN1: 100; R_Array_Convex_8x0602
TH1: Thermistor_NTC; R_0402_1005Metric
U1: USBLC6-2SC6; SOT-23-6
U2: PAC5527; QFN-48-1EP_6x6mm_P0.4mm_EP4.3x4.3mm_ThermalVias
U3: HT7533-1-SOT89; SOT-89-3
U4: SN65HVD233; SOIC-8_3.9x4.9mm_P1.27mm
U5: MA730; QFN-16-1EP_3x3mm_P0.5mm_EP1.7x1.7mm

Connections:
+3.3V: C5.1, R13.1, U2.4 (VCC33)
+5VD: D3.2 (A), J1.1
+12V: C4.2, C15.2, D3.1 (K), U2.20 (VP), U3.2 (VIN)
/AIO0: C18.2, RN1.16 (R1.2), U2.6 (AIO0)
/AIO1: C18.1, RN1.15 (R2.2), U2.7 (AIO1)
/AIO2: C14.2, RN1.14 (R3.2), U2.8 (AIO2)
/AIO3: C14.1, RN1.13 (R4.2), U2.9 (AIO3)
/AIO4: C9.2, RN1.12 (R5.2), U2.10 (AIO4)
/AIO5: C9.1, RN1.11 (R6.2), U2.11 (AIO5)
/CAN_H: D4.1 (K), J5.2, J6.2, J7.2, J8.2, R7.1, U4.7 (CANH)
/CAN_L: D4.2 (K), J5.3, J6.3, J7.3, J8.3, R7.2, U4.6 (CANL)
/CAN_RX: R6.1, U2.45 (PF6)
/CAN_STDBY: R8.1, U2.46 (PF5)
/CAN_TX: R5.2, U2.44 (PF7)
/ENC_CS0: U2.38 (PE1), U5.5 (~CS)
/ENC_CS1: J3.7, U2.35 (PD5)
/ENC_MISO: J3.6, U2.40 (PE3), U5.7 (MISO)
/ENC_MOSI: J3.5, U2.39 (PE2), U5.4 (MOSI)
/ENC_SCLK: J3.8, U2.37 (PE0), U5.12 (SCLK)
/EXT_UART_RX: J1.6, J3.4, U1.4 (I/O2)
/EXT_UART_TX: J1.5, J3.3, U1.6 (I/O1)
/LED_IN: D7.1 (K), U2.36 (PD4)
/MB_ID_0: J4.2, U2.33 (PD7)
/MB_ID_1: J4.1, U2.34 (PD6)
/NTC_IN: C20.1, J9.2, R13.2, TH1.1, U2.13 (AIO7)
/PBTN: J1.3, U2.12 (AIO6)
/SWDCL: J1.4, J2.2, U2.3 (PF0)
/SWDIO: J1.8, J2.3, U2.2 (PF1)
/UART_RX: U1.3 (I/O2), U2.48 (PF3)
/UART_TX: U1.1 (I/O1), U2.1 (PF2)
/UH: Q5.4 (G), U2.31 (DRH2)
/UL: Q6.4 (G), U2.25 (DRL2)
/UOUT: H7.1, Q5.1 (S), Q5.2 (S), Q5.3 (S), Q6.5 (D), R11.1
/US: D5.1 (K), R11.2, U2.30 (DRS2)
/VH: Q3.4 (G), U2.29 (DRH1)
/VL: Q4.4 (G), U2.24 (DRL1)
/VOUT: H8.1, Q3.1 (S), Q3.2 (S), Q3.3 (S), Q4.5 (D), R3.1
/VS: D2.1 (K), R3.2, U2.28 (DRS1)
/WH: Q1.4 (G), U2.27 (DRH0)
/WL: Q2.4 (G), U2.23 (DRL0)
/WOUT: H9.1, Q1.1 (S), Q1.2 (S), Q1.3 (S), Q2.5 (D), R1.1
/WS: D1.1 (K), R1.2, U2.26 (DRS0)
GND: C1.2, C2.2, C3.2, C4.1, C5.2, C7.2, C8.2, C11.2, C12.2, C13.1, C15.1, C16.1, C17.1, C19.2, C20.2, C21.2, C22.2, C23.2, C24.2, C25.2, C26.2, C27.2, C28.2, C29.2, C30.2, C31.2, C32.2, D1.2 (A), D2.2 (A), D4.3 (A), D5.2 (A), D6.1 (K), H1.1, H3.1, H4.1, H5.1, H6.1, J1.2, J1.7, J2.4, J2.MP (MountPin), J3.1, J3.MP (MountPin), J4.3, J4.MP (MountPin), J5.1, J5.MP (MountPin), J6.1, J6.MP (MountPin), J7.1, J7.MP (MountPin), J8.1, J8.MP (MountPin), J9.1, NT2.2, NT4.2, NT6.2, R2.2, R4.2, R9.1, R10.1, R12.2, TH1.2, U1.2 (GND), U2.5 (VSS), U2.EP, U3.1 (GND), U4.2 (GND), U5.8 (GND), U5.10 (TEST), U5.17 (PAD)
unnamed: D6.2 (A), R14.1
unnamed: D7.2 (A), R15.1
unnamed: NT1.2, Q2.1 (S), Q2.2 (S), Q2.3 (S), R2.1
unnamed: NT3.2, Q4.1 (S), Q4.2 (S), Q4.3 (S), R4.1
unnamed: NT5.2, Q6.1 (S), Q6.2 (S), Q6.3 (S), R12.1
unnamed: NT6.1, RN1.1 (R1.1)
unnamed: NT5.1, RN1.2 (R2.1)
unnamed: NT4.1, RN1.3 (R3.1)
unnamed: NT3.1, RN1.4 (R4.1)
unnamed: NT2.1, RN1.5 (R5.1)
unnamed: NT1.1, RN1.6 (R6.1)
unnamed: C6.1, U2.22 (CPH)
unnamed: C6.2, U2.21 (CPL)
unnamed: L1.2, U2.18 (SW1)
unnamed: L1.1, U2.19 (SW2)
unnamed: C11.1, U2.41 (VCC18)
unnamed: C7.1, U2.43 (VCCIO)
unnamed: C8.1, U2.42 (VCORE)
unnamed: C10.2, U2.32 (VCP)
unnamed: C3.1, U2.16 (VSYS)
unnamed: R5.1, U4.1 (D)
unnamed: R10.2, U4.5 (LBK)
unnamed: R6.2, U4.4 (R)
unnamed: C17.2, R8.2, R9.2, U4.8 (Rs)
VDC: C1.1, C2.1, C10.1, C21.1, C22.1, C23.1, C24.1, C25.1, C26.1, C27.1, C28.1, C29.1, C30.1, C31.1, C32.1, H2.1, Q1.5 (D), Q3.5 (D), Q5.5 (D), R14.2, U2.17 (VM)
VDD: C12.1, C13.2, C16.2, C19.1, J2.1, J3.2, R15.2, U1.5 (VBUS), U3.3 (VOUT), U4.3 (VCC), U5.13 (VDD)

Notes on the sheet:
SOICBite_Programming/Debug Connector

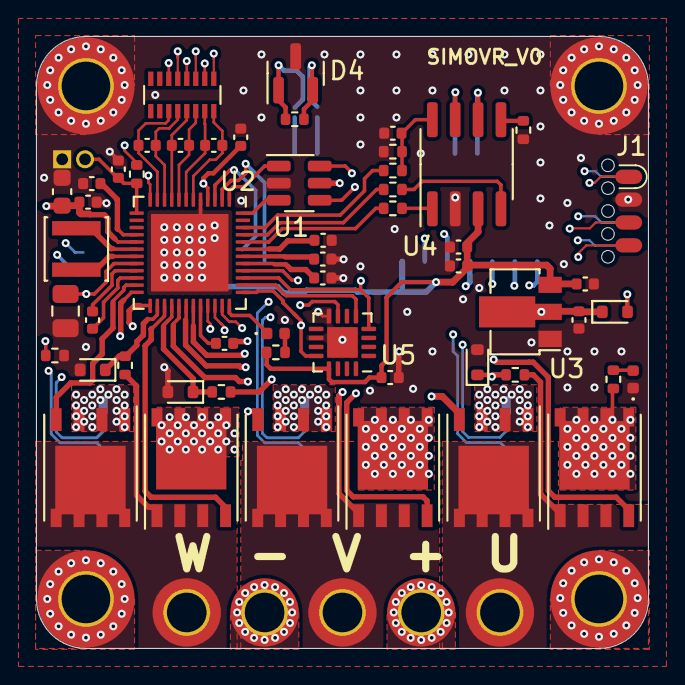
[picture p115: board PAC5527Driver.kicad_pcb from above]

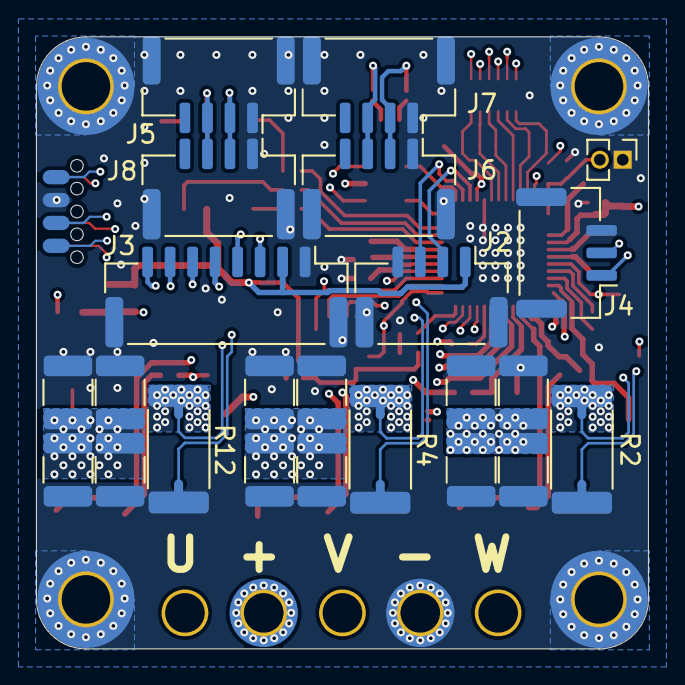
[picture p116: board PAC5527Driver.kicad_pcb from below]

Board: 6 copper layers, 34.0 x 34.0 mm, 92 parts (29 on the bottom side), 69 nets.
