sfunderbots/Electrical/SX1280_USB_Adapter/SX1280_USB_Adapter.kicad_pcb

## KiCad design SX1280_USB_Adapter/SX1280_USB_Adapter.kicad_pcb (2023-06-03)

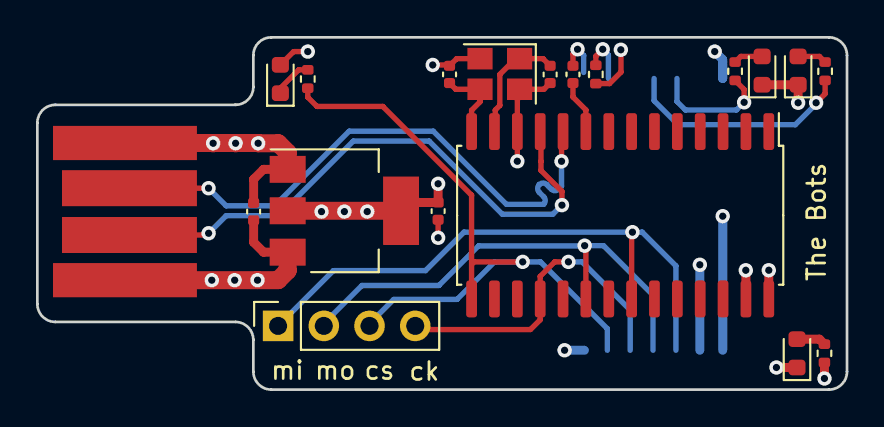
[picture p117: board SX1280_USB_Adapter.kicad_pcb from above]

Board: 4 copper layers, 45.0 x 19.6 mm, 20 parts (1 on the bottom side), 19 nets.

Parts:
C1, C4: 20p; C_0402_1005Metric
C2, C5: 104; C_0402_1005Metric
C3: 47p2; C_0402_1005Metric
D1, D2, D3, D4: LED; LED_0603_1608Metric
J1: USB_A_PLUG; USB_PCB
J2: Conn_01x04_Female; PinSocket_1x04_P2.54mm_Vertical
R2, R3, R4, R6: R330; R_0402_1005Metric
R5: 1k; R_0402_1005Metric
U1: AMS1117-3.3; SOT-223-3_TabPin2
U2: CH341a; SOIC-28W_7.5x17.9mm_P1.27mm
U3: SX1280; E28-2G4M12S-SX1280
Y1: Crystal_GND24; Crystal_SMD_3225-4Pin_3.2x2.5mm

Connections:
/3V3: C5.2, D4.2 (A), R5.1, U1.2 (VO), U3.1 (VCC)
/5V: C2.2, J1.1 (VBUS), R2.1, U1.3 (VI), U2.28 (VCC)
/CLK: J2.4, U2.18 (~DCD/D3/DCK), U3.5 (SCK)
/CS: J2.3, R3.2, U2.15 (~CTS/D0/CS0), U3.6 (NSS)
/GND: C1.1, C2.1, C3.1, C4.1, C5.1, D1.1 (K), D2.1 (K), D3.1 (K), J1.4 (GND), U1.1 (GND), U2.12 (GND), U2.27 (~TEN/BUSY/WAIT), U3.2 (GND), U3.7 (GND), U3.8 (GND), U3.14 (GND), Y1.2, Y1.4
/MISO: J2.1, U2.22 (~SLP/D7/DIN), U3.3 (MISO)
/MOSI: J2.2, U2.20 (~DTR/D5/DOUT), U3.4 (MOSI)
/USB D+: J1.3 (D+), U2.10 (UD+)
/USB D-: J1.2 (D-), U2.11 (UD-)
unnamed: D1.2 (A), R2.2
unnamed: D2.2 (A), R4.2
unnamed: D3.2 (A), R6.2
unnamed: D4.1 (K), R3.1
unnamed: C3.2, U2.9 (V3)
unnamed: C1.2, U2.13 (XI), Y1.1
unnamed: C4.2, U2.14 (XO), Y1.3
unnamed: R4.1, U3.11 (DIO1)
unnamed: R6.1, U3.12 (DIO2)
unnamed: R5.2, U3.9 (nReset)
