sfunderbots/Electrical/PowerBoard/POWER_BOARD.kicad_pcb

## KiCad design PowerBoard/POWER_BOARD.kicad_pcb (2024-01-17)

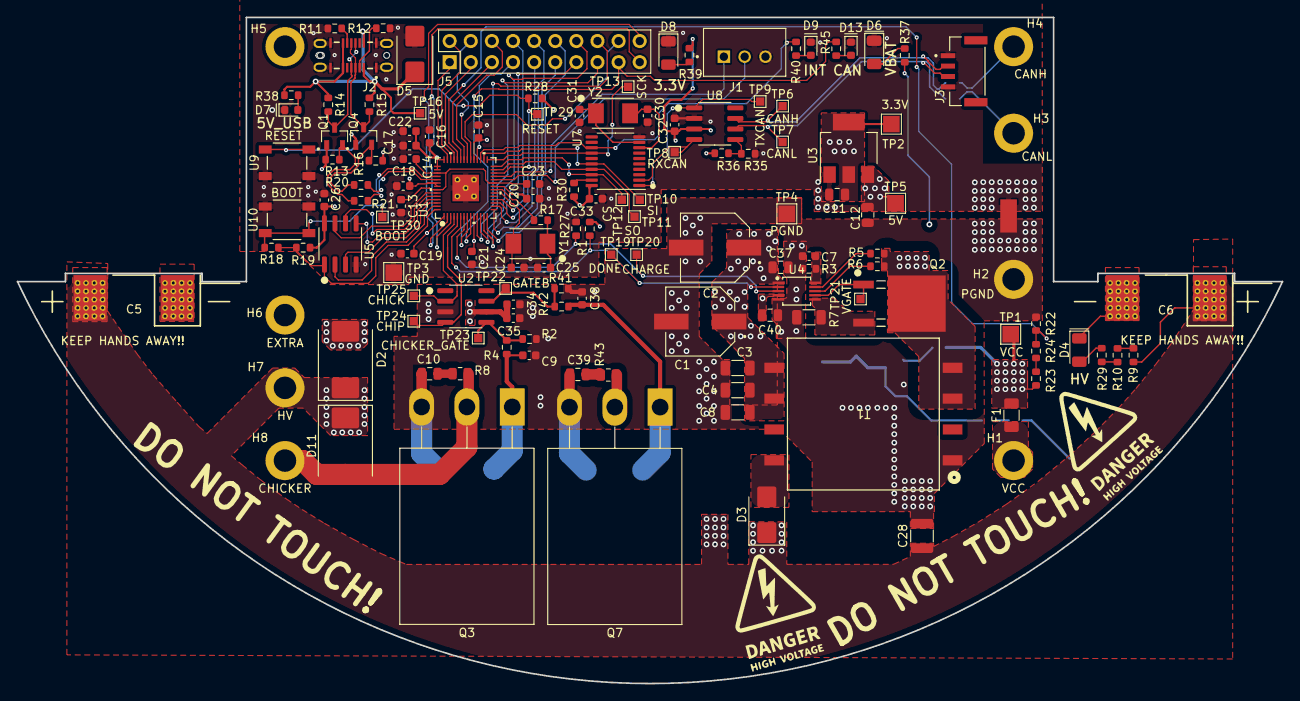
[picture p118: board POWER_BOARD.kicad_pcb from above]

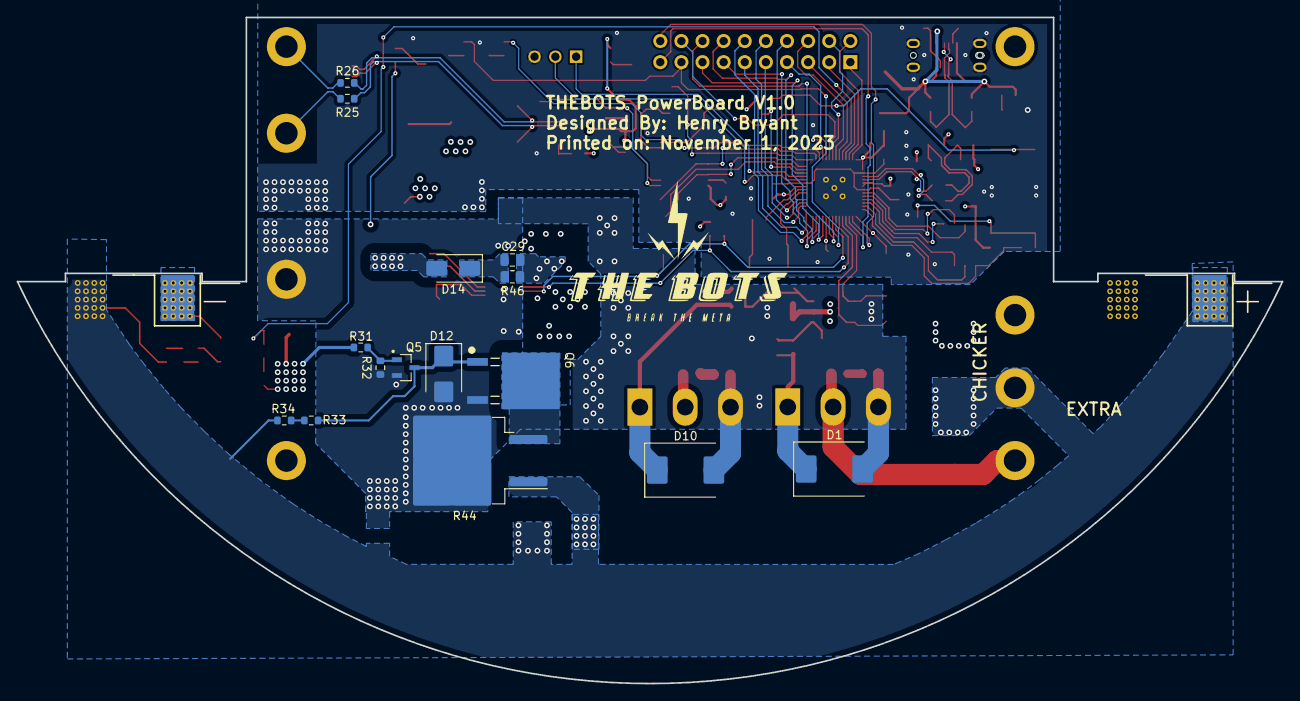
[picture p119: board POWER_BOARD.kicad_pcb from below]

Board: 4 copper layers, 152.1 x 80.1 mm, 154 parts (15 on the bottom side), 99 nets.

Parts:
C1, C2: 25SVPF100M; CAP_25SVPF100M
C3, C4, C8: C_22u_1206; C_1206_3216Metric
C5: 1000u; CP_Radial_Horizontal_D25.4mm_H45mm
C6: 1000u; CP_Radial_Horizontal_D25.4mm_H45mm_reversed
C7: 100p; C_0603_1608Metric
C9, C13, C14, C15, C16, C17, C18, C19, C20, C21, C26, C32, C33, C34, C38: 0.1u; C_0603_1608Metric
C10, C39: 1500p; C_0805_2012Metric
C11, C12: 10u; C_0805_2012Metric
C22, C23, C35: 1u; C_0603_1608Metric
C24, C25: 27p; C_0603_1608Metric
C28: 0.1u_600V; C_1210_3225Metric
C29: ?; C_0805_2012Metric
C30, C31: 22p; C_0603_1608Metric
C37, C40: C_10u; C_0805_2012Metric
D1, D10: SMCJ14A; D_SMC
D2, D11: MUR860J; D_SMC
D3: 2A 600V; D_SMB
D4: LED_red; LED_1206_3216Metric
D5: B220; D_SMB
D6, D8: LED; LED_1206_3216Metric
D7, D9, D13: LED; LED_0603_1608Metric
D12: 3SMBJ5929B-TP; D_SMB
D14: ?; D_SMA
F1: Fuse_0501010.WR; Fuse_1206_3216Metric
H1: VCC; MountingHole_2.7mm_M2.5_DIN965_Pad
H2: PGND; MountingHole_2.7mm_M2.5_DIN965_Pad
H3: CANL; MountingHole_2.7mm_M2.5_DIN965_Pad
H4: CANH; MountingHole_2.7mm_M2.5_DIN965_Pad
H5: 5V; MountingHole_2.7mm_M2.5_DIN965_Pad
H6: EXTRA; MountingHole_2.7mm_M2.5_DIN965_Pad
H7: HV; MountingHole_2.7mm_M2.5_DIN965_Pad
H8: CHICKER; MountingHole_2.7mm_M2.5_DIN965_Pad
J1: JST_B3B-XH-A
J2: USB4145-03-0170-C_REVA2; GCT_USB4145-03-0170-C_REVA2
J3: JST_BM04B-GHS-TBT
J5: Conn_02x10_Counter_Clockwise; PinHeader_2x10_P2.54mm_Vertical
NT1: NetTie_2; NetTie-2_SMD_Pad2.0mm
Q1, Q4: BSS138; SOT95P240X111-3N
Q2: FDD86250-F085; DPAK-3_ONS
Q3, Q7: FGH50T65SQD-F155; TO-247-3_Horizontal_TabDown
Q5: TN2130K1-G; SOT95P240X111-3N
Q6: STD11N60DM2; DPAK-3_ONS
R1, R9, R10, R27, R29, R32: 100k; R_0603_1608Metric
R2, R13, R14, R15, R16, R19, R28, R30, R41: 10k; R_0603_1608Metric
R3: 2.49k; R_0603_1608Metric
R4, R42: 110; R_0603_1608Metric
R5: 48.1k; R_0603_1608Metric
R6: 34.3k; R_0603_1608Metric
R7: 8m; R_1206_3216Metric
R8, R43: 2; R_0805_2012Metric
R11, R12, R35, R36: 5.1k; R_0603_1608Metric
R17, R18: 1k; R_0603_1608Metric
R20, R21: 27.4; R_0603_1608Metric
R22: R_200k; R_0603_1608Metric
R23, R24: R_470k; R_0603_1608Metric
R25, R26: R_0OHM_JUMPER; R_0603_1608Metric
R31: 270k; R_0603_1608Metric
R33, R34: 5.1M; R_0603_1608Metric
R37: 3k; R_0603_1608Metric
R38, R39, R40, R45: 330; R_0603_1608Metric
R44: 1k 50W; TO-263-2
R46: ?; R_0805_2012Metric
T1: 750032050; SMT_32050_WRE
TP1: VCC; TestPoint_Pad_2.0x2.0mm
TP2: 3.3V; TestPoint_Pad_2.0x2.0mm
TP3: GND; TestPoint_Pad_2.0x2.0mm
TP4: PGND; TestPoint_Pad_2.0x2.0mm
TP5: 5V; TestPoint_Pad_2.0x2.0mm
TP6: CANH; TestPoint_Pad_1.0x1.0mm
TP7: CANL; TestPoint_Pad_1.0x1.0mm
TP8: RXCAN; TestPoint_Pad_1.0x1.0mm
TP9: TXCAN; TestPoint_Pad_1.0x1.0mm
TP10: SI; TestPoint_Pad_1.0x1.0mm
TP11: SO; TestPoint_Pad_1.0x1.0mm
TP12: CS; TestPoint_Pad_1.0x1.0mm
TP13: SCK; TestPoint_Pad_1.0x1.0mm
TP16: 5V; TestPoint_Pad_1.0x1.0mm
TP19: DONE; TestPoint_Pad_1.0x1.0mm
TP20: CHARGE; TestPoint_Pad_1.0x1.0mm
TP21: VGATE; TestPoint_Pad_1.0x1.0mm
TP22: GATEB; TestPoint_Pad_1.0x1.0mm
TP23: CHICKER_GATE; TestPoint_Pad_1.0x1.0mm
TP24: CHIP; TestPoint_Pad_1.0x1.0mm
TP25: CHICK; TestPoint_Pad_1.0x1.0mm
TP29: RESET; TestPoint_Pad_1.0x1.0mm
TP30: BOOT; TestPoint_Pad_1.0x1.0mm
U1: RPI2040; QFN56_7X7_RPI
U2: MCP14A0454-E/SN; SOIC-8_3.9x4.9mm_P1.27mm
U3: AP2114HA-3.3TRG1; SOT-223-3_TabPin2
U4: LT3750; MSOP-10_3x3mm_P0.5mm
U5: W25Q16JVSNIQ; SOIC-8_3.9x4.9mm_P1.27mm
U7: MCP2515-xST; TSSOP-20_4.4x6.5mm_P0.65mm
U8: MCP2551-I-SN; SOIC-8_3.9x4.9mm_P1.27mm
U9, U10: PTS647SM38SMTR2LFS; SW_PTS647SM38SMTR2LFS_CNK
Y1: ABM3-12.000MHZ-D2Y-T; ABM3
Y2: ABM3-8.000MHZ-D2Y-T; ABM3

Connections:
5V_USB: D5.1 (K), J2.A4 (VBUS_A), J2.A9 (VBUS_A), J2.B4 (VBUS_B), J2.B9 (VBUS_B), R14.1, R15.1, R38.2, TP16.1
+3.3V: C11.1, C15.1, C16.1, C17.1, C18.1, C19.1, C20.1, C21.1, C22.1, C26.1, C32.1, C33.1, Q1.1, Q4.1, R1.2, R13.1, R16.1, R19.2, R28.1, R30.1, R36.1, R39.2, TP2.1, U1.1 (IOVDD), U1.10 (IOVDD), U1.22 (IOVDD), U1.33 (IOVDD), U1.42 (IOVDD), U1.43 (ADC_AVDD), U1.44 (VREG_VIN), U1.48 (USB_VDD), U1.49 (IOVDD), U3.2 (OUTPUT), U5.8 (VCC), U7.20 (VDD), U8.3 (VDD)
+5V: C12.1, H5.1, TP5.1, U3.3 (INPUT)
/Flyback_HV/AD_50W: Q6.2 (D), R44.3
/Flyback_HV/AD_G: D12.1 (K), Q5.3, Q6.1 (G), R33.2
/Flyback_HV/AD_LV_G: Q5.1, R31.2, R32.1
/Flyback_HV/AD_R: R33.1, R34.2
/Flyback_HV/CHICKER_GATE: R2.1, R4.2, TP23.1, U2.5 (OUTA)
/Flyback_HV/EXTRA_GATE: R41.1, R42.2, TP22.1, U2.7 (OUTB)
/Flyback_HV/HV_DIO: D3.2 (A), T1.8 (Vout)
/Flyback_HV/IGBTGATE_CHICKER: C9.1, D1.1 (K), Q3.1 (G), R4.1
/Flyback_HV/IGBTGATE_EXTRA: C38.1, D10.1 (K), Q7.1 (G), R42.1
/Flyback_HV/Q2D: D14.2 (A), Q2.2 (D), R5.2, R6.2, T1.3 (VinCOM2), T1.4 (VinCOM3)
/Flyback_HV/RBG: C7.1, R3.2, U4.10 (RBG)
/Flyback_HV/RCD: C29.2, D14.1 (K), R46.2
/Flyback_HV/RDCM: R6.1, U4.8 (RDCM)
/Flyback_HV/RVOUT: R5.1, U4.9 (RVOUT)
/Flyback_HV/SNUB: C39.1, R43.2
/Flyback_HV/SNUB2: C10.1, R8.2
/Flyback_HV/VSOURCE: Q2.3 (S), R7.2, U4.6 (SOURCE)
/Power/3V3_DIO: D8.2 (A), R39.1
/Power/CANR+: H4.1, R26.1
/Power/CANR-: H3.1, R25.1
/Power/USB_DIO: D7.2 (A), R38.1
/Power/VCC_DIO: D6.2 (A), R37.1
/Power/VCC_FUSE: F1.1, H1.1
/RP2040_CAN_FLASH/+1.1V: C13.1, C14.1, C23.1, U1.23 (DVDD), U1.45 (VREG_VOUT), U1.50 (DVDD)
/RP2040_CAN_FLASH/BOOT: R18.1, TP30.1, U10.1, U10.2
/RP2040_CAN_FLASH/CC1: J2.A5 (CC1), R12.1
/RP2040_CAN_FLASH/CC2: J2.B5 (CC2), R11.1
/RP2040_CAN_FLASH/D+: Q4.2, R16.2, R20.2
/RP2040_CAN_FLASH/D-: Q1.2, R13.2, R21.2
/RP2040_CAN_FLASH/DR+: R20.1, U1.47 (USB_DP)
/RP2040_CAN_FLASH/DR-: R21.1, U1.46 (USB_DM)
/RP2040_CAN_FLASH/Data+: J2.A6 (DP1), J2.B6 (DP2), Q4.3, R15.2
/RP2040_CAN_FLASH/Data-: J2.A7 (DN1), J2.B7 (DN2), Q1.3, R14.2
/RP2040_CAN_FLASH/GPIO6: J5.17, R45.1, U1.8 (GPIO6)
/RP2040_CAN_FLASH/GPIO7: J5.16, U1.9 (GPIO7)
/RP2040_CAN_FLASH/GPIO8: J5.15, U1.11 (GPIO8)
/RP2040_CAN_FLASH/GPIO9: J5.14, U1.12 (GPIO9)
/RP2040_CAN_FLASH/GPIO10: J5.13, U1.13 (GPIO10)
/RP2040_CAN_FLASH/GPIO11: J5.12, U1.14 (GPIO11)
/RP2040_CAN_FLASH/GPIO12: J5.11, U1.15 (GPIO12)
/RP2040_CAN_FLASH/GPIO13: J5.10, U1.16 (GPIO13)
/RP2040_CAN_FLASH/GPIO14: J5.9, U1.17 (GPIO14)
/RP2040_CAN_FLASH/GPIO15: J5.8, U1.18 (GPIO15)
/RP2040_CAN_FLASH/GPIO21: J5.7, U1.32 (GPIO21)
/RP2040_CAN_FLASH/GPIO22: J5.18, U1.34 (GPIO22)
/RP2040_CAN_FLASH/GPIO23: J5.4, U1.35 (GPIO23)
/RP2040_CAN_FLASH/GPIO24: J5.6, U1.36 (GPIO24)
/RP2040_CAN_FLASH/GPIO25: J5.5, U1.37 (GPIO25)
/RP2040_CAN_FLASH/GPIO27_ADC1: J5.3, U1.39 (GPIO27/ADC1)
/RP2040_CAN_FLASH/GPIO28_ADC2: J5.2, U1.40 (GPIO28/ADC2)
/RP2040_CAN_FLASH/GPIO29_ADC3: J5.1, U1.41 (GPIO29/ADC3)
/RP2040_CAN_FLASH/INT: R40.1, U1.31 (GPIO20), U7.13 (~INT)
/RP2040_CAN_FLASH/OSC1: C31.1, U7.9 (OSC1), Y2.1
/RP2040_CAN_FLASH/OSC2: C30.1, U7.8 (OSC2), Y2.2
/RP2040_CAN_FLASH/QSPI_SCLK: U1.52 (SQPI_SCLK), U5.6 (CLK)
/RP2040_CAN_FLASH/QSPI_SD0: U1.53 (SQPI_SD0), U5.5 (DI(IO0))
/RP2040_CAN_FLASH/QSPI_SD1: U1.55 (SQPI_SD1), U5.2 (DO(IO1))
/RP2040_CAN_FLASH/QSPI_SD2: U1.54 (SQPI_SD2), U5.3 (IO2)
/RP2040_CAN_FLASH/QSPI_SD3: U1.51 (SQPI_SD3), U5.7 (IO3)
/RP2040_CAN_FLASH/QSPI_SS: R18.2, R19.1, U1.56 (SQPI_SS_N), U5.1 (~CS)
/RP2040_CAN_FLASH/RUN: R28.2, TP29.1, U1.26 (RUN), U9.1, U9.2
/RP2040_CAN_FLASH/RX: J5.20, U1.2 (GPIO0)
/RP2040_CAN_FLASH/RXCAN: TP8.1, U7.2 (RXCAN), U8.4 (RXD)
/RP2040_CAN_FLASH/SPI0_CS: TP12.1, U1.28 (GPIO17), U7.18 (~CS)
/RP2040_CAN_FLASH/SPI0_RX: TP11.1, U1.27 (GPIO16), U7.17 (SO)
/RP2040_CAN_FLASH/SPI0_SCK: TP13.1, U1.29 (GPIO18), U7.14 (SCK)
/RP2040_CAN_FLASH/SPI0_TX: TP10.1, U1.30 (GPIO19), U7.16 (SI)
/RP2040_CAN_FLASH/SWCLK: J1.2, U1.24 (SWCLK)
/RP2040_CAN_FLASH/SWDIO: J1.1, U1.25 (SWDIO)
/RP2040_CAN_FLASH/TX: J5.19, U1.3 (GPIO1)
/RP2040_CAN_FLASH/TXCAN: TP9.1, U7.1 (TXCAN), U8.1 (TXD)
/RP2040_CAN_FLASH/Vref1.65V: R35.1, R36.2, U8.5 (Vref)
/RP2040_CAN_FLASH/XIN: C24.2, U1.20 (XIN), Y1.2
/RP2040_CAN_FLASH/XOUT: R17.2, U1.21 (XOUT)
BATT_LEVEL: R22.1, R24.2, U1.38 (GPIO26/ADC0)
CAN+: J3.2, R26.2, TP6.1, U8.7 (CANH)
CAN-: J3.3, R25.2, TP7.1, U8.6 (CANL)
CHARGE: R27.1, TP20.1, U1.7 (GPIO5), U4.3 (CHARGE)
CHICKER: TP25.1, U1.4 (GPIO2), U2.2 (INA)
CHICKER_HV: D11.2 (A), H8.1, Q3.2 (C), R8.1
CHIP_EXTRA: TP24.1, U1.5 (GPIO3), U2.4 (INB)
DONE: R1.1, TP19.1, U1.6 (GPIO4), U4.2 (~DONE)
EXTRA_HV: D2.2 (A), H6.1, Q7.2 (C), R43.1
GND: C11.2, C13.2, C14.2, C15.2, C16.2, C17.2, C18.2, C19.2, C20.2, C21.2, C22.2, C23.2, C24.1, C25.1, C26.2, C30.2, C31.2, C32.2, C33.2, D5.2 (A), D6.1 (K), D7.1 (K), D8.1 (K), D9.1 (K), D13.1 (K), J1.3, J2.A1 (GND_A), J2.A12 (GND_A), J2.B1 (GND_B), J2.B12 (GND_B), J2.S1 (SHIELD), J2.S2 (SHIELD), J2.S3 (SHIELD), J2.S4 (SHIELD), J3.1, J3.4, NT1.2, R11.2, R12.2, R27.2, R35.2, TP3.1, U1.19 (TESTEN), U1.57 (GND), U3.1 (GND), U5.4 (GND), U7.10 (VSS), U8.2 (VSS), U9.3, U9.4, U10.3, U10.4
GNDPWR: C1.2, C2.2, C3.2, C4.2, C5.2, C6.2, C7.2, C8.2, C9.2, C10.2, C12.2, C28.2, C34.2, C35.2, C37.2, C38.2, C39.2, C40.2, D1.2 (A), D4.1 (K), D10.2 (A), D12.2 (A), H2.1, NT1.1, Q3.3 (E), Q5.2, Q6.3 (S), Q7.3 (E), R2.2, R3.1, R7.1, R22.2, R32.2, R41.2, R44.2, T1.1 (VoutCOM), TP4.1, U2.3 (GND), U4.5 (GND)
HV: C5.1, C6.1, C28.1, D2.1 (K), D3.1 (K), D11.1 (K), H7.1, R9.2, R34.1, R44.1
unnamed: C25.2, R17.1, Y1.1
unnamed: D4.2 (A), R29.1
unnamed: D9.2 (A), R40.2
unnamed: D13.2 (A), R45.2
unnamed: Q2.1 (G), TP21.1, U4.7 (GATE)
unnamed: R10.1, R29.2
unnamed: R9.1, R10.2
unnamed: R23.2, R24.1
unnamed: R30.2, U7.19 (~RESET)
VCC: C1.1, C2.1, C3.1, C4.1, C8.1, C29.1, C34.1, C35.1, C37.1, C40.1, F1.2, R23.1, R31.1, R37.2, R46.1, T1.5 (Vin1), T1.6 (Vin2), TP1.1, U2.6 (VDD), U4.1 (VTRANS), U4.4 (VCC)
