sfunderbots/Electrical/Chicker/Project Files/CAN.kicad_sch

## KiCad design Chicker/Project Files/CAN.kicad_sch (2026-05-11)

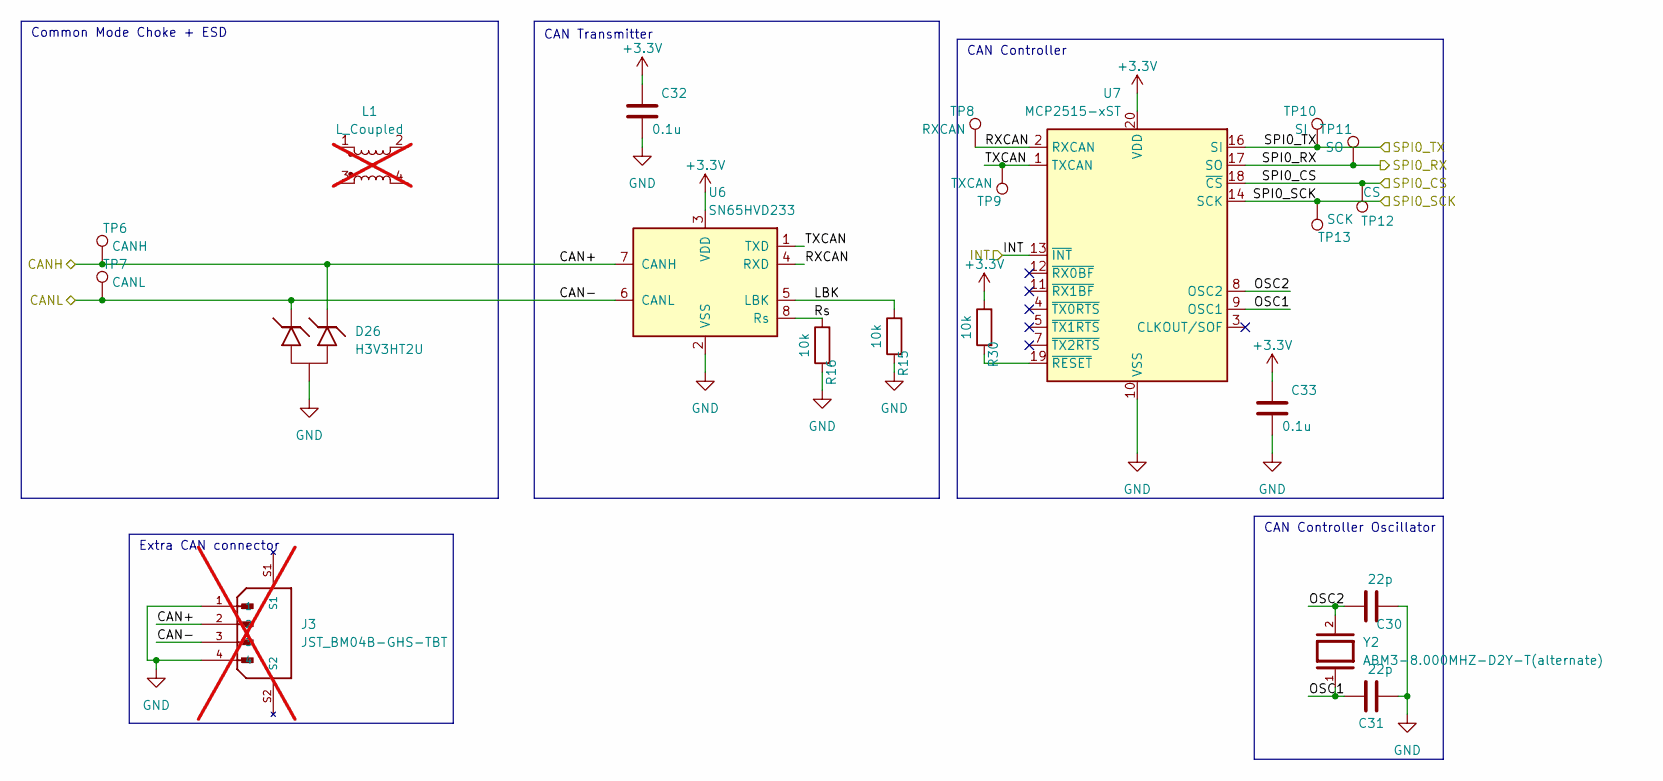
[picture p120: schematic CAN.kicad_sch]

Parts:
C30, C31: 22p; C_0603_1608Metric; MPN CL10C220JB8NNNC; JLC 0603
C32, C33: 0.1u; C_0603_1608Metric; MPN CC0603KRX7R9BB104; JLC 0603
D26: H3V3HT2U; SOT-23; MPN H3V3HT2U; JLC SOT-23
J3: JST_BM04B-GHS-TBT; MPN BM04B-GHS-TBT; not fitted
L1: L_Coupled; not fitted
R15, R16, R30: 10k; R_0603_1608Metric; MPN 0603WAF1002T5E; JLC 0603
TP6: CANH; TestPoint_Pad_1.0x1.0mm
TP7: CANL; TestPoint_Pad_1.0x1.0mm
TP8: RXCAN; TestPoint_Pad_1.0x1.0mm
TP9: TXCAN; TestPoint_Pad_1.0x1.0mm
TP10: SI; TestPoint_Pad_1.0x1.0mm
TP11: SO; TestPoint_Pad_1.0x1.0mm
TP12: CS; TestPoint_Pad_1.0x1.0mm
TP13: SCK; TestPoint_Pad_1.0x1.0mm
U6: SN65HVD233; SOIC-8_3.9x4.9mm_P1.27mm; MPN SN65HVD233; JLC 8-SOIC
U7: MCP2515-xST; TSSOP-20_4.4x6.5mm_P0.65mm; MPN MCP2515T-I/ST; JLC TSSOP-20
Y2: ABM3-8.000MHZ-D2Y-T(alternate); ABM3; MPN X50328MSB2GI; JLC SMD5032

Connections:
+3.3V: C32.1, C33.1, R30.1, U6.3 (VDD), U7.20 (VDD)
CAN+: D26.1, J3.2, TP6.1, U6.7 (CANH)
CAN-: D26.2, J3.3, TP7.1, U6.6 (CANL)
GND: C30.2, C31.2, C32.2, C33.2, D26.3, J3.1, J3.4, R15.2, R16.2, U6.2 (VSS), U7.10 (VSS)
INT: U7.13 (~INT)
LBK: R15.1, U6.5 (LBK)
unnamed: R30.2, U7.19 (~RESET)
OSC1: C31.1, U7.9 (OSC1), Y2.1
OSC2: C30.1, U7.8 (OSC2), Y2.2
RXCAN: TP8.1, U6.4 (RXD), U7.2 (RXCAN)
Rs: R16.1, U6.8 (Rs)
SPI0_CS: TP12.1, U7.18 (~CS)
SPI0_RX: TP11.1, U7.17 (SO)
SPI0_SCK: TP13.1, U7.14 (SCK)
SPI0_TX: TP10.1, U7.16 (SI)
TXCAN: TP9.1, U6.1 (TXD), U7.1 (TXCAN)

Notes on the sheet:
CAN Controller
CAN Controller Oscillator
Extra CAN connector
CAN Transmitter
Common Mode Choke + ESD
