sfunderbots/Electrical/Chicker/Project Files/Flyback_HV.kicad_sch

## KiCad design Chicker/Project Files/Flyback_HV.kicad_sch (2026-05-11)

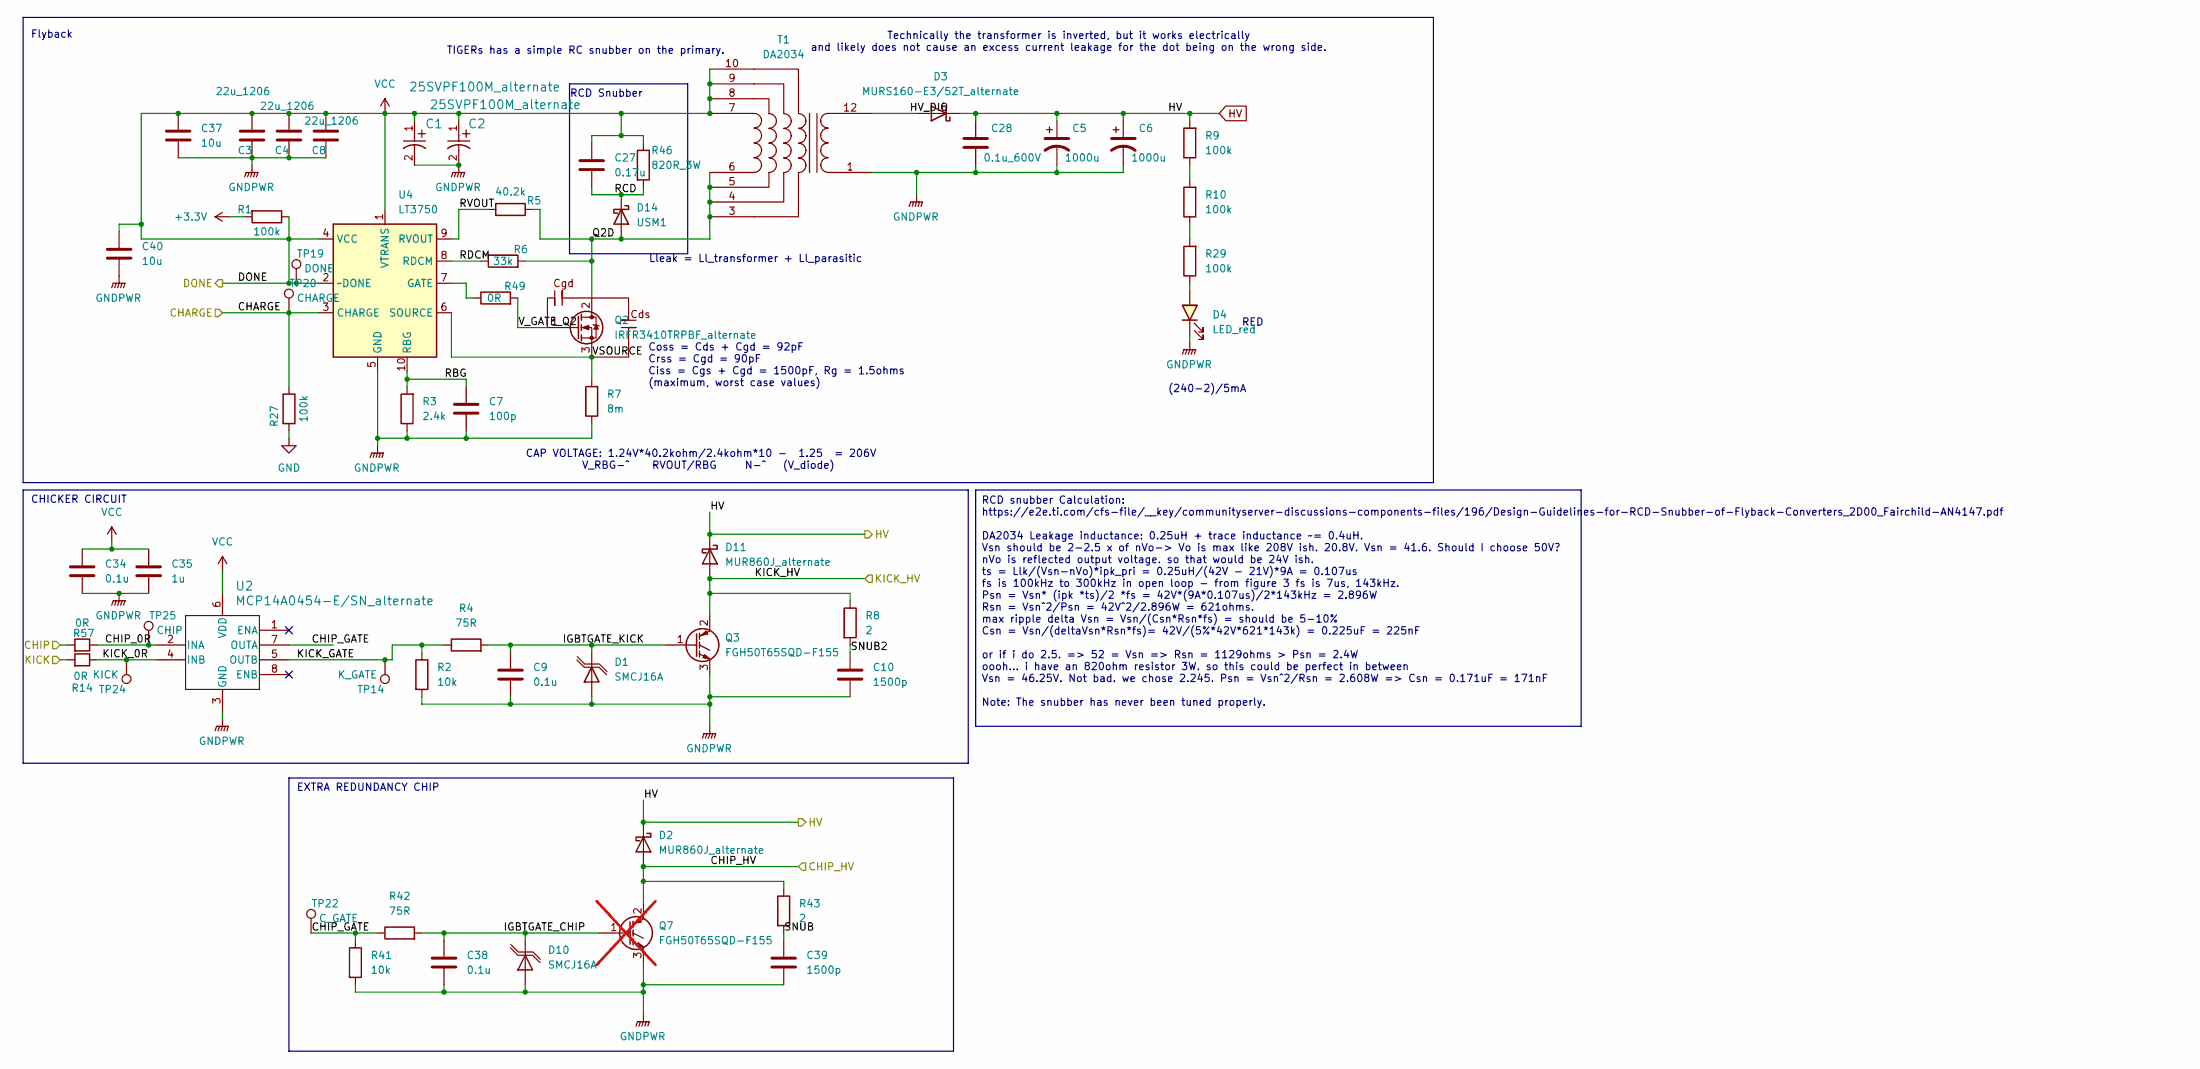
[picture p121: schematic Flyback_HV.kicad_sch]

Parts:
C1, C2: 25SVPF100M_alternate; CAP_25SVPF100M; JLC SMD,D8xL6.5mm
C3, C4, C8: 22u_1206; C_1206_3216Metric; MPN CL31A226KAHNNNE; JLC 0805
C5: 1000u; CP_Radial_Horizontal_D25.4mm_H45mm; MPN ESMQ251VSN102MQ45S
C6: 1000u; CP_Radial_Horizontal_D25.4mm_H45mm_reversed; MPN ESMQ251VSN102MQ45S
C7: 100p; C_0603_1608Metric; MPN CL10C101JB8NNNC; JLC 0603
C9, C34, C38: 0.1u; C_0603_1608Metric; MPN CC0603KRX7R9BB104; JLC 0603
C10, C39: 1500p; C_0805_2012Metric; MPN 0805B152K500NT; JLC 0805
C27: 0.17u; C_0603_1608Metric; MPN CC0603KRX7R9BB104; JLC 0603
C28: 0.1u_600V; C_1210_3225Metric; MPN C3225X7T2J104KT000N; JLC 1210
C35: 1u; C_0603_1608Metric; MPN CL10A105KB8NNNC; JLC 0603
C37, C40: 10u; C_0805_2012Metric; MPN GRM21BR61H106KE43L; JLC 0805
D1, D10: SMCJ16A; D_SMC; MPN SMCJ16A; JLC SMC(DO-214AB)
D2, D11: MUR860J_alternate; D_SMC; MPN ES8J; JLC SMC
D3: MURS160-E3/52T_alternate; D_SMB; MPN US2MB; JLC SMB
D4: LED_red; LED_1206MERGE0805; MPN NCD0805R1; JLC 0805
D14: USM1; D_SMA; MPN USM1; JLC SMA
Q2: IRFR3410TRPBF_alternate; DPAK-3_ONS; MPN CJU15N10; JLC TO-252-2
Q3: FGH50T65SQD-F155; TO-247-3_Horizontal_TabDown; MPN FGH50T65SQD-F155; JLC TO-247
Q7: FGH50T65SQD-F155; TO-247-3_Horizontal_TabDown; MPN FGH50T65SQD-F155; JLC TO-247; not fitted
R1, R9, R10, R27, R29: 100k; R_0603_1608Metric; MPN 0603WAF1003T5E; JLC 0603
R2, R41: 10k; R_0603_1608Metric; MPN 0603WAF1002T5E; JLC 0603
R3: 2.4k; R_0603_1608Metric; MPN 0603WAF2401T5E; JLC 0603
R4, R42: 75R; R_0603_1608Metric; MPN 0603WAF750JT5E; JLC 0603
R5: 40.2k; R_0603_1608Metric; MPN 0603WAF4022T5E; JLC 0603
R6: 33k; R_0603_1608Metric; MPN 0603WAF3302T5E; JLC 0603
R7: 8m; R_1206_3216Metric; MPN FRM121WFR008TM; JLC 1206
R8, R43: 2; R_0805_2012Metric; MPN 0805W8F200KT5E; JLC 0805
R14, R57: 0R; R_0402_1005Metric; MPN 0402WGF0000TCE; JLC 0603
R46: 820R_3W; R_2512_6332Metric; MPN 3522820RJT; JLC 2512
R49: 0R; R_0603_1608Metric; MPN 0603WAF0000T5E; JLC 0603
T1: DA2034; DA2034-ALD_COC; MPN DA2034-ALD
TP14: K_GATE; TestPoint_Pad_1.0x1.0mm
TP19: DONE; TestPoint_Pad_1.0x1.0mm
TP20: CHARGE; TestPoint_Pad_1.0x1.0mm
TP22: C_GATE; TestPoint_Pad_1.0x1.0mm
TP24: KICK; TestPoint_Pad_1.0x1.0mm
TP25: CHIP; TestPoint_Pad_1.0x1.0mm
U2: MCP14A0454-E/SN_alternate; SOIC-8_3.9x4.9mm_P1.27mm; MPN RS8802HXK; JLC SOIC-8
U4: LT3750; MSOP-10_3x3mm_P0.5mm; MPN LT3750EMS#PBF; JLC MSOP-10

Connections:
+3.3V: R1.2
CHARGE: R27.1, TP20.1, U4.3 (CHARGE)
CHIP: R57.1
CHIP_0R: R57.2, TP25.1, U2.2 (INA)
CHIP_GATE: R41.1, R42.1, TP22.1, U2.7 (OUTA)
CHIP_HV: D2.2 (A), Q7.2 (C), R43.1
GND: R27.2
GNDPWR: C1.2, C2.2, C3.2, C4.2, C5.2, C6.2, C7.2, C8.2, C9.2, C10.2, C28.2, C34.2, C35.2, C37.2, C38.2, C39.2, C40.2, D1.2 (A), D4.1 (K), D10.2 (A), Q3.3 (E), Q7.3 (E), R2.2, R3.1, R7.1, R41.2, T1.1 (SB), U2.3 (GND), U4.5 (GND)
HV: C5.1, C6.1, C28.1, D2.1 (K), D3.1 (K), D11.1 (K), R9.2
HV_DIO: D3.2 (A), T1.12 (SB)
IGBTGATE_CHIP: C38.1, D10.1 (K), Q7.1 (G), R42.2
IGBTGATE_KICK: C9.1, D1.1 (K), Q3.1 (G), R4.2
KICK: R14.1
KICK_0R: R14.2, TP24.1, U2.4 (INB)
KICK_GATE: R2.1, R4.1, TP14.1, U2.5 (OUTB)
KICK_HV: D11.2 (A), Q3.2 (C), R8.1
unnamed: D4.2 (A), R29.1
unnamed: R10.1, R29.2
unnamed: R9.1, R10.2
unnamed: R49.1, U4.7 (GATE)
Q2D: D14.2 (A), Q2.2 (D), R5.2, R6.2, T1.3 (AB), T1.4 (AB), T1.5 (AB), T1.6 (AA)
RBG: C7.1, R3.2, U4.10 (RBG)
RCD: C27.2, D14.1 (K), R46.2
RDCM: R6.1, U4.8 (RDCM)
RVOUT: R5.1, U4.9 (RVOUT)
SNUB: C39.1, R43.2
SNUB2: C10.1, R8.2
VCC: C1.1, C2.1, C3.1, C4.1, C8.1, C27.1, C34.1, C35.1, C37.1, C40.1, R1.1, R46.1, T1.7 (AA), T1.8 (AA), T1.9 (AA), T1.10 (AA), TP19.1, U2.6 (VDD), U4.1 (VTRANS), U4.2 (~DONE), U4.4 (VCC)
VSOURCE: Q2.3 (S), R7.2, U4.6 (SOURCE)
V_GATE_Q2: Q2.1 (G), R49.2

Notes on the sheet:
(240-2)/5mA
RCD Snubber
Technically the transformer is inverted, but it works electrically and likely does not cause an excess current leakage for the dot being on the wrong side.
Flyback
TIGERs has a simple RC snubber on the primary.
RED
Lleak = Ll_transformer + Ll_parasitic
CAP VOLTAGE: 1.24V*40.2kohm/2.4kohm*10 - 1.25 = 206V V_RBG-^ RVOUT/RBG N-^ (V_diode)
Coss = Cds + Cgd = 92pF Crss = Cgd = 90pF Ciss = Cgs + Cgd = 1500pF, Rg = 1.5ohms (maximum, worst case values)
EXTRA REDUNDANCY CHIP
CHICKER CIRCUIT
RCD snubber Calculation: https://e2e.ti.com/cfs-file/__key/communityserver-discussions-components-files/196/Design-Guidelines-for-RCD-Snubber-of-Flyback-Converters_2D00_Fairchild-AN4147.pdf DA2034 Leakage inductance: 0.25uH + trace inductance ~= 0.4uH. Vsn should be 2-2.5 x of nVo-> Vo is max like 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
