sfunderbots/Electrical/Chicker/Project Files/HV-feedback.kicad_sch

## KiCad design Chicker/Project Files/HV-feedback.kicad_sch (2026-05-11)

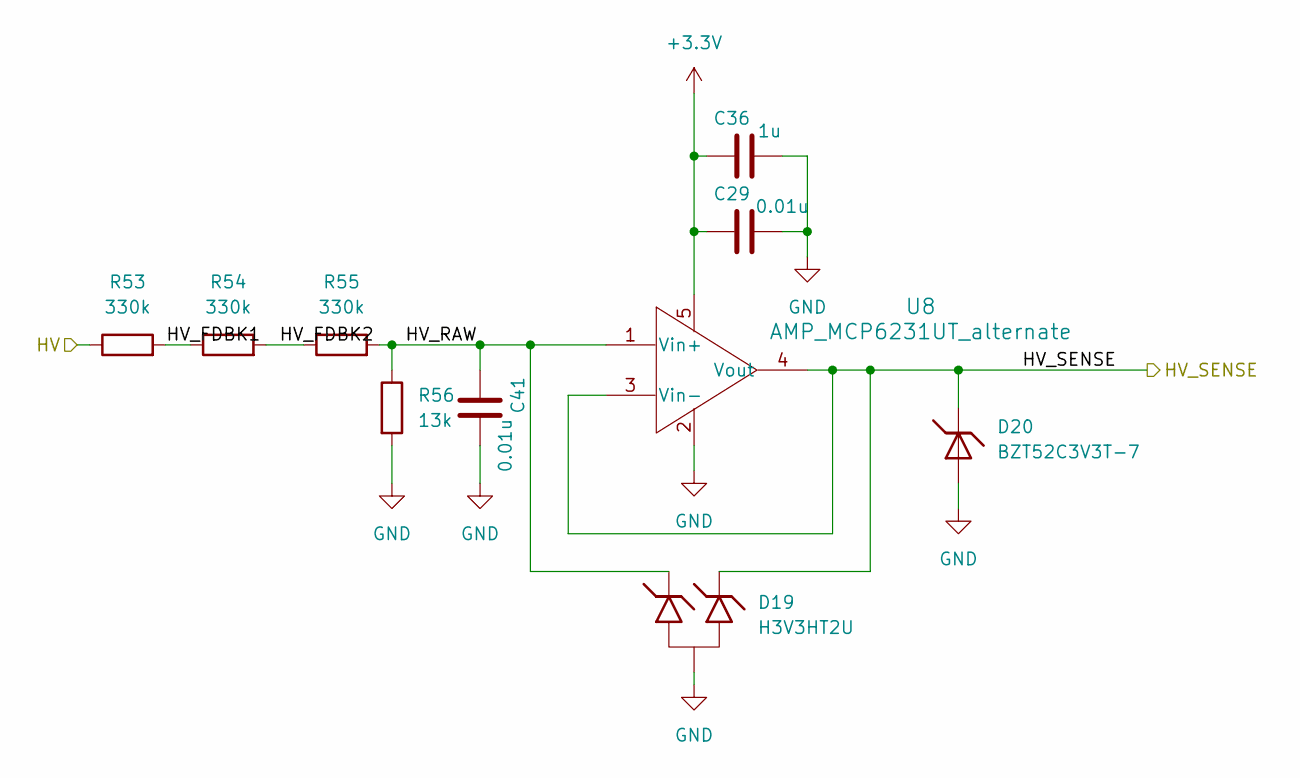
[picture p122: schematic HV-feedback.kicad_sch]

Parts:
C29, C41: 0.01u; C_0603_1608Metric; MPN 0603B103K500NT; JLC 0603
C36: 1u; C_0603_1608Metric; MPN CL10A105KB8NNNC; JLC 0603
D19: H3V3HT2U; SOT-23; MPN H3V3HT2U; JLC SOT-23
D20: BZT52C3V3T-7; D_SOD-523; MPN BZX584C3V3; JLC SOD-523
R53, R54, R55: 330k; R_0603_1608Metric; MPN 0603WAF3303T5E; JLC 0603
R56: 13k; R_0603_1608Metric; MPN 0603WAF1302T5E; JLC 0603
U8: AMP_MCP6231UT_alternate; SOT-23-5; MPN LMV321IDBVR; JLC SOT-23-5

Connections:
+3.3V: C29.1, C36.1, U8.5
GND: C29.2, C36.2, C41.2, D19.3, D20.2 (A), R56.2, U8.2
HV: R53.1
HV_FDBK1: R53.2, R54.1
HV_FDBK2: R54.2, R55.1
HV_RAW: C41.1, D19.2, R55.2, R56.1, U8.1 (Vin+)
HV_SENSE: D19.1, D20.1 (K), U8.3 (Vin-), U8.4 (Vout)
