sfunderbots/Electrical/Chicker/Project Files/RP2040.kicad_sch

## KiCad design Chicker/Project Files/RP2040.kicad_sch (2026-05-11)

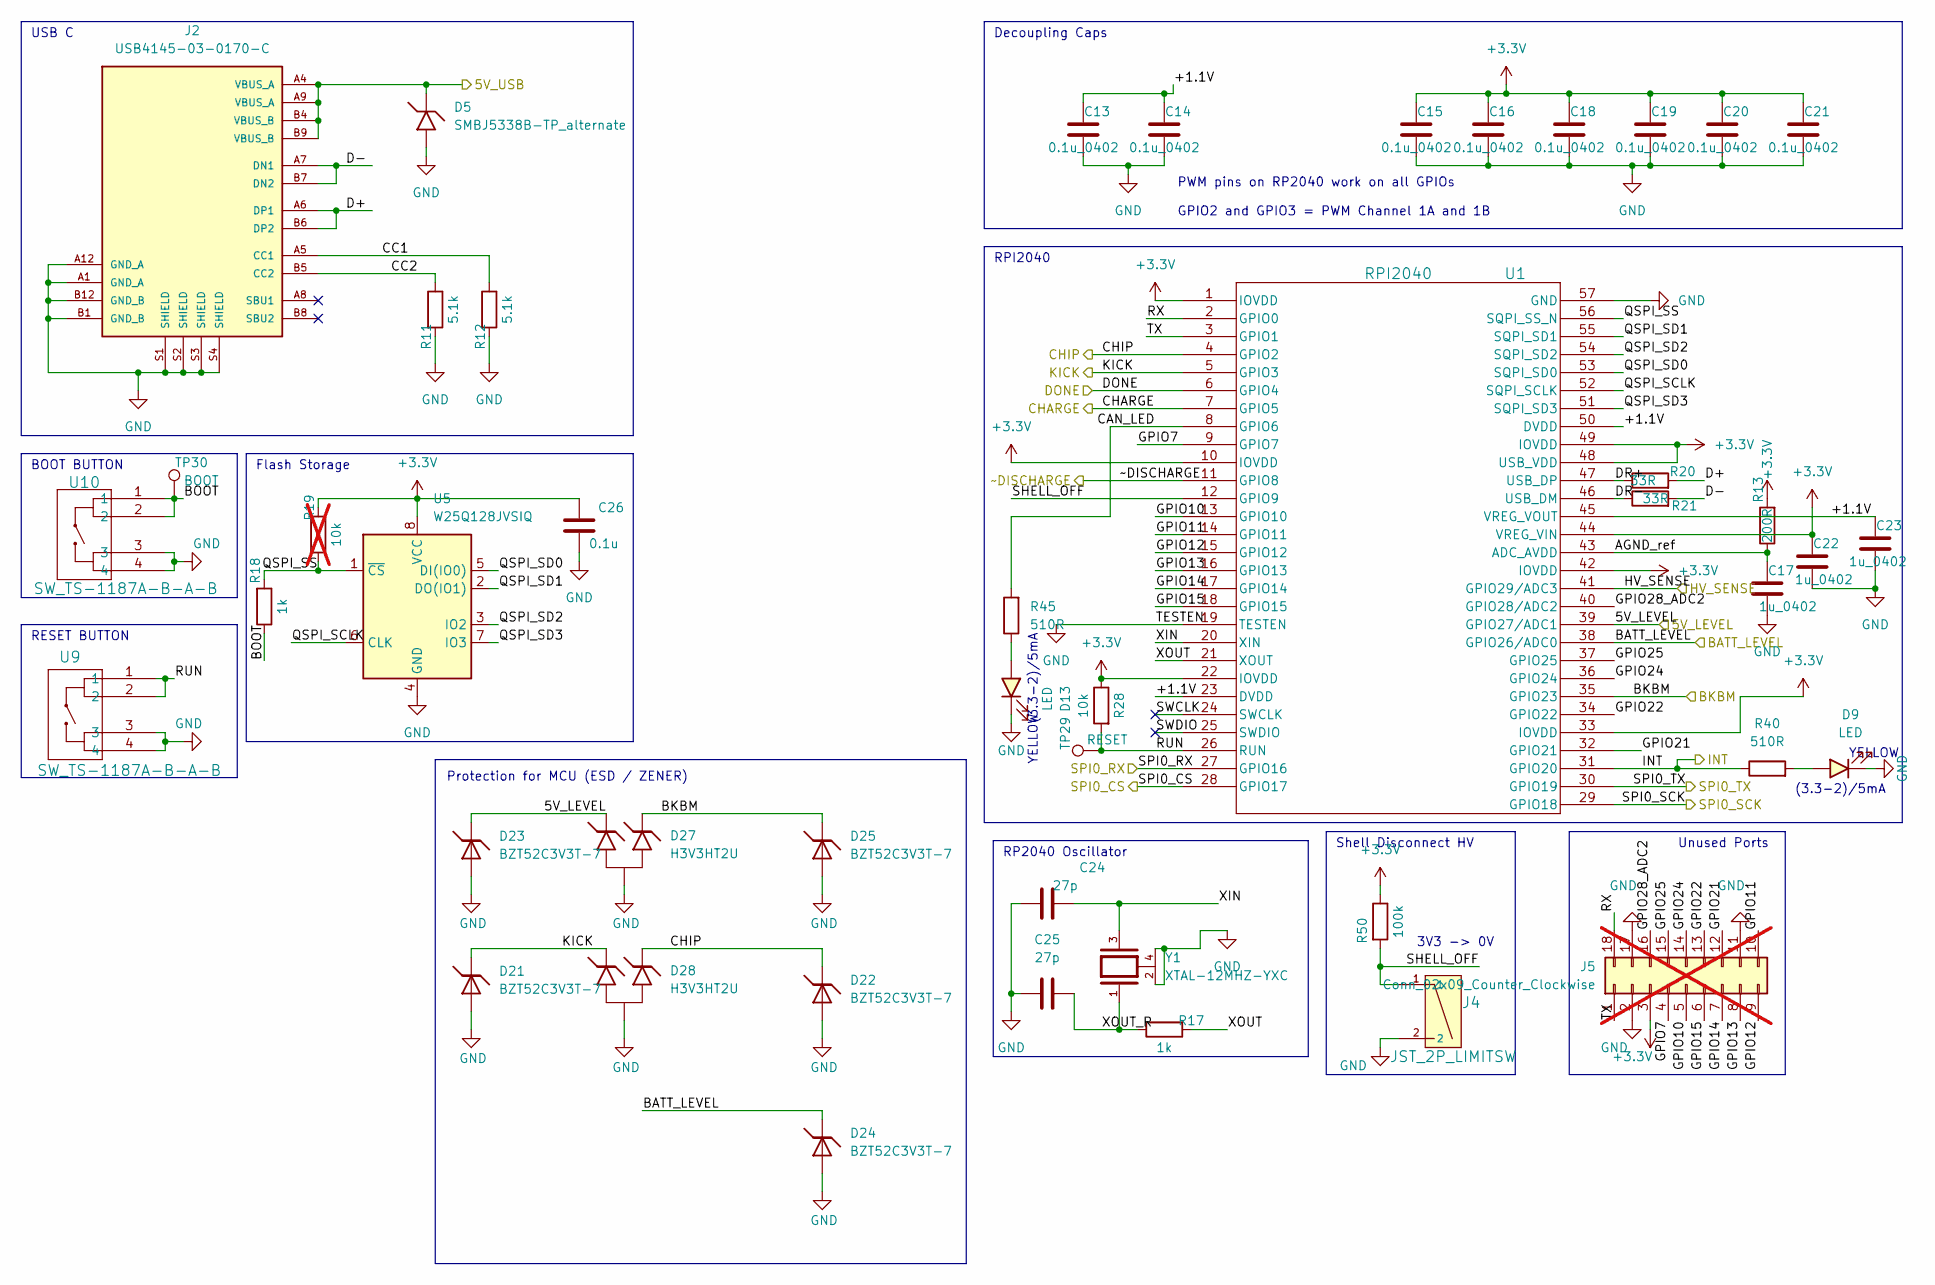
[picture p123: schematic RP2040.kicad_sch]

Parts:
C13, C14, C15, C16, C18, C19, C20, C21: 0.1u_0402; C_0402_1005Metric; MPN CL05B104KB54PNC; JLC 0402
C17, C22, C23: 1u_0402; C_0402_1005Metric; MPN CL05A105KA5NQNC; JLC 0402
C24, C25: 27p; C_0603_1608Metric; MPN CC0603JRNPO9BN270; JLC 0603
C26: 0.1u; C_0603_1608Metric; MPN CC0603KRX7R9BB104; JLC 0603
D5: SMBJ5338B-TP_alternate; D_SMB; MPN SMBJ5338B; JLC SMB
D9, D13: LED; LED_0805_2012Metric; MPN KT-0805Y; JLC 0805
D21, D22, D23, D24, D25: BZT52C3V3T-7; D_SOD-523; MPN BZX584C3V3; JLC SOD-523
D27, D28: H3V3HT2U; SOT-23; MPN H3V3HT2U; JLC SOT-23
J2: USB4145-03-0170-C; GCT_USB4145-03-0170-C_REVA2; MPN USB4145-03-0170-C; JLC SMD
J4: JST_2P_LIMITSW; JST_B2B-XH-A_LF__SN_
J5: Conn_02x09_Counter_Clockwise; PinHeader_2x09_P2.54mm_Vertical; not fitted
R11, R12: 5.1k; R_0603_1608Metric; MPN 0603WAF5101T5E; JLC 0603
R13: 200R; R_0603_1608Metric; MPN 0603WAF2000T5E; JLC 0603
R17, R18: 1k; R_0603_1608Metric; MPN 0603WAF1001T5E; JLC 0603
R19: 10k; R_0603_1608Metric; MPN 0603WAF1002T5E; JLC 0603; not fitted
R20, R21: 33R; R_0603_1608Metric; MPN 0603WAF330JT5E; JLC 0603
R28: 10k; R_0603_1608Metric; MPN 0603WAF1002T5E; JLC 0603
R40, R45: 510R; R_0603_1608Metric; MPN 0603WAF5100T5E; JLC 0603
R50: 100k; R_0603_1608Metric; MPN 0603WAF1003T5E; JLC 0603
TP29: RESET; TestPoint_Pad_1.0x1.0mm
TP30: BOOT; TestPoint_Pad_1.0x1.0mm
U1: RPI2040; QFN56_7X7_RPI; MPN RP2040; JLC LQFN-56(7x7)
U5: W25Q128JVSIQ; SOIC-8_208mil; MPN W25Q128JVSIQ; JLC SOIC-8-208mil
U9, U10: SW_TS-1187A-B-A-B; MPN TS-1187A-B-A-B; JLC SMD
Y1: XTAL-12MHZ-YXC; SMD3225-4P; MPN X322512MSB4SI; JLC SMD3225-4P

Connections:
5V_LEVEL: D23.1 (K), D27.2, U1.39 (GPIO27/ADC1)
5V_USB: D5.1 (K), J2.A4 (VBUS_A), J2.A9 (VBUS_A), J2.B4 (VBUS_B), J2.B9 (VBUS_B)
+1.1V: C13.1, C14.1, C23.1, U1.23 (DVDD), U1.45 (VREG_VOUT), U1.50 (DVDD)
+3.3V: C15.1, C16.1, C18.1, C19.1, C20.1, C21.1, C22.1, C26.1, J5.3, R13.2, R19.2, R28.1, R50.1, U1.1 (IOVDD), U1.10 (IOVDD), U1.22 (IOVDD), U1.33 (IOVDD), U1.42 (IOVDD), U1.44 (VREG_VIN), U1.48 (USB_VDD), U1.49 (IOVDD), U5.8 (VCC)
AGND_ref: C17.1, R13.1, U1.43 (ADC_AVDD)
BATT_LEVEL: D24.1 (K), U1.38 (GPIO26/ADC0)
BKBM: D25.1 (K), D27.1, U1.35 (GPIO23)
BOOT: R18.1, TP30.1, U10.1, U10.2
CAN_LED: R45.2, U1.8 (GPIO6)
CC1: J2.A5 (CC1), R12.1
CC2: J2.B5 (CC2), R11.1
CHARGE: U1.7 (GPIO5)
CHIP: D22.1 (K), D28.1, U1.4 (GPIO2)
D+: J2.A6 (DP1), J2.B6 (DP2), R20.2
D-: J2.A7 (DN1), J2.B7 (DN2), R21.2
DONE: U1.6 (GPIO4)
DR+: R20.1, U1.47 (USB_DP)
DR-: R21.1, U1.46 (USB_DM)
GND: C13.2, C14.2, C15.2, C16.2, C17.2, C18.2, C19.2, C20.2, C21.2, C22.2, C23.2, C24.1, C25.1, C26.2, D5.2 (A), D9.1 (K), D13.1 (K), D21.2 (A), D22.2 (A), D23.2 (A), D24.2 (A), D25.2 (A), D27.3, D28.3, J2.A1 (GND_A), J2.A12 (GND_A), J2.B1 (GND_B), J2.B12 (GND_B), J2.S1 (SHIELD), J2.S2 (SHIELD), J2.S3 (SHIELD), J2.S4 (SHIELD), J4.2, J5.2, J5.11, J5.17, R11.2, R12.2, U1.19 (TESTEN), U1.57 (GND), U5.4 (GND), U9.3, U9.4, U10.3, U10.4, Y1.2, Y1.4
GPIO7: J5.4, U1.9 (GPIO7)
GPIO10: J5.5, U1.13 (GPIO10)
GPIO11: J5.10, U1.14 (GPIO11)
GPIO12: J5.9, U1.15 (GPIO12)
GPIO13: J5.8, U1.16 (GPIO13)
GPIO14: J5.7, U1.17 (GPIO14)
GPIO15: J5.6, U1.18 (GPIO15)
GPIO21: J5.12, U1.32 (GPIO21)
GPIO22: J5.13, U1.34 (GPIO22)
GPIO24: J5.14, U1.36 (GPIO24)
GPIO25: J5.15, U1.37 (GPIO25)
GPIO28_ADC2: J5.16, U1.40 (GPIO28/ADC2)
HV_SENSE: U1.41 (GPIO29/ADC3)
INT: R40.1, U1.31 (GPIO20)
KICK: D21.1 (K), D28.2, U1.5 (GPIO3)
unnamed: D9.2 (A), R40.2
unnamed: D13.2 (A), R45.1
QSPI_SCLK: U1.52 (SQPI_SCLK), U5.6 (CLK)
QSPI_SD0: U1.53 (SQPI_SD0), U5.5 (DI(IO0))
QSPI_SD1: U1.55 (SQPI_SD1), U5.2 (DO(IO1))
QSPI_SD2: U1.54 (SQPI_SD2), U5.3 (IO2)
QSPI_SD3: U1.51 (SQPI_SD3), U5.7 (IO3)
QSPI_SS: R18.2, R19.1, U1.56 (SQPI_SS_N), U5.1 (~CS)
RUN: R28.2, TP29.1, U1.26 (RUN), U9.1, U9.2
RX: J5.18, U1.2 (GPIO0)
SHELL_OFF: J4.1, R50.2, U1.12 (GPIO9)
SPI0_CS: U1.28 (GPIO17)
SPI0_RX: U1.27 (GPIO16)
SPI0_SCK: U1.29 (GPIO18)
SPI0_TX: U1.30 (GPIO19)
SWCLK: U1.24 (SWCLK)
SWDIO: U1.25 (SWDIO)
TX: J5.1, U1.3 (GPIO1)
XIN: C24.2, U1.20 (XIN), Y1.3
XOUT: R17.2, U1.21 (XOUT)
XOUT_R: C25.2, R17.1, Y1.1
~DISCHARGE: U1.11 (GPIO8)

Notes on the sheet:
Unused Ports
YELLOW
BOOT BUTTON
USB C
(3.3-2)/5mA
Decoupling Caps
Flash Storage
RP2040 Oscillator
RPI2040
PWM pins on RP2040 work on all GPIOs GPIO2 and GPIO3 = PWM Channel 1A and 1B
Shell Disconnect HV
3V3 -> 0V
RESET BUTTON
Protection for MCU (ESD / ZENER)
