sfunderbots/Electrical/Chicker/Project Files/autodischarge.kicad_sch

## KiCad design Chicker/Project Files/autodischarge.kicad_sch (2026-05-11)

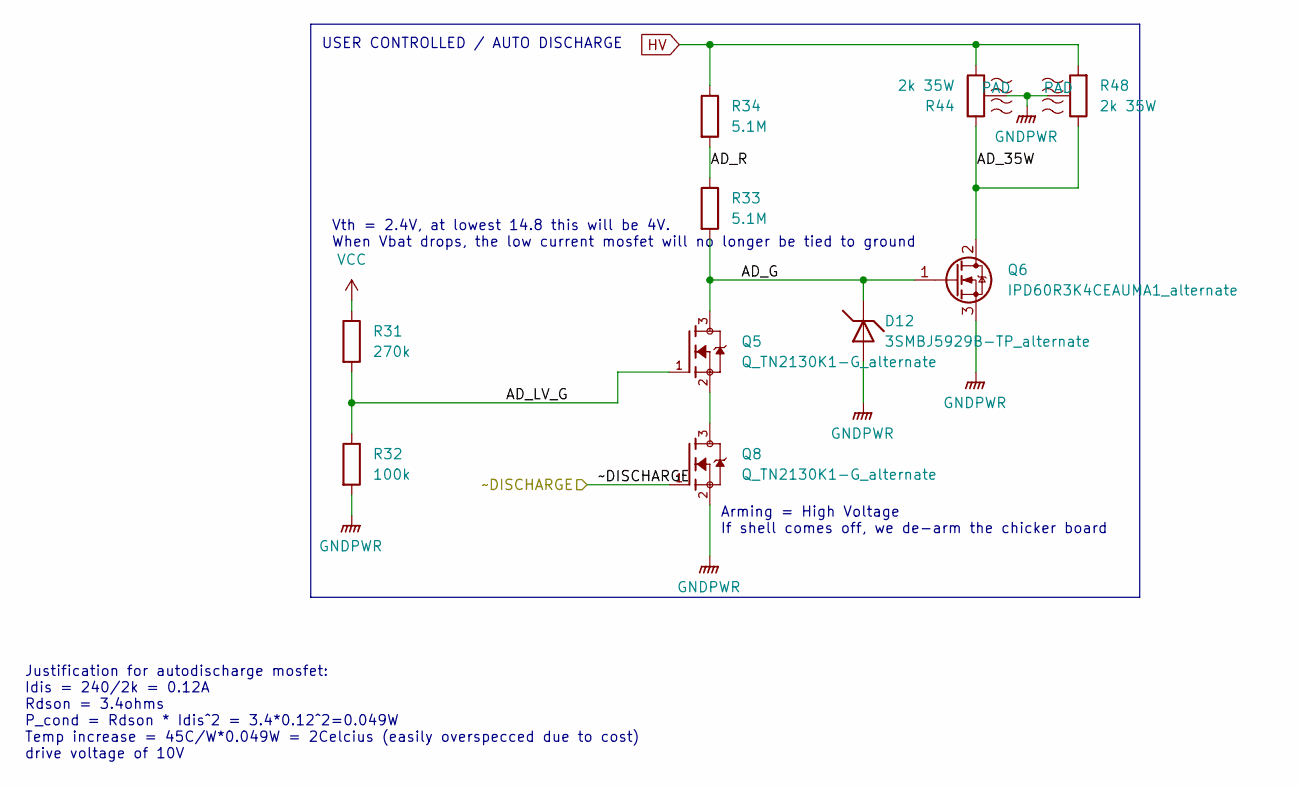
[picture p124: schematic autodischarge.kicad_sch]

Parts:
D12: 3SMBJ5929B-TP_alternate; D_SMB; MPN SMBJ5352B-TP; JLC SMBJ5352B-TP
Q5, Q8: Q_TN2130K1-G_alternate; SOT95P240X111-3N; MPN BSS131H6327; JLC SOT-23
Q6: IPD60R3K4CEAUMA1_alternate; DPAK-3_ONS; MPN SWD2N60DC; JLC TO-252
R31: 270k; R_0603_1608Metric; MPN 0603WAF2703T5E; JLC 0603
R32: 100k; R_0603_1608Metric; MPN 0603WAF1003T5E; JLC 0603
R33, R34: 5.1M; R_0603_1608Metric; MPN 0603WAF5104T5E; JLC 0603
R44, R48: 2k 35W; TO-220-2_Horizontal_TabDown; MPN PWR220T-35-2001J

Connections:
AD_35W: Q6.2 (D), R44.1, R48.2
AD_G: D12.1 (K), Q5.3, Q6.1 (G), R33.2
AD_LV_G: Q5.1, R31.2, R32.1
AD_R: R33.1, R34.2
GNDPWR: D12.2 (A), Q6.3 (S), Q8.2, R32.2, R44.3 (PAD), R48.3 (PAD)
HV: R34.1, R44.2, R48.1
unnamed: Q5.2, Q8.3
VCC: R31.1
~DISCHARGE: Q8.1

Notes on the sheet:
Arming = High Voltage If shell comes off, we de-arm the chicker board
Justification for autodischarge mosfet: Idis = 240/2k = 0.12A Rdson = 3.4ohms P_cond = Rdson * Idis^2 = 3.4*0.12^2=0.049W Temp increase = 45C/W*0.049W = 2Celcius (easily overspecced due to cost) drive voltage of 10V
USER CONTROLLED / AUTO DISCHARGE
Vth = 2.4V, at lowest 14.8 this will be 4V. When Vbat drops, the low current mosfet will no longer be tied to ground
