sfunderbots/Electrical/Chicker/Project Files/power.kicad_sch

## KiCad design Chicker/Project Files/power.kicad_sch (2026-05-11)

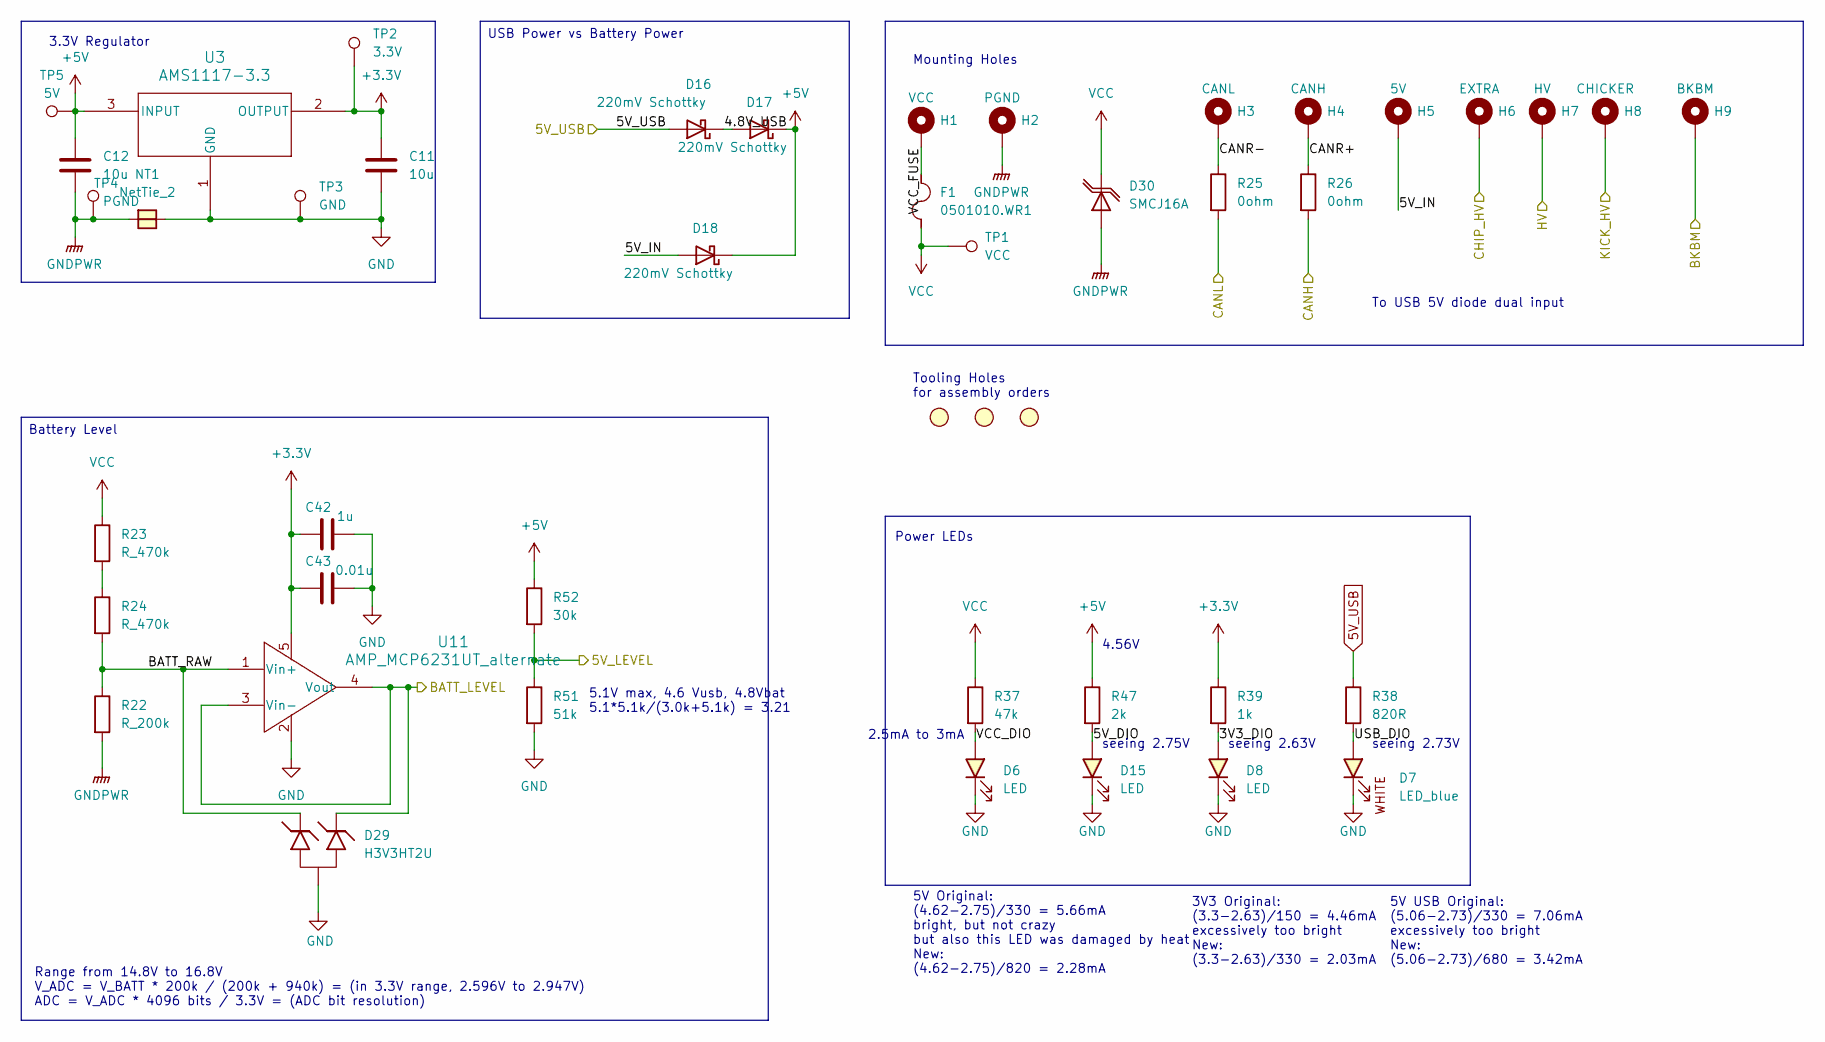
[picture p125: schematic power.kicad_sch]

Parts:
C11, C12: 10u; C_0805_2012Metric; MPN GRM21BR61H106KE43L; JLC 0805
C42: 1u; C_0603_1608Metric; MPN CL10A105KB8NNNC; JLC 0603
C43: 0.01u; C_0603_1608Metric; MPN 0603B103K500NT; JLC 0603
D6, D8, D15: LED; LED_0805_2012Metric; MPN KT-0805G; JLC 0805
D7: LED_blue; LED_0603_1608Metric; MPN KT-0603W; JLC 0603
D16, D17, D18: 220mV Schottky; D_SOD-323_HandSoldering; MPN CUS08F30,H3F; JLC SC-76(SOD-232)
D29: H3V3HT2U; SOT-23; MPN H3V3HT2U; JLC SOT-23
D30: SMCJ16A; D_SMC; MPN SMCJ16A; JLC SMC(DO-214AB)
F1: 0501010.WR1; Fuse_1206_3216Metric; MPN 0501010.WR1; JLC 1206
H1: VCC; MountingHole_2.7mm_M2.5_DIN965_Pad
H2: PGND; MountingHole_2.7mm_M2.5_DIN965_Pad
H3: CANL; MountingHole_2.7mm_M2.5_DIN965_Pad
H4: CANH; MountingHole_2.7mm_M2.5_DIN965_Pad
H5: 5V; MountingHole_2.7mm_M2.5_DIN965_Pad
H6: EXTRA; MountingHole_2.7mm_M2.5_DIN965_Pad
H7: HV; MountingHole_2.7mm_M2.5_DIN965_Pad
H8: CHICKER; MountingHole_2.7mm_M2.5_DIN965_Pad
H9: BKBM; MountingHole_2.7mm_M2.5_DIN965_Pad
H10, H11, H12: ToolingHoleJLC
NT1: NetTie_2; NetTie-2_SMD_Pad2.0mm
R22: R_200k; R_0603_1608Metric; MPN 0603WAF2003T5E; JLC 0603
R23, R24: R_470k; R_0603_1608Metric; MPN 0603WAF4703T5E; JLC 0603
R25, R26: 0ohm; R_0603_1608Metric; MPN 0603WAF0000T5E; JLC 0603
R37: 47k; R_0603_1608Metric; MPN 0603WAF4702T5E; JLC 0603
R38: 820R; R_0603_1608Metric; MPN 0603WAF8200T5E; JLC 0603
R39: 1k; R_0603_1608Metric; MPN 0603WAF1001T5E; JLC 0603
R47: 2k; R_0603_1608Metric; MPN 0603WAF2001T5E; JLC 0603
R51: 51k; R_0603_1608Metric; MPN 0603WAF5102T5E; JLC 0603
R52: 30k; R_0603_1608Metric; MPN 0603WAF3002T5E; JLC 0603
TP1: VCC; TestPoint_Pad_2.0x2.0mm
TP2: 3.3V; TestPoint_Pad_2.0x2.0mm
TP3: GND; TestPoint_Pad_2.0x2.0mm
TP4: PGND; TestPoint_Pad_2.0x2.0mm
TP5: 5V; TestPoint_Pad_2.0x2.0mm
U3: AMS1117-3.3; SOT-223-3_TabPin2; MPN AMS1117-3.3; JLC SOT-223
U11: AMP_MCP6231UT_alternate; SOT-23-5; MPN LMV321IDBVR; JLC SOT-23-5

Connections:
3V3_DIO: D8.2 (A), R39.2
4.8V_USB: D16.1 (K), D17.2 (A)
5V_DIO: D15.2 (A), R47.2
5V_IN: D18.2 (A), H5.1
5V_LEVEL: R51.1, R52.2
5V_USB: D16.2 (A), R38.1
+3.3V: C11.1, C42.1, C43.1, R39.1, TP2.1, U3.2 (OUTPUT), U11.5
+5V: C12.1, D17.1 (K), D18.1 (K), R47.1, R52.1, TP5.1, U3.3 (INPUT)
BATT_LEVEL: D29.1, U11.3 (Vin-), U11.4 (Vout)
BATT_RAW: D29.2, R22.1, R24.2, U11.1 (Vin+)
BKBM: H9.1
CANH: R26.2
CANL: R25.2
CANR+: H4.1, R26.1
CANR-: H3.1, R25.1
CHIP_HV: H6.1
GND: C11.2, C42.2, C43.2, D6.1 (K), D7.1 (K), D8.1 (K), D15.1 (K), D29.3, NT1.2, R51.2, TP3.1, U3.1 (GND), U11.2
GNDPWR: C12.2, D30.2 (A), H2.1, NT1.1, R22.2, TP4.1
HV: H7.1
KICK_HV: H8.1
unnamed: R23.2, R24.1
USB_DIO: D7.2 (A), R38.2
VCC: D30.1 (K), F1.1, R23.1, R37.1, TP1.1
VCC_DIO: D6.2 (A), R37.2
VCC_FUSE: F1.2, H1.1

Notes on the sheet:
4.56V
2.5mA to 3mA
Mounting Holes
5V Original: (4.62-2.75)/330 = 5.66mA bright, but not crazy but also this LED was damaged by heat New: (4.62-2.75)/820 = 2.28mA
To USB 5V diode dual input
5.1V max, 4.6 Vusb, 4.8Vbat 5.1*5.1k/(3.0k+5.1k) = 3.21
seeing 2.75V
seeing 2.73V
3.3V Regulator
Power LEDs
3V3 Original: (3.3-2.63)/150 = 4.46mA excessively too bright New: (3.3-2.63)/330 = 2.03mA
5V USB Original: (5.06-2.73)/330 = 7.06mA excessively too bright New: (5.06-2.73)/680 = 3.42mA
seeing 2.63V
Tooling Holes for assembly orders
Range from 14.8V to 16.8V V_ADC = V_BATT * 200k / (200k + 940k) = (in 3.3V range, 2.596V to 2.947V) ADC = V_ADC * 4096 bits / 3.3V = (ADC bit resolution)
Battery Level
USB Power vs Battery Power
