sfunderbots/Electrical/(commit log)

2022-08-10 PAC5527 MD sch capture init
    [PAC5527Driver.kicad_pcb, PAC5527Driver.sch]
2022-08-10 Remove unecessary directory
    [PAC5527Driver.kicad_pcb, PAC5527Driver.sch]
2022-08-18 can transceiver, DC h-bridge, dual MA732 enc
    [PAC5527Driver.kicad_pcb]
2022-08-19 Dual POWERPAK-SO8 compatible footprint for BLDC fets
    [PAC5527Driver.kicad_pcb, PAC5527Driver.kicad_sch]
2022-12-31 updated schematic with GPIO, connectors
    [009155006741006.step, PAC5527Driver.kicad_pcb, PAC5527Driver.kicad_sch]
2023-03-20 updated project to kiCAD 7
    [PAC5527Driver.kicad_sch]
2023-03-20 Added baseplate directory
    [BasePlate.kicad_pcb, BasePlate.kicad_sch]
2023-03-27 updated base-plate project and motor driver connections
    [20P-JMDSS-G-1-TF.STEP, 20PS-JMDSS-G-1-TF.STEP, 20R-JMDSS-G-1-TF(S).STEP, AVX-13-9159-006-101-916.STEP, AVX-20-9159-006-101-916.STEP, BasePlate.kicad_sch, MCU.kicad_sch, PAC5527Driver.kicad_sch]
2023-03-27 partial midplate MCU, power monitor, and connector blocks
    [midplate.kicad_pcb, midplate.kicad_sch, midplate_MCU.kicad_sch, midplate_motordriver_conn.kicad_sch, midplate_power_monitor.kicad_sch]
2023-04-09 Can driver update to SN65HVD230
    [PAC5527Driver.kicad_sch]
2023-04-11 add mainboard
    [BoardyMcBoardFace.kicad_pcb, BoardyMcBoardFace.kicad_sch, BoardyMcBoardFace.sch]
2023-04-16 start switching form factor to midplate
    [BoardyMcBoardFace.kicad_pcb, BoardyMcBoardFace.kicad_sch]
2023-04-23 added OPi Zero2 symbol and subsheet to midplate
    [midplate.kicad_sch, midplate_MCU.kicad_sch, opizero2_interface.kicad_sch]
2023-06-03 remove boardymcboardface
    [BoardyMcBoardFace.kicad_pcb, BoardyMcBoardFace.kicad_sch, BoardyMcBoardFace.sch]
2023-06-03 USB SX1280 Adapter
    [SX1280_USB_Adapter-B_Cu.gbl, SX1280_USB_Adapter-B_Mask.gbs, SX1280_USB_Adapter-B_Paste.gbp, SX1280_USB_Adapter-B_Silkscreen.gbo, SX1280_USB_Adapter-Edge_Cuts.gm1, SX1280_USB_Adapter-F_Cu.gtl, SX1280_USB_Adapter-F_Mask.gts, SX1280_USB_Adapter-F_Paste.gtp]
2023-09-20 Power board
    [POWER_BOARD.kicad_pcb, POWER_BOARD.kicad_sch, power.kicad_sch]
2023-10-07 added 2040 flashing circuit and battery monitor
    [Flashing.kicad_sch, POWER_BOARD.kicad_sch, power.kicad_sch]
2023-10-18 updated board shape + placed most components
    [Flashing.kicad_sch, POWER_BOARD.kicad_pcb, POWER_BOARD.kicad_sch, power.kicad_sch]
2023-10-18 board components mostly placed correctly
    [436500200.stp, 445-CRYTAL-SMD.STEP, B3B-XH-A.STEP, DPAK-3_ONS.step, Flashing.kicad_sch, Flyback_HV.kicad_sch, POWER_BOARD.kicad_pcb, POWER_BOARD.kicad_sch]
2023-10-19 updated small details + LEDS
    [Flyback_HV.kicad_sch, POWER_BOARD.kicad_pcb, RP2040_CAN_FLASH.kicad_sch, power.kicad_sch]
2023-10-20 update to layout
    [436500215.stp, Flyback_HV.kicad_sch, POWER_BOARD.kicad_pcb, RP2040_CAN_FLASH.kicad_sch, USB4145-03-0170-C_REVA2.step, power.kicad_sch]
2023-10-21 layout v1 complete
    - consider adding a auto discharge circuit
    [Flyback_HV.kicad_sch, POWER_BOARD.kicad_pcb, RP2040_CAN_FLASH.kicad_sch, power.kicad_sch]
2023-10-23 updated layout
    [A768EB566M1VLAE042.step, Flyback_HV.kicad_sch, POWER_BOARD.kicad_pcb]
2023-10-30 auto discharge circuit
    [ASPI-0630LR-150M-T15--3DModel-STEP-400430.STEP, Flyback_HV.kicad_sch, LM2598SX-12.stp, POWER_BOARD.kicad_pcb, PTS647SM50SMTR2LFS.stp, RP2040_CAN_FLASH.kicad_sch, power.kicad_sch]
2023-11-11 updated board edge clearance and cap model
    [Flyback_HV.kicad_sch, POWER_BOARD.kicad_pcb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]
2023-11-11 updated layout for design review
    [POWER_BOARD.kicad_pcb, RP2040_CAN_FLASH.kicad_sch]
2023-11-14 updated to 1mm on cap attachment
    [POWER_BOARD.kicad_pcb]
2023-11-18 add face plate wip
    [FacePlate.kicad_pcb, FacePlate.kicad_sch, ball_detectors.kicad_sch, can.kicad_sch, radio.kicad_sch]
2023-11-19 updated fuse, pillars, caps
    - Added 10A fuse to VCC pillar
    - Added CANL pillar next to CANH (and old CANL pillar is NC)
    - Adjusted CAPS left and right by 1mm to add space for the board
    - Added another LED wired to the RP2040 for CAN status
    [Flyback_HV.kicad_sch, POWER_BOARD.kicad_pcb, RP2040_CAN_FLASH.kicad_sch, power.kicad_sch]
2023-11-28 modified design
    - added RCD snubber on transformer primary
    - moved GND and CANL CANH posts to make room (and next to eachother)
    [Flyback_HV.kicad_sch, POWER_BOARD.kicad_pcb, power.kicad_sch]
2023-11-28 passed DRC check
    [POWER_BOARD.kicad_pcb, RP2040_CAN_FLASH.kicad_sch]
2023-11-29 added pdfs
    [POWER_BOARD.kicad_pcb]
2023-11-29 update to power board and midplate schematics
    [POWER_BOARD.kicad_pcb, midplate.kicad_pcb, midplate_MCU.kicad_sch, midplate_motordriver_conn.kicad_sch, midplate_power_monitor.kicad_sch, opizero2_interface.kicad_sch, power-input.kicad_sch, power.kicad_sch]
2023-11-30 added switch and fuse
    [3549-2.STEP, Fuse - mini 10A.step, POWER_BOARD.kicad_pcb, R1966ABLKBLKGR.step, midplate.kicad_pcb, midplate_MCU.kicad_sch, midplate_motordriver_conn.kicad_sch, midplate_power_monitor.kicad_sch]
2023-12-04 powerboard HV powerpillars + midplate
    [Flyback_HV.kicad_sch, POWER_BOARD.kicad_pcb, User Library-XT60 male.STEP, XT60PW-M.STEP, midplate.kicad_pcb, midplate.kicad_sch, midplate_MCU.kicad_sch, midplate_motordriver_conn.kicad_sch]
2023-12-04 update to midplate
    [436500224.stp, JS202011JAQN.step, Keystone_14825.STEP, midplate.dxf, midplate.kicad_pcb, power-input.kicad_sch, powerboard-conn.kicad_sch]
2023-12-06 changed mosfet package to dedicated halfbridge variants for space saving metrics
    [PAC5527Driver.kicad_pcb, PAC5527Driver.kicad_sch]
2023-12-07 board shape and MH layout
    [PAC5527Driver.kicad_pcb, PAC5527Driver.kicad_sch]
2023-12-07 component placement, first pass
    [PAC5527Driver.kicad_pcb, PAC5527Driver.kicad_sch]
2023-12-07 tracking footprints and 3D step
    [Infineon-STP_PG-TDSON-8-33-P-v01_00-EN.stp]
2023-12-07 relocated to align encoder with board geometric center
    [PAC5527Driver.kicad_pcb, PAC5527Driver.kicad_sch, User Library-QFN-16_3x3.STEP]
2023-12-08 MCU fanout, power stage roughed in, setup is now 6L
    [PAC5527Driver.kicad_pcb, PAC5527Driver.kicad_sch]
2023-12-09 output via stitching
    [PAC5527Driver.kicad_pcb, PAC5527Driver.kicad_sch]
2023-12-10 VCC / GND pours
    [PAC5527Driver.kicad_pcb]
2023-12-10 initial layout pass
    [PAC5527Driver.kicad_pcb, PAC5527Driver.kicad_sch]
2023-12-10 layout clean-up
    [PAC5527Driver.kicad_pcb]
2023-12-11 midplate mods
    [430450812.stp, 430450818.stp, BM04B-GHS-TBT_LF__SN__N_.step, EG1206.step, JS102011SAQN.step, Keystone_24929.STEP, POWER_BOARD.kicad_pcb, RP2040_CAN_FLASH.kicad_sch]
2023-12-11 initial DRC cleanup
    [PAC5527Driver.kicad_pcb]
2023-12-14 added PTH's for cap holders and shell
    [holeplacements.dxf, midplate.kicad_pcb, mounting_holes.kicad_sch]
2023-12-16 redone layout
    [PAC5527Driver.kicad_pcb, PAC5527Driver.kicad_sch]
2023-12-26 midplate changes, ready for order
    [Diffuser_-_Sketch_7_1.dxf, Diffuser_-_Sketch_8.dxf, POWER_BOARD.kicad_pcb, RP2040_CAN_FLASH.kicad_sch, Sample-BOM_JLCSMT.xlsx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]
2023-12-27 midplate updates
    [RA1H1C112R.stp, c-2-1445053-2-d-3d.stp, c-3-794636-6-l-3d.stp, faceplate.kicad_sch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]
2023-12-29 WIP Buck for Faceplate
    [25svpf100m.step, EEE-1CA471UP.stp, FacePlate.kicad_pcb, FacePlate.kicad_sch, can.kicad_sch, clf10040.step, radio.kicad_sch]
2023-12-29 midplate 5V buck converter
    [25svpf100m.step, D2PAK_LM2576_MODEL.STEP, EEE-1CA471UP.stp, POWER_BOARD.kicad_pcb, clf10040.step, faceplate.kicad_sch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]
2024-01-04 spaced out mounting points by 0.5mm
    [PAC5527Driver.kicad_pcb, PAC5527Driver.kicad_sch]
2024-01-05 initial layout
    [PAC5527Driver.kicad_pcb, PAC5527Driver.kicad_sch, PowerPAK SO-8 (S).step]
2024-01-06 layout complete
    [PAC5527Driver.kicad_pcb, PAC5527Driver.kicad_sch]
2024-01-06 GND stitch update
    [PAC5527Driver.kicad_pcb, PAC5527Driver.kicad_sch]
2024-01-07 fixed hole clearance issues
    [PAC5527Driver.kicad_pcb, PAC5527Driver.kicad_sch]
2024-01-08 midplate v1 ready for review
    [SMTSO2515CTJ.step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]
2024-01-12 swapped pins around for CAN
    [midplate.kicad_pcb, motor.kicad_sch]
2024-01-12 midplate update with different buck regulator pad size
    [midplate-B_Cu.gbl, midplate-B_Mask.gbs, midplate-B_Paste.gbp, midplate-B_Silkscreen.gbo, midplate-Edge_Cuts.gm1, midplate-F_Cu.gtl, midplate-F_Mask.gts, midplate-F_Paste.gtp]
2024-01-17 update to midplate and powerboard
    [16SVPF180M.STEP, 25SVPF56M.STEP, 25svpf100m.step, A29520SIZE20C6.STEP, A29520SIZE20E7.STEP, BM04B-GHS-TBT_LF__SN__N_.step, CDRH127-1.STEP, Flyback_HV.kicad_sch]
2024-01-21 update to midplate hole placements
    [Flyback_HV.kicad_sch, midplate.kicad_pcb]
2024-01-24 power board and midplate updates (mostly finalized)
    [CAP_MXC_30X40_RUB.step, Flyback_HV.kicad_sch, Midplate BOM Jan 15.xlsx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]
2024-01-25 discharge circuit changes
    [Flyback_HV.kicad_sch, Midplate BOM Jan 15.xlsx, POWER_BOARD_BOM_JAN22.xlsx, RP2040_CAN_FLASH.kicad_sch, power.kicad_sch]
2024-01-26 BOM clean-up
    [PAC5527Driver.kicad_pcb]
2024-01-27 finalize connections
    [FacePlate.kicad_pcb, FacePlate.kicad_sch, can.kicad_sch]
2024-01-27 Finalize faceplate
    [734120110.stp, ABM3-8.000MHZ-D2Y-T.step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]
2024-01-27 Fix stuff up
    [E28-2G4M27S.STEP, FacePlate.kicad_pcb]
2024-01-27 fix socket
    [FacePlate.kicad_sch]
2024-01-27 update radio model
    [FacePlate.kicad_pcb]
2024-01-27 chicker v1.0 ordered
    [Flyback_HV.kicad_sch, Midplate BOM Jan 15.xlsx, POWER_BOARD_BOM_BASIC_TESTBOARD.xlsx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]
2024-01-29 name change
    [25SVPF56M.STEP, 25svpf100m.step, 436500200.stp, 436500215.stp, 445-CRYTAL-SMD.STEP, A768EB566M1VLAE042.step, ASPI-0630LR-150M-T15--3DModel-STEP-400430.STEP, B3B-XH-A.STEP]
2024-01-30 faceplate modifications
    [FacePlate.kicad_pcb, Midplate BOM Jan 15.xlsx, POWER_BOARD_BOM_JAN22.xlsx]
2024-01-30 finalize with 0ohms
    [FacePlate.kicad_pcb, FacePlate.kicad_sch, can.kicad_sch, radio.kicad_sch]
2024-02-03 update to schematic but something on layout is broken
    [Flyback_HV.kicad_sch, Midplate BOM Jan 15.xlsx, POWER_BOARD_BOM_BASIC_TESTBOARD.xlsx, POWER_BOARD_BOM_JAN22.xlsx, RP2040_CAN_FLASH.kicad_sch, chicker.kicad_sch, power.kicad_sch, powerboard_cost.xlsx]
2024-02-05 faceplate updates
    [1.28 TFT GC9A01 Display.STEP, FacePlate.kicad_pcb, FacePlate.kicad_sch, FacePlate_Correct_Outline.dxf, ICM-20689.step, IMU.kicad_sch, POWER_BOARD_BOM_JAN22.xlsx, can.kicad_sch]
2024-02-05 faceplate schematic
    [FacePlate.kicad_pcb, IMU.kicad_sch]
2024-02-07 add faceplate slit for camera cable
    [FacePlate.kicad_pcb]
2024-02-07 midplate + chicker bom
    [POWER_BOARD_BOM_BASIC_TESTBOARD_JLC.xlsx, POWER_BOARD_BOM_JAN22.xlsx, midplate.kicad_pcb, mounting_holes.kicad_sch]
2024-02-07 faceplate radio fixes
    [FacePlate.kicad_pcb, radio.kicad_sch]
2024-02-08 midplate 4 layers, chicker shell off limit switch idea
    [Flyback_HV.kicad_sch, POWER_BOARD_BOM_JAN22.xlsx, RP2040_CAN_FLASH.kicad_sch, chicker.kicad_sch, midplate.kicad_pcb, motor.kicad_sch, power.kicad_sch]
2024-02-08 chicker discharge HV shell off fixed
    pull up to 3v3 and limit switch, input to RP2040, output to inverted discharge signal which discharges if it is set to 0
    [Flyback_HV.kicad_sch, RP2040_CAN_FLASH.kicad_sch, chicker.kicad_sch]
2024-02-11 chicker discharge circuit finalized
    [B2B-XH-A_LF__SN_.step, Flyback_HV.kicad_sch, POWER_BOARD_BOM_JAN22.xlsx, RP2040_CAN_FLASH.kicad_sch, chicker.kicad_sch]
2024-02-11 chicker v1.1 changes
    [Flyback_HV.kicad_sch, RP2040_CAN_FLASH.kicad_sch, power.kicad_sch]
2024-02-17 Final touches
    [FacePlate.kicad_pcb, FacePlate.kicad_sch, IMU.kicad_sch, can.kicad_sch, radio.kicad_sch]
2024-02-18 Ordered faceplate
    [FacePlate.kicad_pcb, FacePlate.kicad_sch, IMU.kicad_sch, can.kicad_sch, radio.kicad_sch]
2024-02-18 added a global library for symbols
    [RP2040_CAN_FLASH.kicad_sch, power.kicad_sch]
2024-02-19 update for v1.1
    [LM2598SX-12.stp, POWER_BOARD_BOM_JAN22.xlsx, RP2040_CAN_FLASH.kicad_sch, power.kicad_sch]
2024-02-19 added basic firmware in micropython
    [power.kicad_sch]
2024-02-20 adding checks for DONE, if charge cycle started / completed properly
2024-02-21 firmware mostly done for testing HV
    [Flyback_HV.kicad_sch]
2024-02-23 chicker firmware mostly good, ready to test
    [battery_offset.xlsx]
2024-02-23 added safe charge mode in code
2024-02-26 chicker updates
    [Flyback_HV.kicad_sch, HV-feedback.kicad_sch, POWER_BOARD_BOM_JAN22.xlsx, RP2040_CAN_FLASH.kicad_sch, SOD-923_0P6X0P85_ONS.step, chicker.kicad_sch]
2024-02-26 chicker v1.1 working
    [RP2040_CAN_FLASH.kicad_sch]
2024-02-27 chicker v1.1 updates
    nearly done, need to fix rules
    [Flyback_HV.kicad_sch, RP2040_CAN_FLASH.kicad_sch, chicker.kicad_sch, power.kicad_sch]
2024-02-28 v1.1 mostly done, need to add tooling holes
    [Flyback_HV.kicad_sch, RP2040_CAN_FLASH.kicad_sch, autodischarge.kicad_sch, chicker.kicad_sch, power.kicad_sch]
2024-02-28 chicker v1.1 done (TM)
    [power.kicad_sch]
2024-02-28 midplate thoughts
    [baseplate-conn.kicad_sch, midplate.kicad_pcb, midplate.kicad_sch, power-input.kicad_sch]
2024-03-01 feat: add midplate and shell mounting
    - Reduce PCB Diameter to 174mm
    - Add cutouts for shell mounting
    - Reduce cap holder screw holes from 6 to 4
    - Rotate power switch 30 deg towards edge
    - Add holes for midplate mounting
    [baseplate-conn.kicad_sch, faceplate.kicad_sch, midplate.kicad_pcb, mounting_holes.kicad_sch, power-input.kicad_sch, powerboard-conn.kicad_sch]
2024-03-05 changed spacing
    [midplate.kicad_pcb]
2024-03-11 update motor mount footprints
    [midplate.kicad_pcb]
2024-03-11 code is functionally ready to test
    after work tomorrow with an oscilloscope to figure out what is going on with the gate driver
    [RP2040_CAN_FLASH.kicad_sch, power.kicad_sch]
2024-03-11 midplate updating to global symbol library
    [baseplate-conn.kicad_sch, power-input.kicad_sch, powerboard-conn.kicad_sch]
2024-03-11 midplate updates
    - pretty close to order: need to verify if we can get 2oz outer copper
    [BM03B-GHS-TBT.STEP, baseplate-conn.kicad_sch, faceplate.kicad_sch, midplate.kicad_pcb, mounting_holes.kicad_sch, power-input.kicad_sch, powerboard-conn.kicad_sch]
2024-03-11 update step files
    [midplate.kicad_pcb]
2024-03-12 chicker + midplate changes
    -ready to order midplate
    [baseplate-conn.kicad_sch, midplate.kicad_pcb]
2024-03-12 midplate - with alt parts
    [Midplate BOM Jan 15.xlsx, midplate.kicad_pcb, power-input.kicad_sch, powerboard-conn.kicad_sch]
2024-03-12 wip baseplate
    [BasePlate.kicad_pcb, BasePlate.kicad_sch]
2024-03-13 firmware update
    - weird bug causing startup cycle to start without command, variable is 0 all the time as far as im aware
    [main.py]
2024-03-14 removed old midplate design for merge resolution
    [midplate.kicad_pcb, midplate.kicad_sch, midplate_MCU.kicad_sch, midplate_motordriver_conn.kicad_sch, midplate_power_monitor.kicad_sch, opizero2_interface.kicad_sch]
2024-03-14 mostly finished
    [BasePlate.kicad_pcb, BasePlate.kicad_sch]
2024-03-15 baseplate updates
    [BasePlate.kicad_pcb]
2024-03-15 wip baseplate mostly done
    [BasePlate.kicad_pcb]
2024-03-15 wip breakbeam voltage divider
    [BasePlate.kicad_pcb, BasePlate.kicad_sch]
2024-03-15 baseplate done
    [BasePlate.kicad_pcb]
2024-03-17 trying to change frequency of pulse counter
    sad times broke an IGBT and a flyback diode and maybe another IGBT
    cant charge with solenoid plugged in at the moment, i plugged it in and it kicked immediately and thats likely why it broke or somehow
    [main.py, pulses.py]
2024-03-21 firmware change
    - changed pulses to be running at a slower frequency (seems it is slightly inaccurate of creating the pulse)
    - added a check to not kick when charging (based on done signal), two gate driver chips were burned from a pulse train or even a single pulse, not sure, when charging from 0V
    [main.py, pulses.py]
2024-03-27 code modified but currently buggy
    - when vcc repowered board it starts charge cycle right away instead of waiting
    [MCP2515.py, battery.py, can_send.ino, main.py]
2024-03-31 chicker works! (slight bug in code, but works)
    - avoid kicking near when the next charge cycle starts (as it doesnt stop the pulse if a charge cycle starts after the pulse goes out). this will break the IGBT due to potential delays / and maybe current from charging idk
    [battery_offset.xlsx]
2024-03-31 modified code to not charge for 50ms when kick issued
    [chicker_pulse_2_velocity.xlsx]
2024-04-04 chicker modifications (mostly ready to order)
    [Flyback_HV.kicad_sch, HV-feedback.kicad_sch, POWER_BOARD_BOM_JAN22.xlsx, RP2040_CAN_FLASH.kicad_sch, SOT23-3.stp, autodischarge.kicad_sch, chicker.kicad_sch, power.kicad_sch]
2024-04-07 fixed most issues with JLC ordering
    [HV-feedback.kicad_sch, power.kicad_sch]
2024-04-10 Add edge cut suggestion for shell to User 8
    [midplate.kicad_pcb]
2025-01-17 modified transmitter circuit
    [RP2040_CAN_FLASH.kicad_sch]
2025-05-19 ESD+schematic fixes
    [CAN.kicad_sch, Flyback_HV.kicad_sch, HV-feedback.kicad_sch, RP2040.kicad_sch, RP2040_CA.kicad_sch, autodischarge.kicad_sch, chicker.kicad_sch, power.kicad_sch]
2025-05-26 chicker v1.1 basic parts
    [CAN.kicad_sch, Flyback_HV.kicad_sch, HV-feedback.kicad_sch, RP2040.kicad_sch, TS-1187A-B-A-B--3DModel-STEP-56544.STEP, W25Q128JVSIQ.STEP, power.kicad_sch]
2025-05-27 more parts
    [Flyback_HV.kicad_sch, RP2040.kicad_sch]
2025-05-28 changed more to basic
    [CAN.kicad_sch, Flyback_HV.kicad_sch, HV-feedback.kicad_sch, RP2040.kicad_sch, autodischarge.kicad_sch, power.kicad_sch]
2025-05-28 chicker v1.1 ordered!
    [CAN.kicad_sch, Flyback_HV.kicad_sch, HV-feedback.kicad_sch, RP2040.kicad_sch, power.kicad_sch]
2025-06-09 firmware + RCD snubber
    [Flyback_HV.kicad_sch, RP2040.kicad_sch]
2025-06-15 chicker firmware flash
    [battery_offset.xlsx, chicker_pulse_2_velocity.xlsx]
2025-07-12 changed transceiver for faceplate
    + removed caps on chicker can
    [FacePlate.kicad_sch, IMU.kicad_sch, can.kicad_sch, radio.kicad_sch]
2025-07-17 damping can bus code
    + changing charging to every 5s
    [CAN.kicad_sch]
2025-07-18 changes but not done
    i think it works but need to change some stuff so charging is not in simulation mode
2025-07-18 reverted to old code
    [flash.py, high_voltage.py, main.py]
2025-07-23 reverted to old code
    ACTUALLY OLD CODE (ROBOCUP)
    [main.py]
2025-07-23 idle to charge
    charge, to idle and back to charge WORKS! need to test kicking and possibly change reset logic for some reason it waits 2s before charging again???
    [main.py]
2025-07-24 chicker code does not work.
    [battery.py]
2025-07-24 Update main.py
    - idle mode: doesnt discharge (weird?)
    - damping mode: discharges after switching from a charge state (aka done state read as high but shouldnt do this theoretically)
    - charge mode: works I think?
    - autokick mode: works I think?
2025-07-24 trying 2 fix damp code
    [main.py]
2025-07-24 need to revert can led 4 bbeam
    [main.py]
2025-07-25 1kHz to 10kHz ideal for damping
    possibly wondering about discrepancy of not being able to damp at the same value maybe thats a timer thing or maybe its the array I used. possibly why were seeing kick speed variation. maybe need a new pulse function.
2025-08-04 chatgpt created this CAUTION
    - AKHIL - maybe you can integrate this version of the kick code and PWM better in my code instead of what is implemented currently for the KICK and DAMP functions?
    Henry
2025-12-31 pcb pin number change
    (from last summer)
    [RP2040.kicad_sch]
2025-12-31 reed switch code
    very bare bones reed switch code
2026-01-19 kicad rules
2026-01-19 Create README.MD
    Board Description + Images
2026-01-19 moving things around
    [25SVPF56M.STEP, 25svpf100m.step, 436500200.stp, 436500215.stp, 445-CRYTAL-SMD.STEP, A768EB566M1VLAE042.step, ASPI-0630LR-150M-T15--3DModel-STEP-400430.STEP, B2B-XH-A_LF__SN_.step]
2026-01-19 changing file locations
    [25SVPF56M.STEP, 25svpf100m.step, 436500200.stp, 436500215.stp, 445-CRYTAL-SMD.STEP, A768EB566M1VLAE042.step, ASPI-0630LR-150M-T15--3DModel-STEP-400430.STEP, B2B-XH-A_LF__SN_.step]
2026-02-10 fix text on schematic
    [Flyback_HV.kicad_sch, RP2040_CA.kicad_sch]
2026-02-12 global library.
    chicker done. next step is to merge all the rest into a global library
    [16SVPF180M.STEP, 25SVPF56M.STEP, 25svpf100m.step, 436500200.stp, 436500215.stp, 445-CRYTAL-SMD.STEP, A768EB566M1VLAE042.step, ASPI-0630LR-150M-T15--3DModel-STEP-400430.STEP]
2026-02-12 midplate stuff + modify chicker silkscreen files
    [16SVPF180M.STEP, 25svpf100m.step, 3549-2.STEP, 430450812.stp, 430450818.stp, 436500224.stp, A29520SIZE20C6.STEP, A29520SIZE20E7.STEP]
2026-02-12 some components files not working. checking a previous midplate branch
    [baseplate-conn.kicad_sch, faceplate.kicad_sch, midplate.kicad_pcb, midplate.kicad_sch, mounting_holes.kicad_sch, power-input.kicad_sch, powerboard-conn.kicad_sch]
2026-02-12 midplate libraries fixed
    [B4B-XH-A.STEP, SO-8-PowerPAD.stp, midplate.kicad_pcb]
2026-02-13 faceplate. broken.
    [1.28 TFT GC9A01 Display.STEP, 25svpf100m.step, 734120110.stp, ABM3-8.000MHZ-D2Y-T.step, E28-2G4M27S.STEP, EEE-1CA471UP.stp, FacePlate.kicad_pcb, FacePlate.kicad_sch]
2026-02-14 faceplate global files working
    [1.28 TFT GC9A01 Display.STEP, FacePlate.kicad_pcb, FacePlate.kicad_sch, IMU.kicad_sch, can.kicad_sch, radio.kicad_sch]
2026-02-14 added a title block
    [FacePlate.kicad_pcb, FacePlate.kicad_sch, IMU.kicad_sch, can.kicad_sch, radio.kicad_sch]
2026-02-23 siderakb mouse sensor PCB
    [pmw3360_pcb_ffc.kicad_pcb, pmw3360_pcb_ffc.kicad_sch, pmw3360_pcb_jst.kicad_pcb, pmw3360_pcb_jst.kicad_sch, pmw3360_pcb_pinheader.kicad_pcb, pmw3360_pcb_pinheader.kicad_sch]
2026-02-25 prod (gnd standoffs)
    [pmw3360_pcb_jst.kicad_pcb]
2026-02-25 gerbers for production
    [pmw3360_pcb_jst.kicad_pcb, pmw3360_pcb_jst.kicad_sch]
2026-02-26 mouse sensor bots libraries
    - footprints not done yet. shematics yes.
    [pmw3360_pcb_jst.kicad_pcb, pmw3360_pcb_jst.kicad_sch]
2026-02-26 3dmodels + footprints
    - one resistor unvalued + no footprint
    [C_0603_1608Metric.step, JST_GH_SM08B-GHS-TB_1x08-1MP_P1.25mm_Horizontal.step, R_0603_1608Metric.step, pmw3360_pcb_jst.kicad_pcb, pmw3360_pcb_jst.kicad_sch]
2026-02-27 libraries and stuff
    [Flyback_HV.kicad_sch, PMW3360 v12.step, pmw3360_pcb_jst.kicad_pcb, pmw3360_pcb_jst.kicad_sch]
2026-02-27 mouse_sensorV1 prod done
    [BM08B-GHS-TBT_LF__SN__N_.step, pmw3360_pcb_jst.kicad_pcb, pmw3360_pcb_jst.kicad_sch]
2026-02-28 production files - working
    - modified board slightly, added 3d models, added part numbers for JLC
    [pmw3360_pcb_jst.kicad_pcb, pmw3360_pcb_jst.kicad_sch]
2026-03-02 firmware update
    - blocking allocation by claude. 100Hz and 1kHz works, but 5kHz and above have too much memory allocation. will fix this eventually, but you can test with 1kHz.
    [main.py, pulses.py]
2026-03-05 skid board schematic, need to check then do pcb
    [SkidPlate.kicad_pcb, SkidPlate.kicad_sch]
2026-03-08 update skidplate schematic with new imu
    [SkidPlate.kicad_sch]
2026-03-15 updated skidplate schematic, need to add usb pd
    [SkidPlate.kicad_pcb, SkidPlate.kicad_sch]
2026-03-15 damping on hw pwm
2026-03-25 midplate pass through
    ethernet pass through
    [baseplate-conn.kicad_sch, faceplate.kicad_sch, midplate.kicad_pcb, midplate.kicad_sch, mounting_holes.kicad_sch, power-input.kicad_sch, powerboard-conn.kicad_sch, skidplate.kicad_sch]
2026-03-25 white led fix
2026-04-23 add usb pd and imu to midplate
    [imu.kicad_sch, midplate.kicad_sch, usb_pd.kicad_sch]
2026-04-26 wip faceplate 2.0 schematic
    [FacePlate.kicad_pcb, FacePlate.kicad_sch, IMU.kicad_sch, PAC5527Driver.kicad_sch, ball_detectors.kicad_sch, can.kicad_sch, pmw3360_pcb_jst.kicad_sch, radio.kicad_sch]
2026-04-26 wip some more
    [FacePlate.kicad_pcb, FacePlate.kicad_sch]
2026-04-26 fix models
    [FacePlate.kicad_pcb, FacePlate.kicad_sch, JST_GH_BM04B-GHS-TBT_1x04-1MP_P1.25mm_Vertical.step, JST_SH_BM04B-SRSS-TB_1x04-1MP_P1.00mm_Vertical.step, can.kicad_sch, pmw3360_pcb_jst.kicad_pcb]
2026-04-28 add adafruit connector
    [faceplate.kicad_sch, usb_pd.kicad_sch]
2026-05-09 revert old faceplate PCB
    [FacePlate.kicad_pcb]
2026-05-09 old-annotated schematic
    [FacePlate.kicad_sch, can.kicad_sch]
2026-05-09 pcb updates
    [FacePlate.kicad_pcb, FacePlate.kicad_sch, can.kicad_sch]
2026-05-10 DRC Pass
    [FacePlate.kicad_pcb, FacePlate.kicad_sch, can.kicad_sch, display.kicad_sch]
2026-05-10 moved 2 pin connector
    [FacePlate.kicad_pcb]
2026-05-10 file outputs
    [FACEPLATE_V2_bom.csv, FACEPLATE_V2_designators.csv, FACEPLATE_V2_positions.csv, MOUSE_SENSORV1_bom.csv, MOUSE_SENSORV1_designators.csv, MOUSE_SENSORV1_positions.csv]
2026-05-11 midplate additions WIP
    [CAN.kicad_sch, FacePlate.kicad_pcb, FacePlate.kicad_sch, Flyback_HV.kicad_sch, HV-feedback.kicad_sch, Midplate BOM Jan 15.xlsx, RP2040.kicad_sch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]
2026-05-16 skidplate, then realized its pointless
    [BasePlate.kicad_pcb, BasePlate.kicad_sch, MCU.kicad_sch, SkidPlate.kicad_pcb, imu.kicad_sch, midplate.kicad_pcb]
2026-05-17 skidplate done
    [SkidPlate.kicad_pcb, SkidPlate.kicad_sch]
2026-05-18 skidplate and midplate
    [SkidPlate.kicad_pcb, faceplate.kicad_sch, midplate.kicad_pcb, midplate.kicad_sch, power-input.kicad_sch]
2026-05-20 silk update
    [FACEPLATE_V2_designators.csv, FacePlate.kicad_pcb]
2026-05-20 production + fixing libraries
    [FACEPLATE_V2_bom.csv, FACEPLATE_V2_designators.csv, FACEPLATE_V2_positions.csv, FacePlate.kicad_pcb, FacePlate.kicad_sch, can.kicad_sch, display.kicad_sch]
2026-05-25 file organization
    [FacePlate_Correct_Outline.dxf, ball_detectors.kicad_sch]
2026-05-26 Update README.md
    IMU add
2026-05-27 update PCB
    [FacePlate.kicad_pcb]
2026-05-27 baseplate v1.1
    [.step, BasePlate.kicad_pcb, BasePlate.kicad_sch]
2026-05-28 fix paths
    [BasePlate.kicad_pcb]
2026-05-28 baseplate zeroH standoffs
    [.step, BasePlate.kicad_pcb, BasePlate.kicad_sch]
2026-05-28 production files
    [BASEPLATE_V1.1_bom.csv, BASEPLATE_V1.1_designators.csv, BASEPLATE_V1.1_positions.csv]
2026-05-28 zero height change to top.
    [BasePlate.kicad_pcb]
2026-05-28 production files other side
    [BASEPLATE_V1.1_positions.csv]
2026-05-29 baseplate threaded insert change
    [BasePlate.kicad_pcb, BasePlate.kicad_sch]
2026-05-29 fix the threaded insert
    [BASEPLATE_V1.1_bom.csv, BasePlate.kicad_pcb, BasePlate.kicad_sch]
2026-05-30 directory fixing
    [.step, BASEPLATE_V1.1_bom.csv, BASEPLATE_V1.1_designators.csv, BASEPLATE_V1.1_positions.csv, BasePlate.kicad_pcb, BasePlate.kicad_sch]
2026-06-01 netclass colours
    [FacePlate.kicad_sch]
2026-06-10 pcb colour
    [FacePlate.kicad_pcb]
2026-06-10 solenoid active damping
2026-06-29 robocup: push up fixes
    [main.py]
2026-07-02 fix for bug #1: should fix discharge bug
    not tested yet
    [main.py]
2026-07-02 reverted to my damping state tracking + duty boost
    [main.py]
2026-07-02 hard = true IRQ implementation using PWM
2026-07-03 remove startup_chg pass line in charge code, remove pulse code
2026-07-03 fixing damping with new plunger
    [main.py]
2026-07-03 simulation / charge ok stuff
2026-07-03 abort charge cycle code for kick/damp
2026-07-03 fix need to charge after damp then kick from request.
    [main.py]
2026-10-24 Apply uncommitted RoboCup-branch main.py edits from stash (startup_cmhg typo fix, chg_stop cleanup)
    These were Henry's working-tree changes on robocup2026damping_henry, stashed by
    GitHub Desktop on 2026-10-24 when switching branches. The stash itself is kept.
2026-10-24 updated code based on flowcharts/state machines.
    claude implemented 87 test cases in a simulator environment to test out the code before putting it live to a robot. I plan on adding a real sensors evaluation environment with a board over usb to test out everything a board is functioning.
2026-10-25 Chicker firmware v2: rebuild from Henry's reviewed state machine charts
    The charge and mode control state machines are rewritten from Henry's updated
    charts, following the element-by-element reviews in Chicker/firmware/docs/.
    Each chart arrow is one table row, states use the chart names, and comments
    point back to the review elements.
    - Board files moved up to Chicker/firmware/ (no more chicker/ package);
    everything not on the board stays in subfolders.
    - Charge machine: DONE rising-edge latch, 500 ms spacing between cycles,
    4500 ms check, 5 s top-off, Inhibited (stop + dump) and Not Charging
    (stop, keep charge), overvoltage at 220 V (3 readings), Disabled one-way.
    - Mode machine: Wai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
2026-10-26 Chicker firmware v2: 2 s arm timeout, AUTOKICK renew, docs and test logs
    - Arm timeout put back (Henry): an AUTOKICK with no ball expires after 2 s,
    as at RoboCup (mode element 21); not during a damp (element 22, rejected).
    - AUTOKICK renew (Henry's updated chart, element 23): AUTOKICK while a kick
    is armed restarts the 2 s timer and takes the new PW, without de-arming
    or touching charging. Code state ArmKick renamed WaitForKick.
    - Message handling (element 7) rewritten to match: the de-arm is part of
    each Command Received branch, so the two renews can skip it.
    - Locked stops everything on the kicker side (Henry's chart updated).
    - Docs: CHANGES-v2 and REVIEW-PLAN updated (restored "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
2026-10-26 Chicker firmware v2: next-steps plan for testing on the real board
    docs/NEXT-STEPS-2026-10-26.md plans the next sessions (after Henry's 4 Nov
    midterm): Suite 1 on the board over USB only, run from the PC with mpremote
    (backup, identity, MicroPython compatibility, self-tests, real loop timing,
    the state machines on the chip with scripted inputs and with a small fake
    plant answering CHARGE with DONE / HV, safety paths); Suite 2 with the
    battery, run by Henry stage by stage once the bench charge ceiling /
    safe_chg decision is made. Also lists the decisions waiting and the team
    items. Linked from REVIEW-PLAN.md and the README.
