sfunderbots/Electrical/(notices)

Notices in the files:
thebots_libraries/3dmodels/R_0603_1608Metric.step:
Copyright (C) 2018, kicad StepUp
This work is licensed under the [Creative Commons CC-BY-SA 4.0 License](https://creativecommons.org/licenses/by-sa/4.0/legalcode),
with the following exception:
To the extent that the creation of electronic designs that use 'Licensed Material' can be considered to be 'Adapted Material',
You are free to use the library data in your own projects without the obligation to share your project files under this or any other license agreement.
thebots_libraries/3dmodels/C_0603_1608Metric.step:
Copyright (C) 2017, kicad StepUp
thebots_libraries/3dmodels/JST_GH_SM08B-GHS-TB_1x08-1MP_P1.25mm_Horizontal.step:
Copyright (C) 2018, Frank Severinsen
thebots_libraries/3dmodels/JST_SH_BM04B-SRSS-TB_1x04-1MP_P1.00mm_Vertical.step:
Copyright (C) 2025, KiCAD
This work is licensed under the
[Creative Commons CC-BY-SA 4.0 License](https://creativecommons.org/licenses/by-sa/4.0/legalcode),
project files under this or any other license agreement. However, if you wish to distribute
thebots_libraries/3dmodels/PTS647SM50SMTR2LFS.stp:
author */ ('License CC BY-ND 4.0'),
pmw3360-pcb-main/pmw3360_pcb_ffc/pmw3360_pcb_ffc.kicad_pcb:
Open Source Hardware, CERN-OHL-P v2
